ThoMint/vdatp/board/assembly/bot_picture.jpg

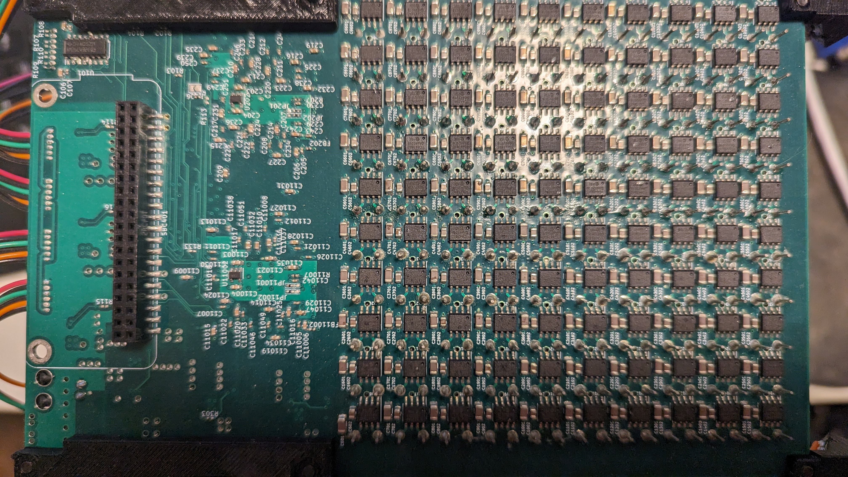
board/assembly/bot_picture.jpg
