ThoMint/vdatp/board/assembly/top_picture.jpg

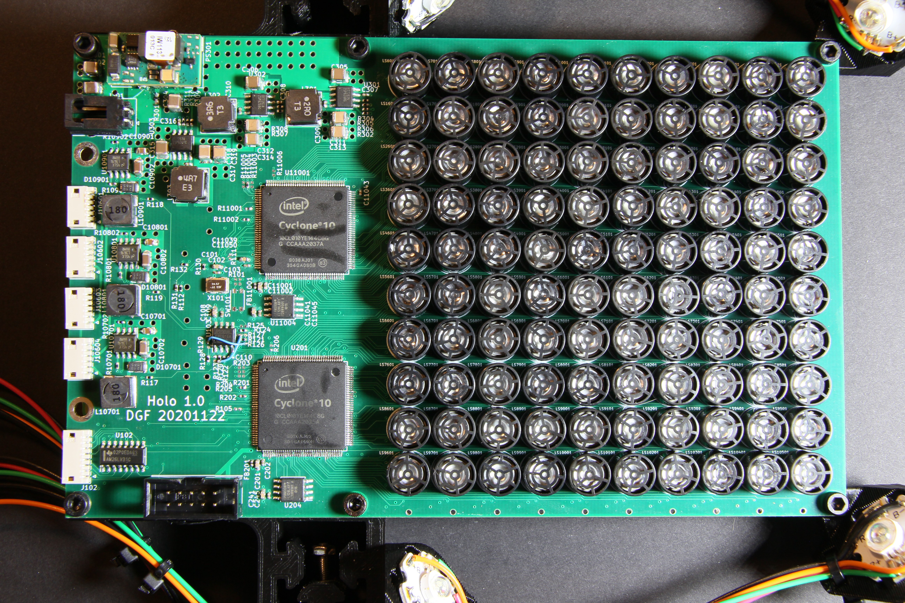
board/assembly/top_picture.jpg
