ThoMint/vdatp/board/vdatp_bom_MTE.xlsx

 |  |  |  | per PCB | Gesamtbestellmenge | Hersteller | Teilenummer | Link | Preis | Preis für 2 Stk | Info
> C101, C104, C106, C201, C203, C204, C206, C209, C210, C213-C216, C219, C220, C223, C224, C227, C228, C231, C232, C235, C236, C239-C241, C247, C11001, C11003, C11004, C11006, C11009, C11010, C11013-C11016, C11019, C11020, C11023, C11024, C11027, C11028, C11031, C11032, C11035, C11036, C11039-C11041, C11047 | 4.7uF | Capacitor_SMD:C_0603_1608Metric |  | 51 | 102 | Samsung | CL10A475KP8NNNC | MTE-ID 5653, Stock 3215 | 0 | 0 | 6.3V type
> C102, C103, C105, C107, C202, C205, C207, C208, C211, C212, C217, C218, C221, C222, C225, C226, C229, C230, C233, C234, C237, C238, C242-C246, C248-C251, C307-C310, C316, C317, C11002, C11005, C11007, C11008, C11011, C11012, C11017, C11018, C11021, C11022, C11025, C11026, C11029, C11030, C11033, C11034, C11037, C11038, C11042-C11046, C11048-C11051 | 0.1uF | Capacitor_SMD:C_0402_1005Metric |  | 64 | 128 |  |  | MTE-ID 6867, Stock 3711 | 0 | 0 | 50V type
> C301, C302 | 10uF,50V | Resistor_SMD:R_1210_3225Metric |  | 2 | 4 |  |  | MTE-ID 6670, Stock 100 | 0 | 0
> C304-C306, C315 | 22uF,35V | Capacitor_SMD:C_1210_3225Metric |  | 10 | 20 |  |  | MTE-ID 5803, Stock 34 | 0 | 0 | downrated to 25V
> C311-C314, C318, C319 | 22uF | Capacitor_SMD:C_1210_3225Metric |  | 6 | 12 |  |  | MTE-ID 2613, Stock 315 | 0 | 0 | downrated to 6V
> C601, C701, C801, C901, C1001, C1101, C1201, C1301, C1401, C1501, C1601, C1701, C1801, C1901, C2001, C2101, C2201, C2301, C2401, C2501, C2601, C2701, C2801, C2901, C3001, C3101, C3201, C3301, C3401, C3501, C3601, C3701, C3801, C3901, C4001, C4101, C4201, C4301, C4401, C4501, C4601, C4701, C4801, C4901, C5001, C5101, C5201, C5301, C5401, C5501, C5601, C5701, C5801, C5901, C6001, C6101, C6201, C6301, C6401, C6501, C6601, C6701, C6801, C6901, C7001, C7101, C7201, C7301, C7401, C7501, C7601, C7701, C7801, C7901, C8001, C8101, C8201, C8301, C8401, C8501, C8601, C8701, C8801, C8901, C9001, C9101, C9201, C9301, C9401, C9501, C9601, C9701, C9801, C9901, C10001, C10101, C10201, C10301, C10401, C10501, C10702, C10802, C10902 | 4.7uF, 35V | Capacitor_SMD:C_1206_3216Metric | 1276-2880-2-ND | 103 | 206 | Samsung Electro Mechanics | CL31A475KAHNNNE | https://www.digikey.at/product-detail/de/samsung-electro-mechanics/CL31A475KAHNNNE/1276-2880-1-ND/3890966 | 0.079 | 16.274 | downrated to 25V
> C602, C702, C802, C902, C1002, C1102, C1202, C1302, C1402, C1502, C1602, C1702, C1802, C1902, C2002, C2102, C2202, C2302, C2402, C2502, C2602, C2702, C2802, C2902, C3002, C3102, C3202, C3302, C3402, C3502, C3602, C3702, C3802, C3902, C4002, C4102, C4202, C4302, C4402, C4502, C4602, C4702, C4802, C4902, C5002, C5102, C5202, C5302, C5402, C5502, C5602, C5702, C5802, C5902, C6002, C6102, C6202, C6302, C6402, C6502, C6602, C6702, C6802, C6902, C7002, C7102, C7202, C7302, C7402, C7502, C7602, C7702, C7802, C7902, C8002, C8102, C8202, C8302, C8402, C8502, C8602, C8702, C8802, C8902, C9002, C9102, C9202, C9302, C9402, C9502, C9602, C9702, C9802, C9902, C10002, C10102, C10202, C10302, C10402, C10502 | 0.1uF, 35V | Capacitor_SMD:C_0805_2012Metric |  | 100 | 200 |  |  | MTE-ID 1118, Stock 1273 | 0 | 0
> C10701, C10801, C10901 | 1uF, 16V | Capacitor_SMD:C_0805_2012Metric |  | 3 | 6 |  |  | MTE-ID 2896, Stock 1000 | 0 | 0
> D10701, D10801, D10901 | 2A, 100V | holo:DO-220A | SS2PH10-M3/84AGICT-ND | 3 | 6 | Vishay | SS2PH10-M3/84A | https://at.farnell.com/vishay/ss2ph10-m3-84a/gleichr-diode-schottky-2a-100v/dp/1812489 | 0.24 | 1.44
> FB201, FB202, FB11001, FB11002 | 300R | Resistor_SMD:R_0402_1005Metric | 535-12548-1-ND | 4 | 8 | Abracon | ACML-0402HC-301-T | https://www.digikey.at/products/de?keywords=535-12548-1-ND | 0.054 | 0.432
J101 | JTAG | Connector_PinHeader_2.54mm:PinHeader_2x05_P2.54mm_Vertical_Shrouded | 732-2094-ND | 1 | 2 | Würth | 61201021621 | https://www.digikey.at/products/de?keywords=732-2094-ND | 0.38 | 0.76
J102 | Comms | Connector_Hirose:Hirose_DF13-08P-1.25DS_1x08_P1.25mm_Horizontal | H2205-ND | 1 | 2 | Hirose | DF13-8P-1.25DS(20) | https://www.digikey.at/products/de?keywords=H2205-ND | 0.68 | 1.36 | kann das sein, dass das einfach JST sind?
J301 | Power | Connector_Molex:Molex_70555_RA_1x02_P2.54 | WM14786 | 1 | 2 | Molex | 705550071 | https://www.digikey.at/products/de?keywords=WM14786 | 0.89 | 1.78
> J10601-J10604 | Screw_Terminal_01x06 | Connector_Hirose:Hirose_DF13-06P-1.25DS_1x06_P1.25mm_Horizontal | H2203-ND | 4 | 8 | Hirose | DF13-6P-1.25DS(20) | https://www.digikey.at/product-detail/de/hirose-electric-co-ltd/DF13-6P-1-25DS-20/H2203-ND/241776 | 0.542 | 4.336
L301 | 2.0uH | holo:NR8040 | 587-1997-1-ND | 1 | 2 | Tayo Yuden | NRS8040T2R0NJGJ | https://www.digikey.at/product-detail/de/NRS8040T2R0NJGJ/587-2976-1-ND/2666081 | 0.38 | 0.76 | Alternativtyp
L302 | 3.6uH | holo:NR8040 | 587-1998-1-ND | 1 | 2 | Tayo Yuden | NR8040T3R6N | https://www.digikey.at/products/de?keywords=587-1998-1-ND | 0.46 | 0.92
L303 | 4.7uH | holo:NR8040 | 587-1999-1-ND | 1 | 2 | Tayo Yuden | NR8040T4R7N | https://www.digikey.at/products/de?keywords=587-1999-1-ND | 0.46 | 0.92
> L10701, L10801 | 11.5uH | holo:SRR6038 | SRR6038-120YCT-ND | 2 | 4 | Bourns | SRR6038-120Y | https://www.digikey.at/products/de?keywords=SRR6038-120YCT-ND | 0.72 | 2.88
L10901 | 18uH | holo:SRR6038 | SRR6038-180YCT-ND | 1 | 2 | Bourns | SRR6038-180Y | https://www.digikey.at/products/de?keywords=SRR6038-180YCT-ND | 0.72 | 1.44
~~> LS601, LS701, LS801, LS901, LS1001, LS1101, LS1201, LS1301, LS1401, LS1501, LS1601, LS1701, LS1801, LS1901, LS2001, LS2101, LS2201, LS2301, LS2401, LS2501, LS2601, LS2701, LS2801, LS2901, LS3001, LS3101, LS3201, LS3301, LS3401, LS3501, LS3601, LS3701, LS3801, LS3901, LS4001, LS4101, LS4201, LS4301, LS4401, LS4501, LS4601, LS4701, LS4801, LS4901, LS5001, LS5101, LS5201, LS5301, LS5401, LS5501, LS5601, LS5701, LS5801, LS5901, LS6001, LS6101, LS6201, LS6301, LS6401, LS6501, LS6601, LS6701, LS6801, LS6901, LS7001, LS7101, LS7201, LS7301, LS7401, LS7501, LS7601, LS7701, LS7801, LS7901, LS8001, LS8101, LS8201, LS8301, LS8401, LS8501, LS8601, LS8701, LS8801, LS8901, LS9001, LS9101, LS9201, LS9301, LS9401, LS9501, LS9601, LS9701, LS9801, LS9901, LS10001, LS10101, LS10201, LS10301, LS10401, LS10501~~ | ~~Speaker_Ultrasound~~ | ~~holo:MSO-P1040H07T~~ |  | ~~100~~ | ~~200~~ | ~~Manorshi~~ | ~~MSO-P1040H07T~~ |  | ~~0.57~~ | ~~114~~ | ~~!!!ALIBABA 286 USD = 236€ for 410pcs!!!~~
PS301 | OKI-T36W-W40 | holo:OKI-T-36W-W40 | 811-3132-1-ND | 1 | 2 | Murata | OKI-T/36W-W40P-C | https://www.digikey.at/products/de?keywords=811-3132-1-ND | 9.1 | 18.2
R101 | 330R | Resistor_SMD:R_0402_1005Metric | 541-3996-1-ND | 1 | 2 |  |  | MTE-Sample Resistors ELAB |  | 0
R103 | 1.0K | Resistor_SMD:R_0402_1005Metric | A127319CT-ND | 1 | 2 |  |  | MTE-Sample Resistors ELAB |  | 0
> R102, R104, R201-R207, R11001-R11007 | 10K | Resistor_SMD:R_0402_1005Metric | RMCF0402JT10K0CT | 16 | 32 |  |  | MTE-Sample Resistors ELAB |  | 0
R105 | 0R | Resistor_SMD:R_0402_1005Metric | ~ | 1 | 2 |  |  | MTE-Sample Resistors ELAB |  | 0
R106 | 0R | Jumper:SolderJumper-2_P1.3mm_Open_TrianglePad1.0x1.5mm | ~ | 1 | 2 |  |  | MTE-Sample Resistors ELAB |  | 0
> R107-R110 | 100R | Resistor_SMD:R_0402_1005Metric | A127223CT-ND | 4 | 8 |  |  | MTE-Sample Resistors ELAB |  | 0
> R208, R11008 | 24R9 | Resistor_SMD:R_0402_1005Metric | 2037-PFR05S-24R9-FNHCT-ND | 2 | 4 | Delta | PFR05S-24R9-FNH | https://www.digikey.at/products/de?keywords=2037-PFR05S-24R9-FNHCT-ND | 0.09 | 0.36
R301 | 52R21 | Resistor_SMD:R_0603_1608Metric | RMCF0603FT26R1CT-ND | 1 | 2 | Stackpole | RMCF0603FT26R1 | https://www.digikey.at/products/de?keywords=RMCF0603FT26R1CT-ND | 0.09 | 0.18
> R302, R303, R309 | 100K | Resistor_SMD:R_0402_1005Metric | RMCS0402JT100KCT-ND | 3 | 6 |  |  | MTE-Sample Resistors ELAB |  | 0
R304 | 47K | Resistor_SMD:R_0402_1005Metric | 541-3966-1-ND | 1 | 2 |  |  | MTE-Sample Resistors ELAB |  | 0
R305 | 5.0K | Resistor_SMD:R_0402_1005Metric | 541-3972-1-ND | 1 | 2 | Vishay | CRCW04024K99FKEDC | https://www.digikey.at/products/de?keywords=541-3972-1-ND | 0.09 | 0.18
R306 | 10.31K | Resistor_SMD:R_0402_1005Metric | RR12P10.2KDCT-ND | 1 | 2 | Susumu | RR1220P-1022-D-M | https://www.digikey.at/products/de?keywords=RR12P10.2KDCT-ND | 0.09 | 0.18
> R307, R310 | 75K | Resistor_SMD:R_0402_1005Metric | 541-5078-1-ND | 2 | 4 |  |  | MTE-Sample Resistors ELAB |  | 0
R308 | 27.6K | Resistor_SMD:R_0402_1005Metric | CR0402-FX-27R4GLFCT-ND | 1 | 2 | Bourns | CR0402-FX-27R4GLF | https://www.digikey.at/products/de?keywords=CR0402-FX-27R4GLFCT-ND | 0.09 | 0.18
R311 | 14.46K | Resistor_SMD:R_0402_1005Metric | YAG2983CT-ND | 1 | 2 | Yageo | RC0402FR-0714K3L | https://www.digikey.at/products/de?keywords=YAG2983CT-ND | 0.09 | 0.18
> R10701, R10801, R10901 | 40K | Resistor_SMD:R_0402_1005Metric | CR0402-FX-4022GLFCT-ND | 3 | 6 | Bourns | CR0402-FX-4022GLF | https://www.digikey.at/products/de?keywords=CR0402-FX-4022GLFCT-ND | 0.09 | 0.54
> R10702, R10802, R10902 | 8.9K | Resistor_SMD:R_0402_1005Metric | RMCF0402FT8K87CT-ND | 3 | 6 | Stackpole | RMCF0402FT8K87 | https://www.digikey.at/products/de?keywords=RMCF0402FT8K87CT-ND | 0.09 | 0.54
SBC401 | Raspberry_Pi_2_3 | Module:Raspberry_Pi_Zero_Socketed_THT_MountingHoles_SMT |  | 0 | 0 |  | RASP PI ZERO W | https://www.reichelt.at/at/de/raspberry-pi-zero-w-v-1-1-1-ghz-512-mb-ram-wlan-bt-rasp-pi-zero-w-p256438.html | 19.77 | 0
SW101 | SW_Push | Button_Switch_SMD:SW_SPST_KMR2 | CKN10246CT-ND | 0 | 0 |  |  |  |  | 0
U101 | AM26LV32CDR | Package_SO:SOIC-16_3.9x9.9mm_P1.27mm | 296-6794-1-ND | 1 | 2 | TI | AM26LV32CDR | https://www.digikey.at/products/de?keywords=296-6794-1-ND | 0.8 | 1.6
U102 | AM26LV31 | Package_SO:SOIC-16_3.9x9.9mm_P1.27mm | 296-25912-1-ND | 1 | 2 | TI | AM26LV31CDR | https://www.digikey.at/products/de?keywords=296-25912-1-ND | 0.87 | 1.74
> U201, U11001 | 10CL010YE144C8G | Package_QFP:EQFP-144-1EP_20x20mm_P0.5mm_EP6.7x6.7mm | 544-3578-ND | 2 | 4 | Intel / Altera | 10CL010YE144C8G | https://www.digikey.at/products/de?keywords=10CL010YE144C8G | 8.08 | 32.32 | alternate: 10CL010YE144I7G, ggf arrow samples?
> U202, U11002 | MIC5504-2.5YM5 | Package_TO_SOT_SMD:SOT-23-5 | 576-4880-1-ND | 2 | 4 | Microchip | MIC5504-2.5YM5-TR | https://www.digikey.at/products/de?keywords=576-4880-1-ND | 0.11 | 0.44
> U203, U11003 | EPCQ16A | Package_SO:SOIC-8_3.9x4.9mm_P1.27mm | 544-3440-ND | 2 | 4 | Intel | EPCQ16ASI8N | https://www.digikey.at/products/de?keywords=EPCQ16ASI8N | 5.79 | 23.16
> U204, U11004 | S25FL128L | Package_SO:SOIC-8_5.275x5.275mm_P1.27mm | 428-4642-1-ND | 2 | 4 | Cypress | S25FL128LAGMFI013 | https://www.digikey.at/products/de?keywords=428-4642-1-ND | 2.56 | 10.24 | MTE-ID 010700 - stock 3
> U301-U303 | RT7263A | holo:SOP-EP-8_3.9x4.9mm_P1.27mm | 1028-1217-1-ND | 3 | 6 | Richtek | RT7263AZSP | https://www.digikey.at/products/de?keywords=1028-1217-1-ND | 0.73 | 4.38
> U601, U701, U801, U901, U1001, U1101, U1201, U1301, U1401, U1501, U1601, U1701, U1801, U1901, U2001, U2101, U2201, U2301, U2401, U2501, U2601, U2701, U2801, U2901, U3001, U3101, U3201, U3301, U3401, U3501, U3601, U3701, U3801, U3901, U4001, U4101, U4201, U4301, U4401, U4501, U4601, U4701, U4801, U4901, U5001, U5101, U5201, U5301, U5401, U5501, U5601, U5701, U5801, U5901, U6001, U6101, U6201, U6301, U6401, U6501, U6601, U6701, U6801, U6901, U7001, U7101, U7201, U7301, U7401, U7501, U7601, U7701, U7801, U7901, U8001, U8101, U8201, U8301, U8401, U8501, U8601, U8701, U8801, U8901, U9001, U9101, U9201, U9301, U9401, U9501, U9601, U9701, U9801, U9901, U10001, U10101, U10201, U10301, U10401, U10501 | TC4428A | Package_SO:SO-8_3.9x4.9mm_P1.27mm | TC4428ACOA-ND | 100 | 200 | Microchip | TC4428ACOA | https://www.digikey.at/product-detail/de/microchip-technology/TC4428ACOA/TC4428ACOA-ND/442842 | 0.74 | 148 | alternate: TC4428AVOA, TC4428AEOA - ALIEXPRESS?
> U10701, U10801, U10901 | LM3414 | Package_SO:SOIC-8-1EP_3.9x4.9mm_P1.27mm_EP2.35x2.35mm | LM3414HVMRX/NOPBCT-ND | 3 | 6 | TI | LM3414HVMRX/NOPB | https://www.digikey.at/products/de?keywords=LM3414HVMRX%2FNOPBCT-ND | 1.76 | 10.56
X101 | ASE-24.576MHz | holo:ASFL1 | ASFL1-24.576MHZ-L-T | 1 | 2 | Abracon | ASFL1-24.576MHZ-L-T | https://www.mouser.at/ProductDetail/ABRACON/ASFL1-24576MHZ-L-T | 1.08 | 2.16
 |  |  |  |  |  |  |  |  |  | 0
Extras für 2 vollständige Geräte (4 PCBs) |  |  |  |  |  |  |  |  |  | 0
 |  | WM2900-ND (power cable housing 2 pos) |  | 4 | 8 | Molex | 50579402 | https://www.digikey.at/product-detail/de/molex/0050579402/WM2900-ND/115029 | 0.29 | 2.32
 |  | WM15222-ND (precrimped power cable female to female 300mm) |  | 4 | 8 | Molex | 797580011 | https://www.digikey.de/product-detail/de/molex/0797580011/WM15222-ND/6187843 | 0.66 | 5.28
 |  | ~~WM2510-ND ~~ |  | ~~0~~ | ~~0~~ | ~~Molex~~ | ~~16020102~~ | ~~https://www.digikey.at/product-detail/de/molex/0016020102/WM2510-ND/115053~~ | 0.14 | 0
 |  | Styrofoam balls |  |  | 1 |  |  | https://www.aliexpress.com/item/33055543688.html?spm=a2g0s.9042311.0.0.14e44c4dgOtgtt | 1.6 | 1.6
 |  | LED Star 10 pcs |  |  | 1 |  | 6-pin with 20mm PCB | https://de.aliexpress.com/item/32823538158.html?spm=a2g0s.9042311.0.0.14e44c4dgOtgtt | 3.93 | 3.93
 |  | DF13 precrimped cables 300mm 10 pcs |  | 4 | 8 | Hirose | H4BBT-10112-B8 | https://www.digikey.at/product-detail/de/hirose-electric-co-ltd/H4BBT-10112-B8/H4BBT-10112-B8-ND/425398 | 0.52 | 4.16
 |  | DF13-8S-1.25C (comms cable housing) |  | 1 | 2 | Hirose | DF13-8S-1.25C | https://www.digikey.at/product-detail/de/hirose-electric-co-ltd/DF13-8S-1-25C/H2185-ND/241755 | 0.23 | 0.46
 |  | DF13-6S-1.25C (LED cable housing) |  | 4 | 4 | Hirose | DF13-6S-1.25C | https://www.digikey.at/products/de?keywords=DF13-6S-1.25C | 0.16 | 0.64
 |  |  |  |  |  |  |  |  |  | 0
 |  |  |  |  |  |  |  |  |  | 0
 |  |  |  |  |  |  |  |  | Total für 2 Stk | 420.832
