ThoMint/vdatp/board/floater-Edge_Cuts_clean.dxf

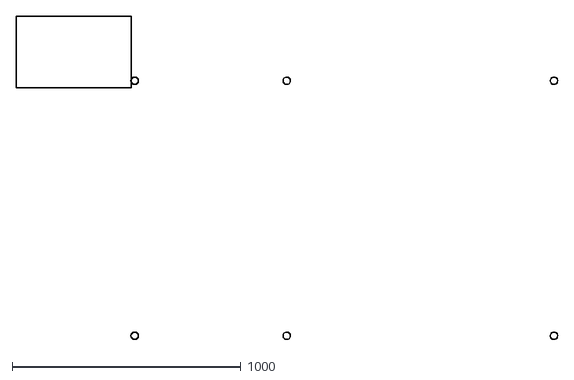
[picture p9: CAD file, 2023-10-27]
board/floater-Edge_Cuts_clean.dxf
2364.8 x 1413.5
