ThoMint/vdatp/board/floater-Edge_Cuts.dxf

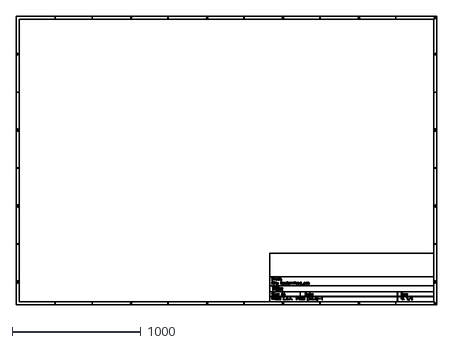
[picture p10: CAD file, 2023-10-27]
board/floater-Edge_Cuts.dxf
3273.3 x 2245.3
