ThoMint/vdatp/board/assembly/bot_fab_assembly.pdf

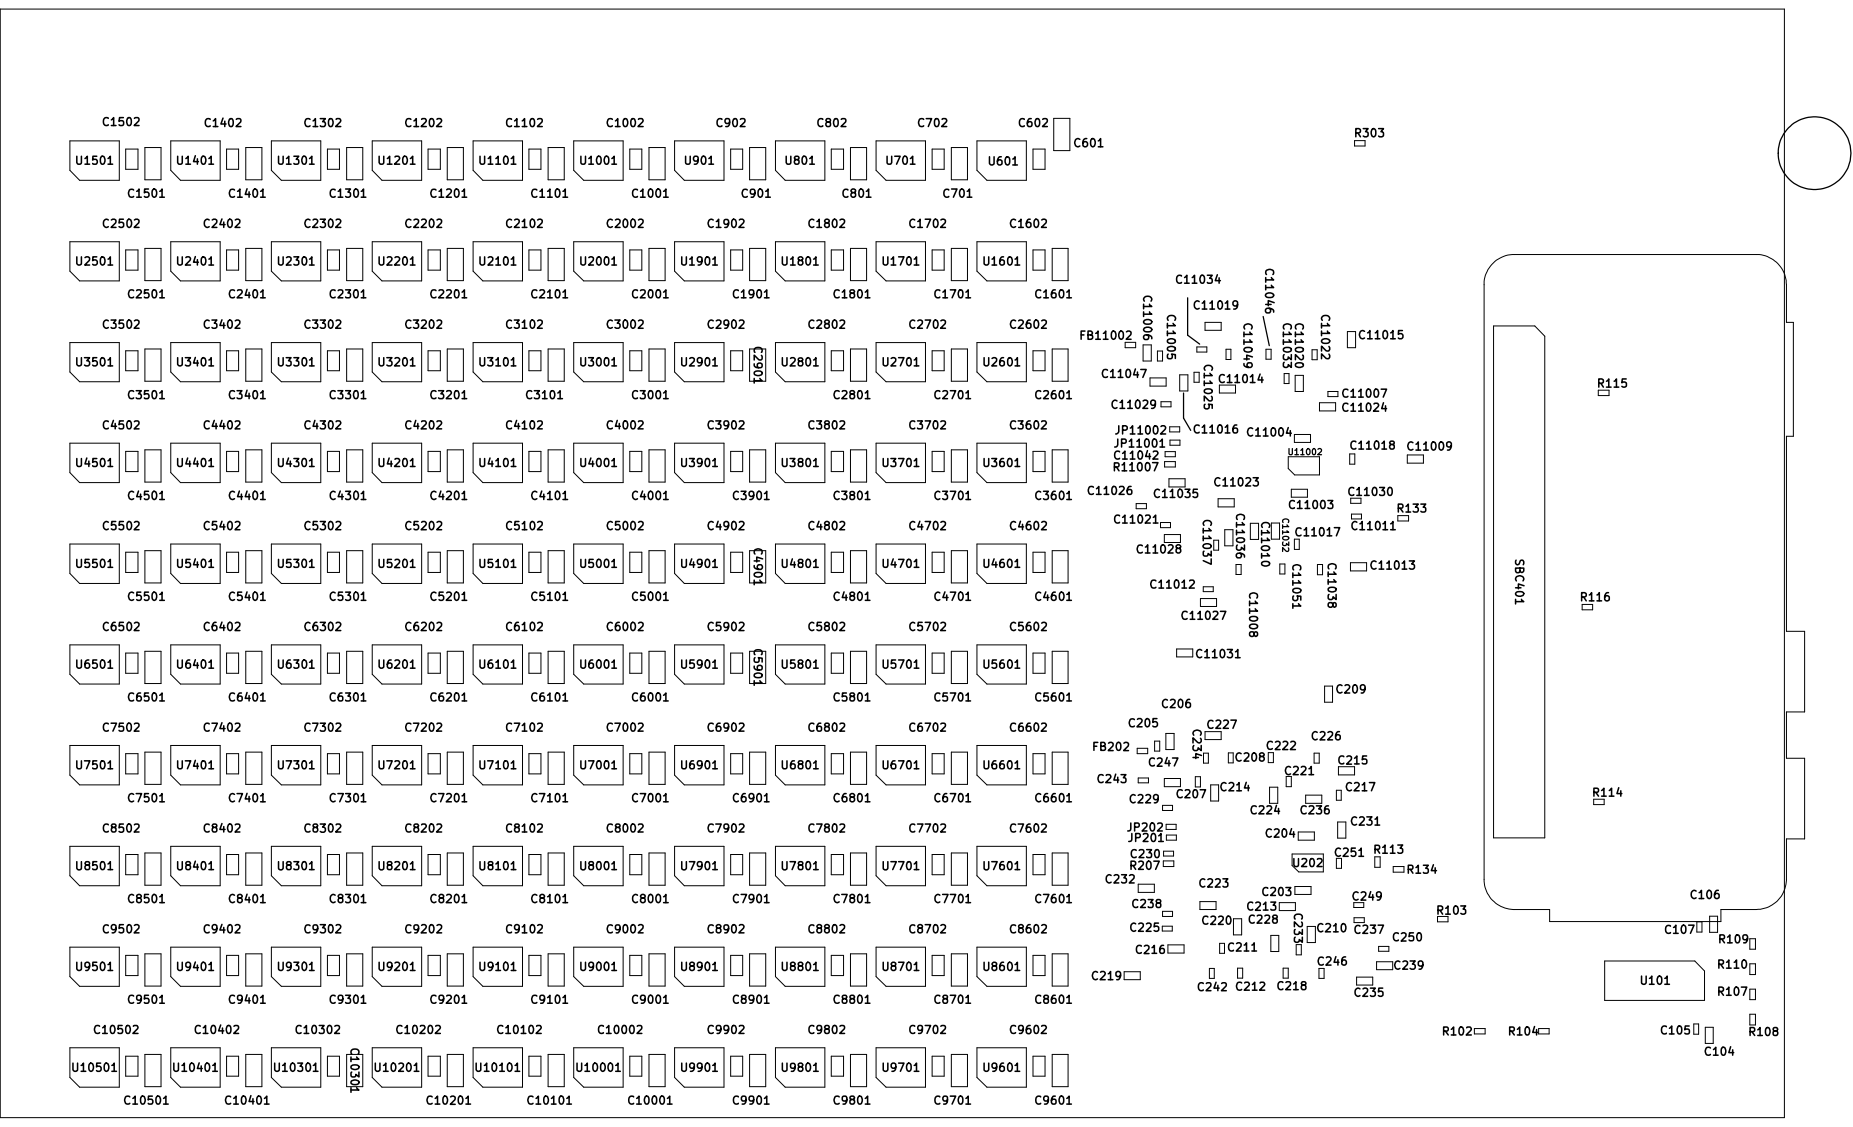
[picture p11: page 1]
