ThoMint/vdatp/board/assembly/bot_fab_assembly2.pdf

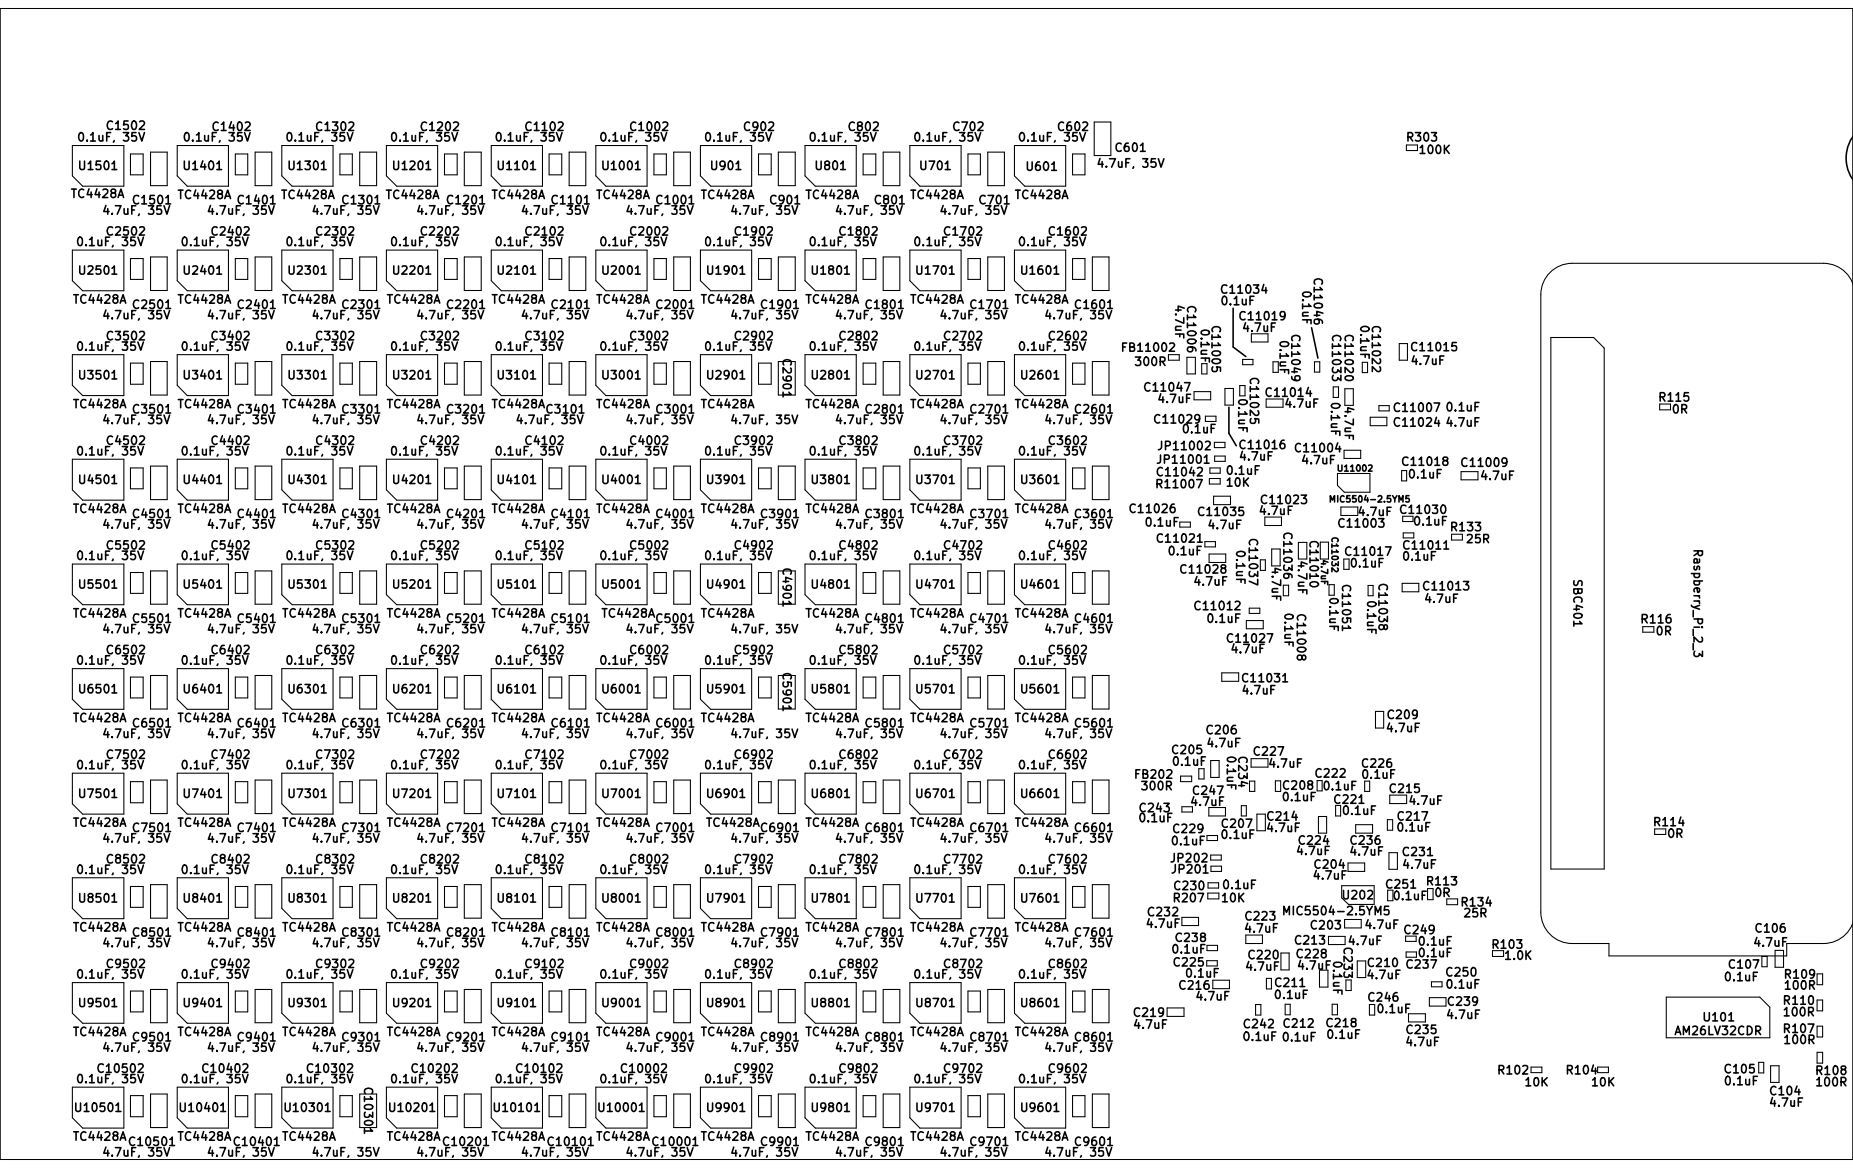
[picture p12: page 1]
