ThoMint/vdatp/board/assembly/bot_silk.pdf

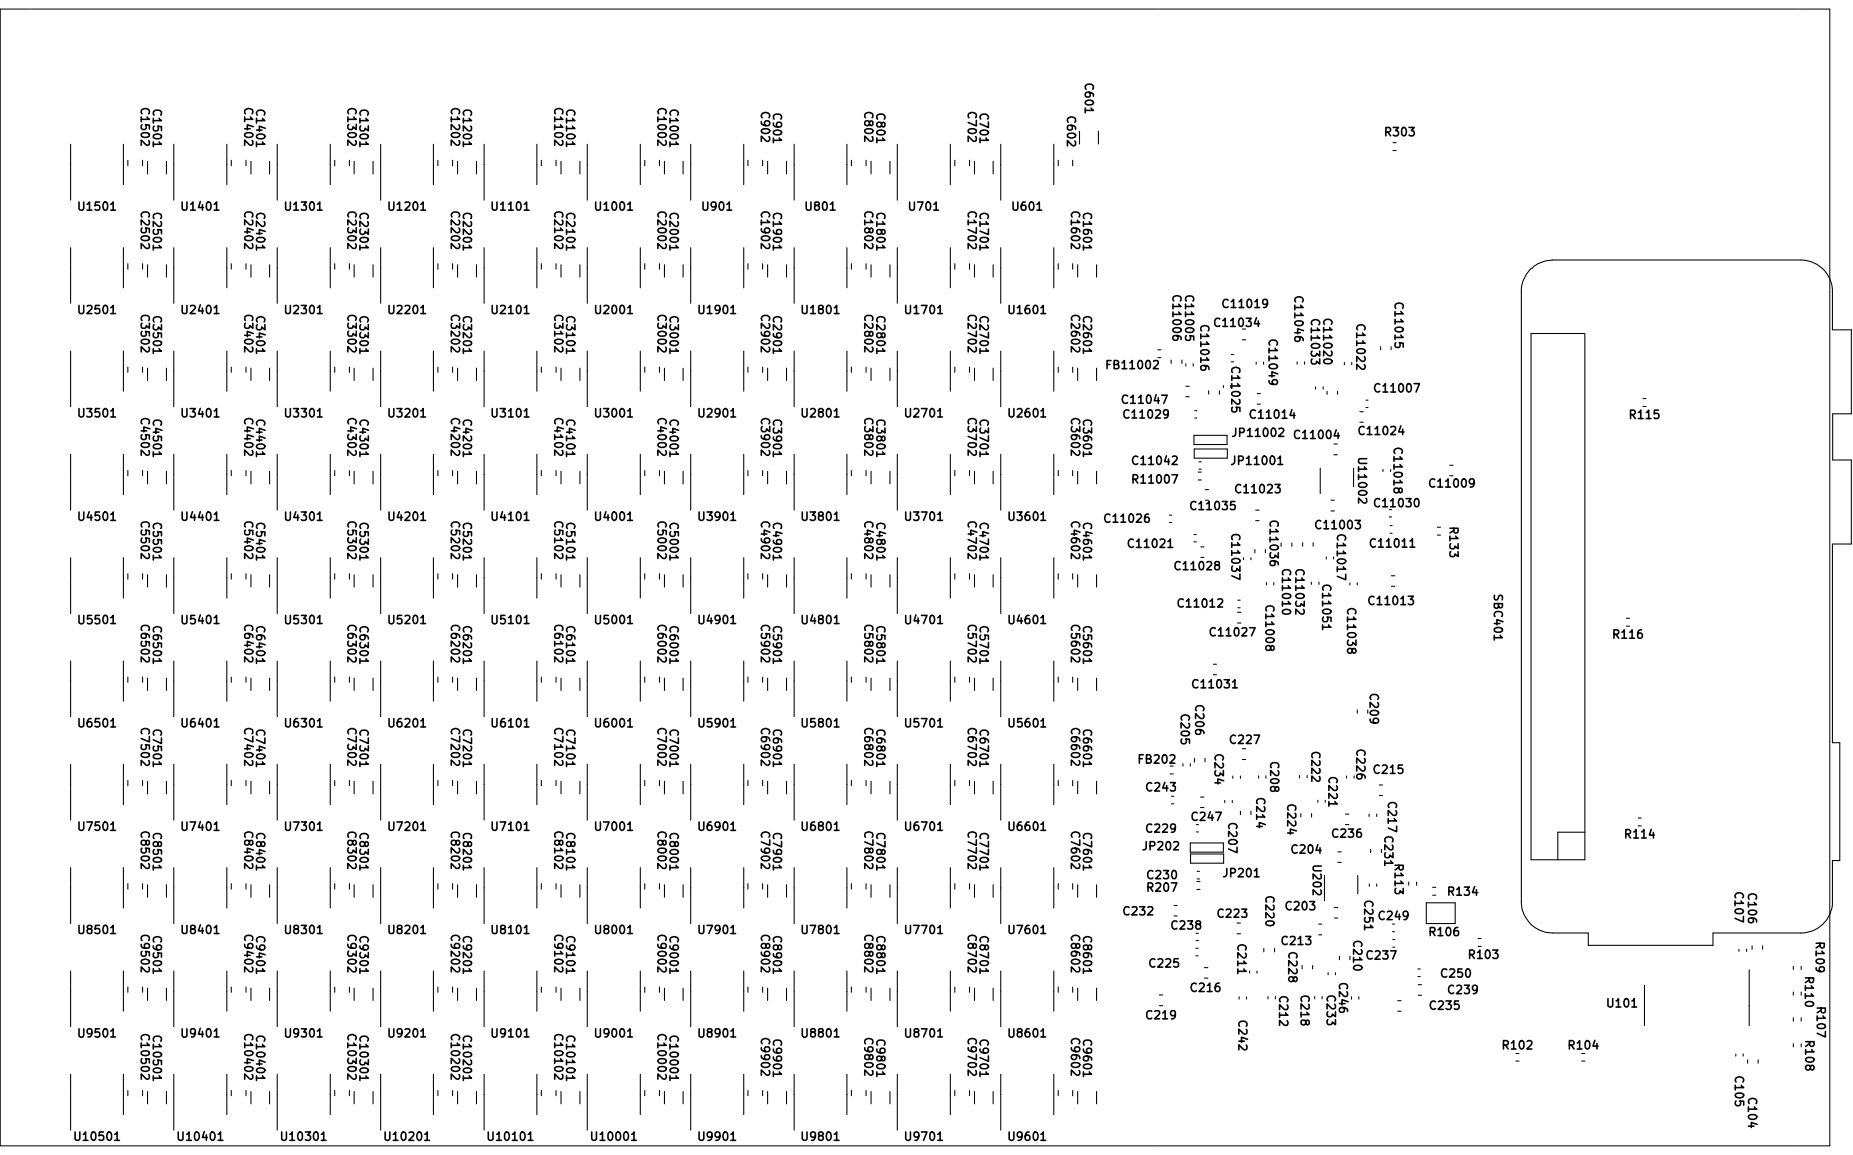
[picture p13: page 1]
