ThoMint/vdatp/board/assembly/schematic_full_color.pdf

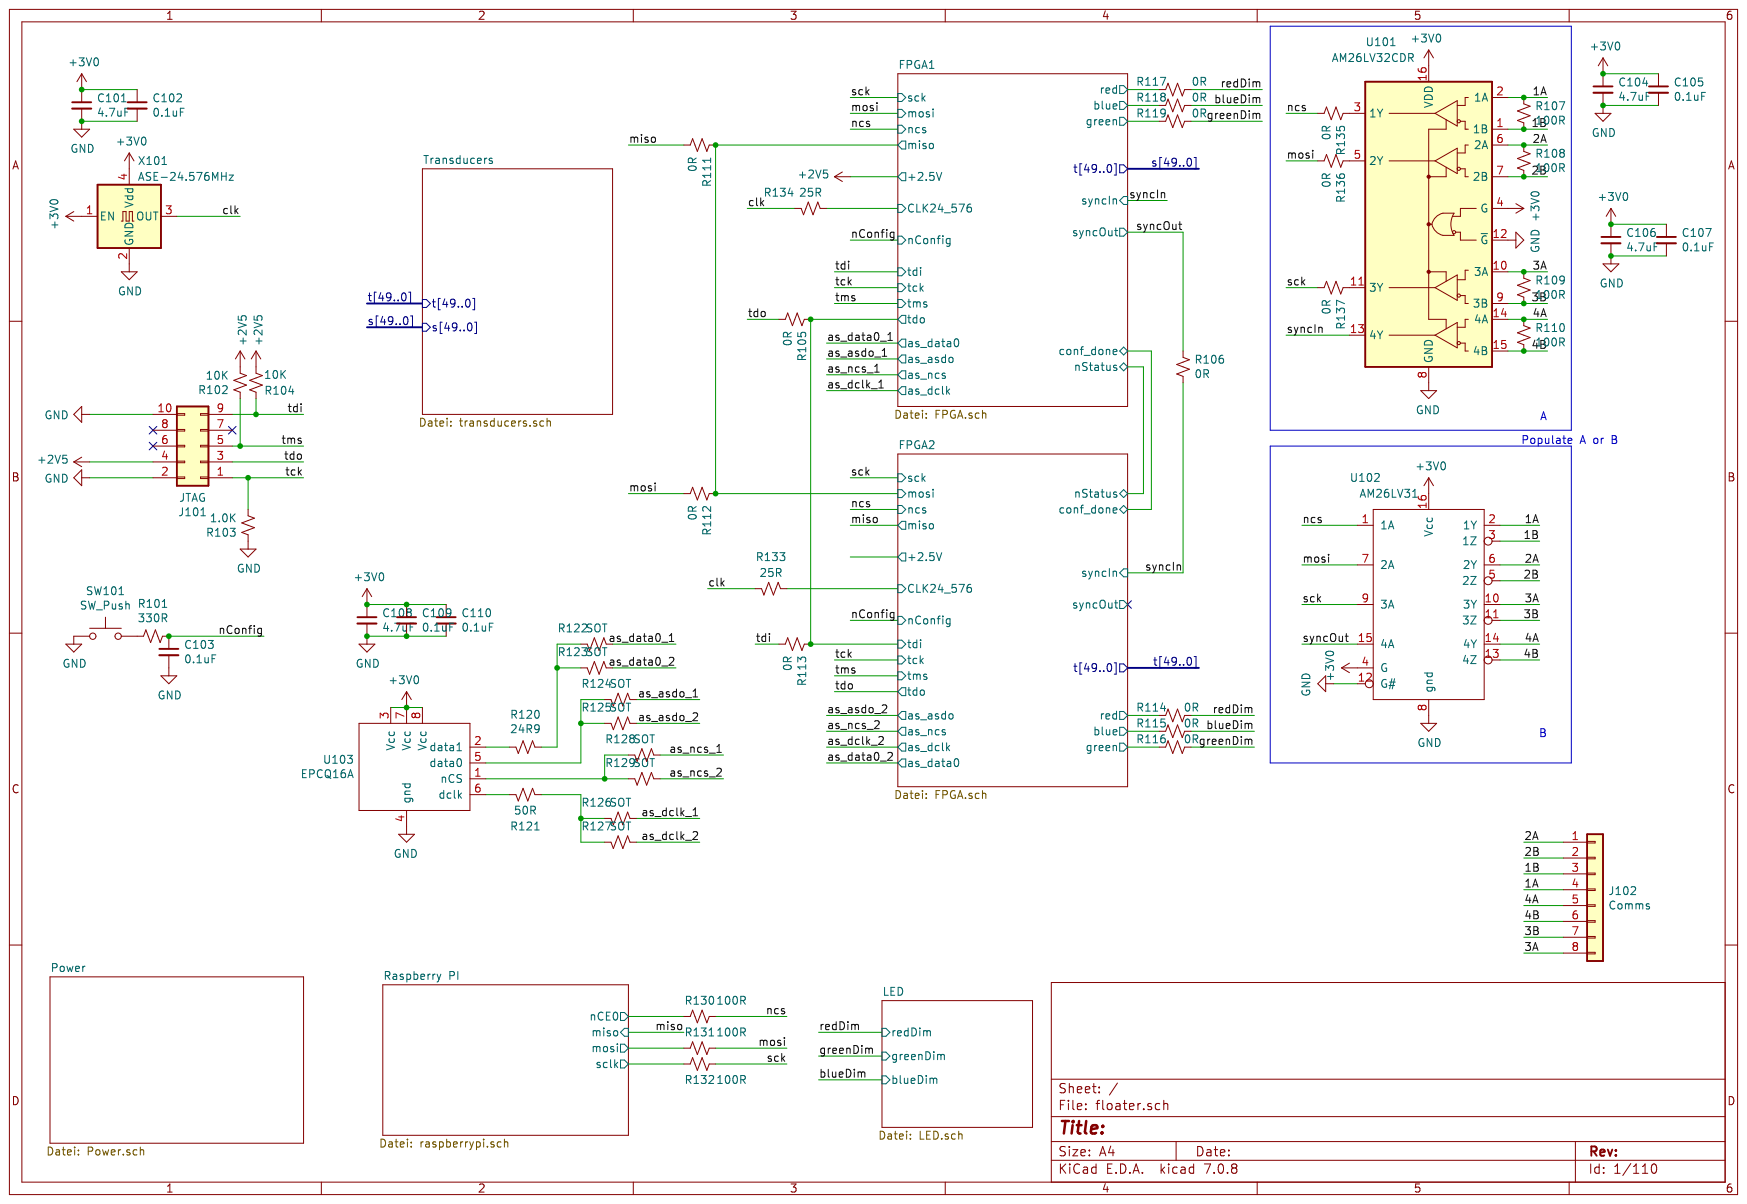
[picture p14: page 1]

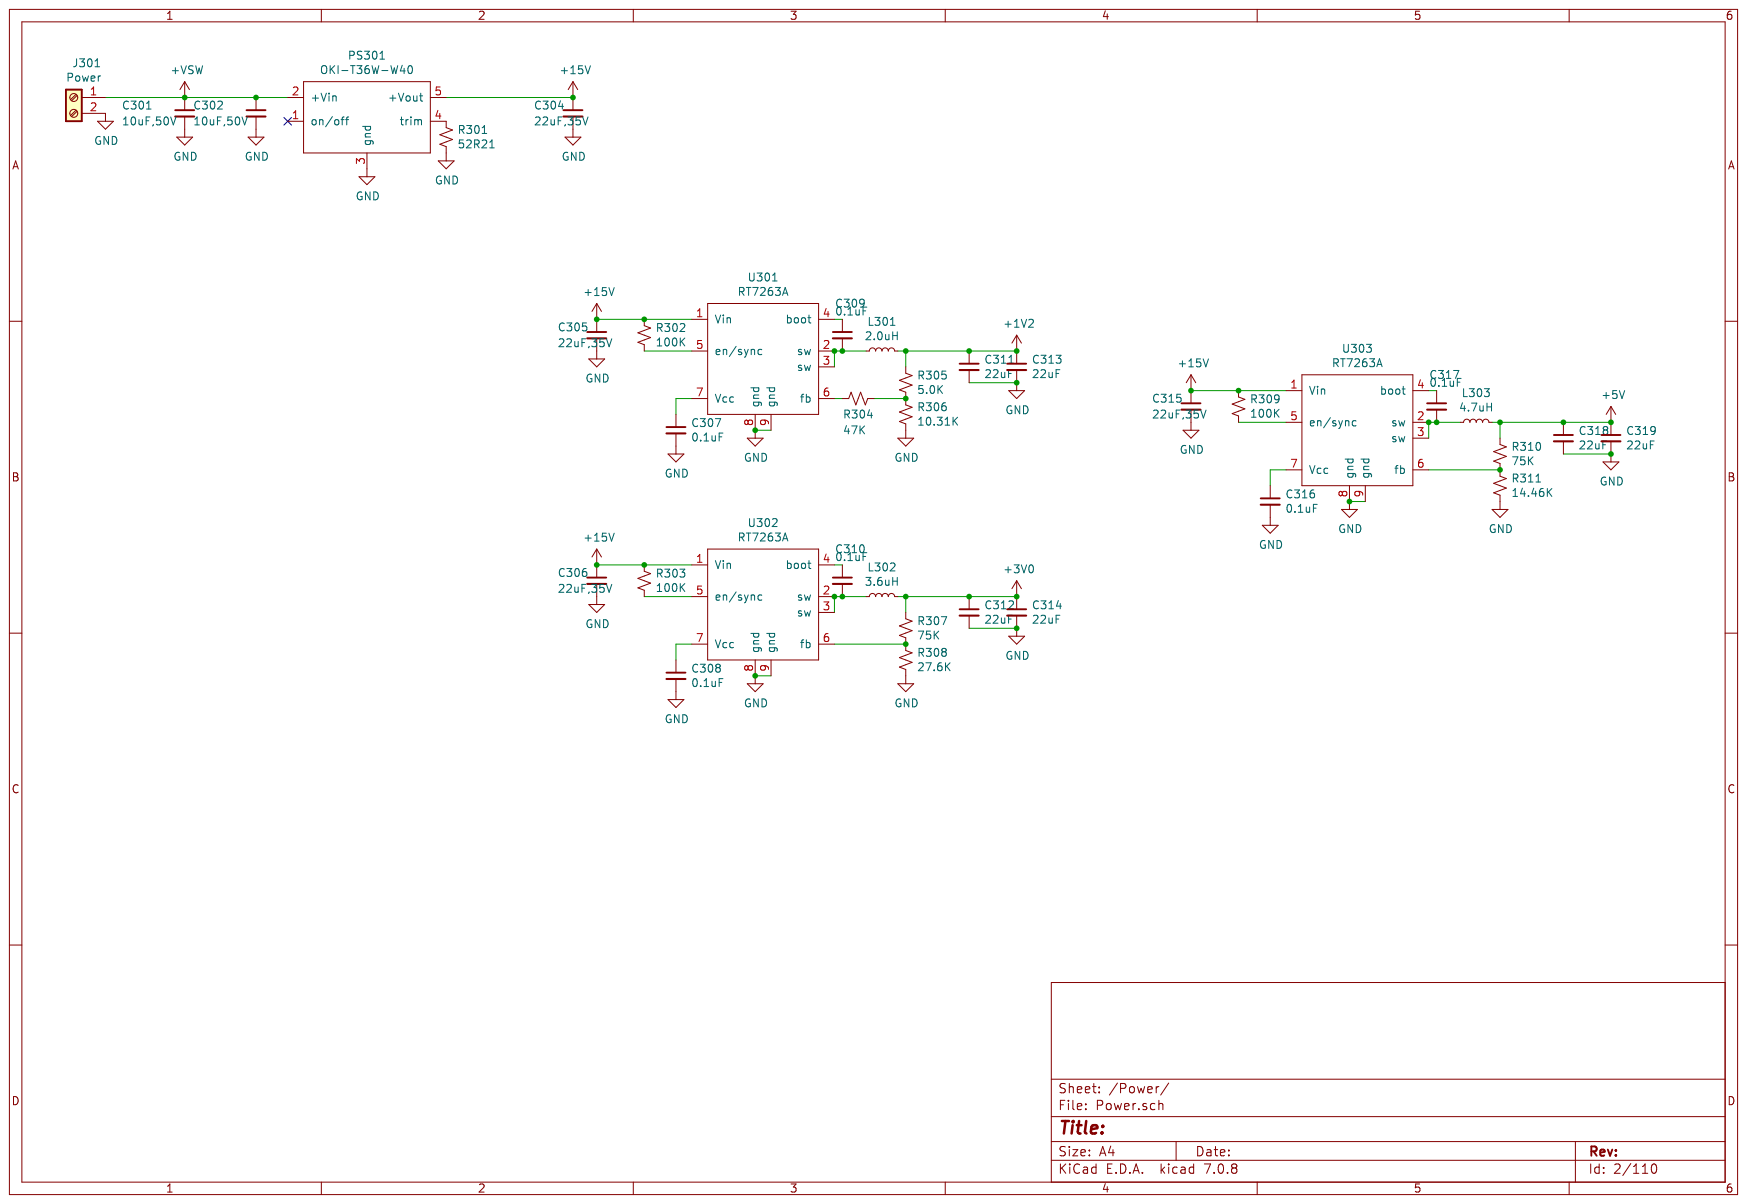
[picture p15: page 2]

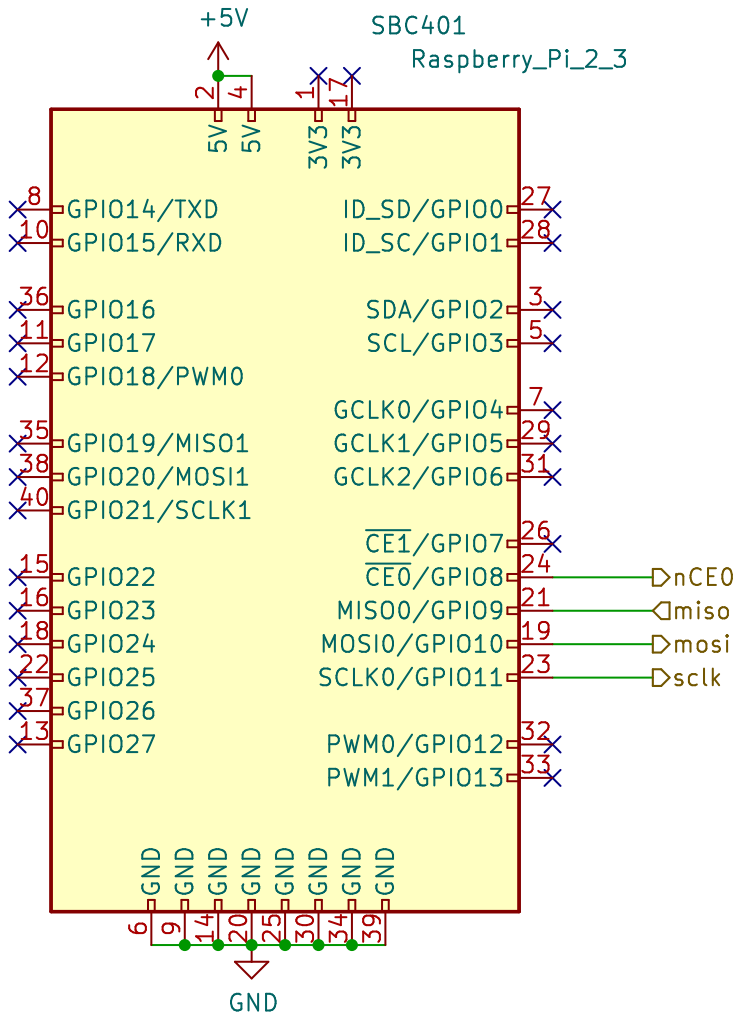
[picture p16: page 3]

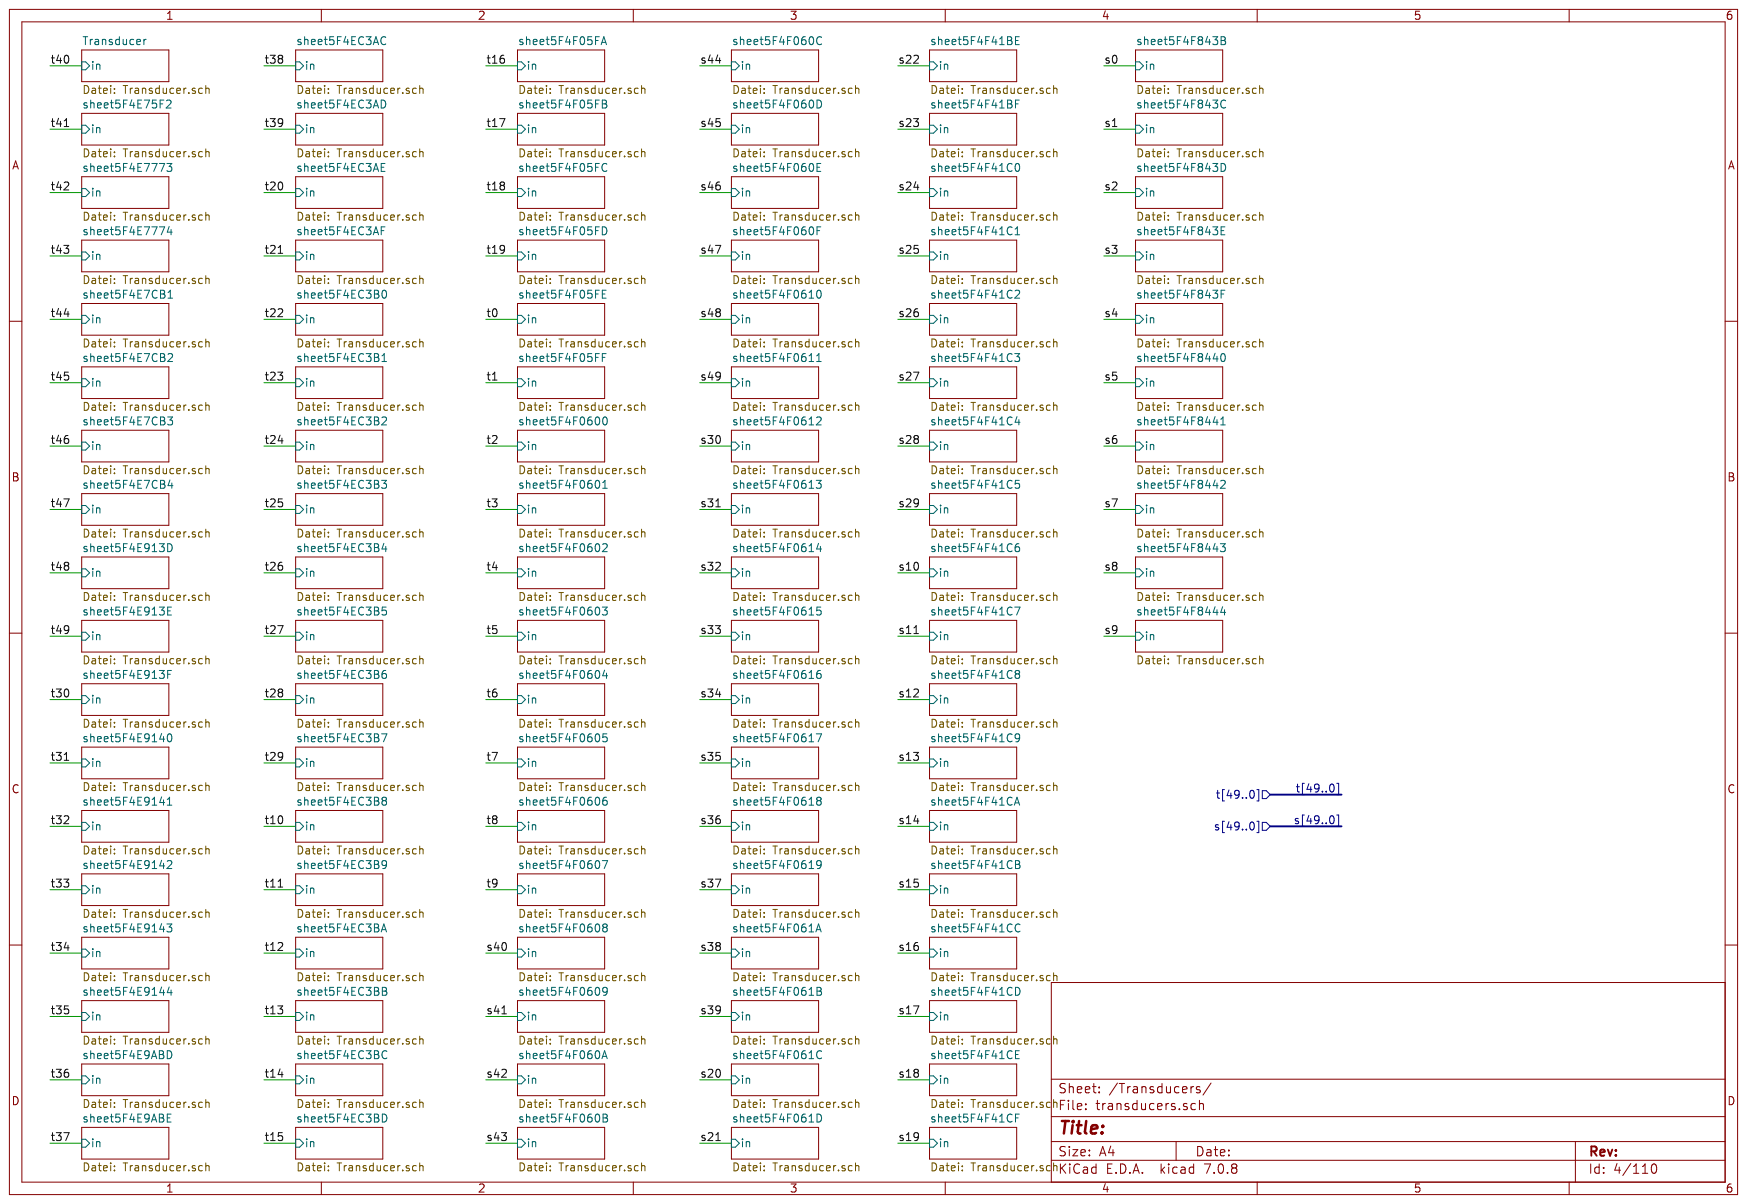
[picture p17: page 4]

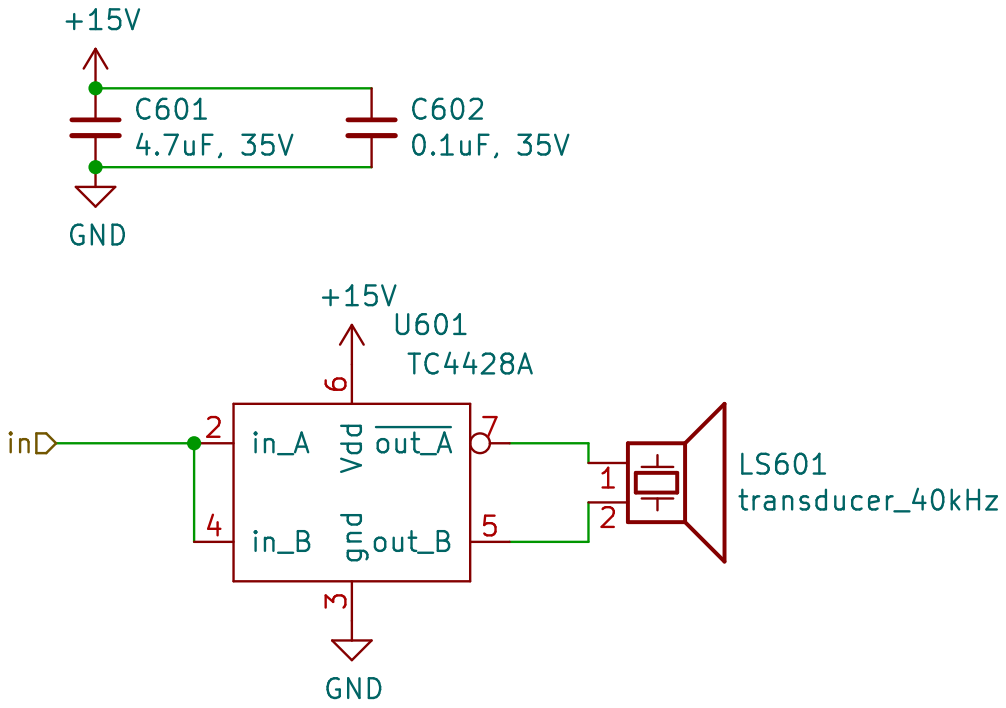
[picture p18: page 5]

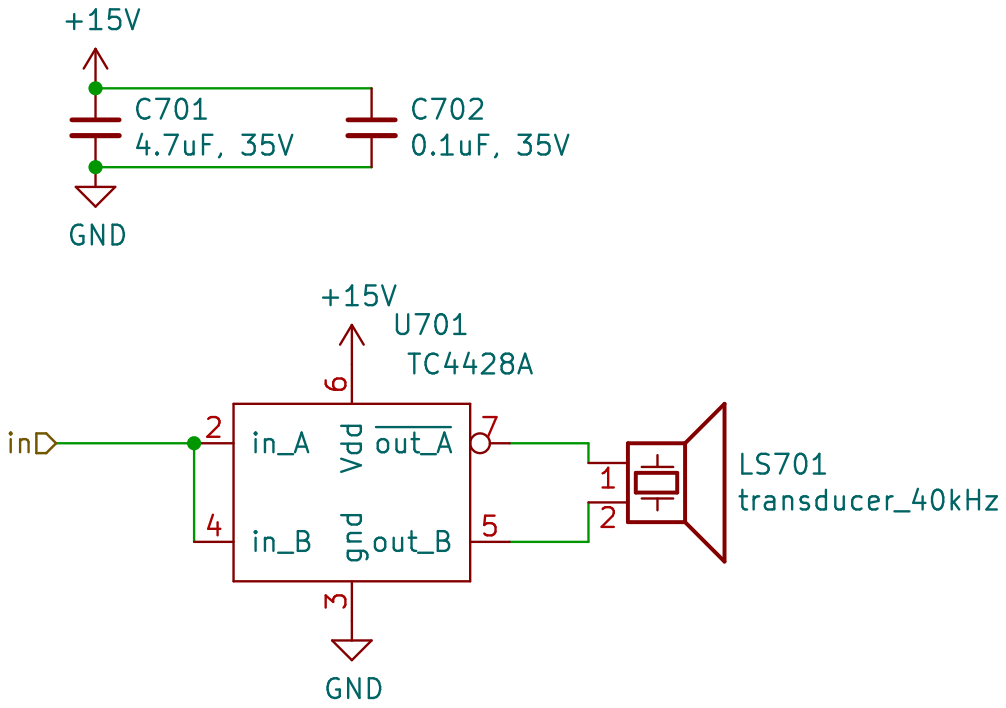
[picture p19: page 6]

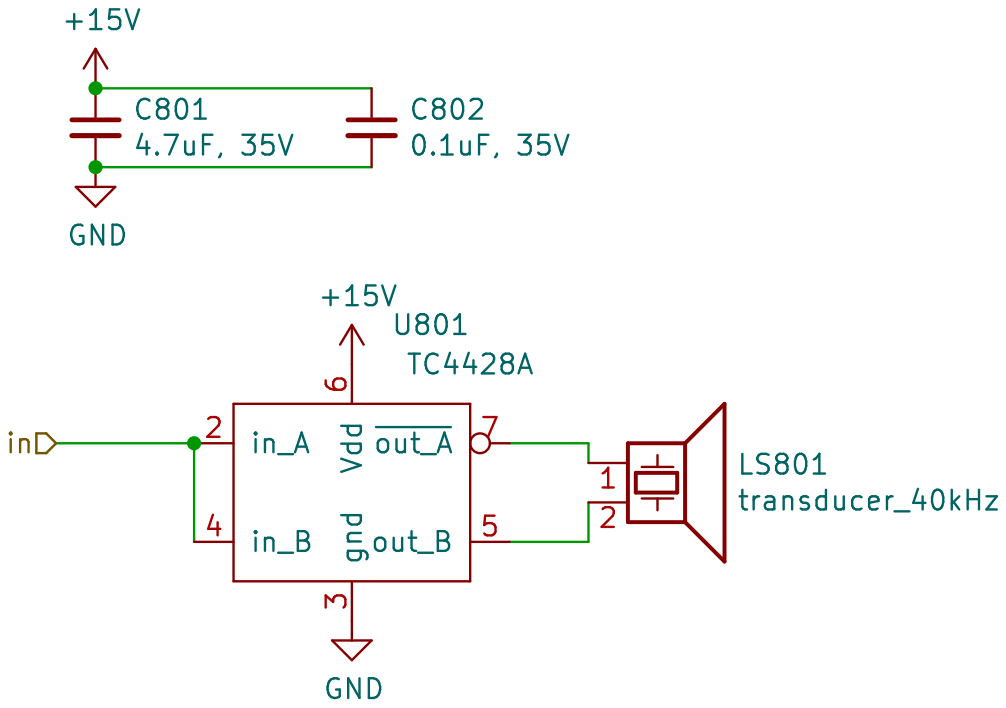
[picture p20: page 7]

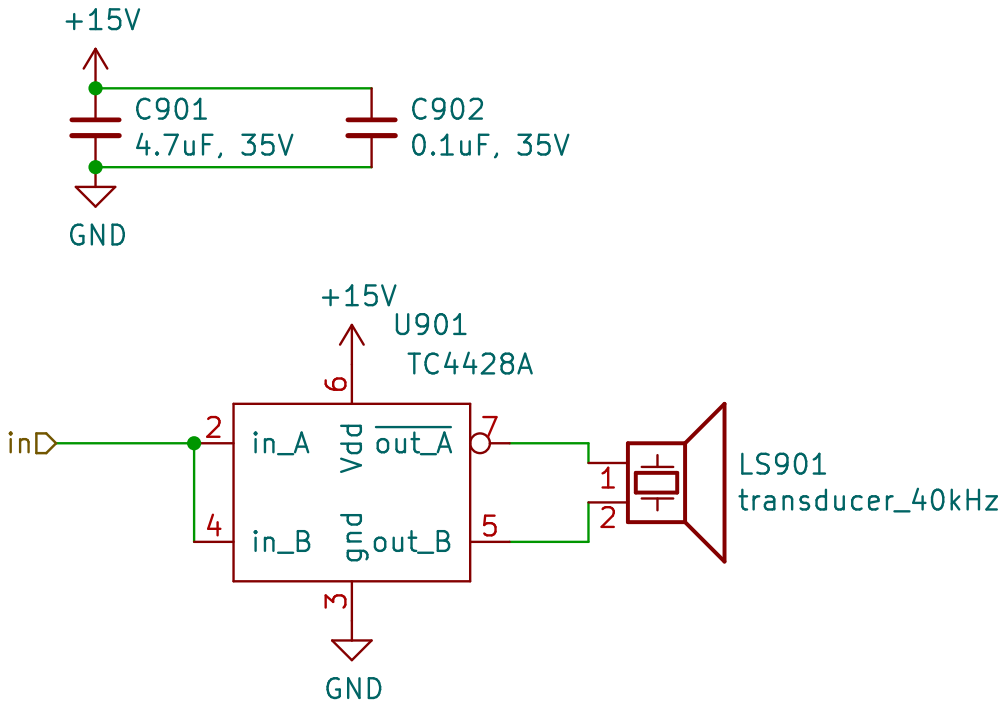
[picture p21: page 8]

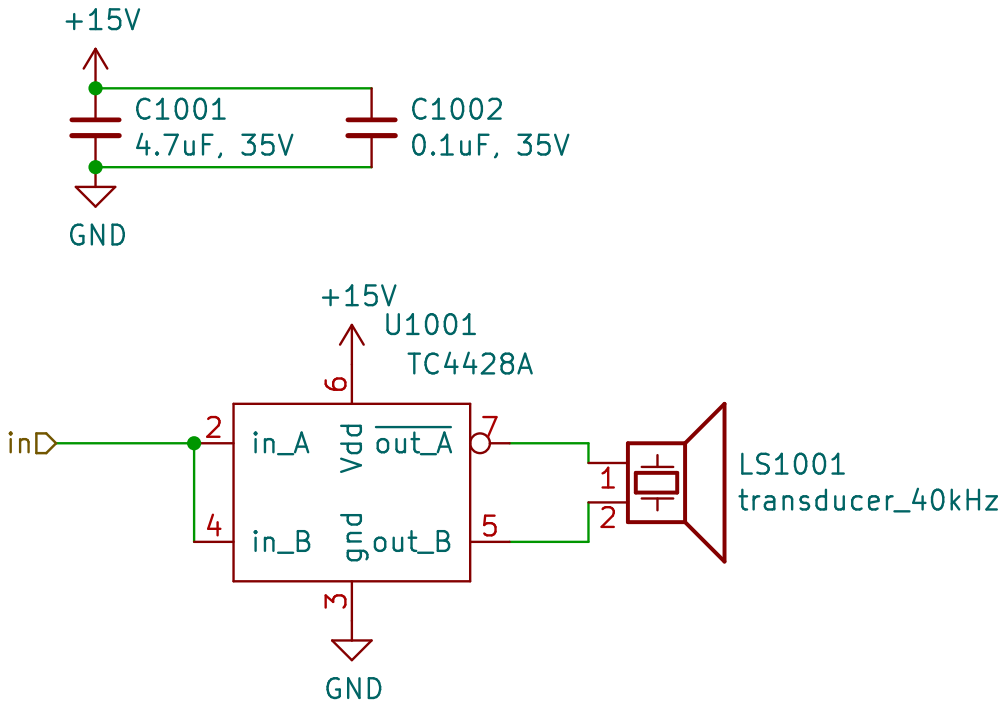
[picture p22: page 9]

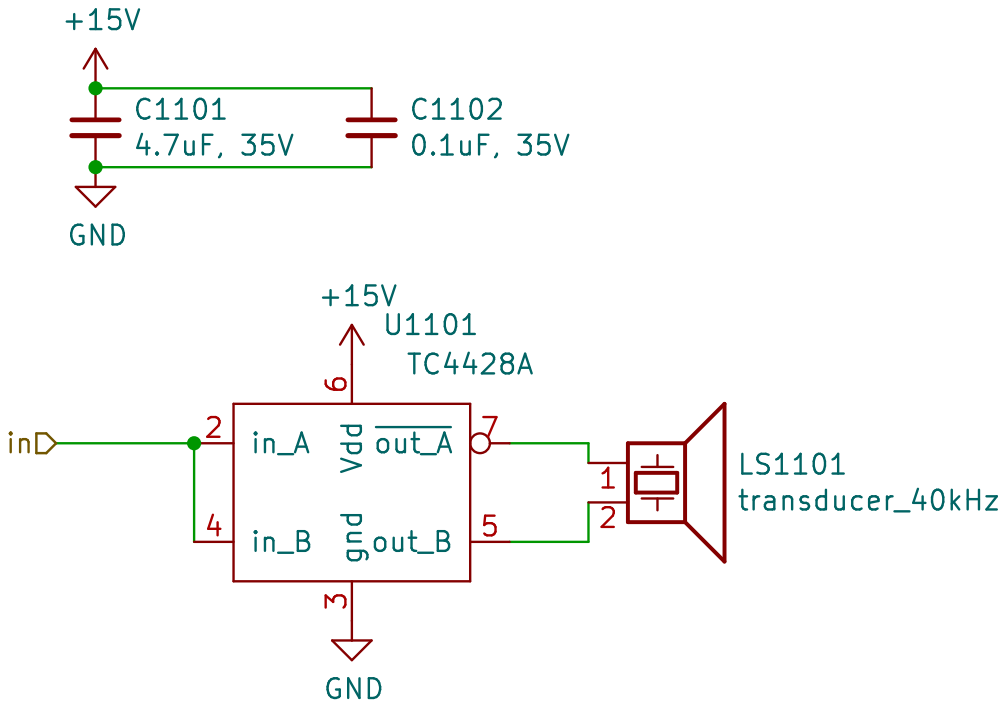
[picture p23: page 10]

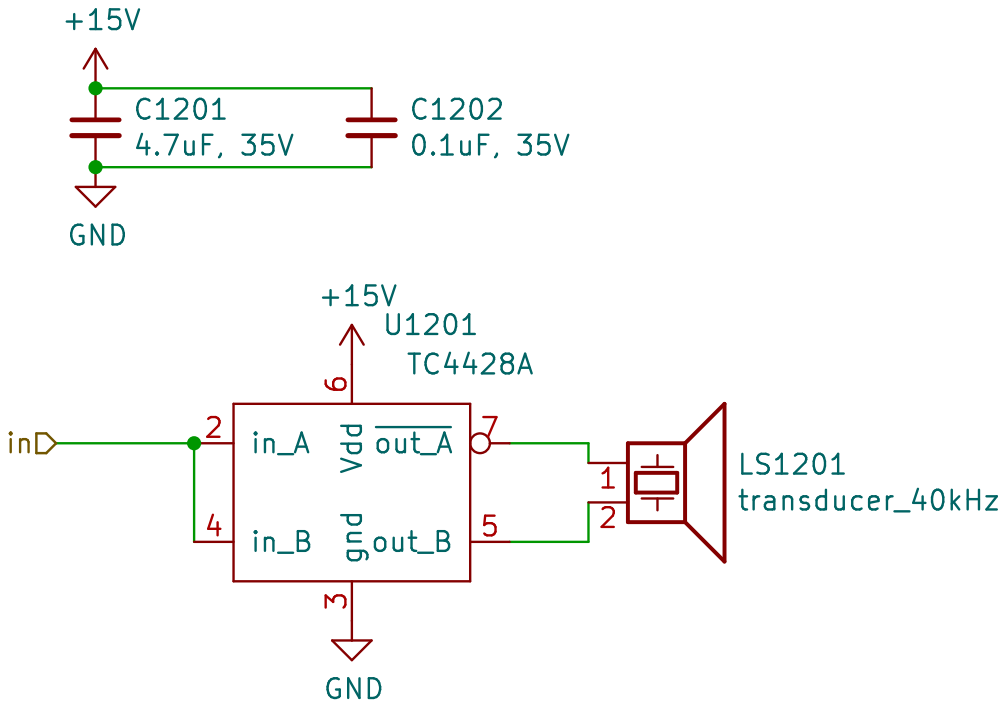
[picture p24: page 11]

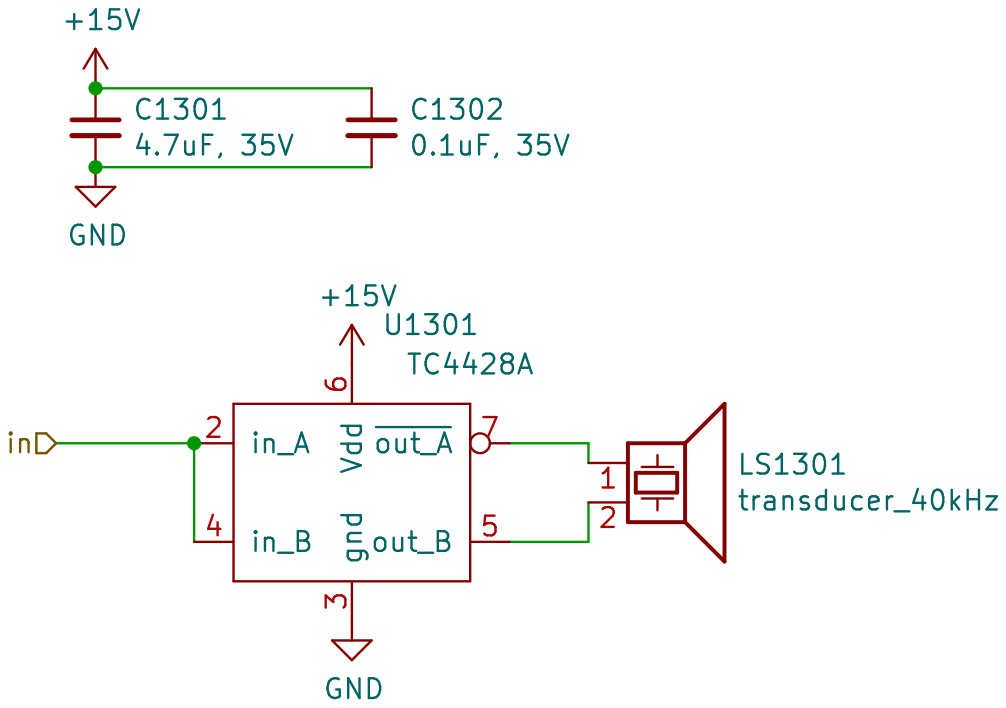
[picture p25: page 12]

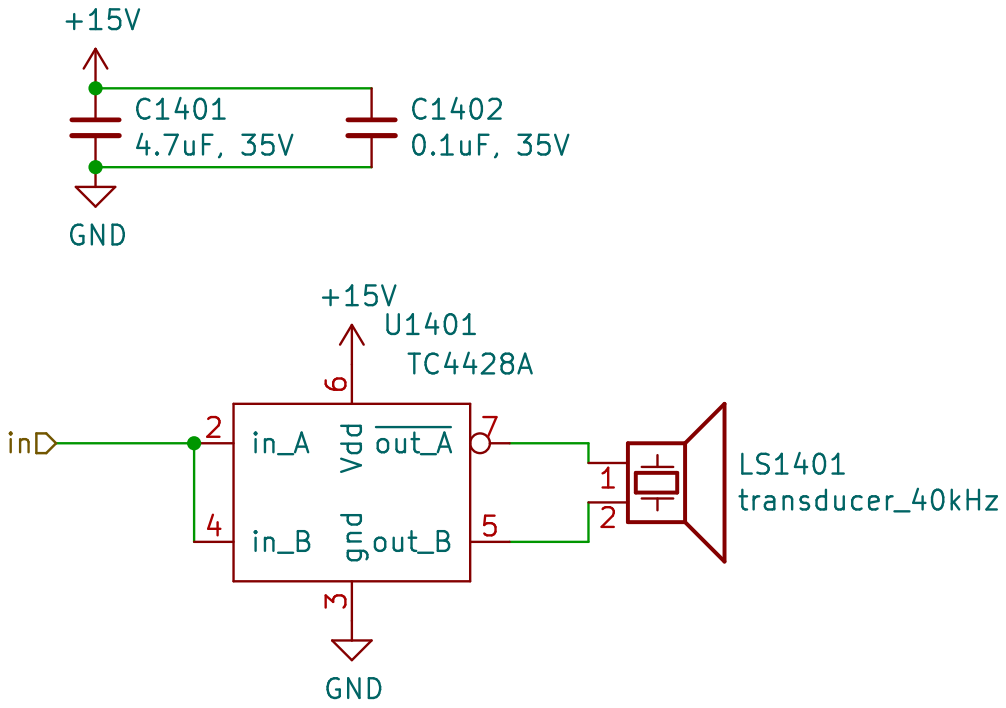
[picture p26: page 13]

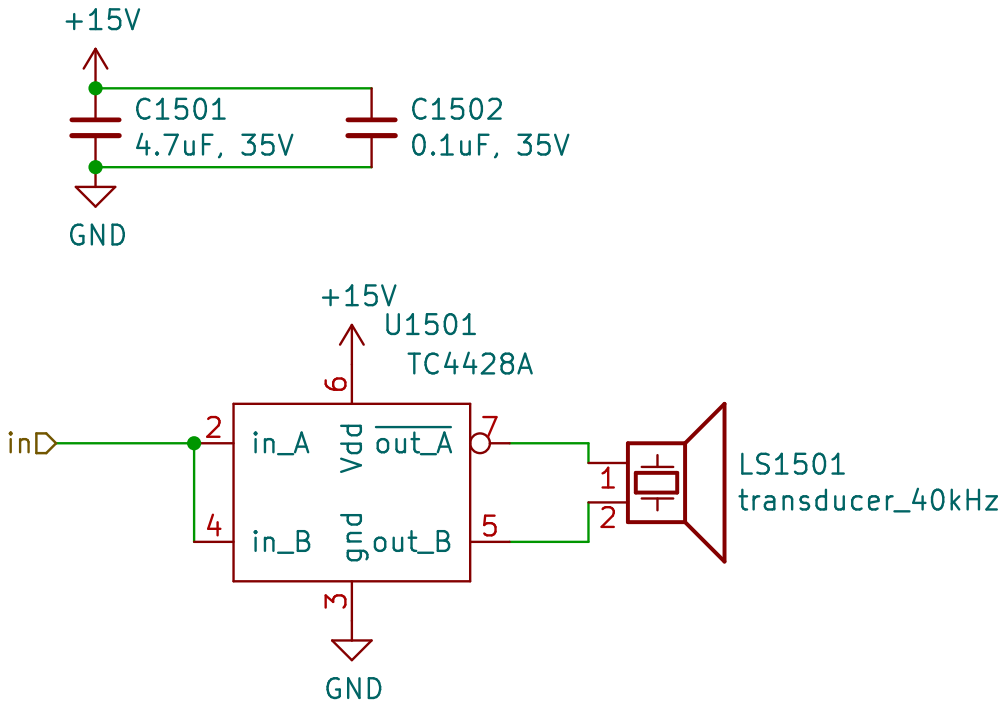
[picture p27: page 14]

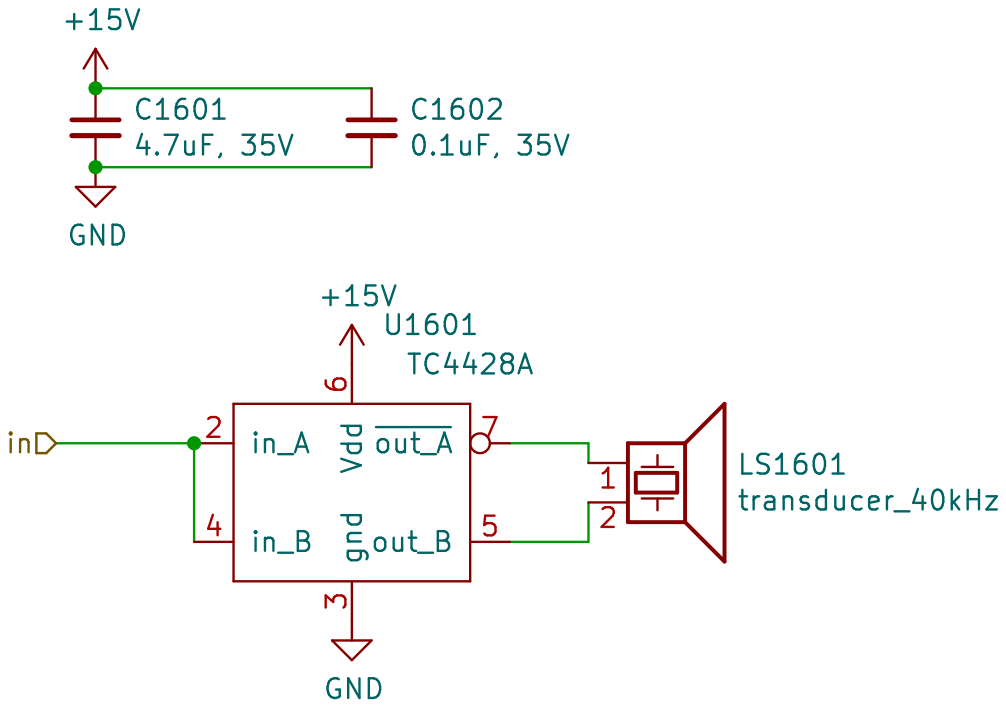
[picture p28: page 15]

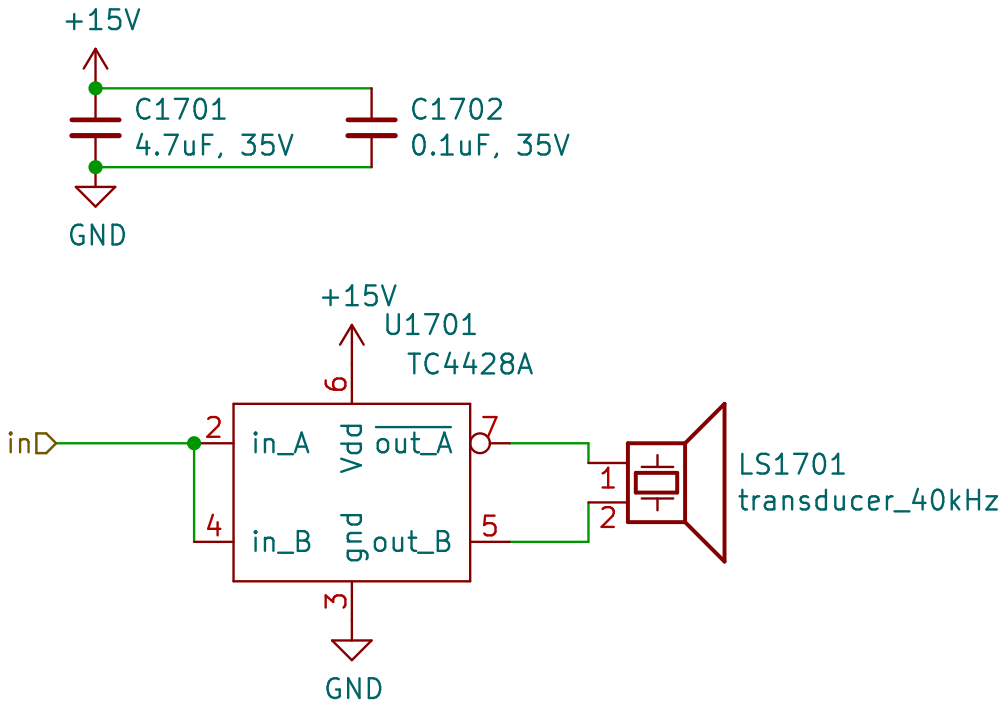
[picture p29: page 16]

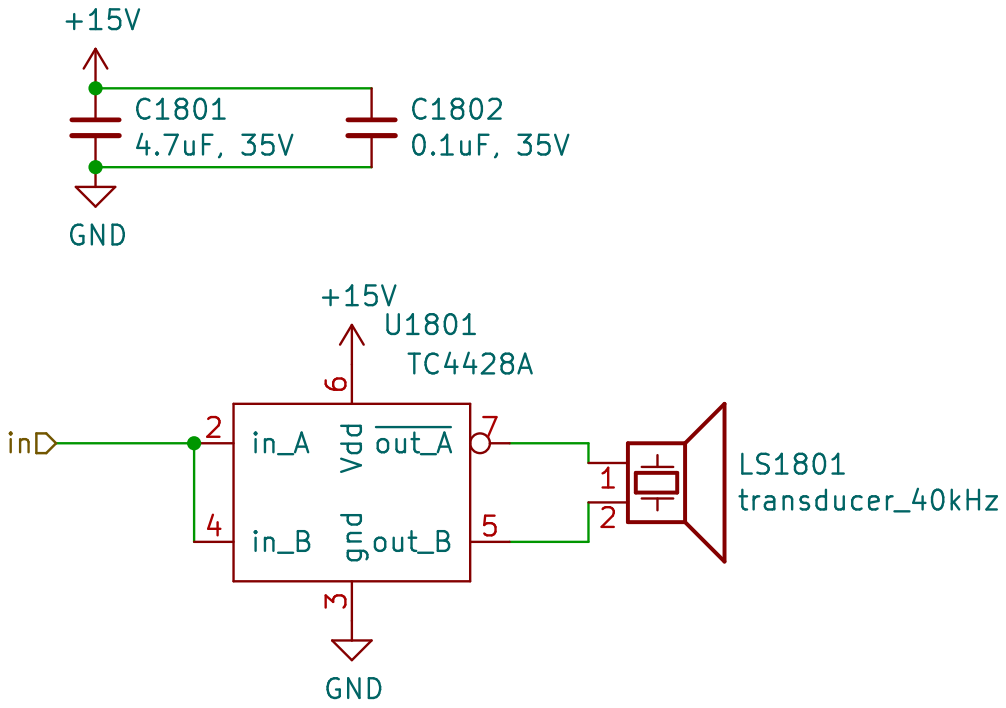
[picture p30: page 17]

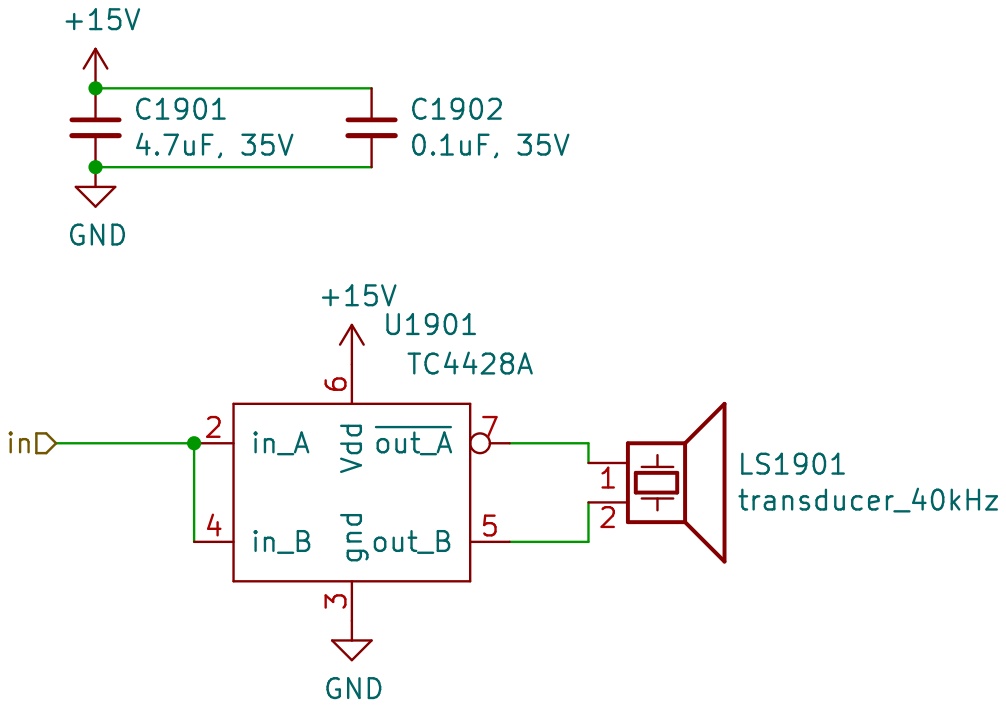
[picture p31: page 18]

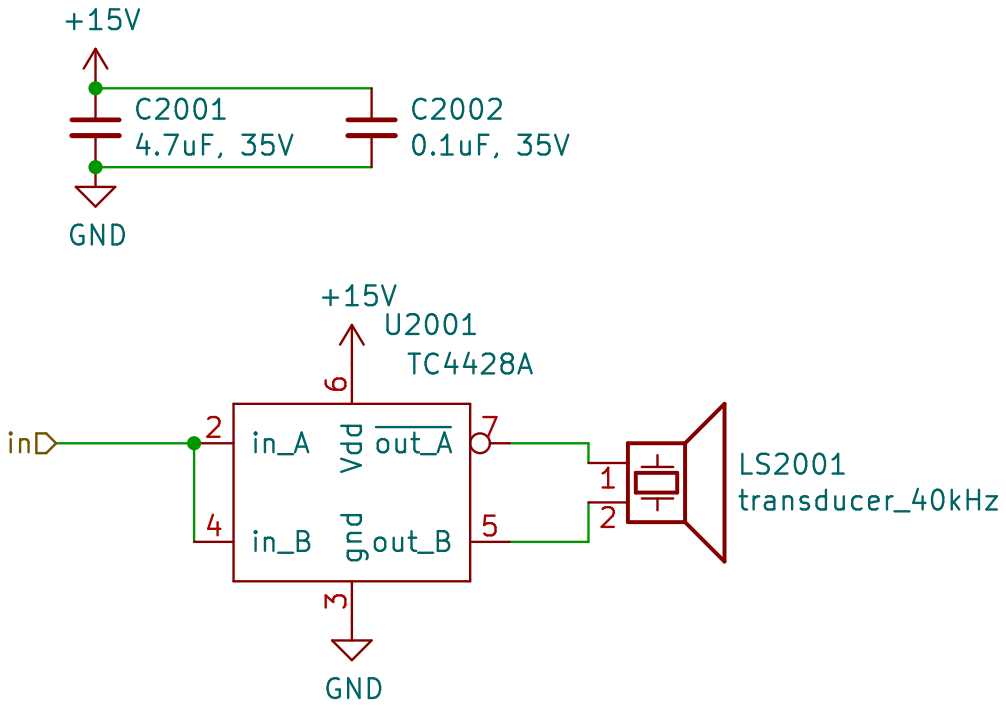
[picture p32: page 19]

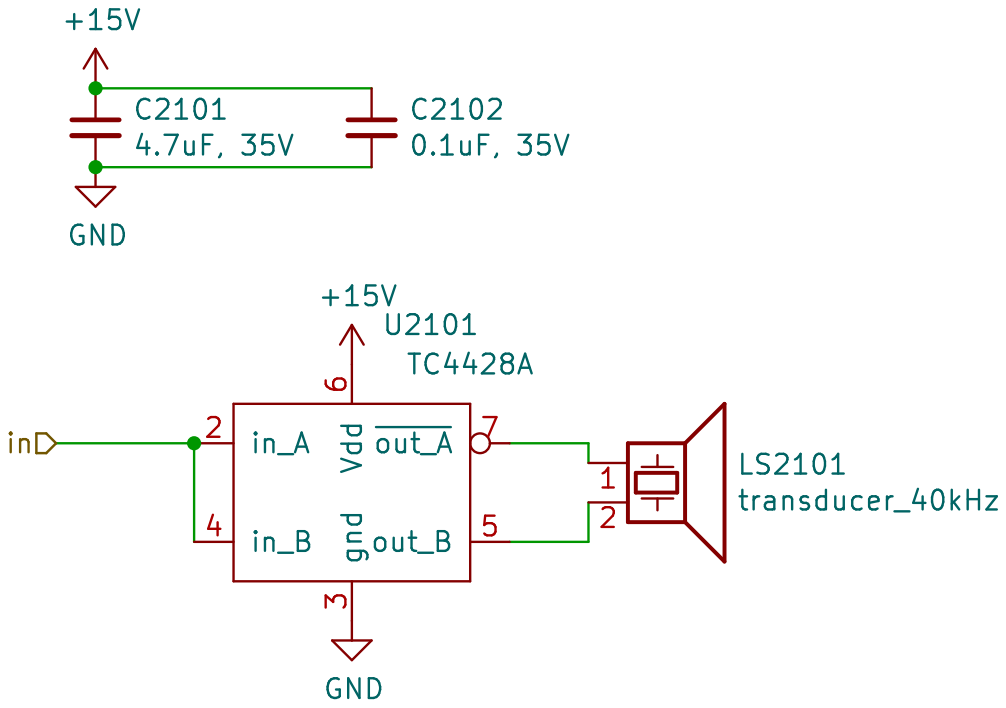
[picture p33: page 20]

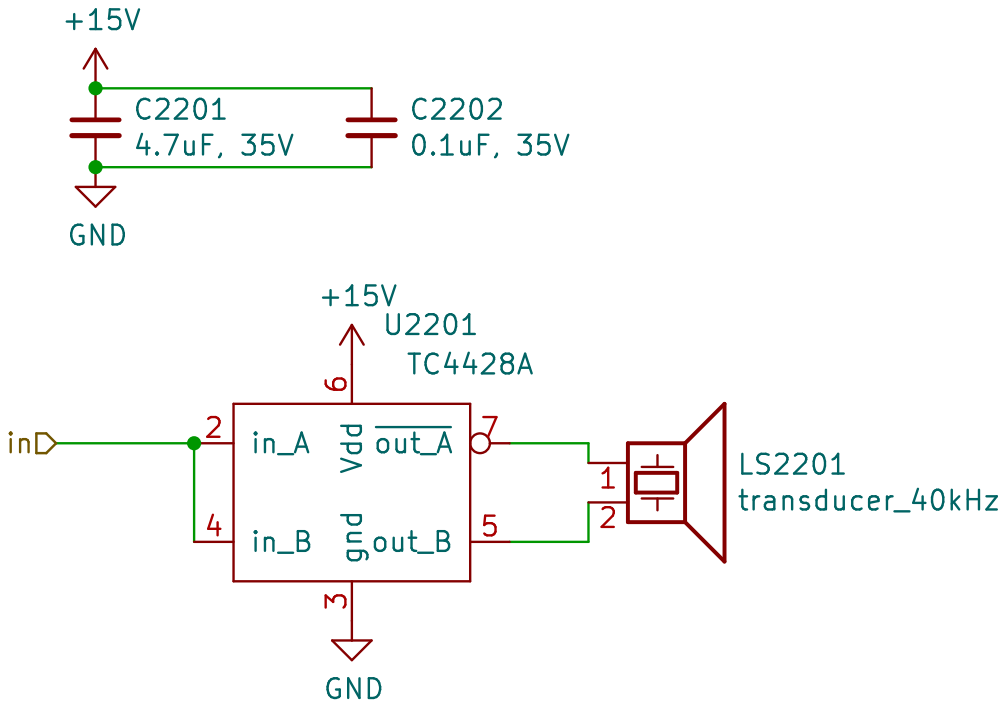
[picture p34: page 21]

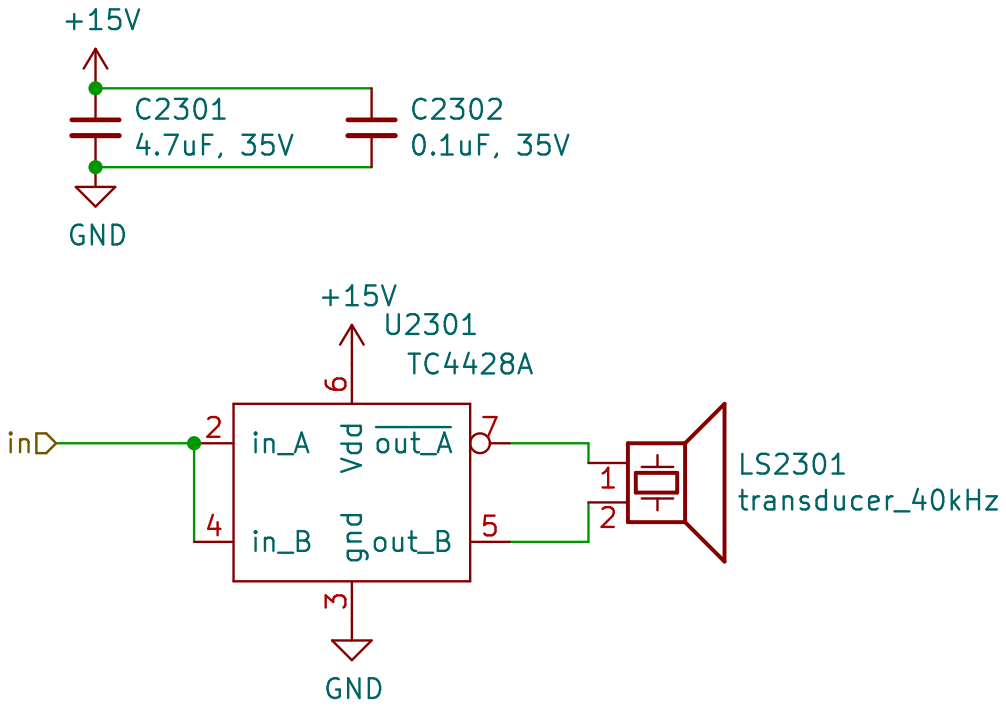
[picture p35: page 22]

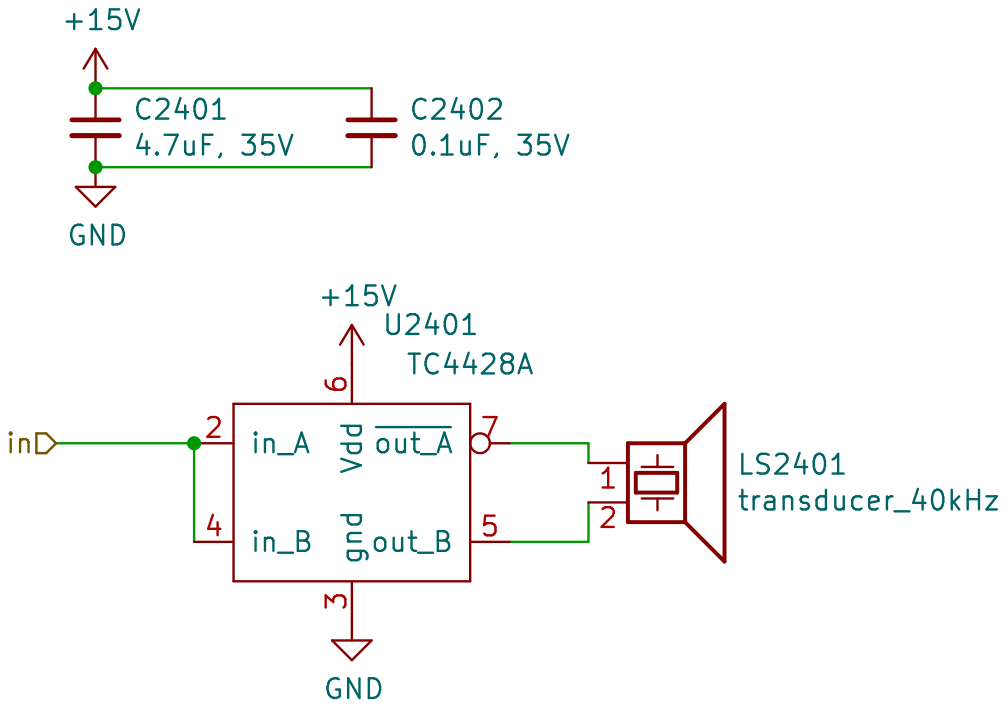
[picture p36: page 23]

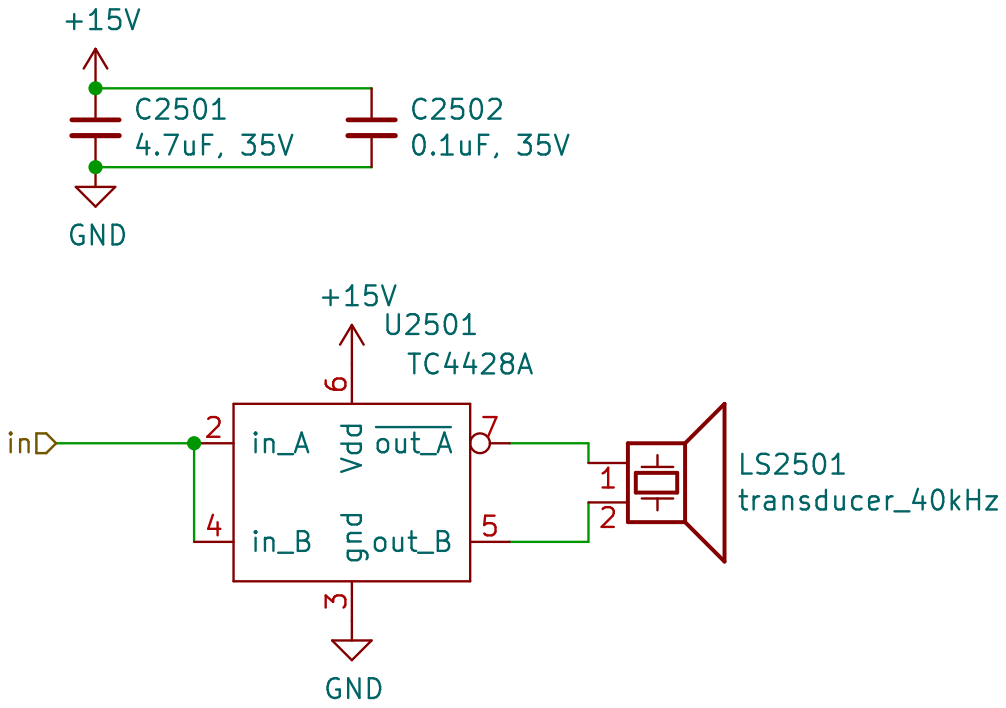
[picture p37: page 24]

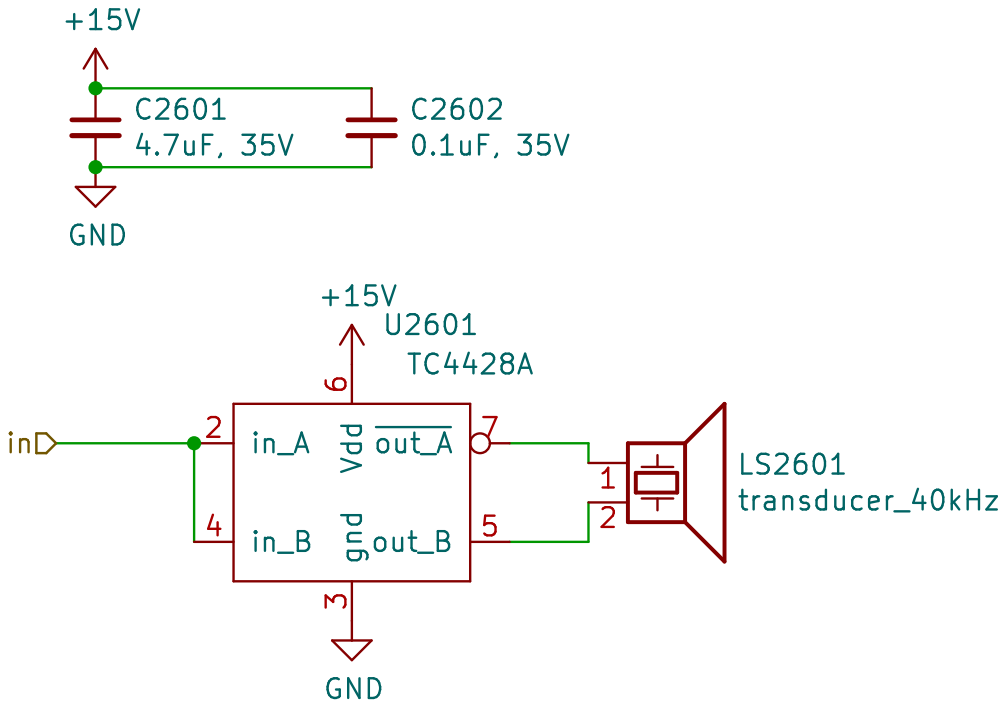
[picture p38: page 25]

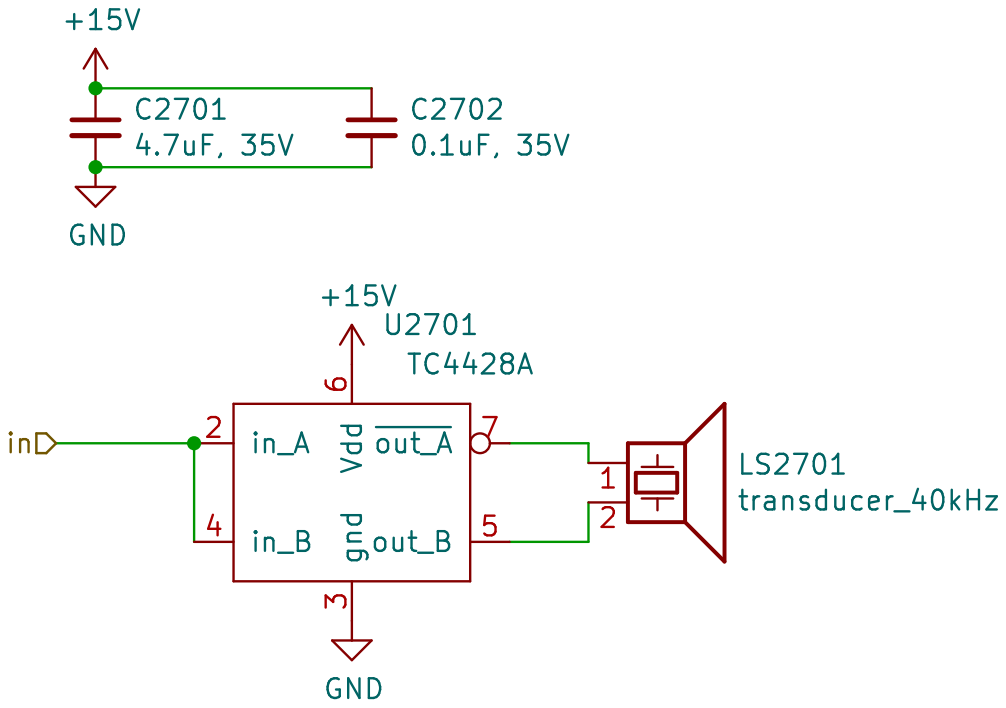
[picture p39: page 26]

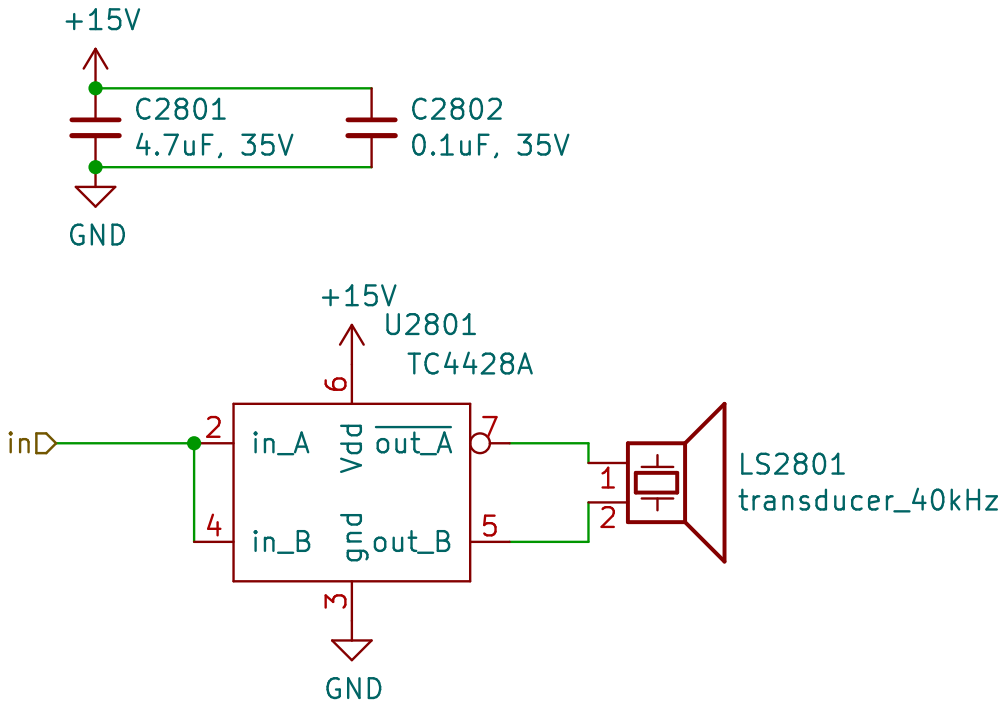
[picture p40: page 27]

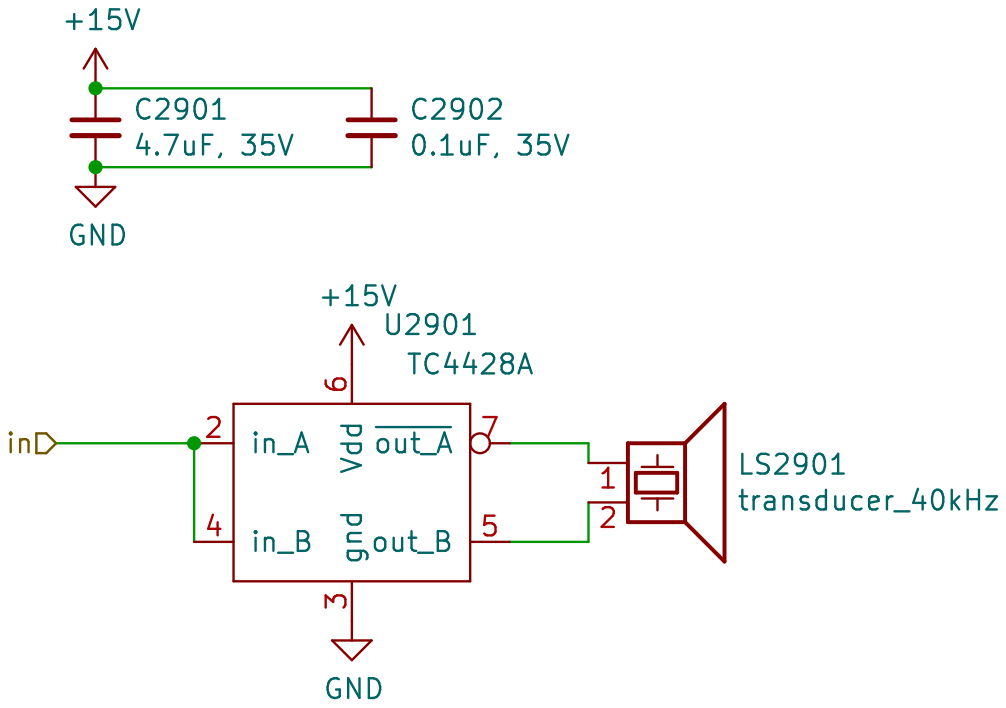
[picture p41: page 28]

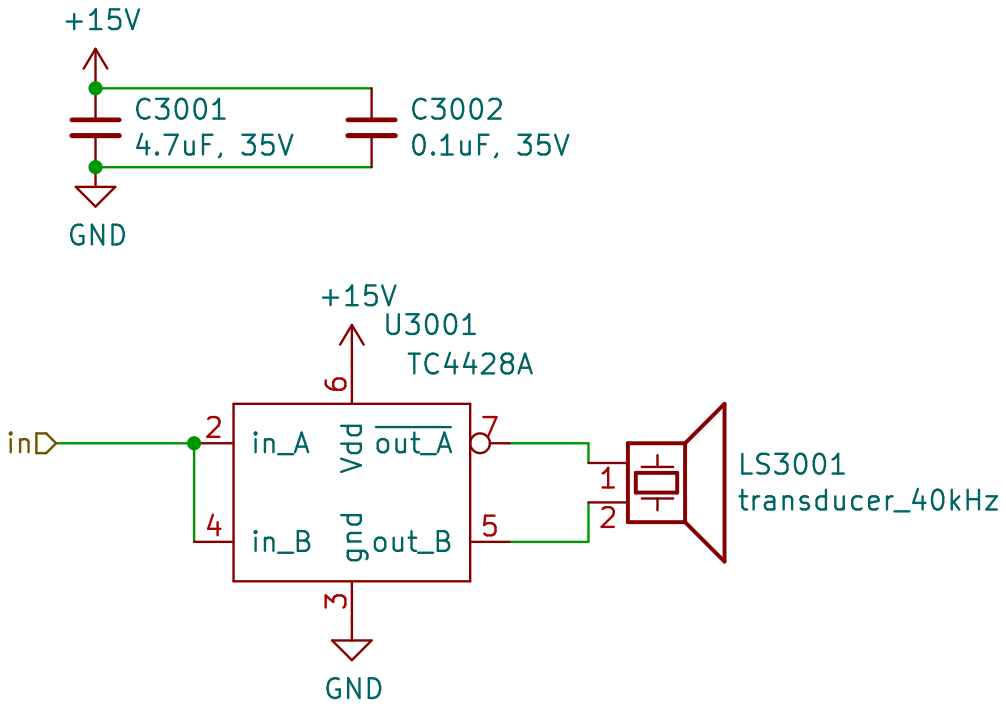
[picture p42: page 29]

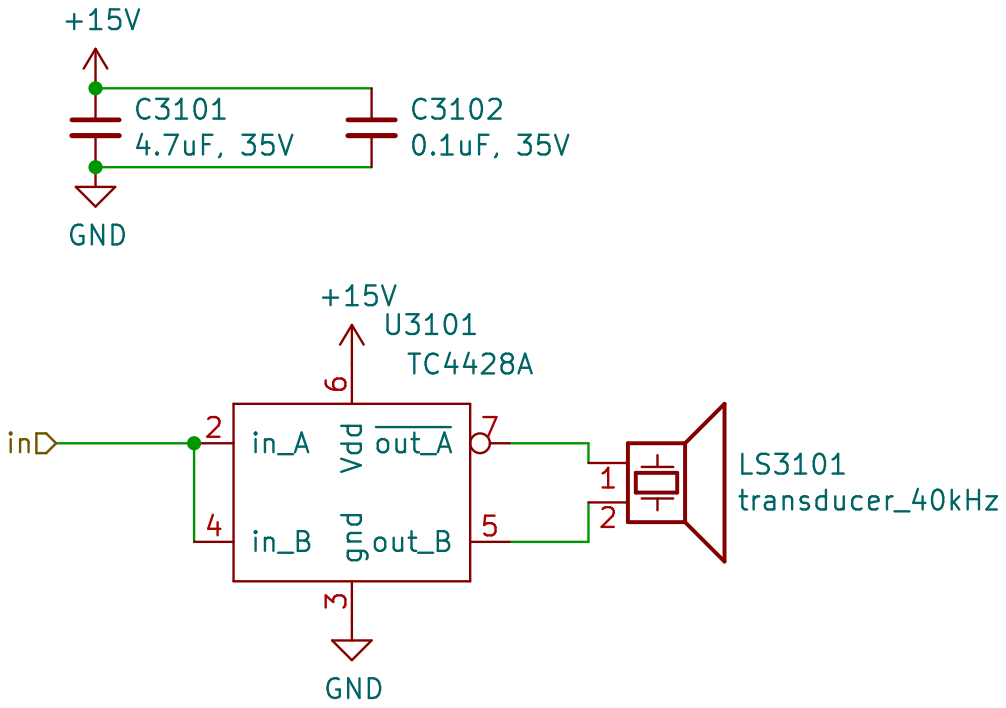
[picture p43: page 30]

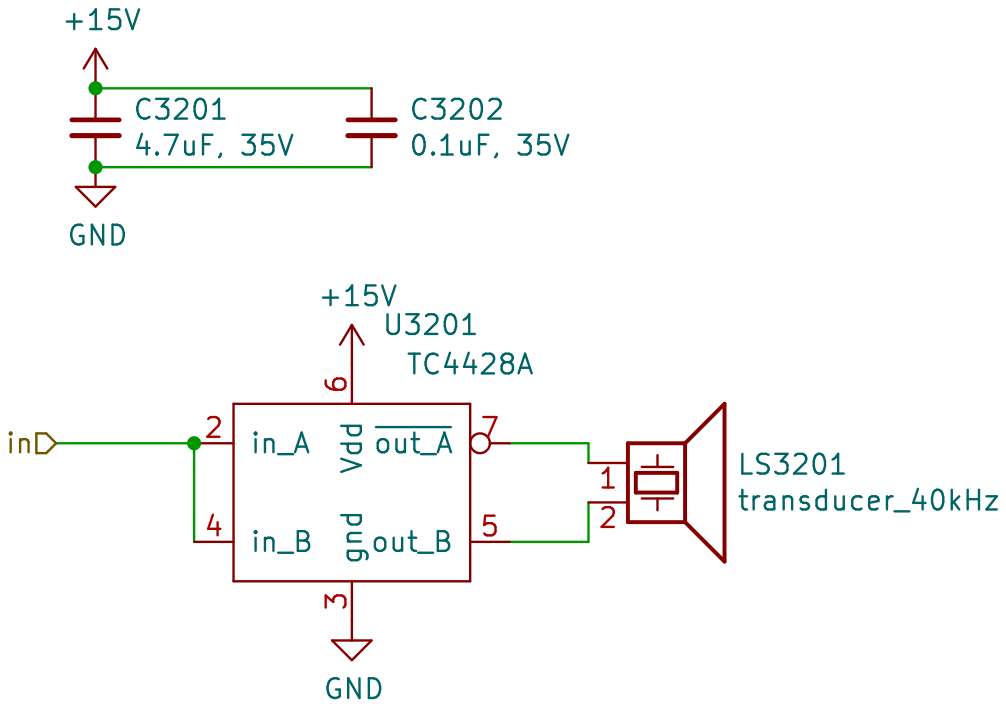
[picture p44: page 31]

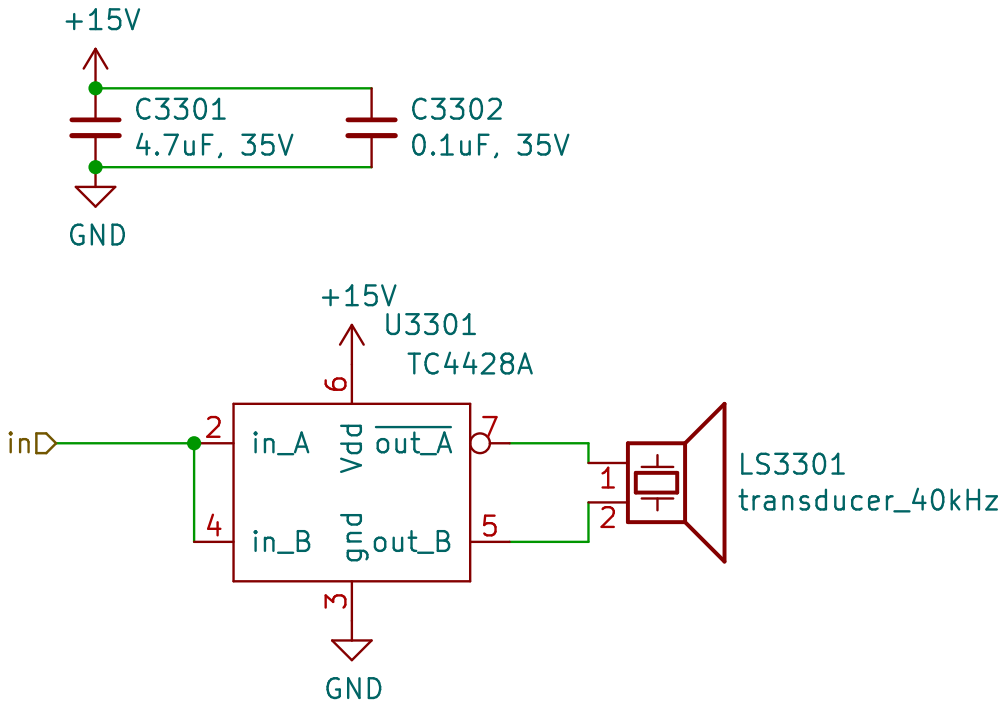
[picture p45: page 32]

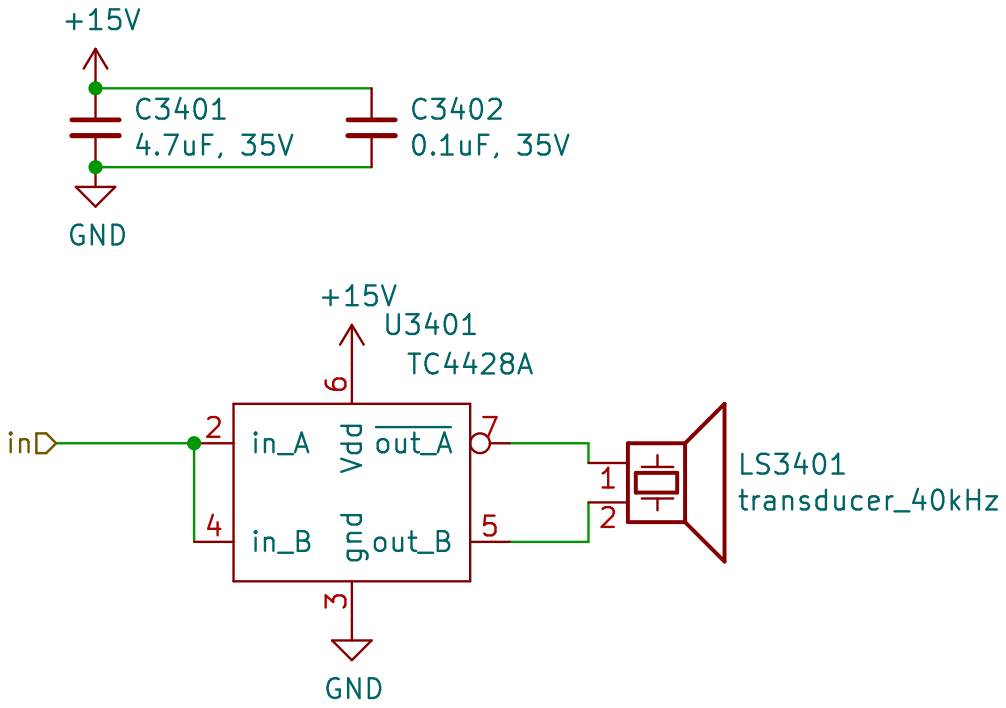
[picture p46: page 33]

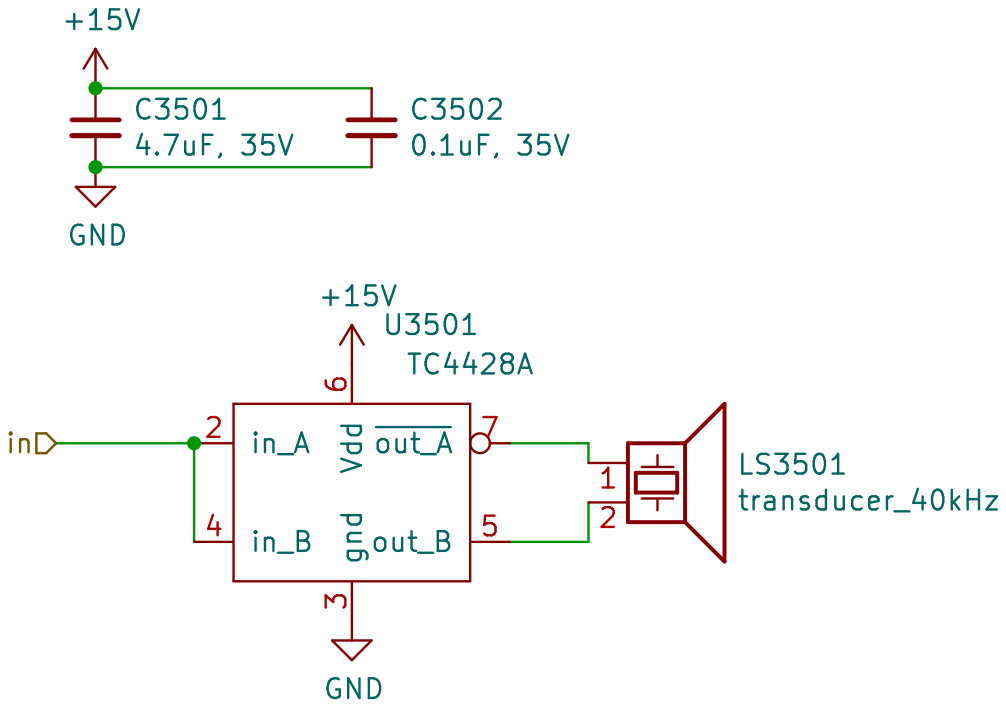
[picture p47: page 34]

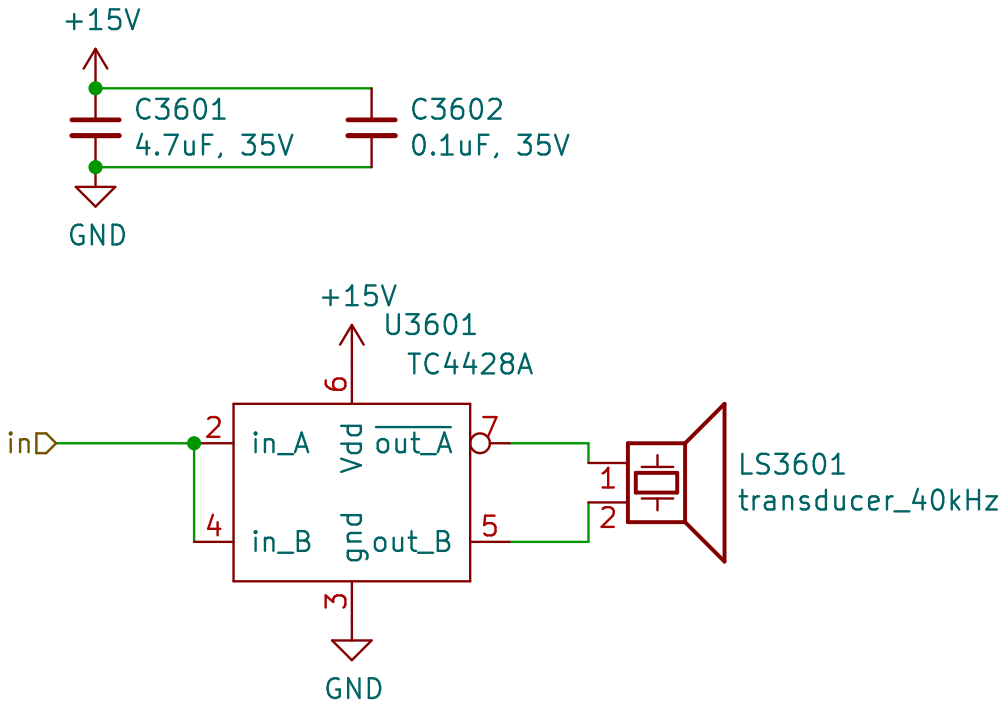
[picture p48: page 35]

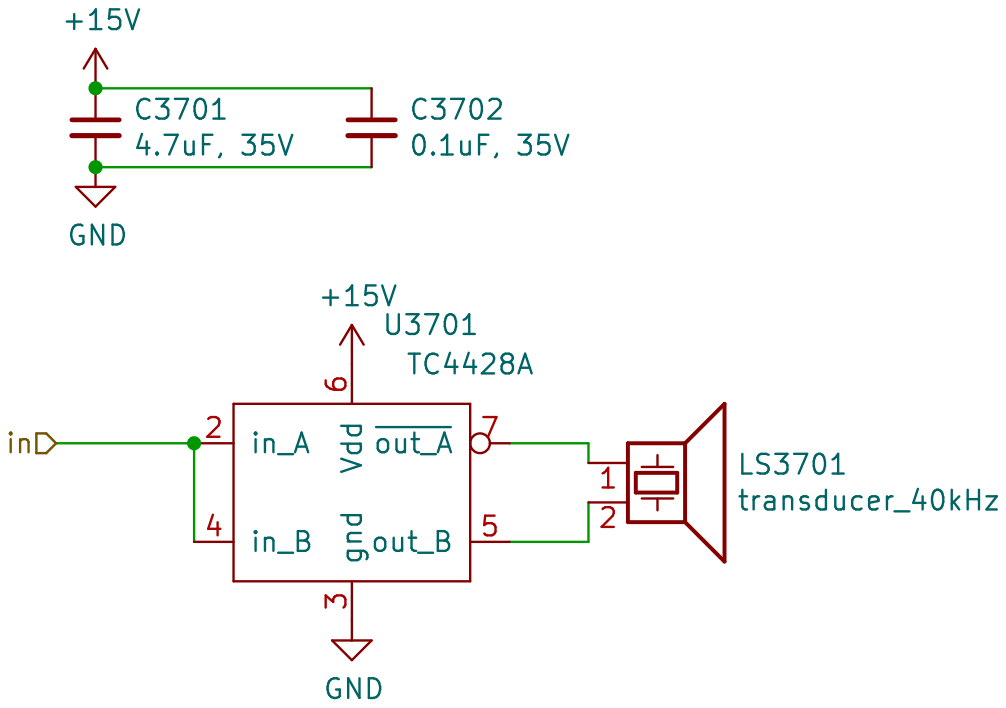
[picture p49: page 36]

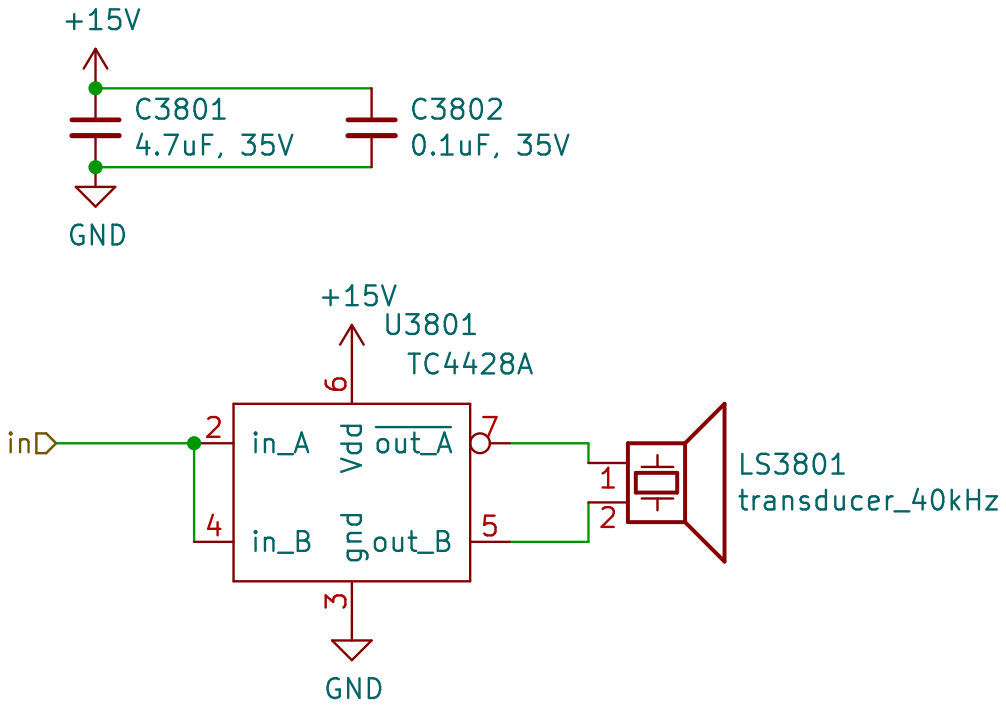
[picture p50: page 37]

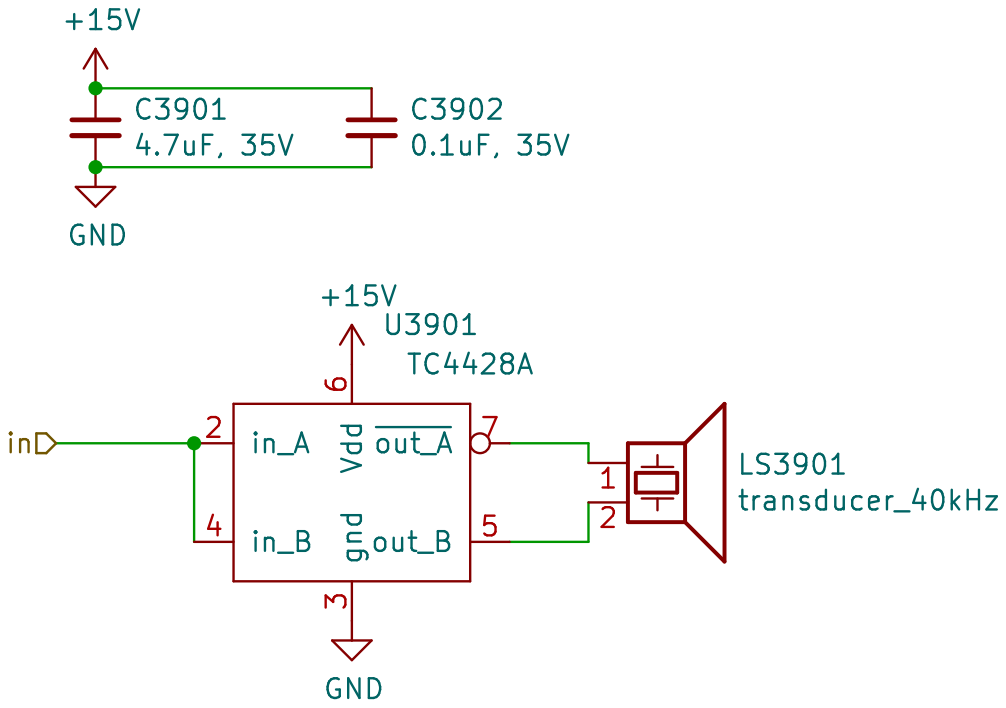
[picture p51: page 38]

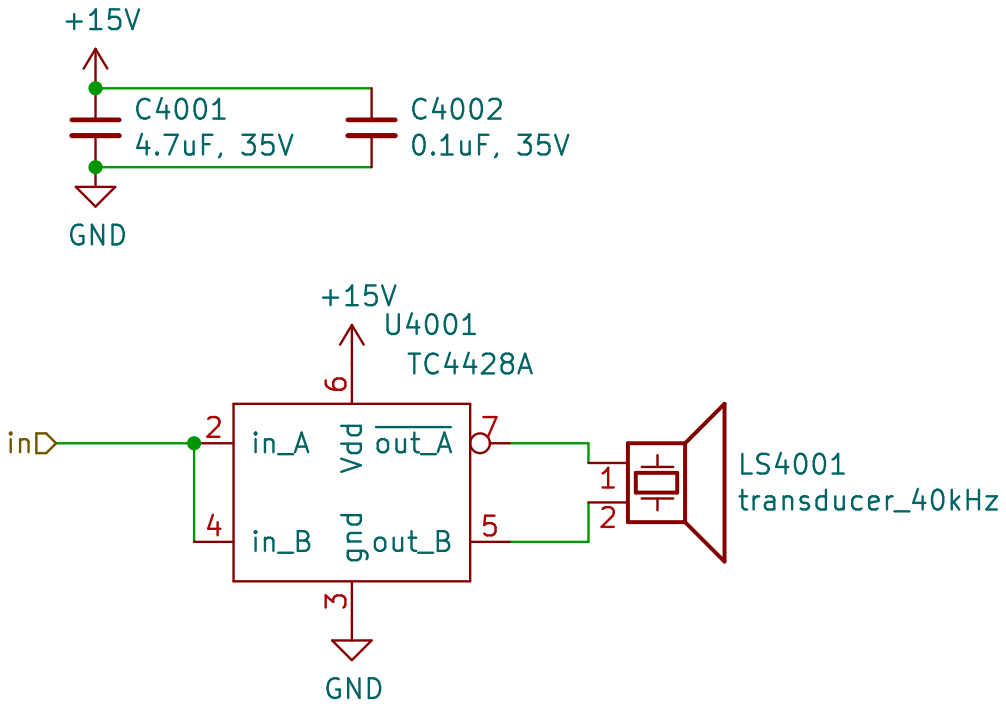
[picture p52: page 39]

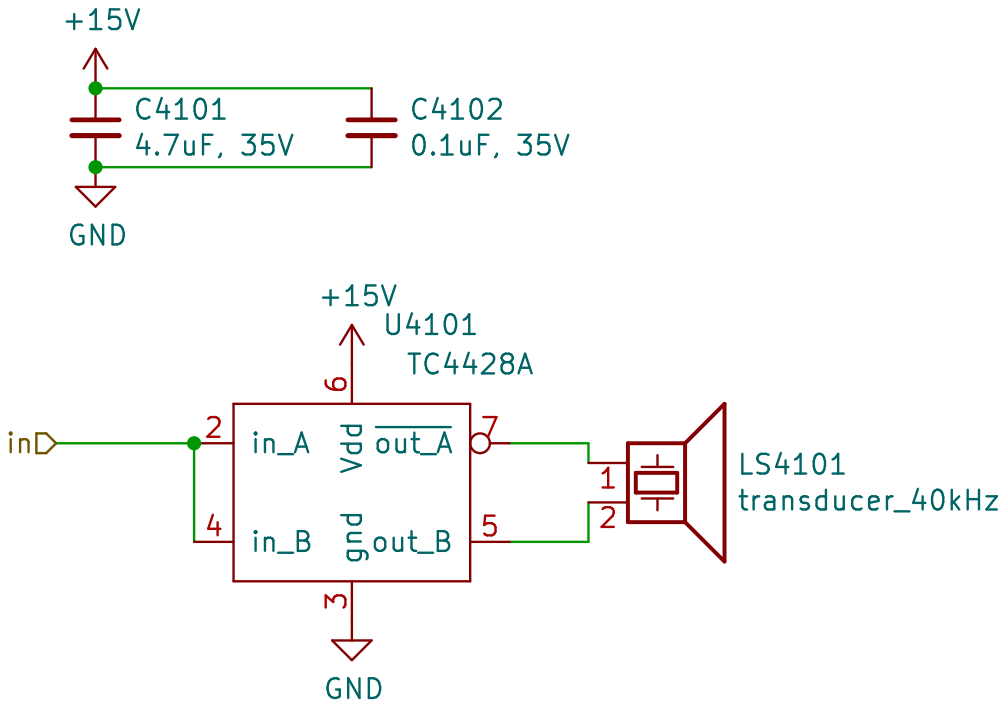
[picture p53: page 40]

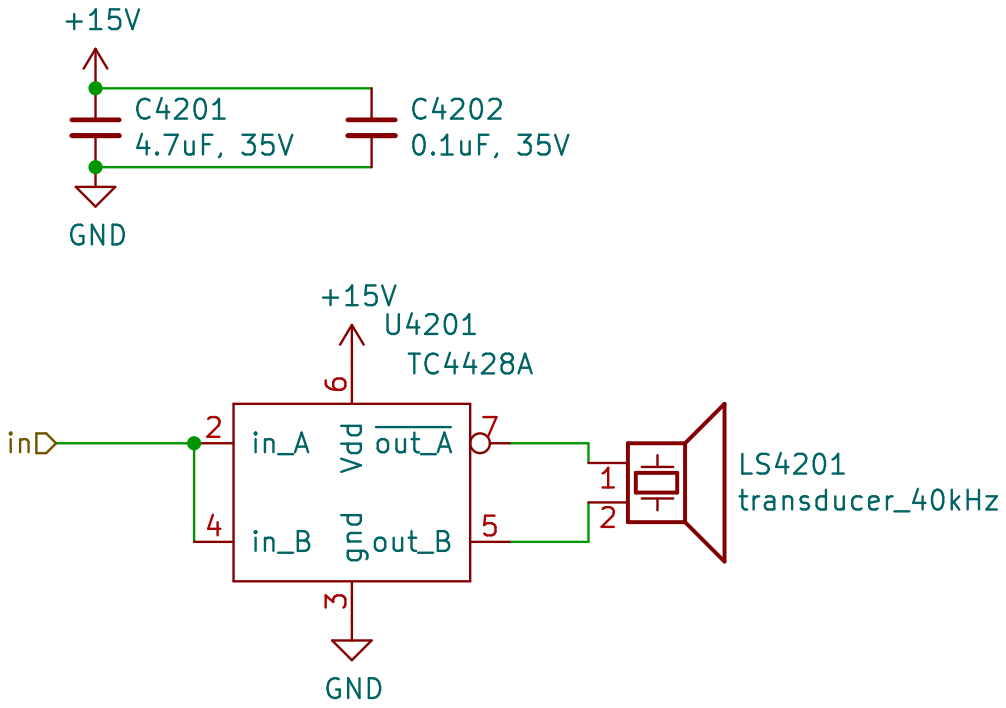
[picture p54: page 41]

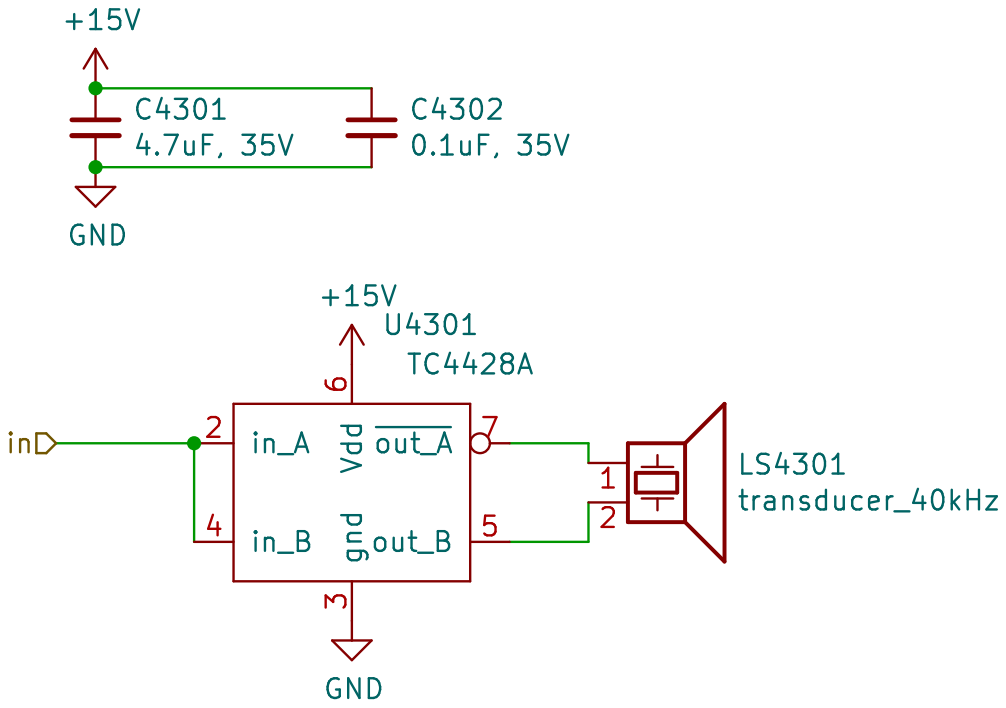
[picture p55: page 42]

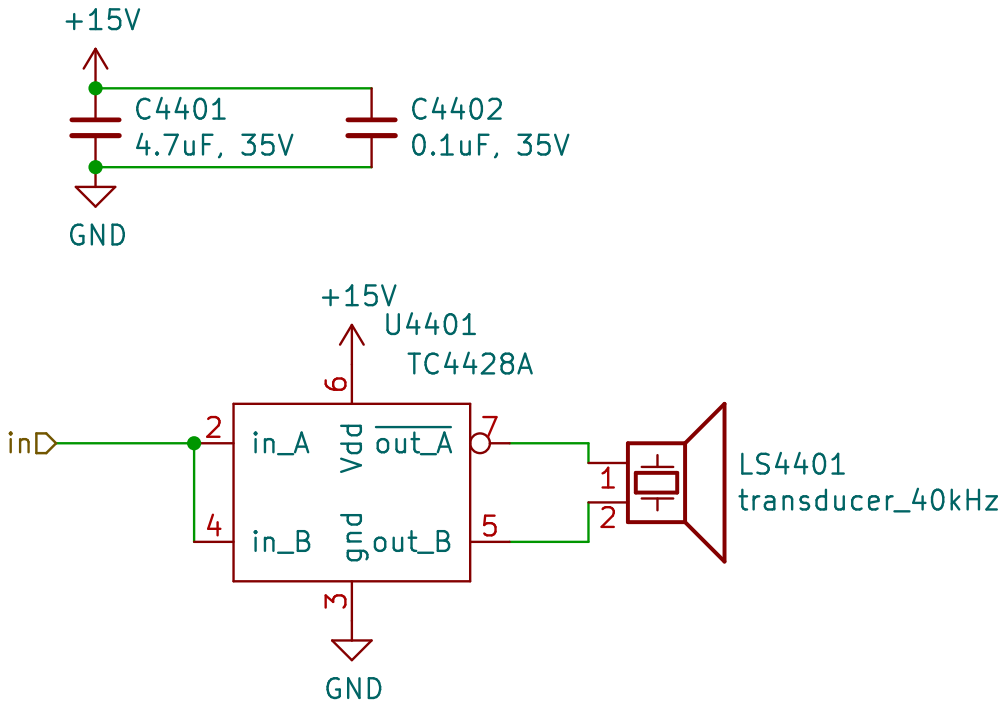
[picture p56: page 43]

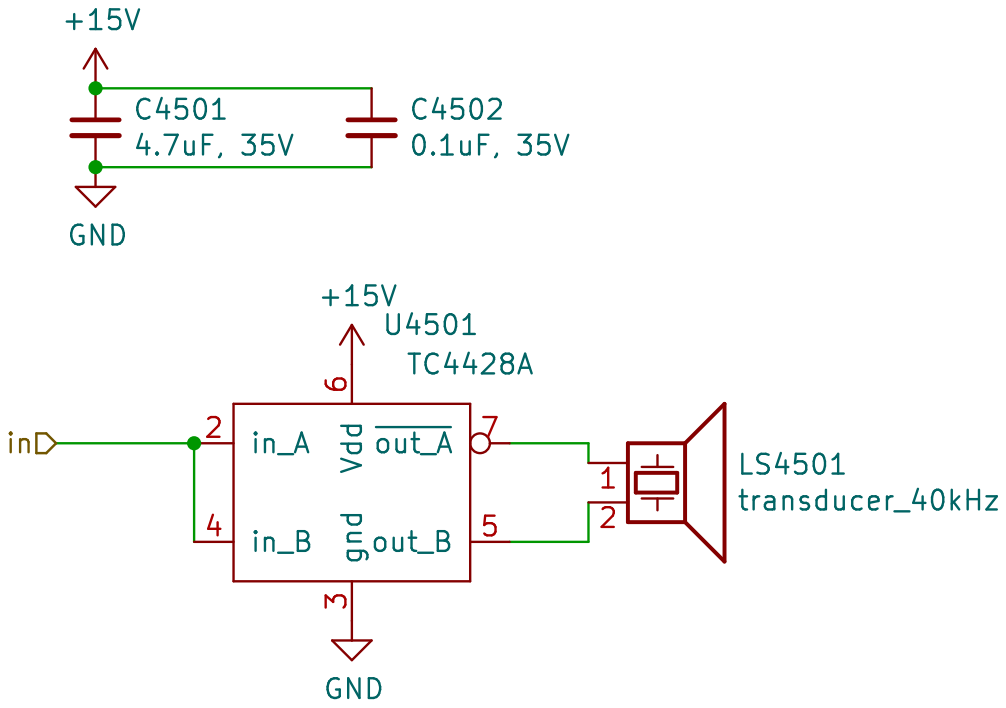
[picture p57: page 44]

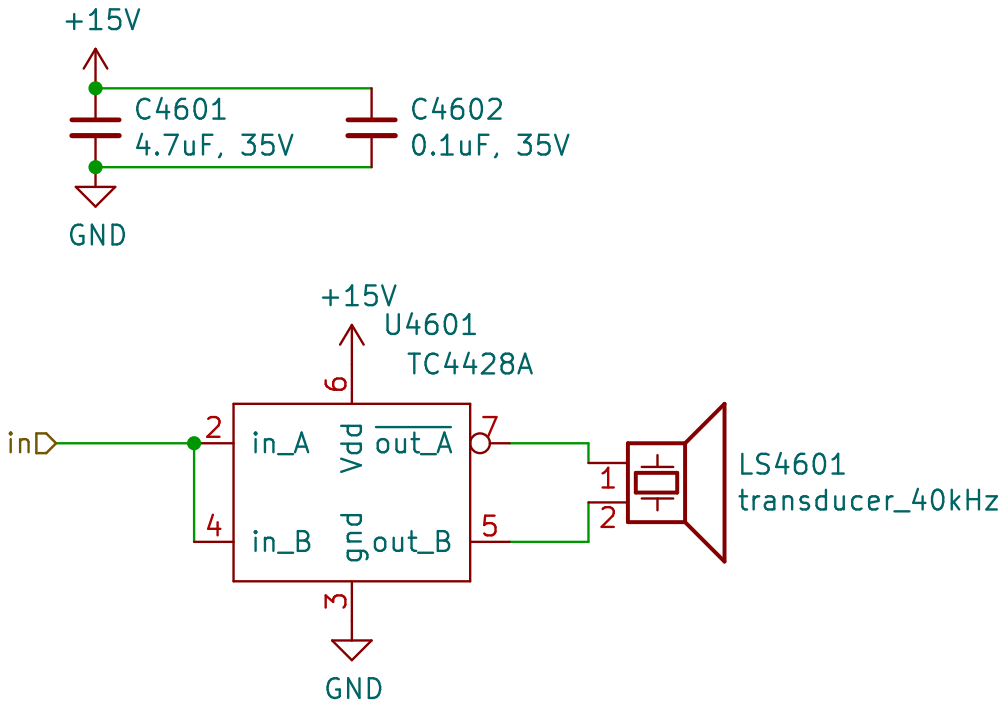
[picture p58: page 45]

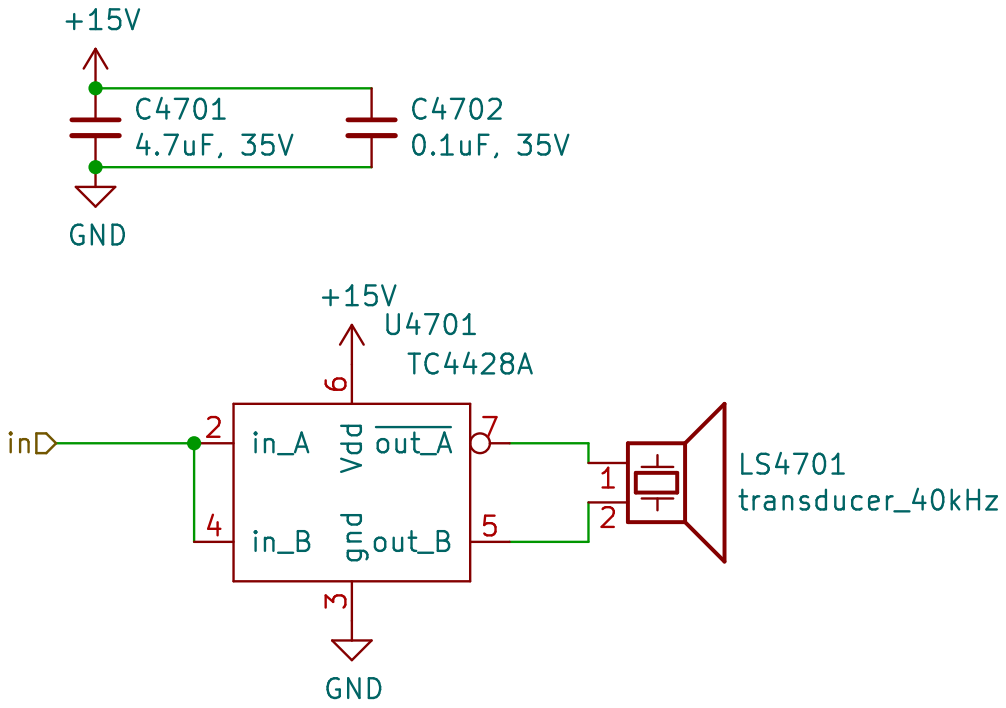
[picture p59: page 46]

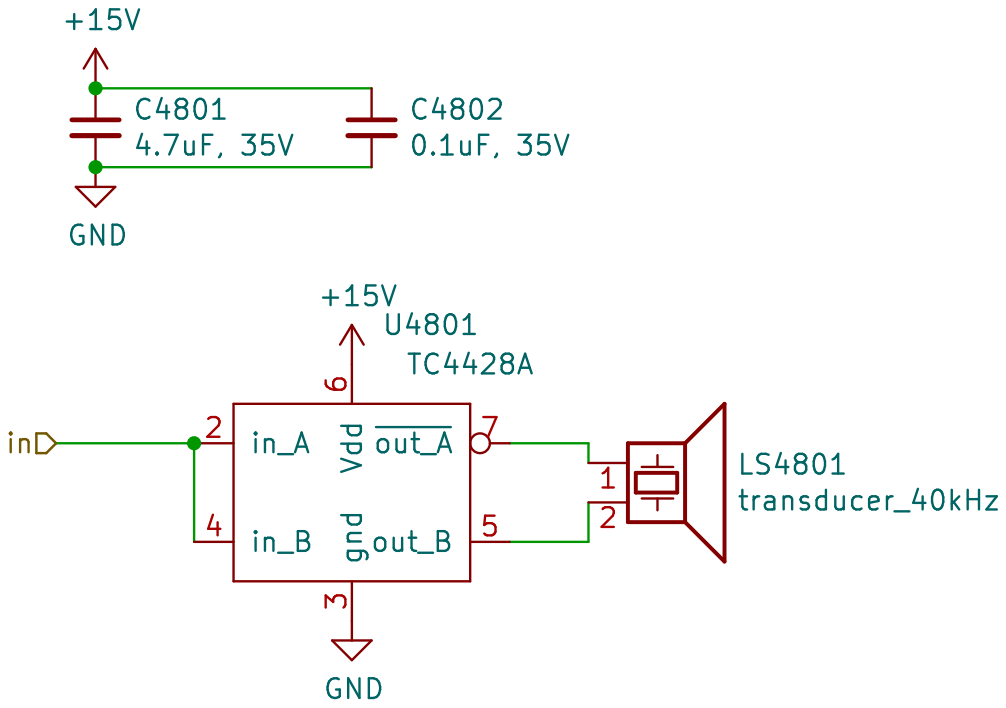
[picture p60: page 47]

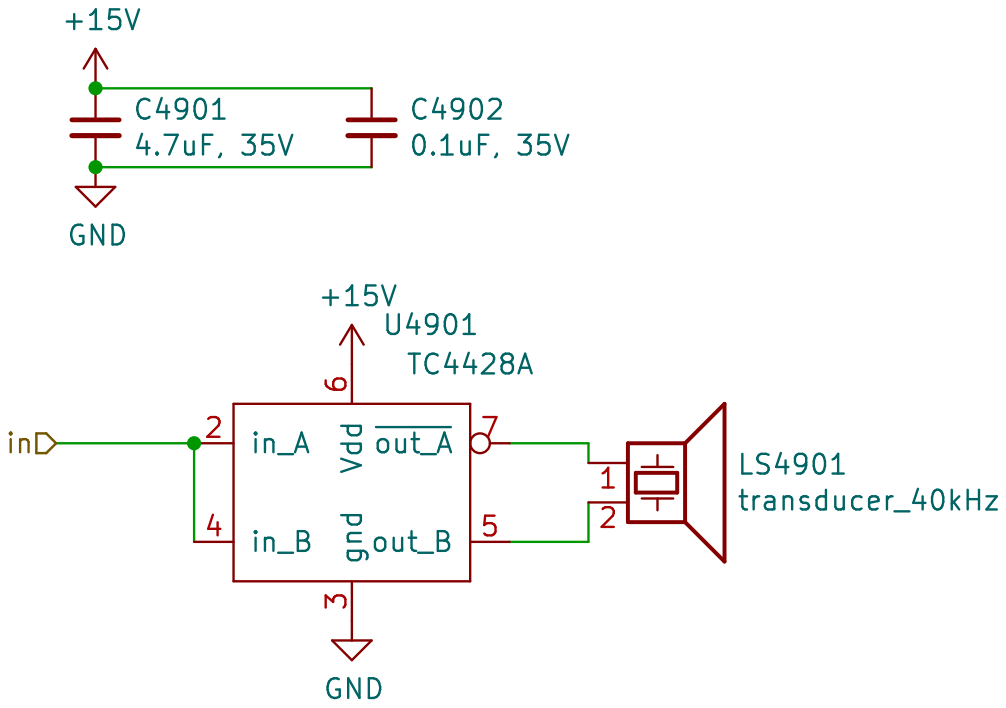
[picture p61: page 48]

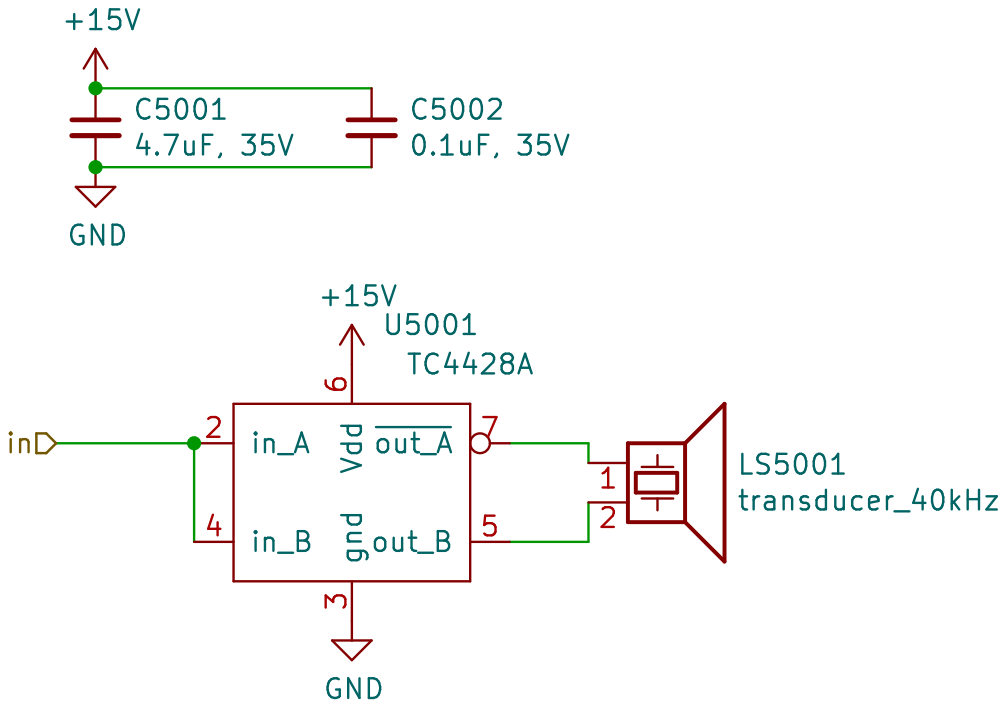
[picture p62: page 49]

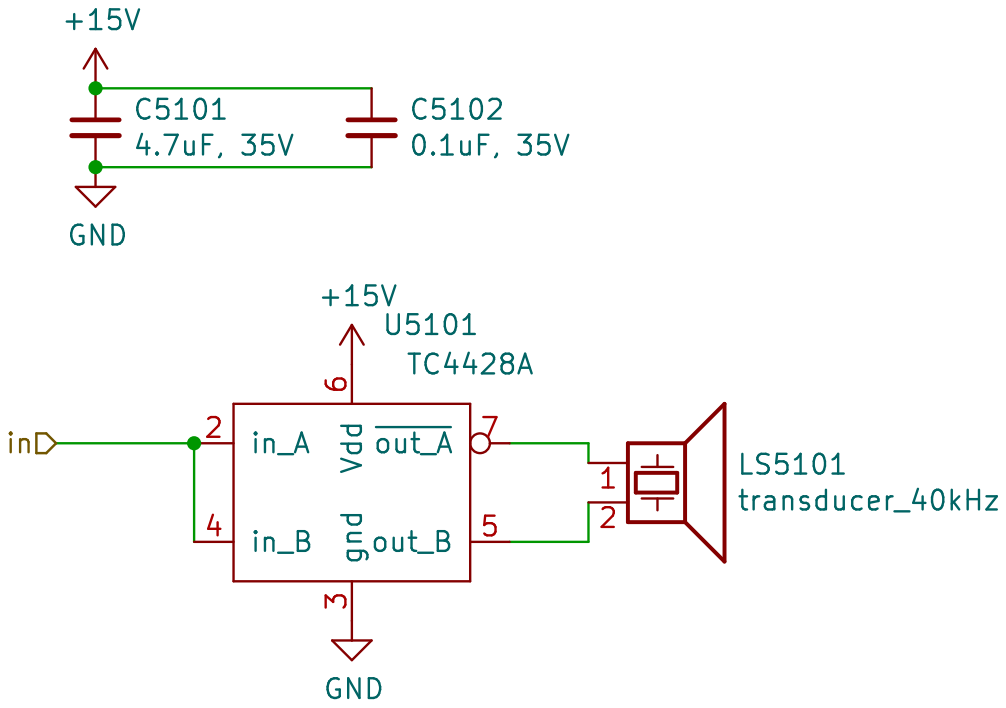
[picture p63: page 50]

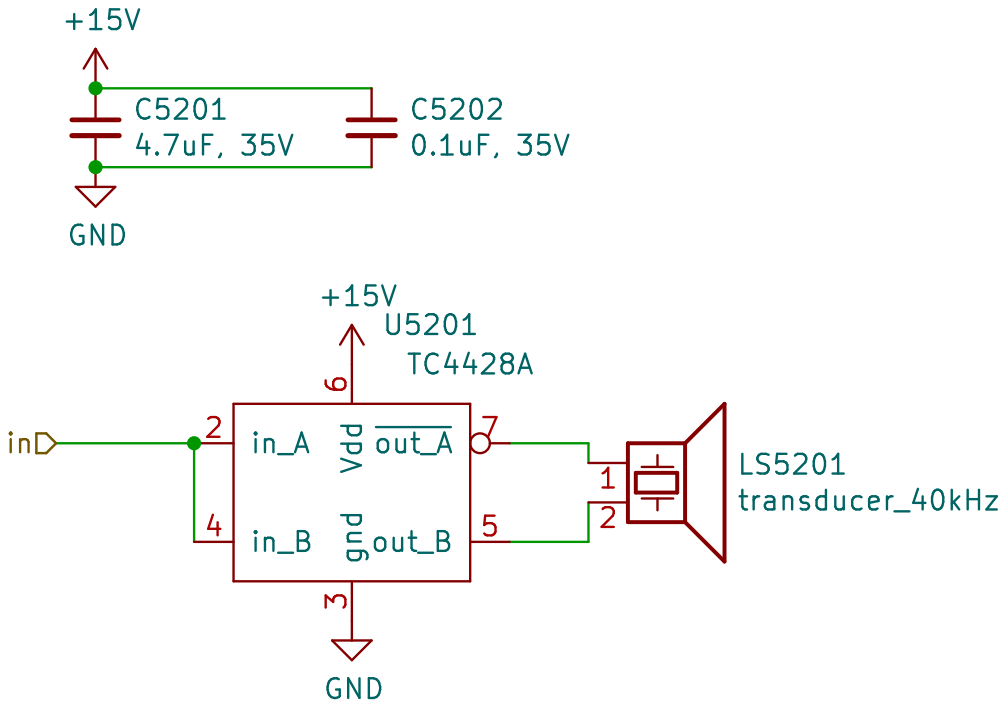
[picture p64: page 51]

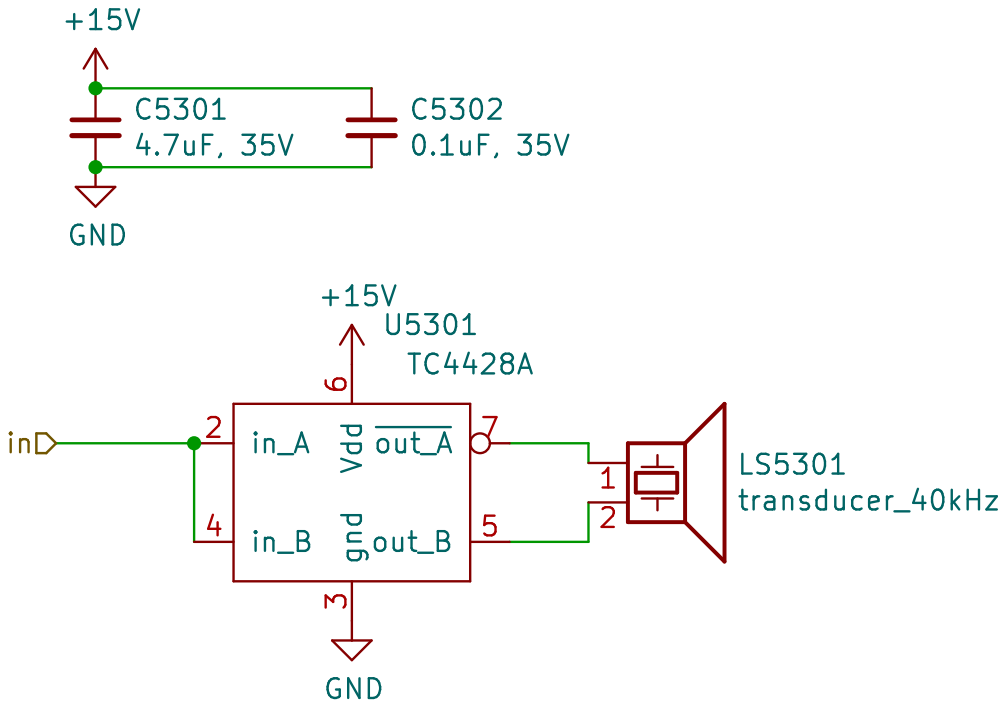
[picture p65: page 52]

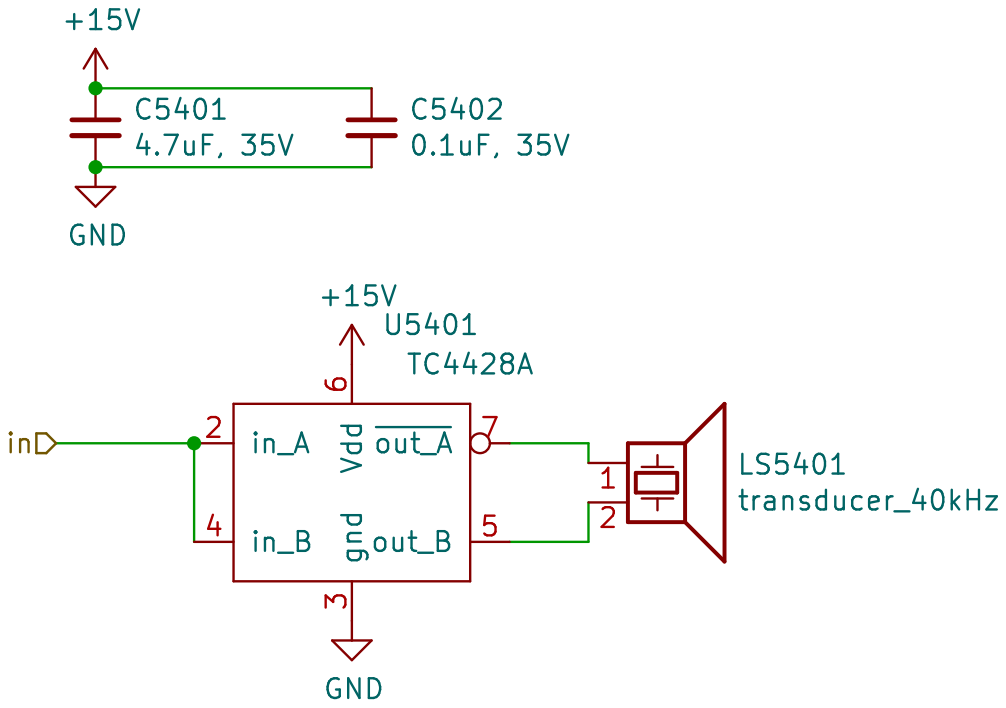
[picture p66: page 53]

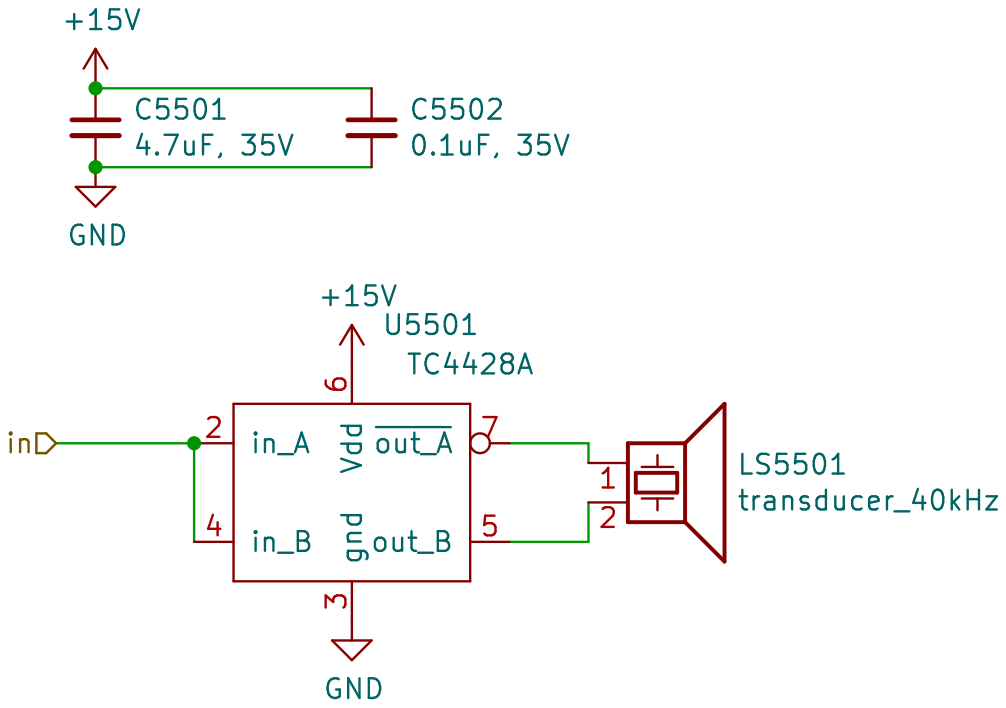
[picture p67: page 54]

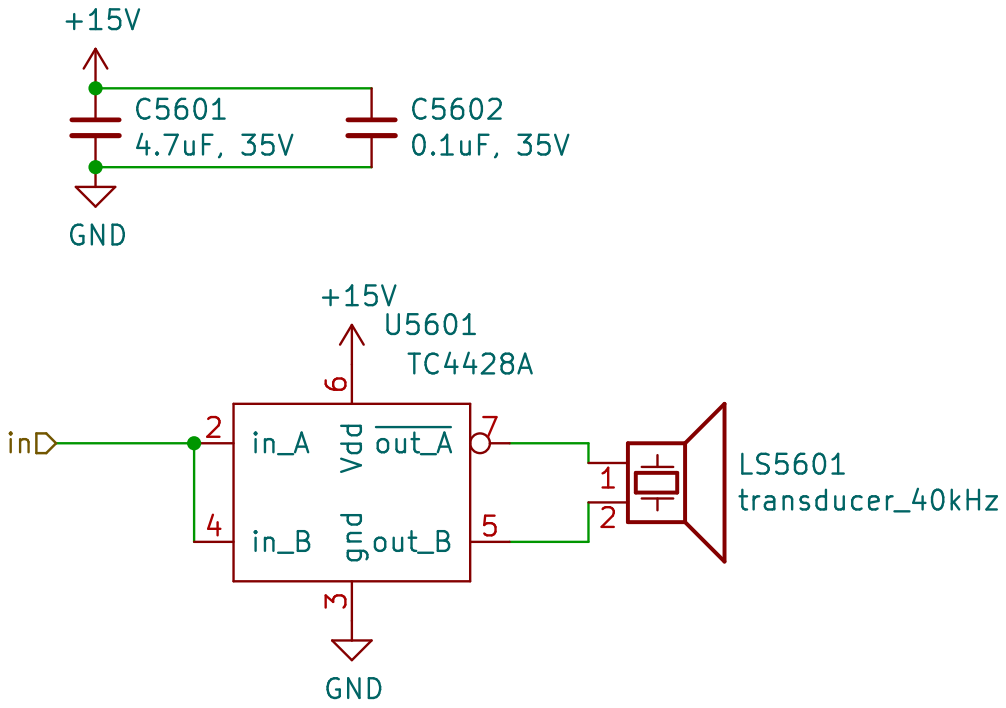
[picture p68: page 55]

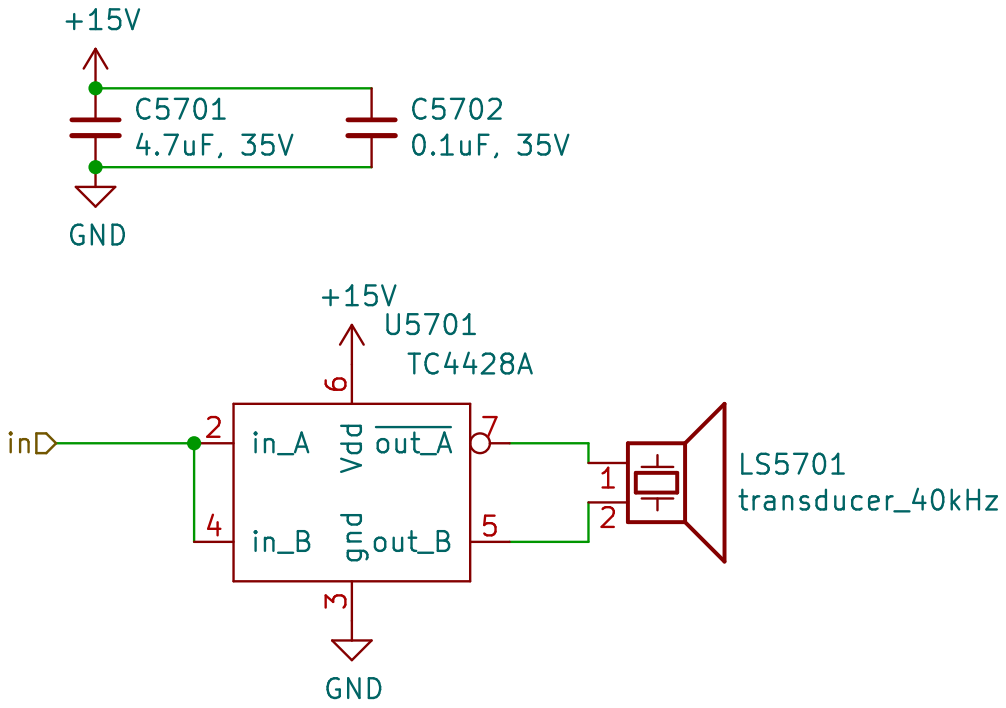
[picture p69: page 56]

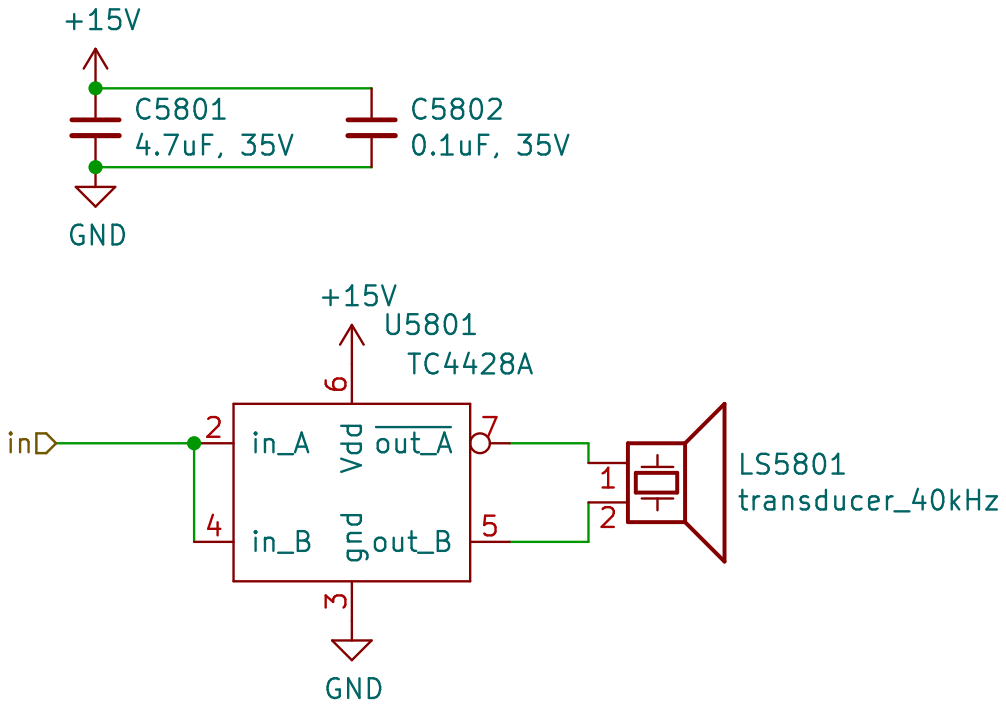
[picture p70: page 57]

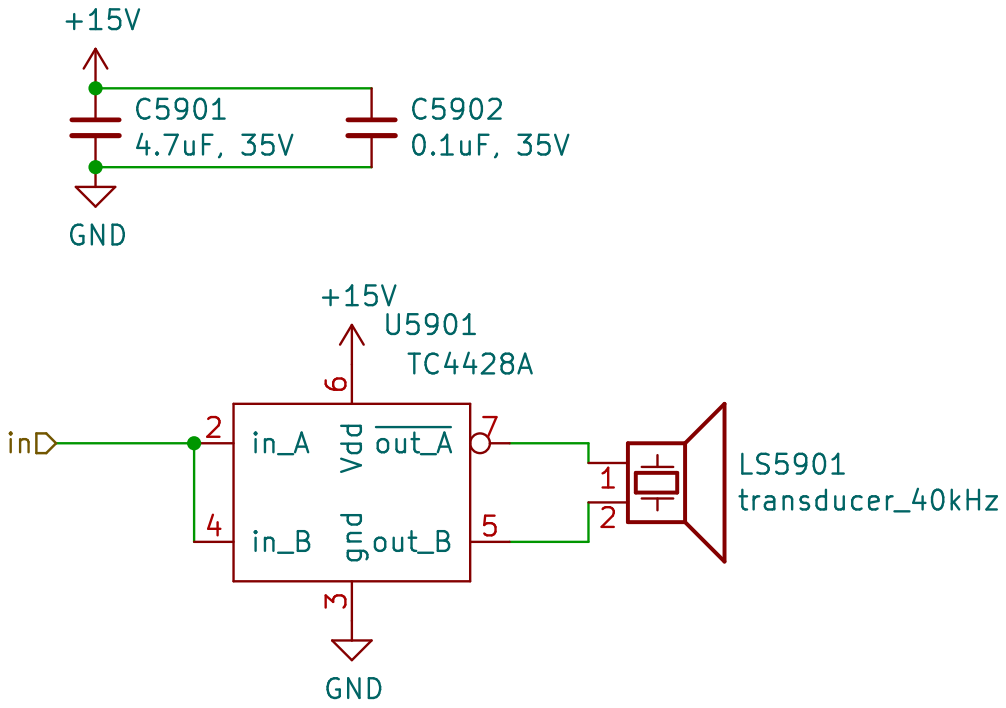
[picture p71: page 58]

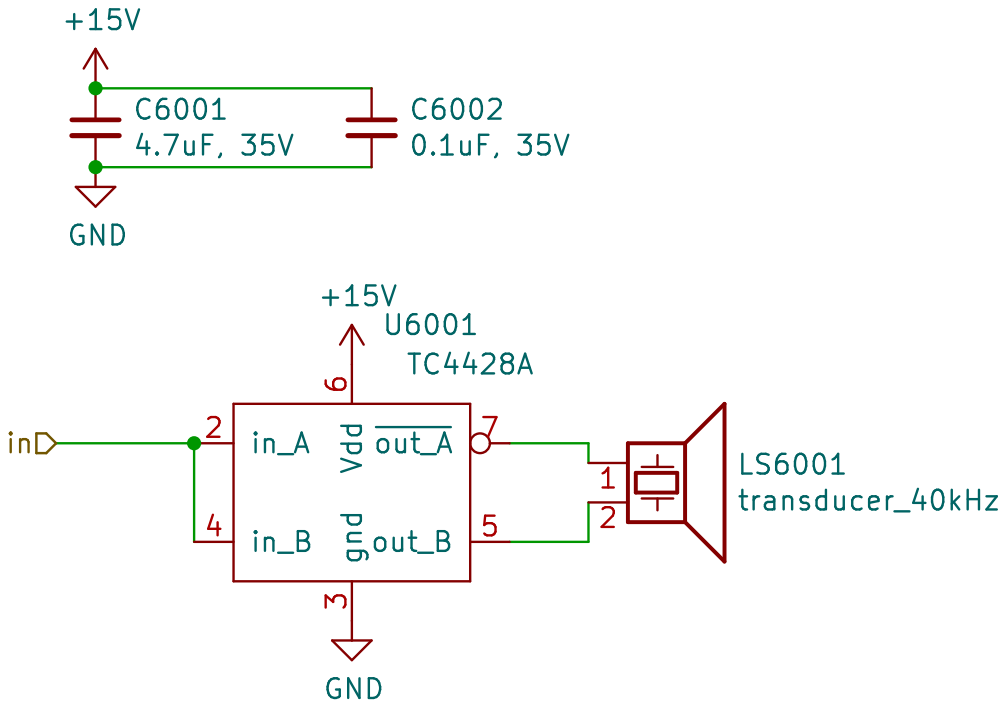
[picture p72: page 59]

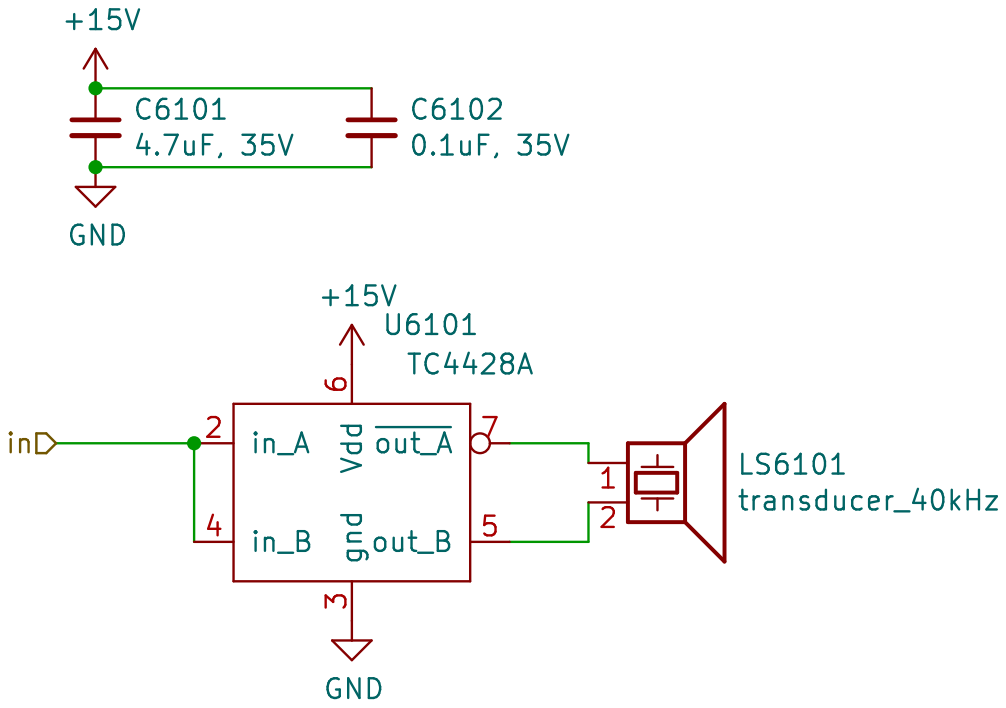
[picture p73: page 60]

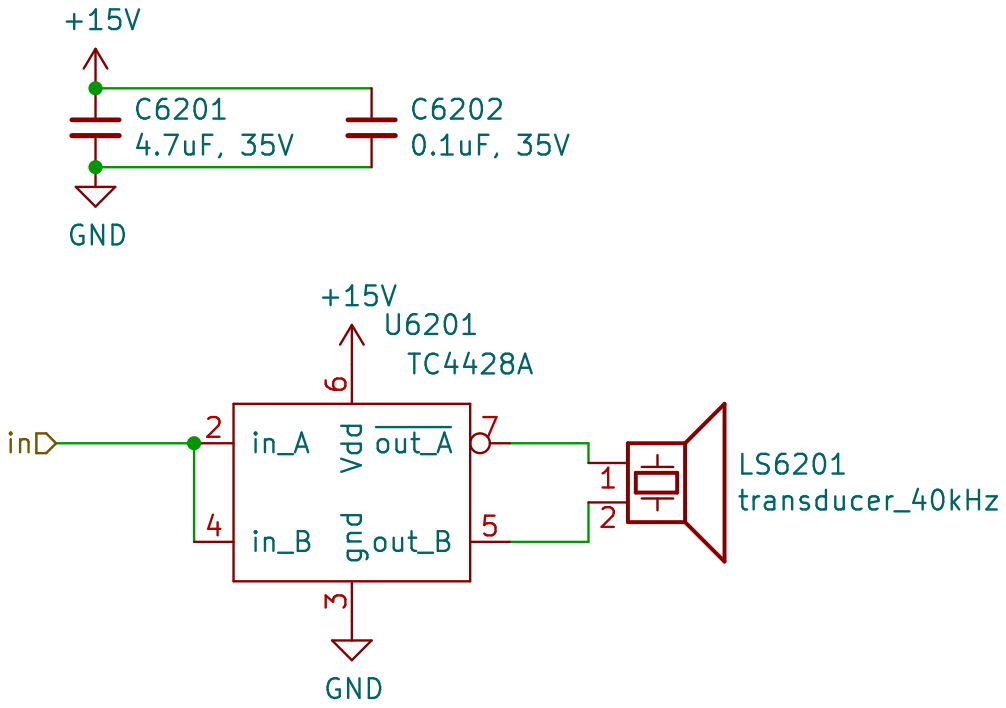
[picture p74: page 61]

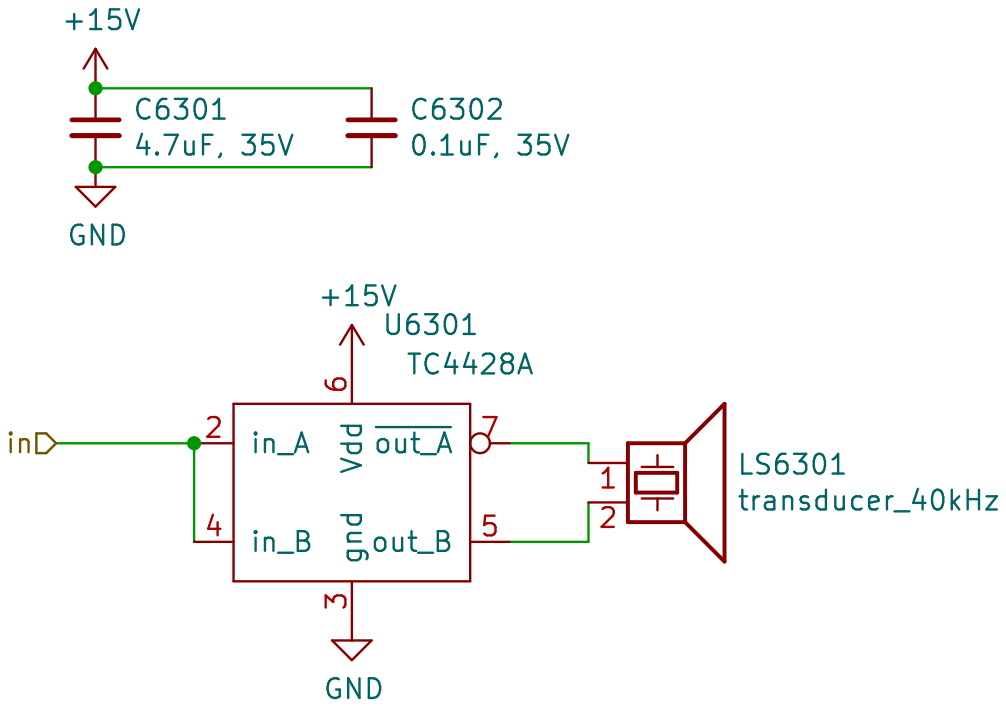
[picture p75: page 62]

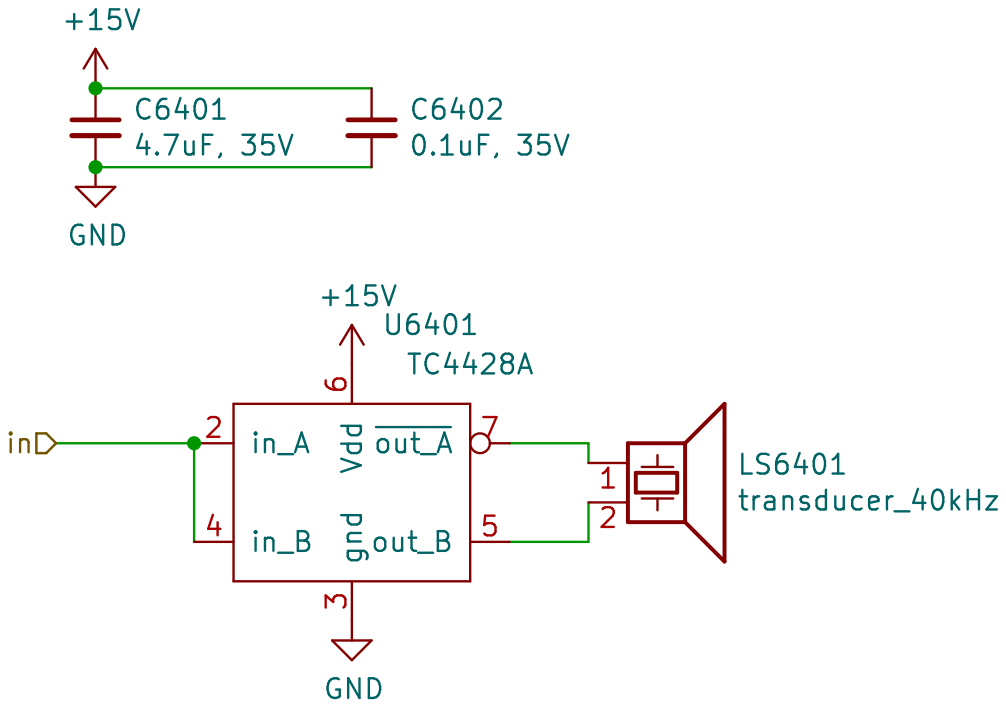
[picture p76: page 63]

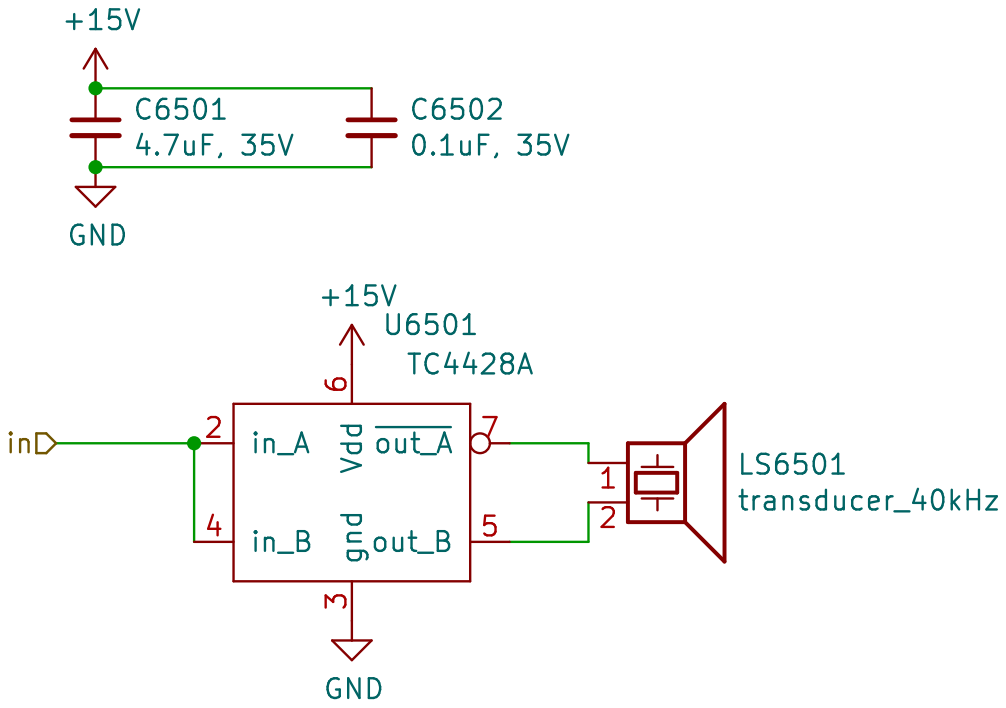
[picture p77: page 64]

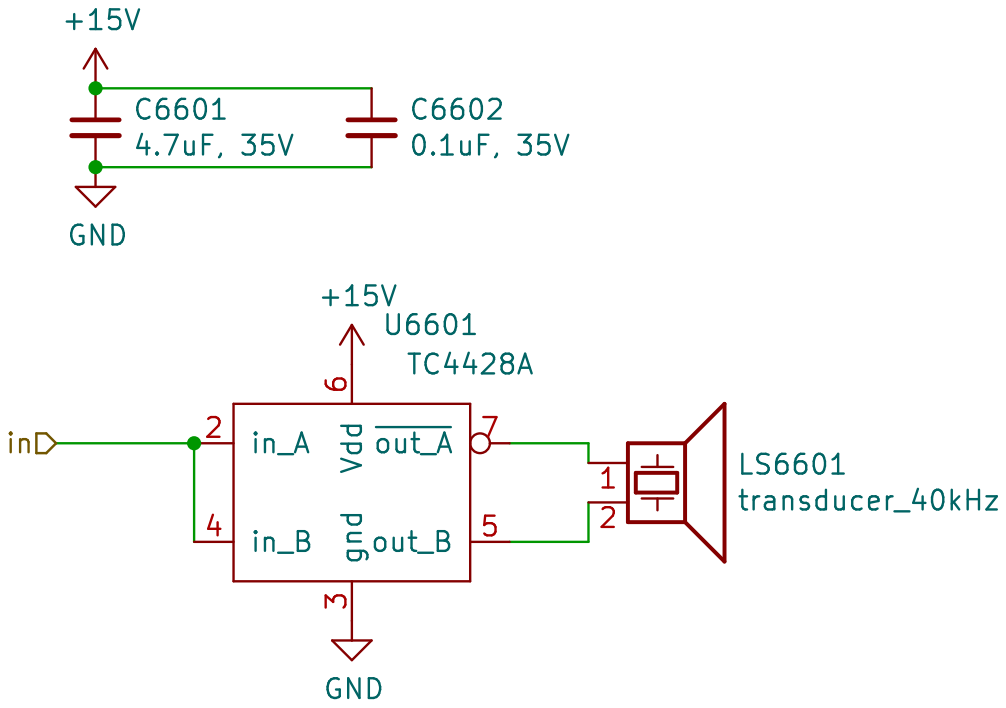
[picture p78: page 65]

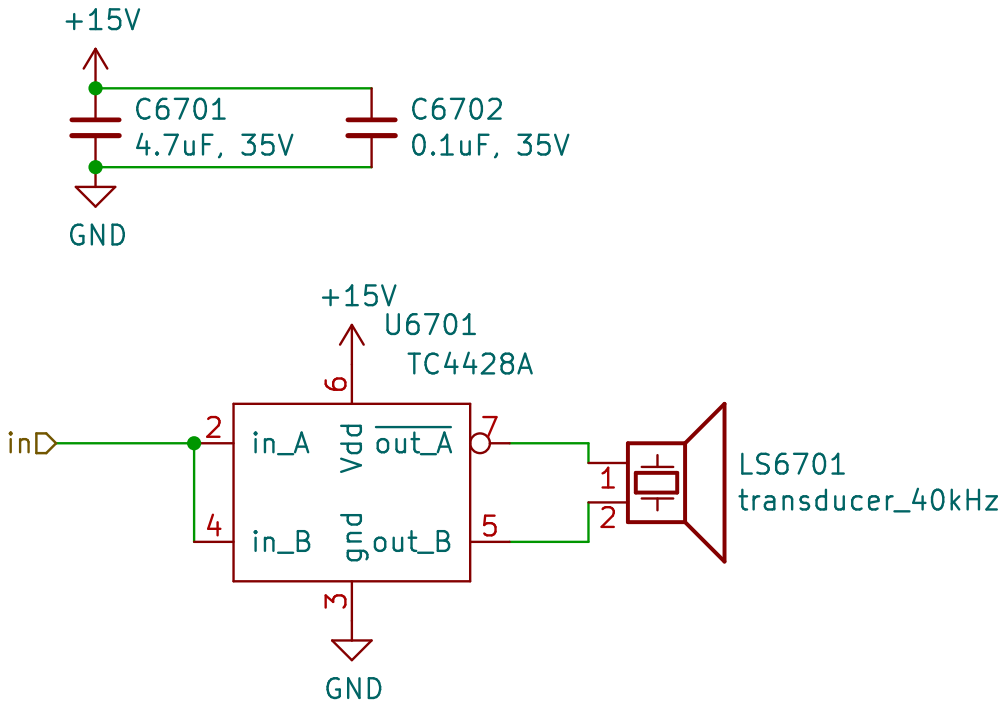
[picture p79: page 66]

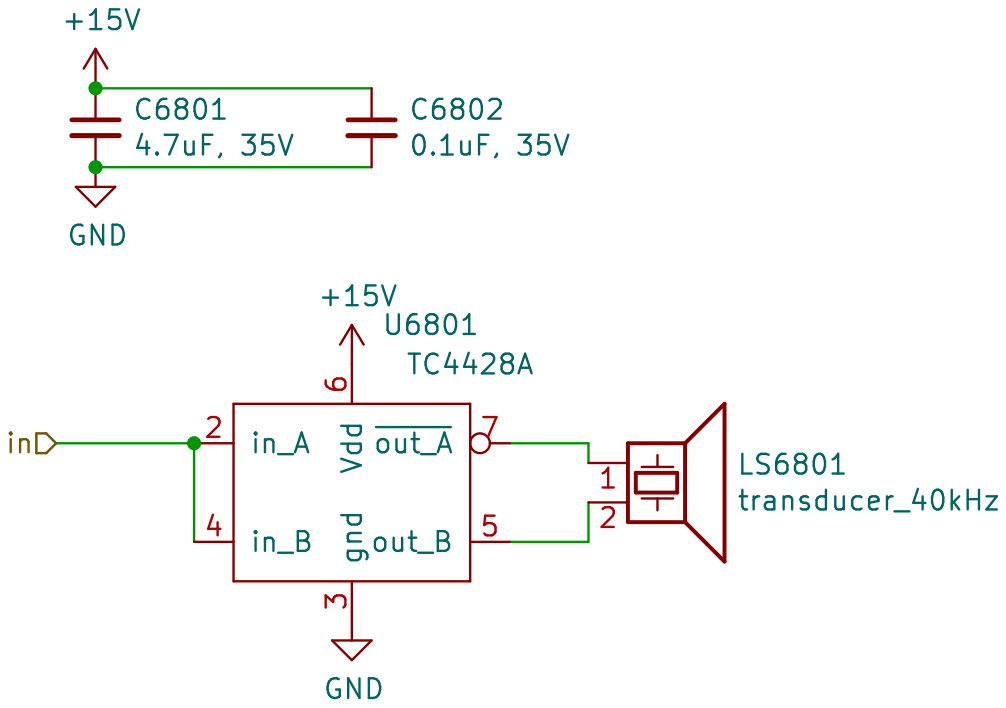
[picture p80: page 67]

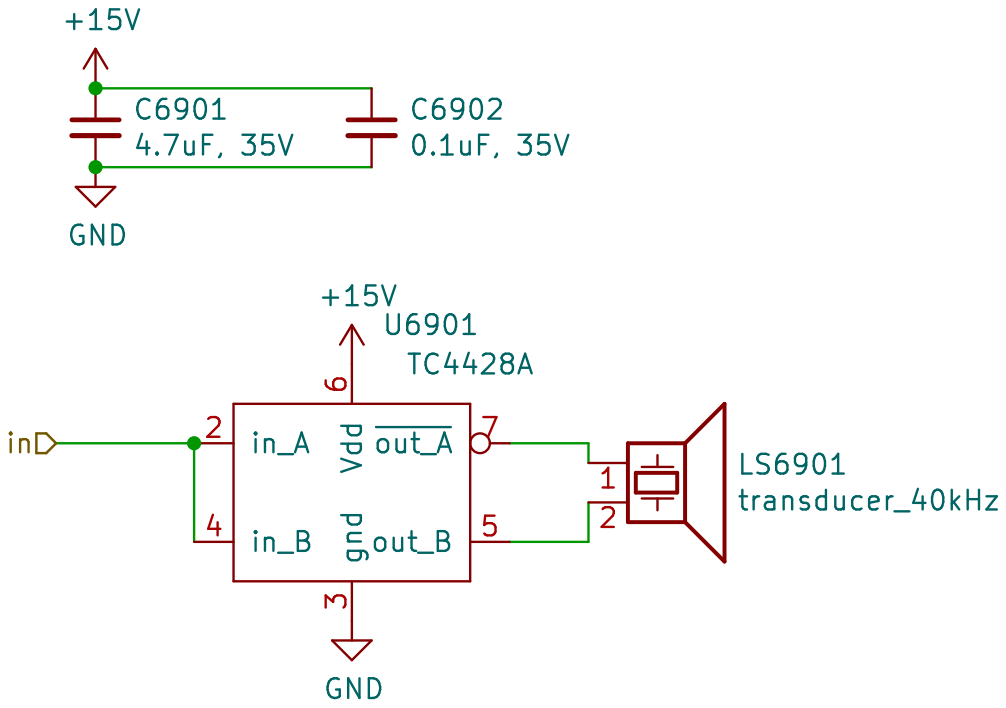
[picture p81: page 68]

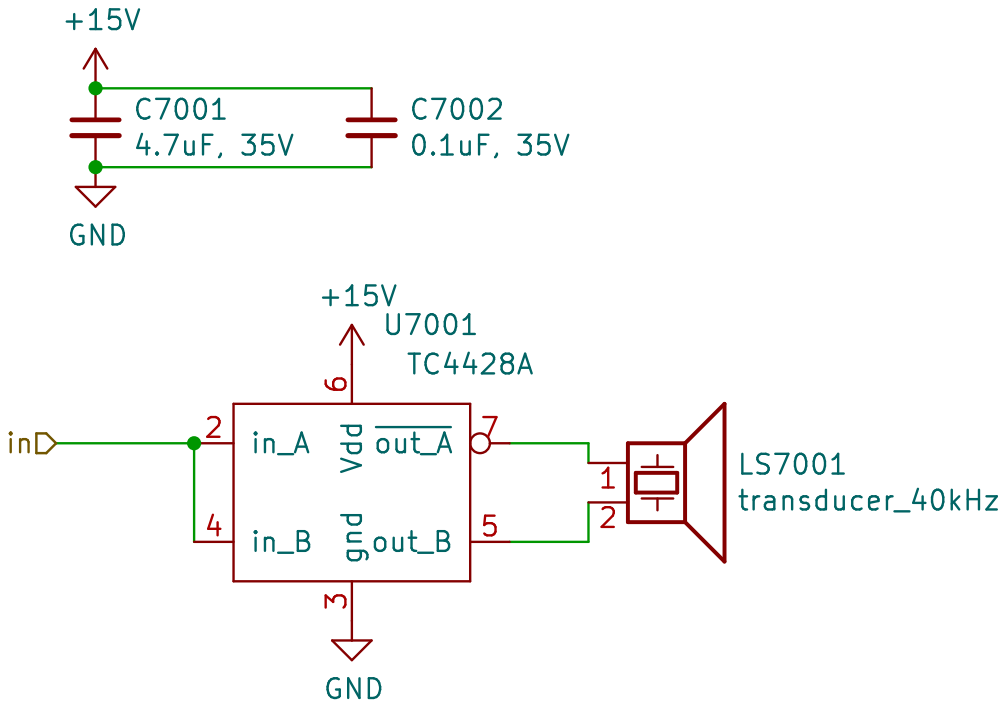
[picture p82: page 69]

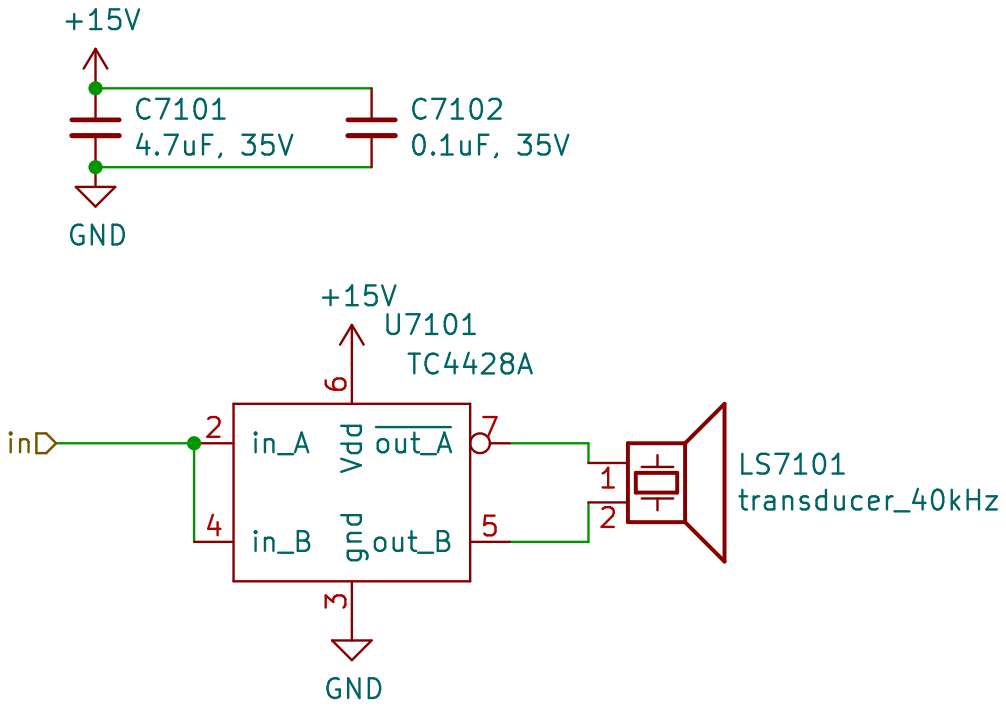
[picture p83: page 70]

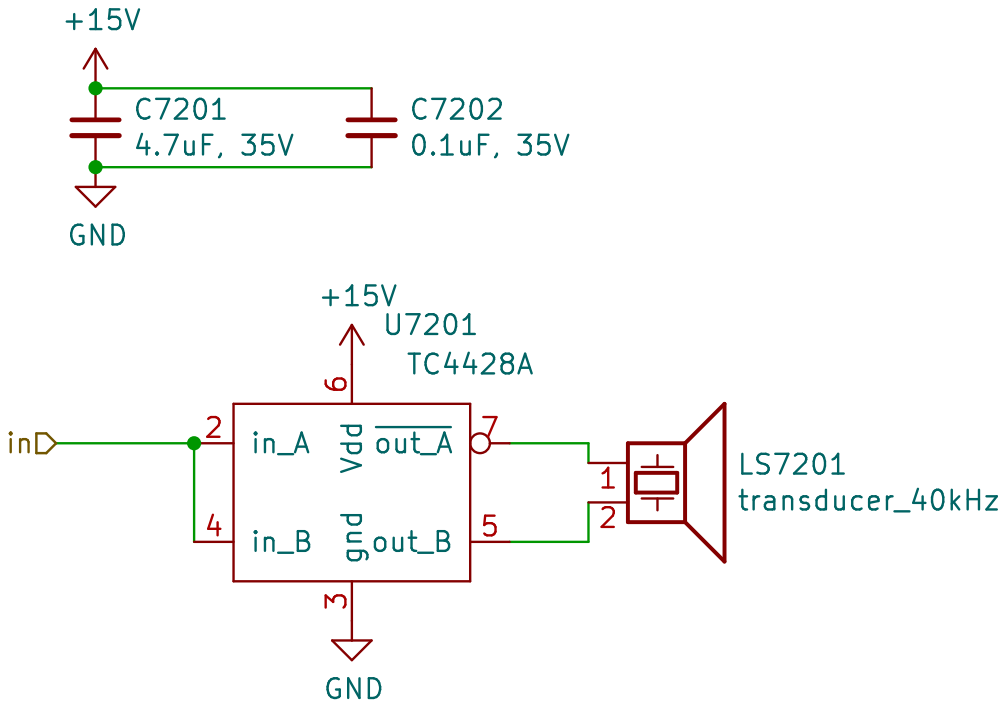
[picture p84: page 71]

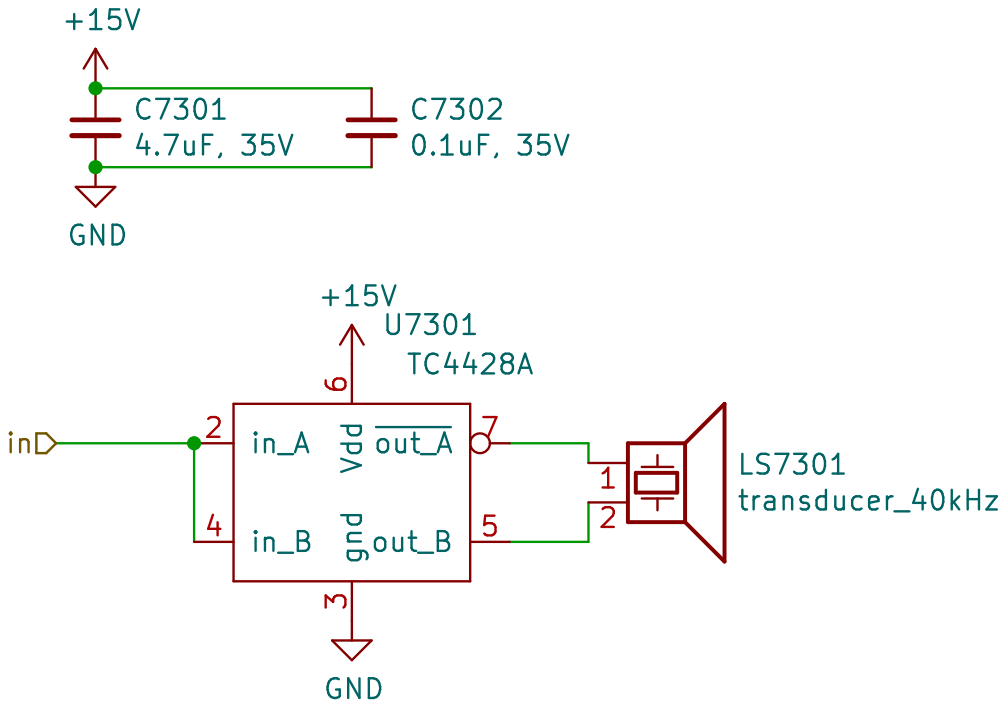
[picture p85: page 72]

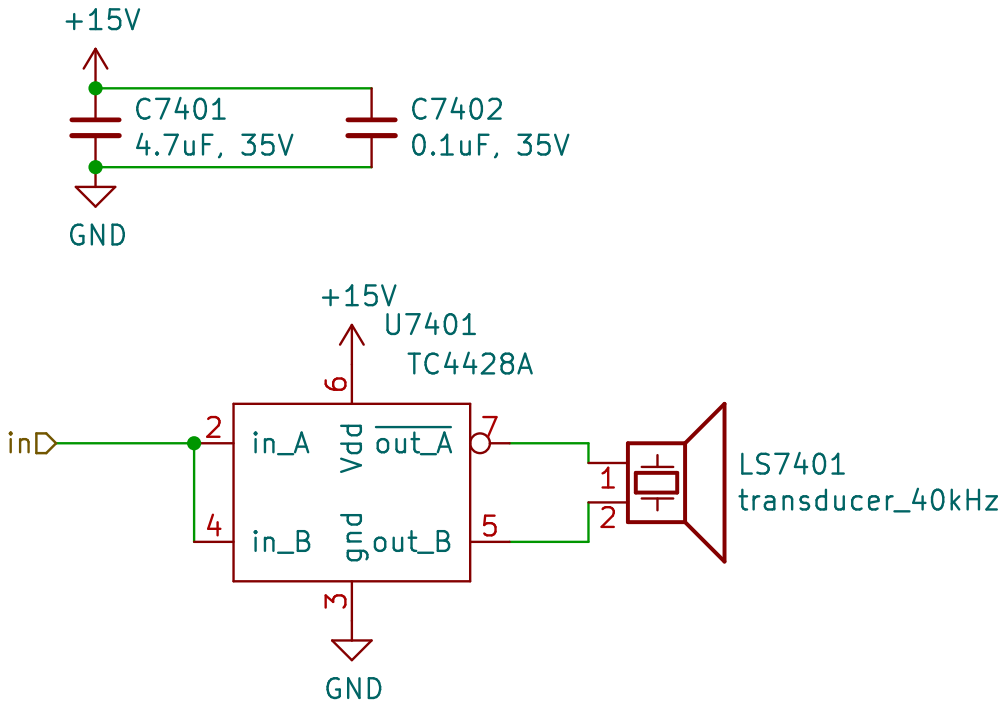
[picture p86: page 73]

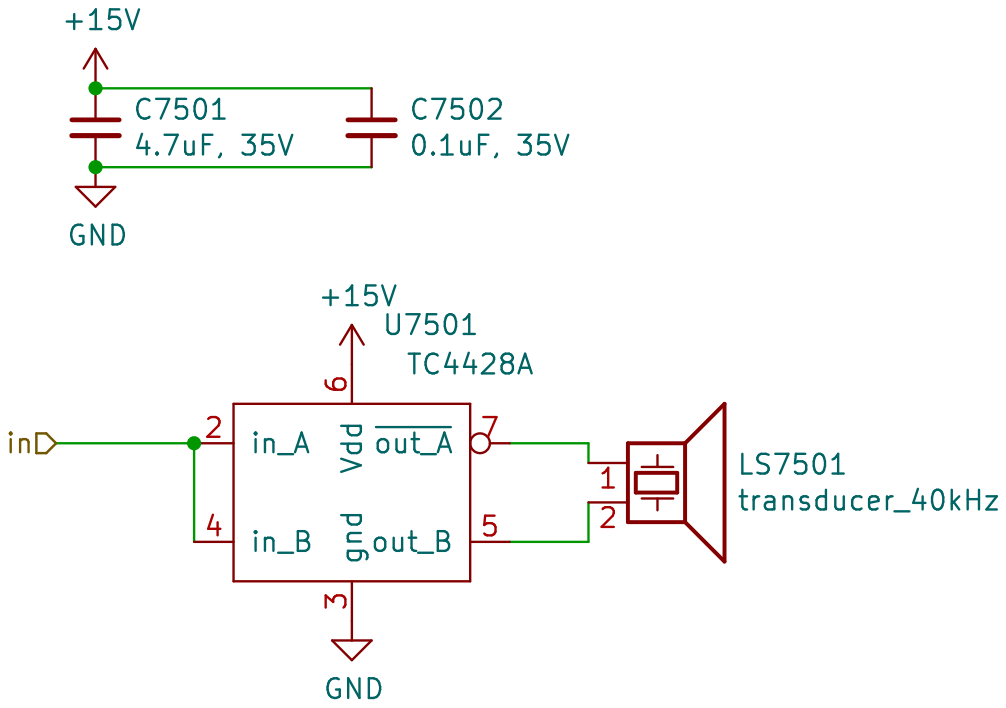
[picture p87: page 74]

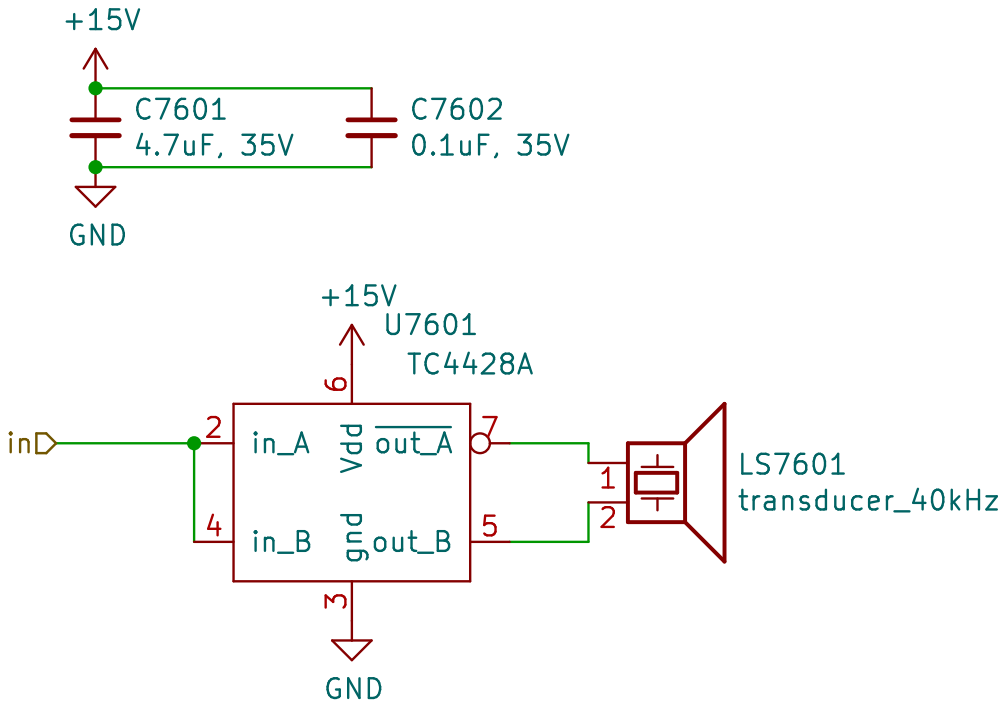
[picture p88: page 75]

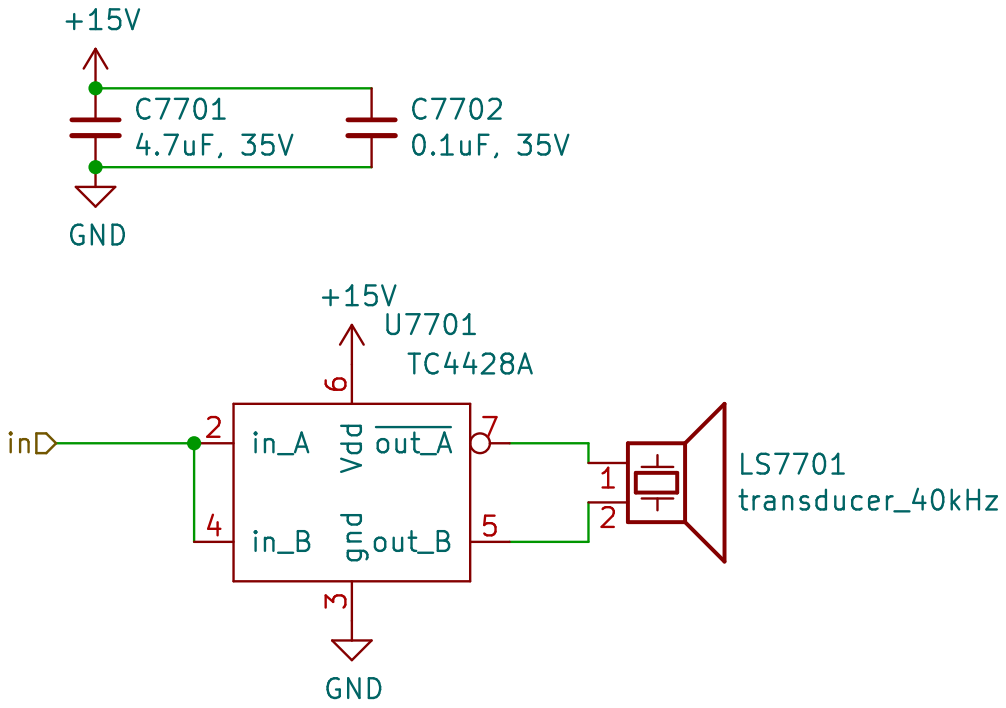
[picture p89: page 76]

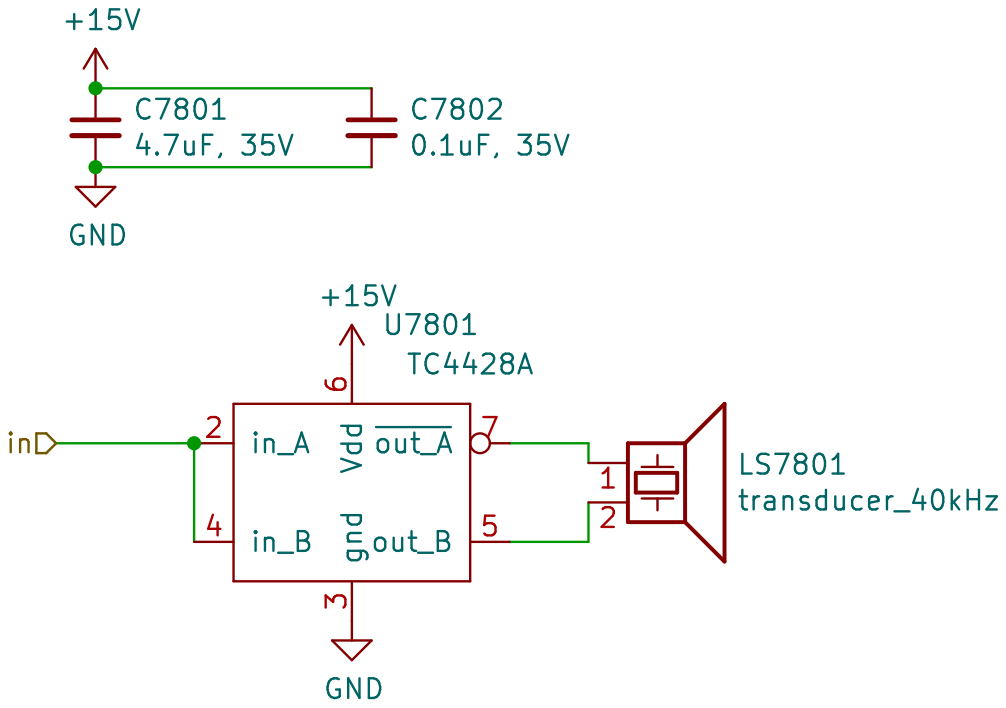
[picture p90: page 77]

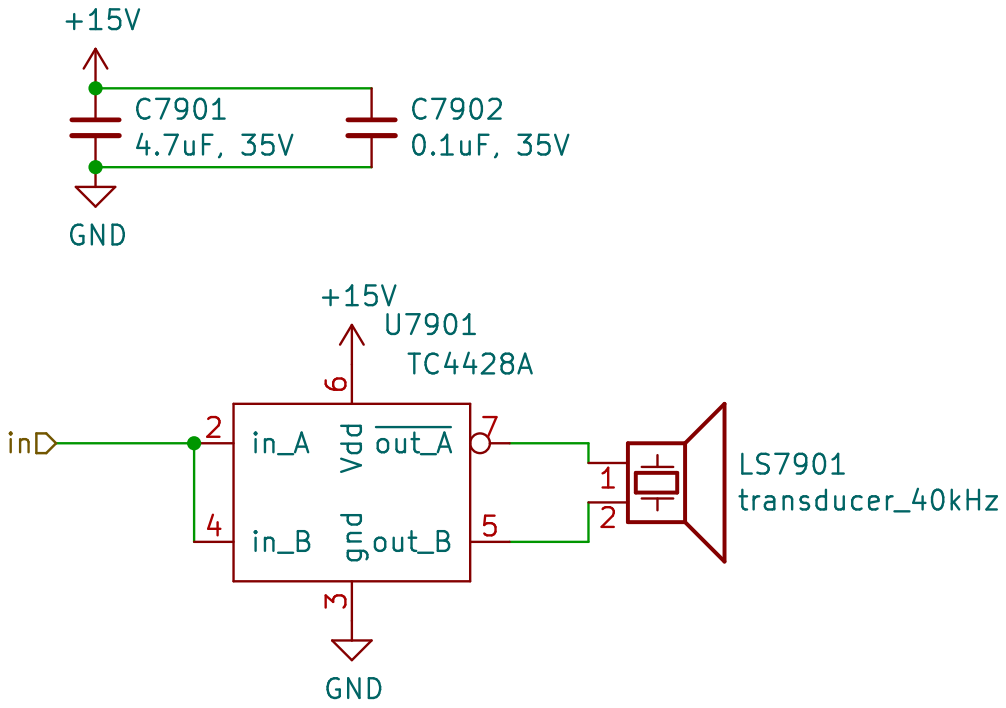
[picture p91: page 78]

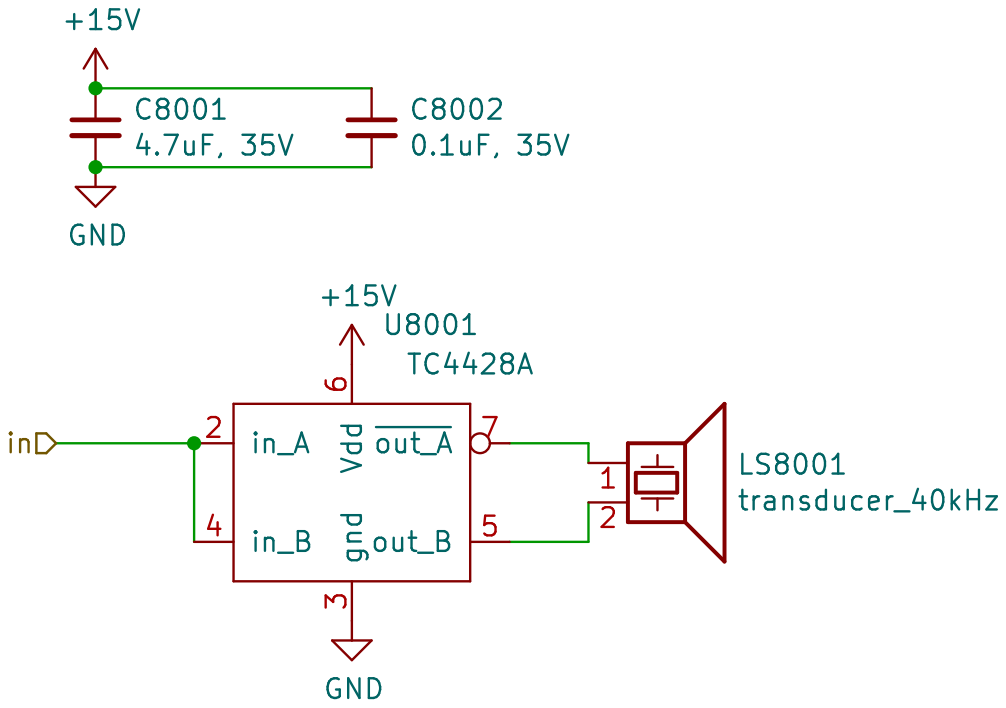
[picture p92: page 79]

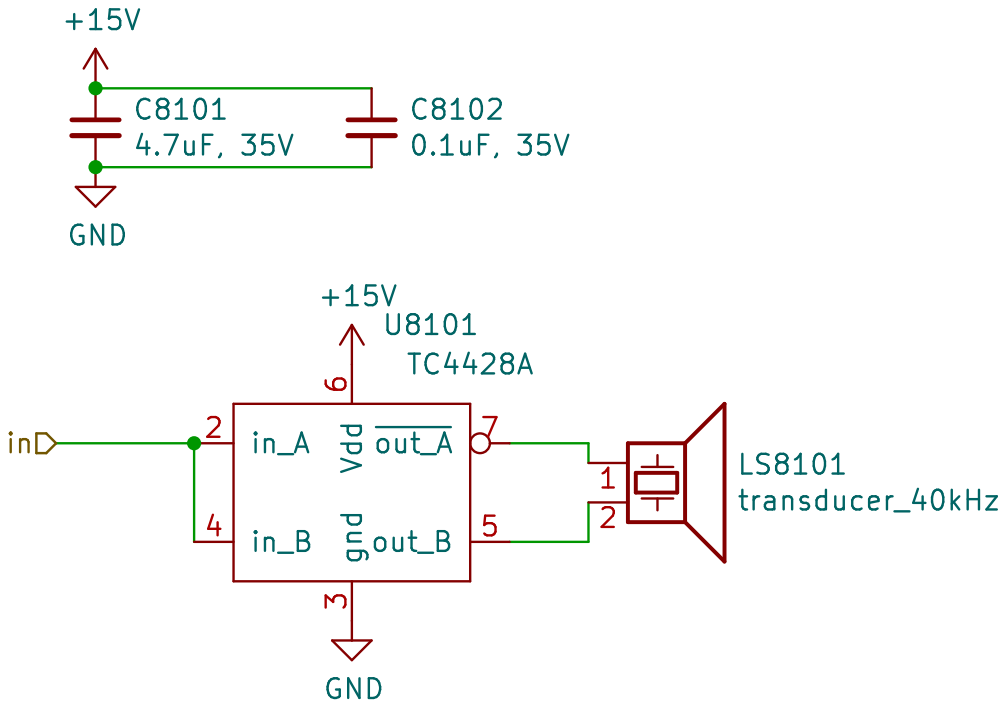
[picture p93: page 80]

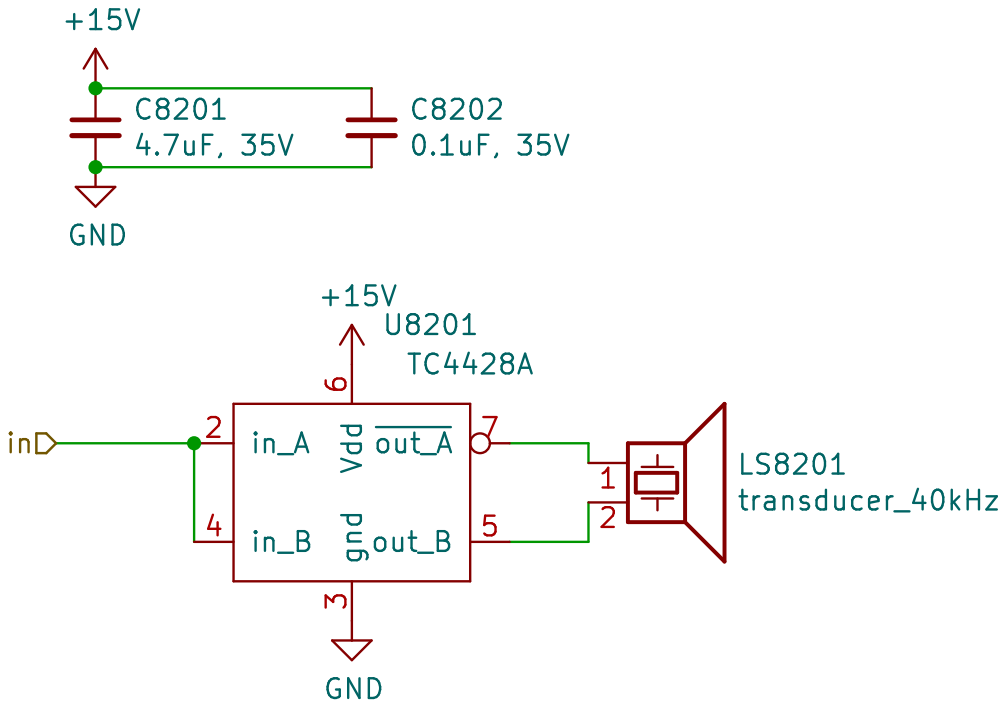
[picture p94: page 81]

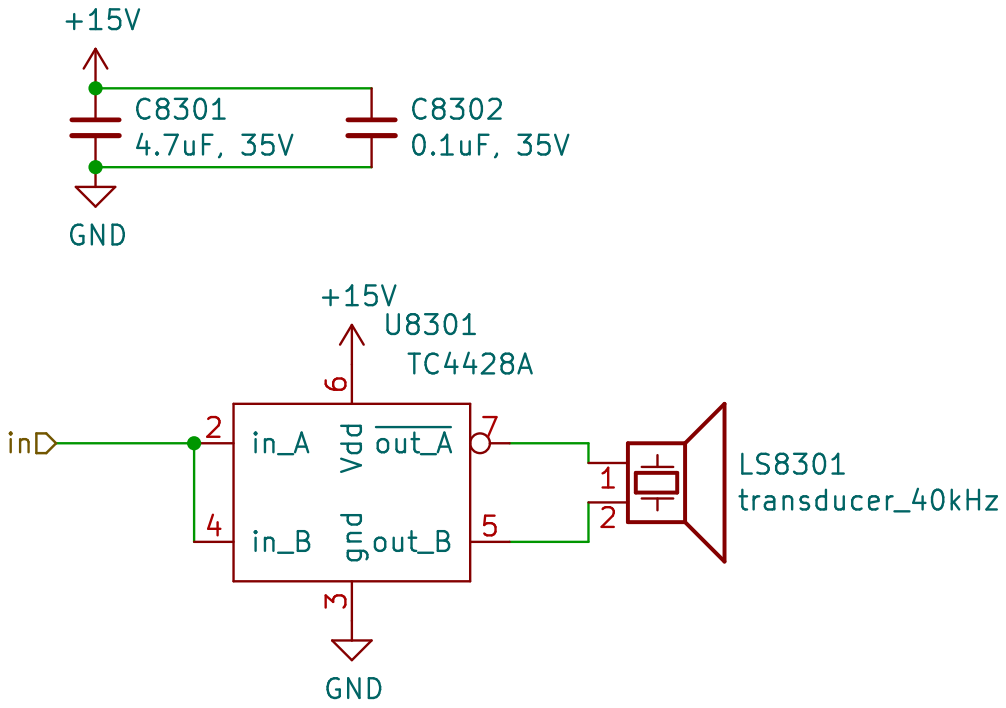
[picture p95: page 82]

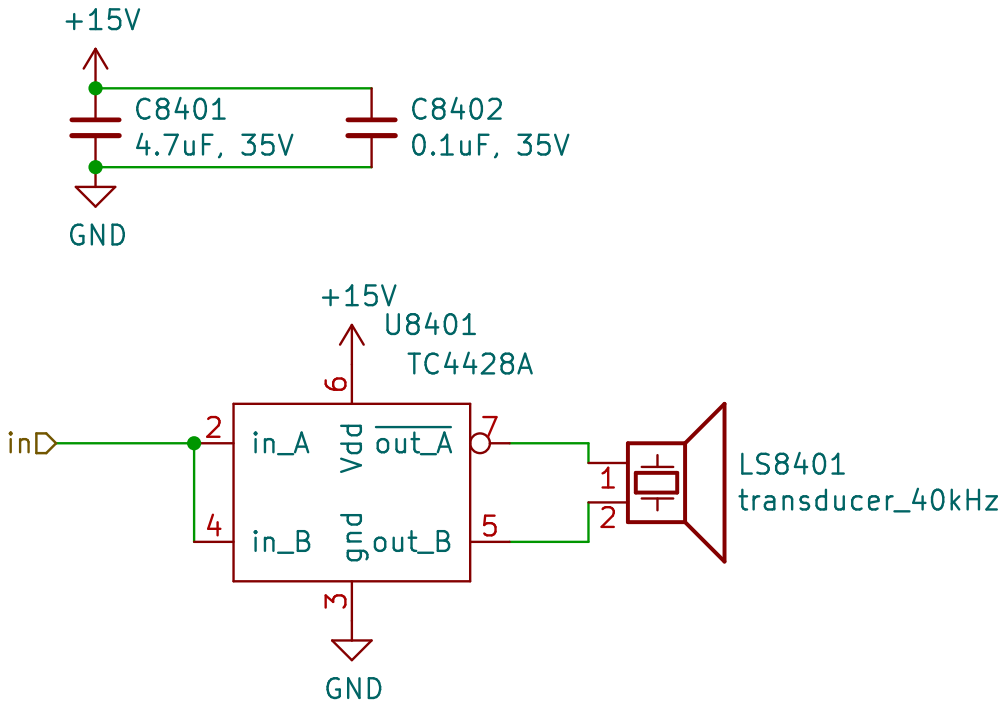
[picture p96: page 83]

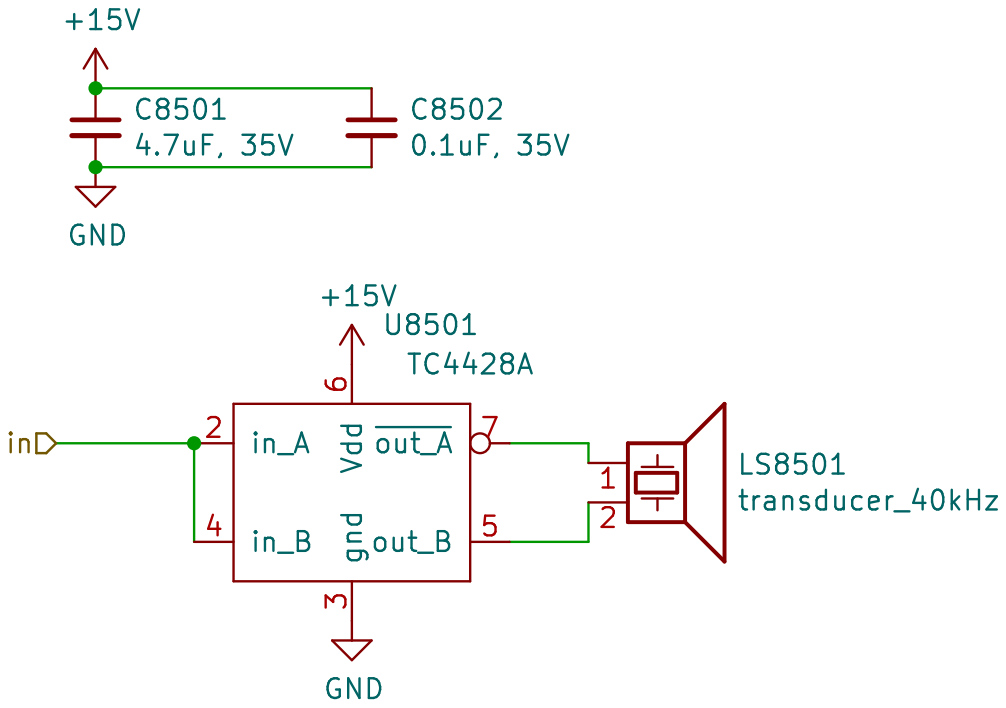
[picture p97: page 84]

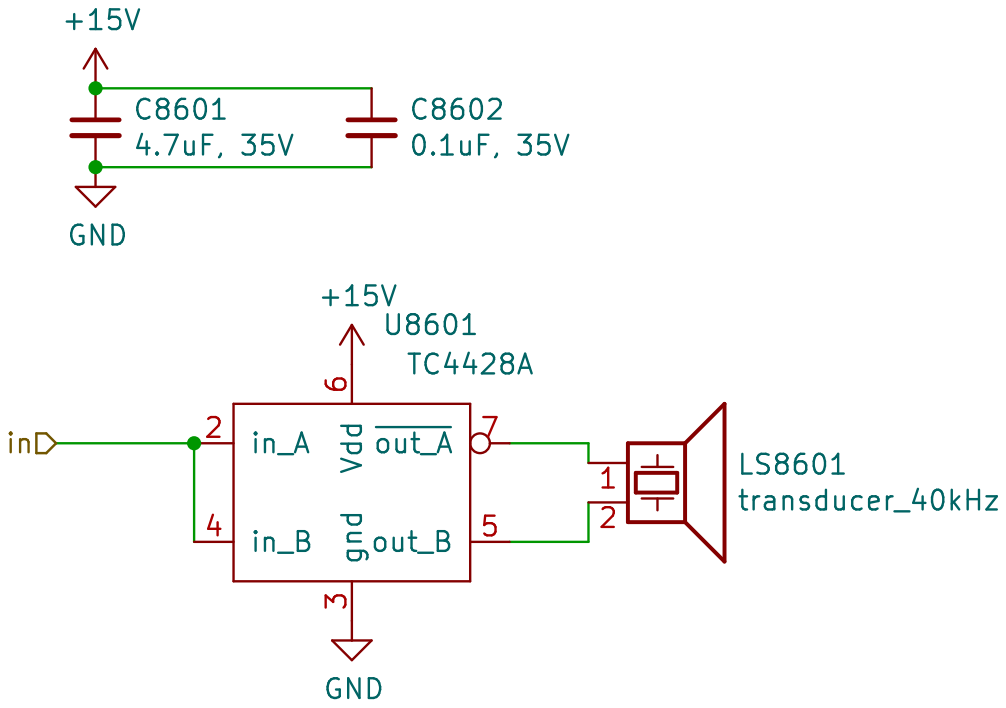
[picture p98: page 85]

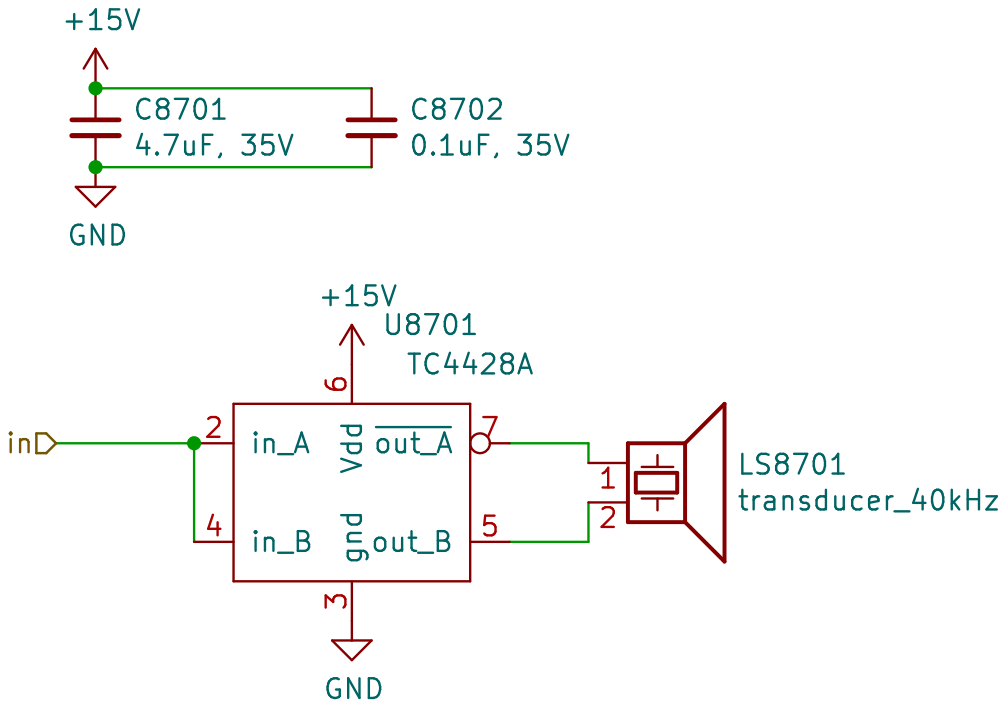
[picture p99: page 86]

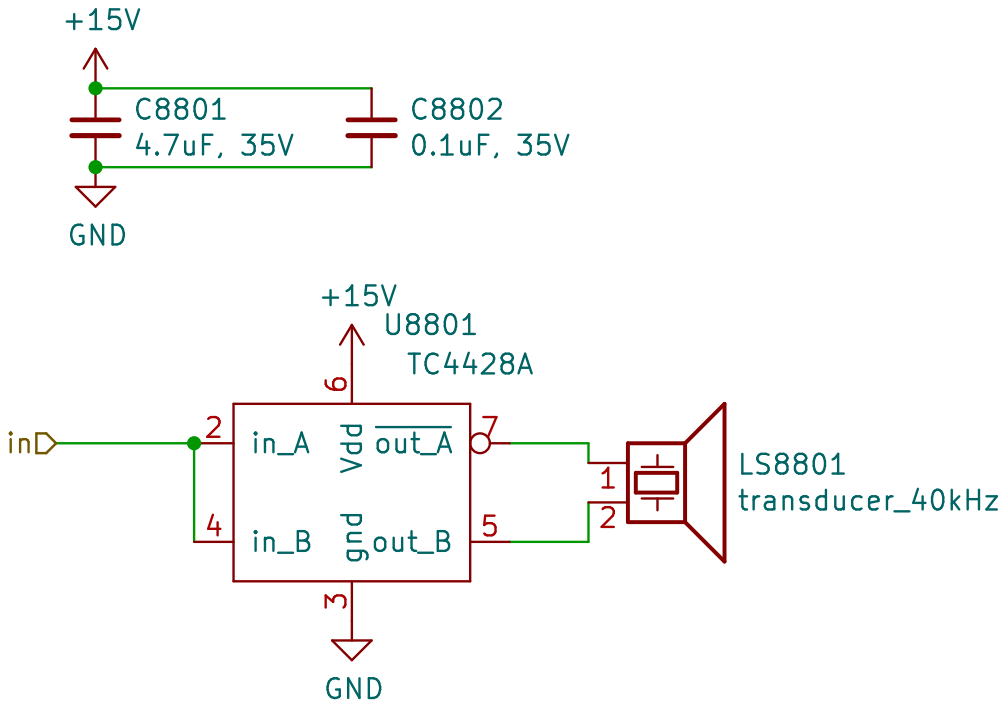
[picture p100: page 87]

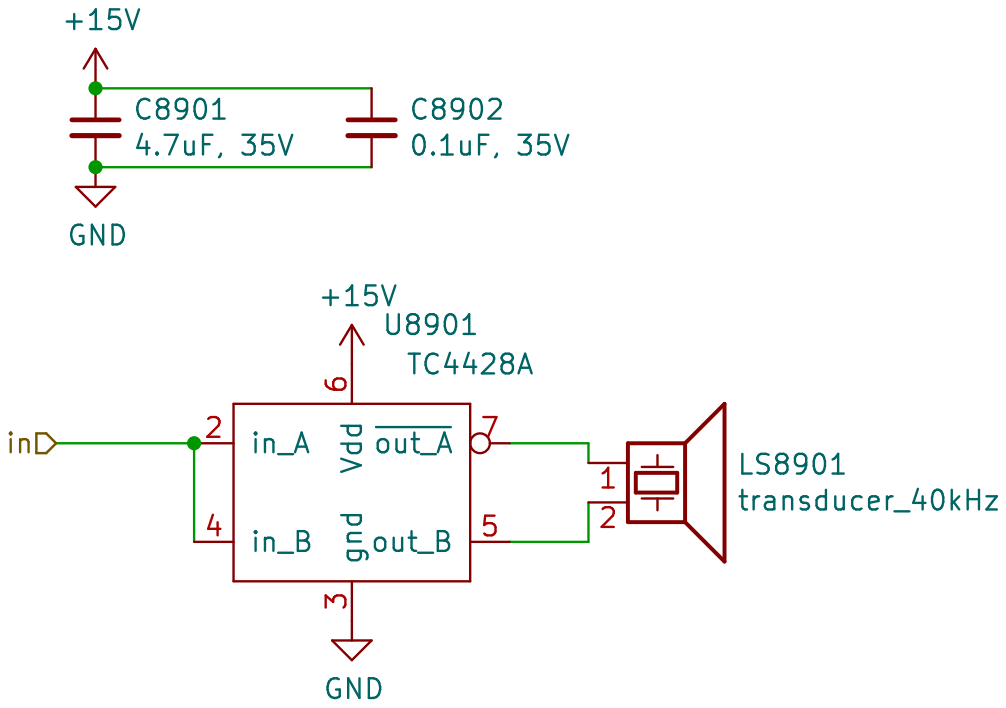
[picture p101: page 88]

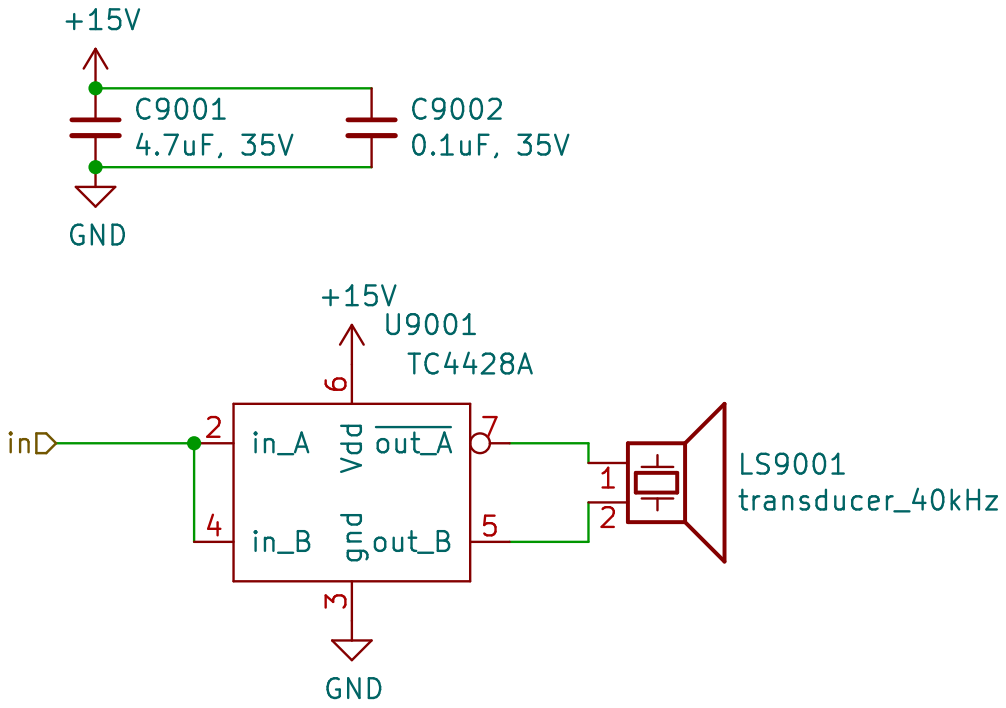
[picture p102: page 89]

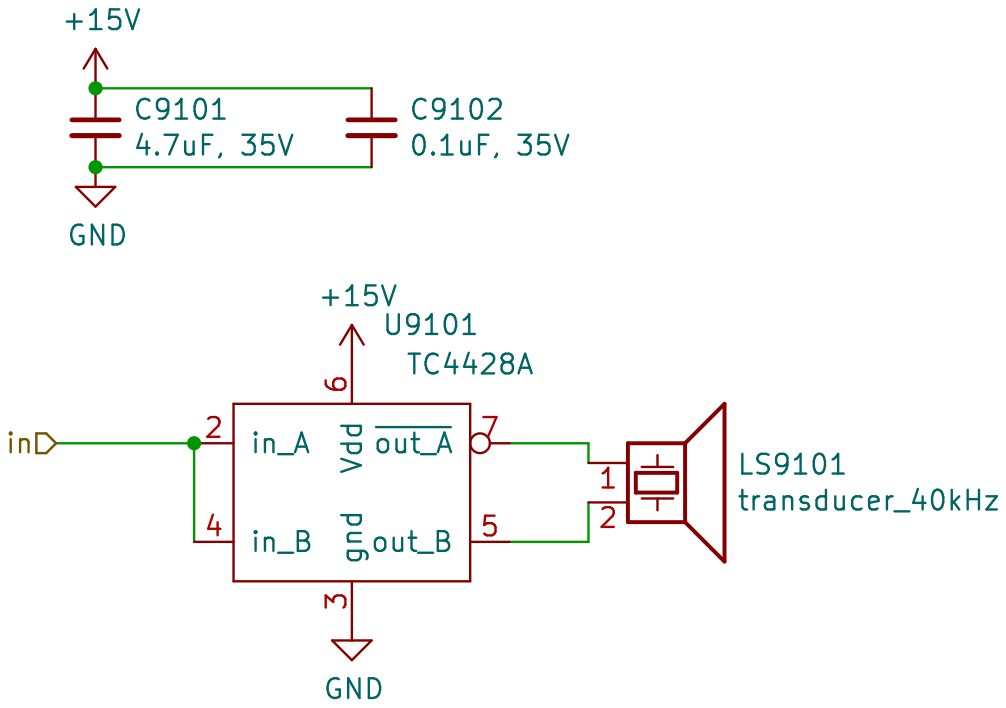
[picture p103: page 90]

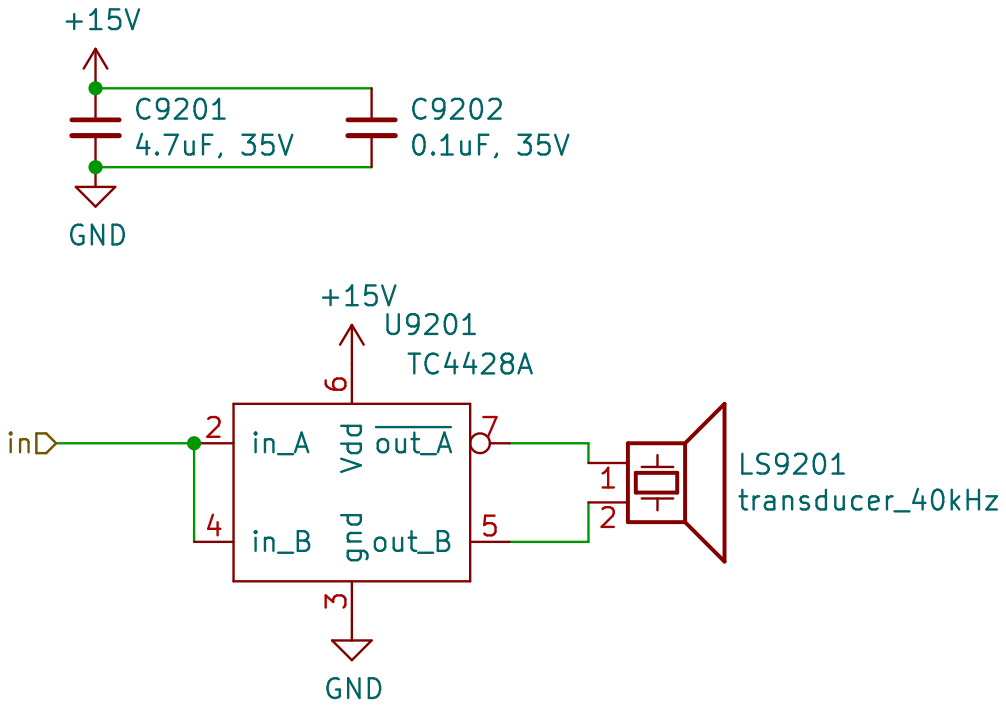
[picture p104: page 91]

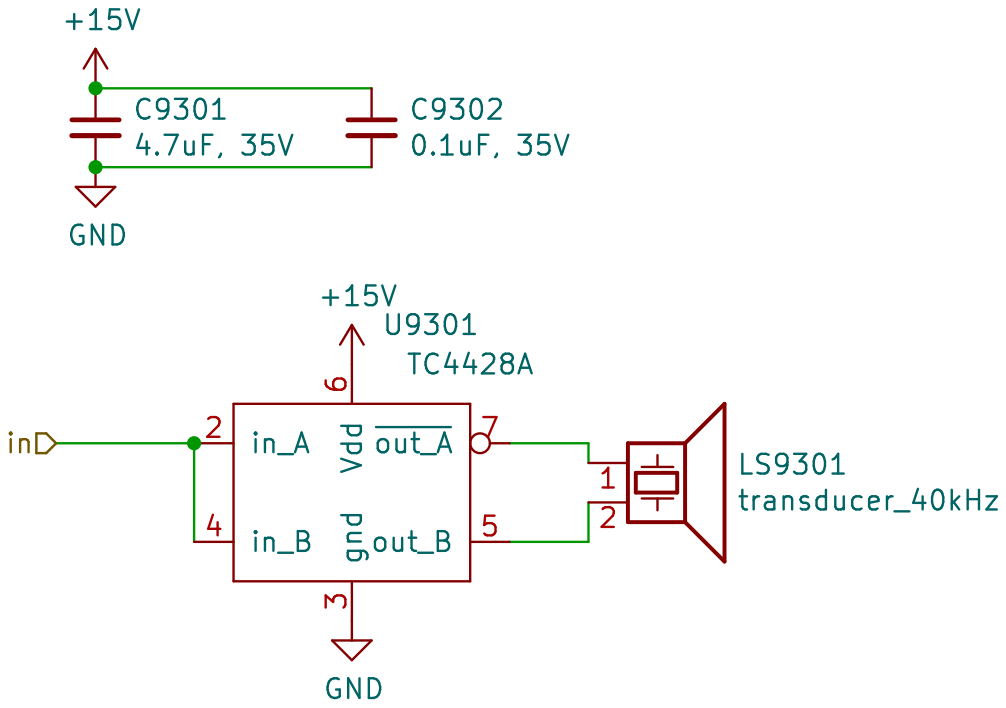
[picture p105: page 92]

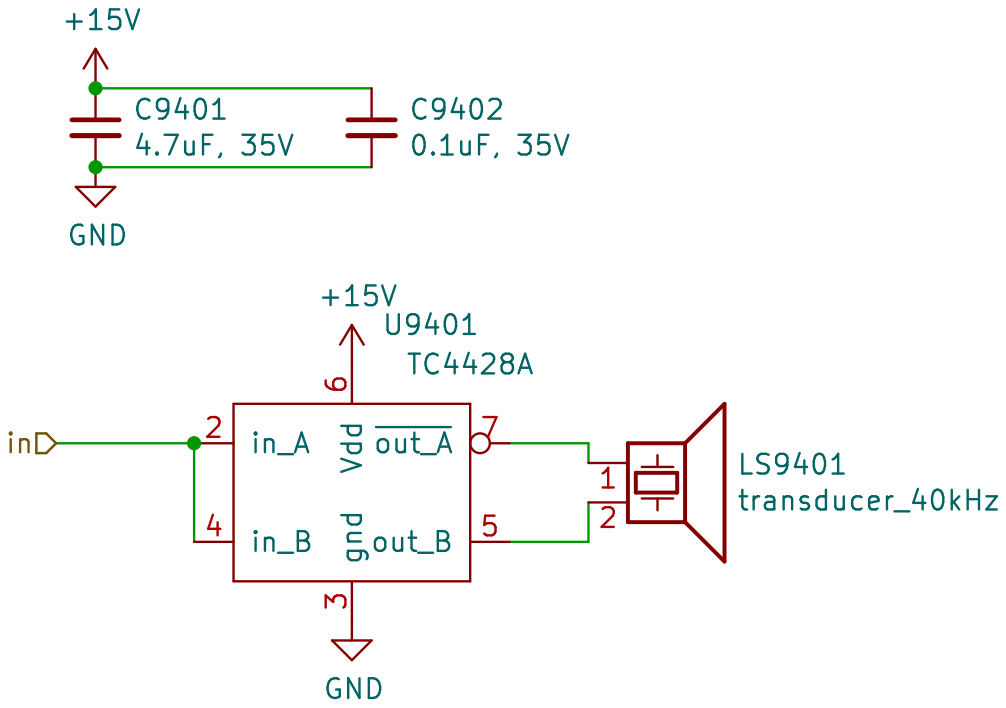
[picture p106: page 93]

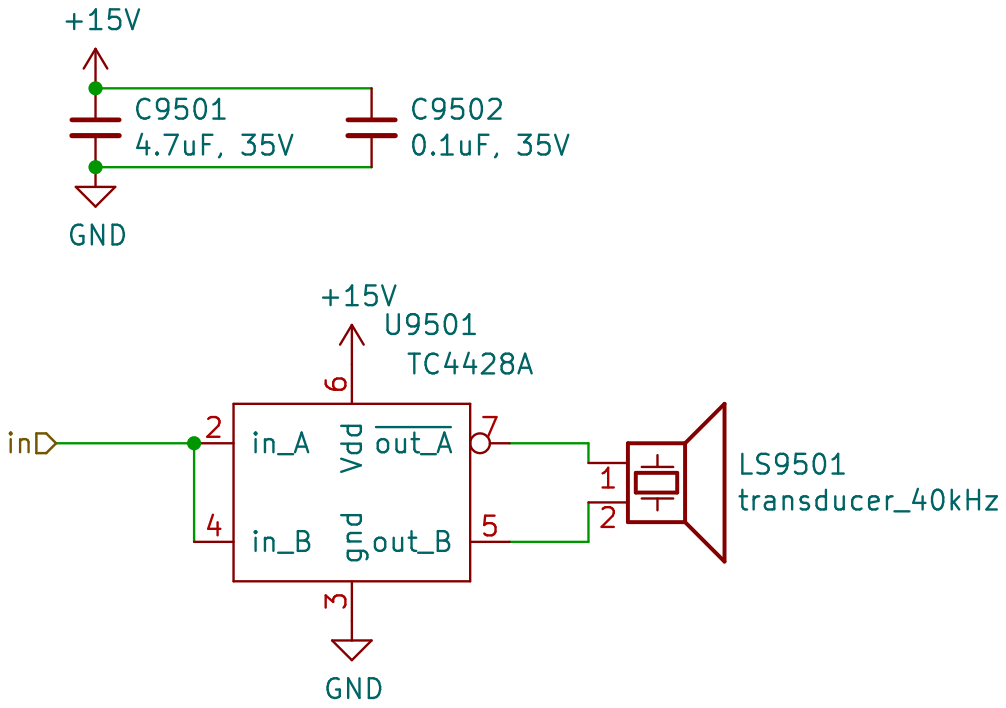
[picture p107: page 94]

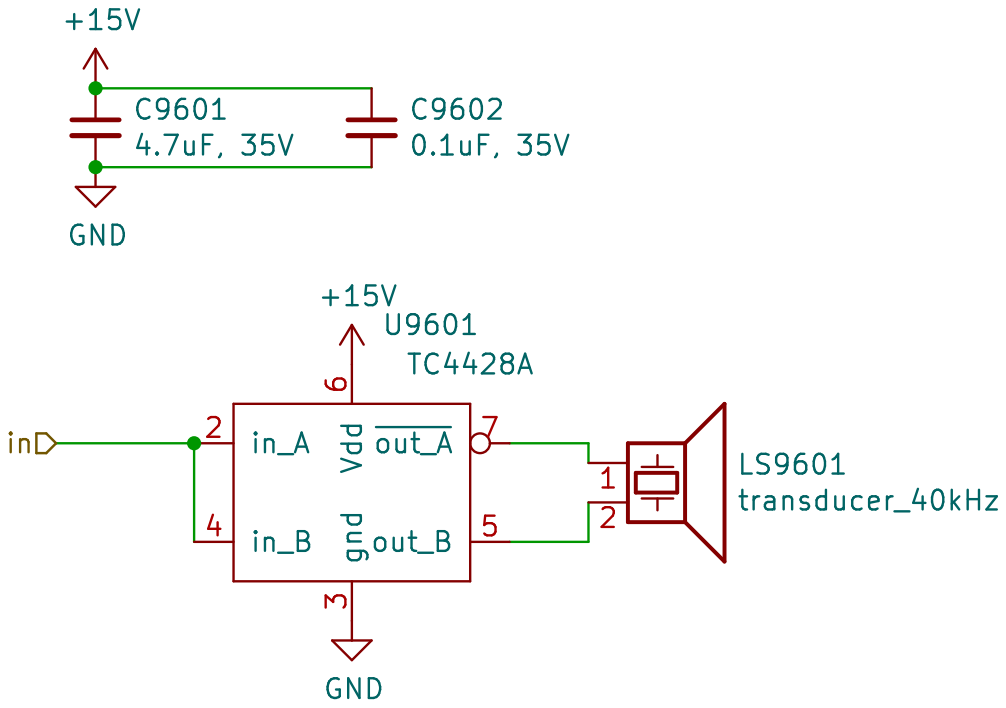
[picture p108: page 95]

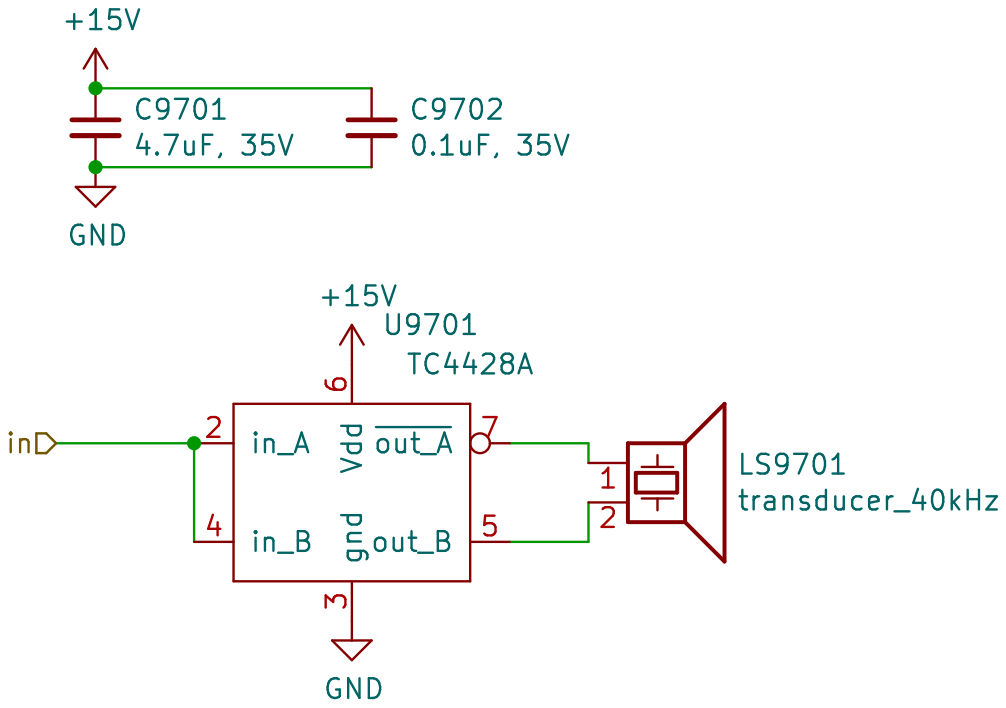
[picture p109: page 96]

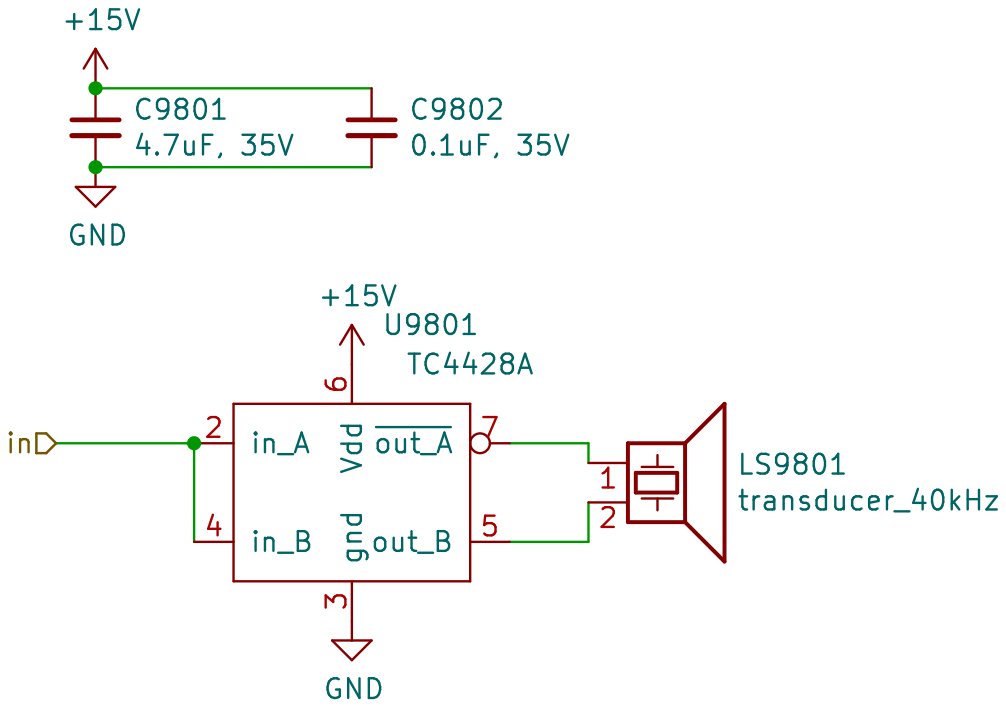
[picture p110: page 97]

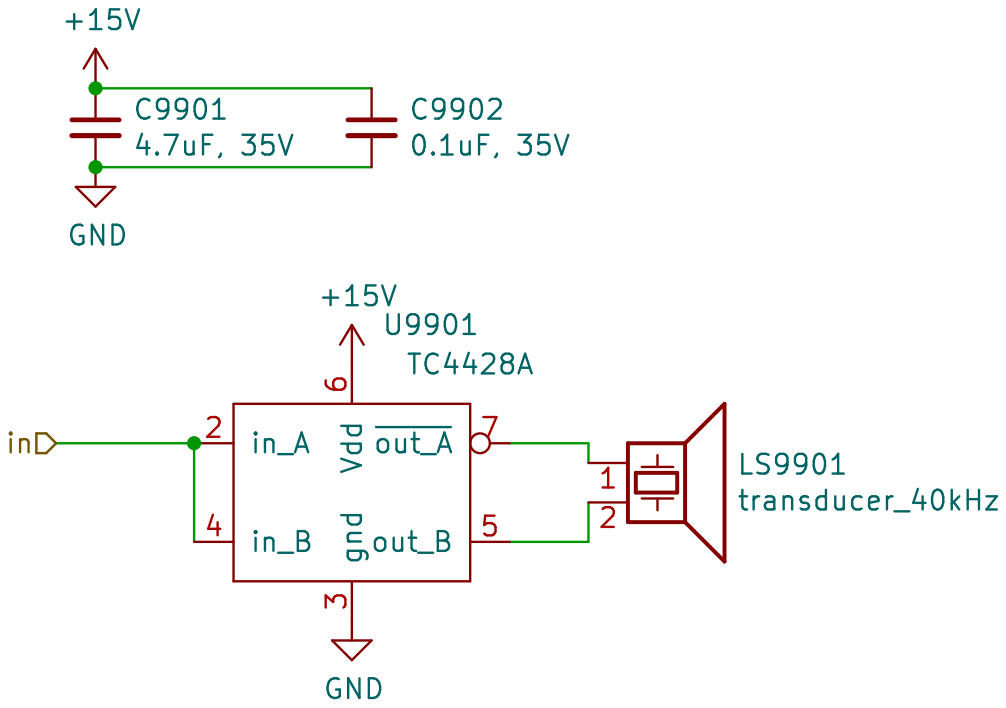
[picture p111: page 98]

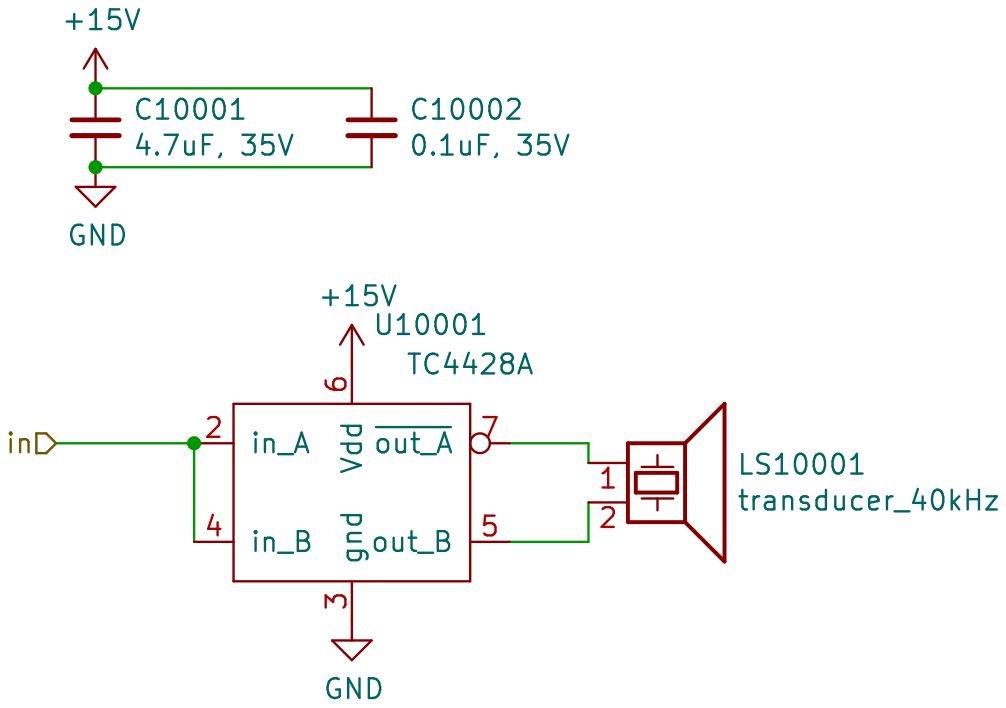
[picture p112: page 99]

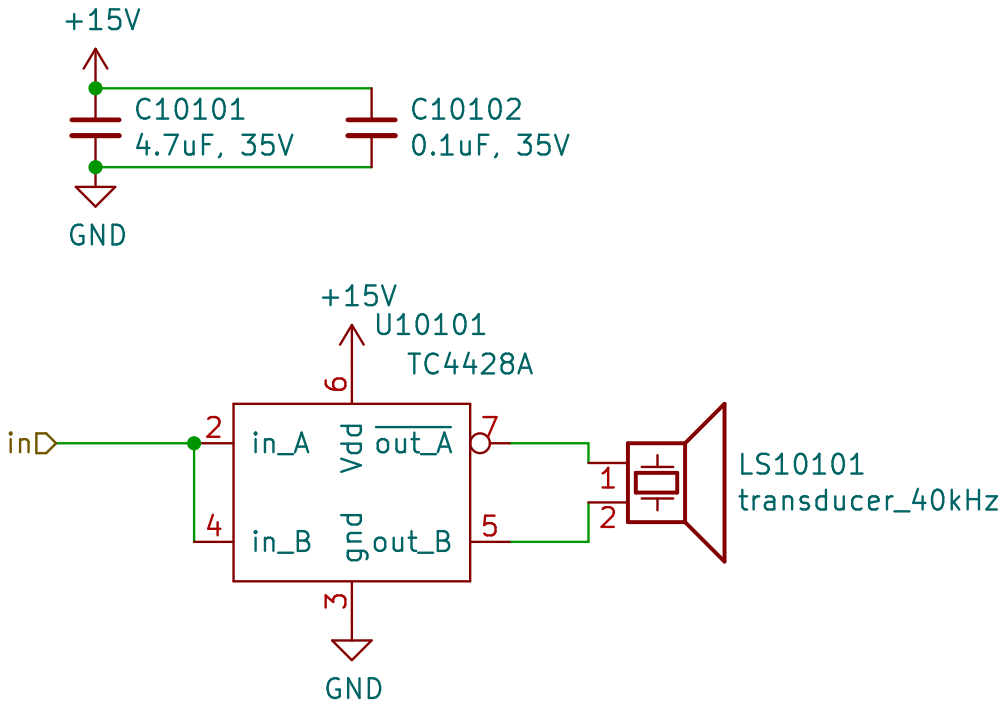
[picture p113: page 100]

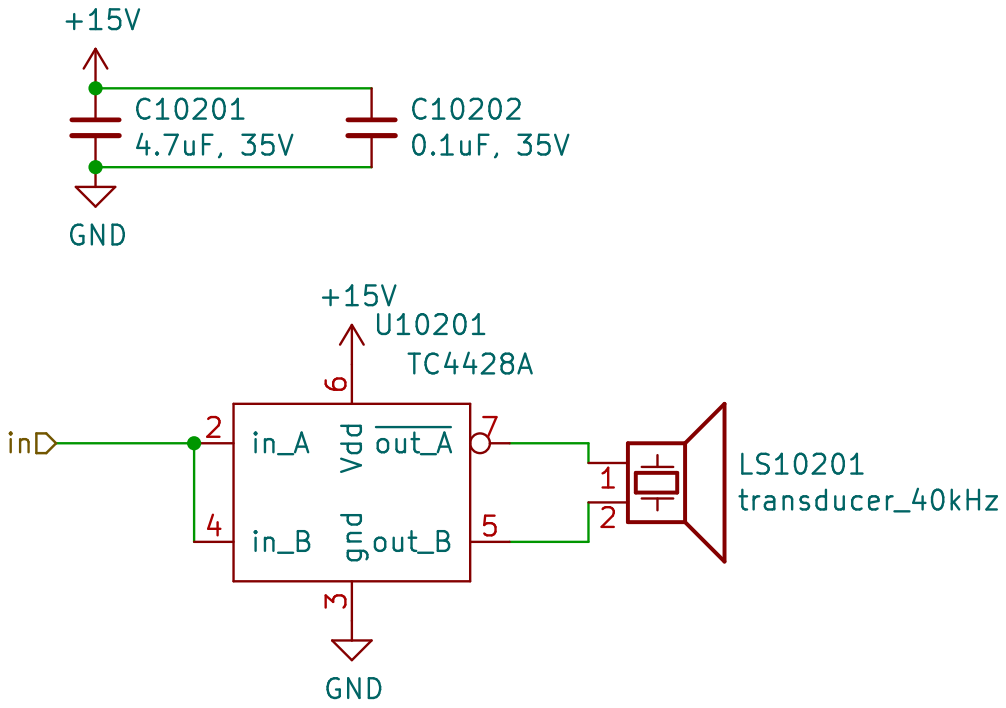
[picture p114: page 101]

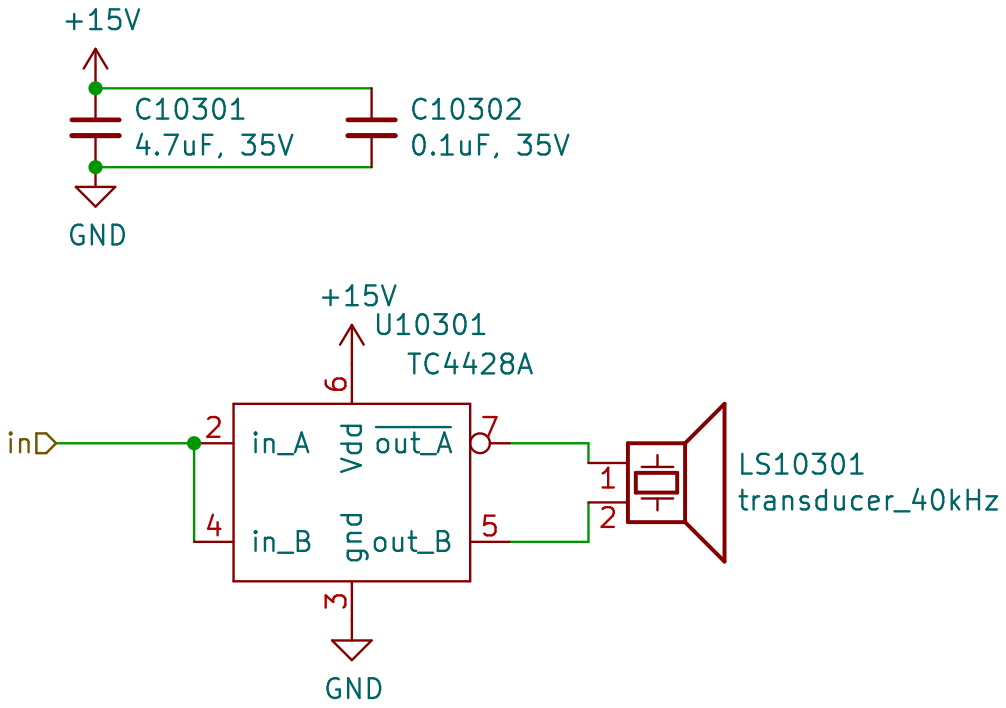
[picture p115: page 102]

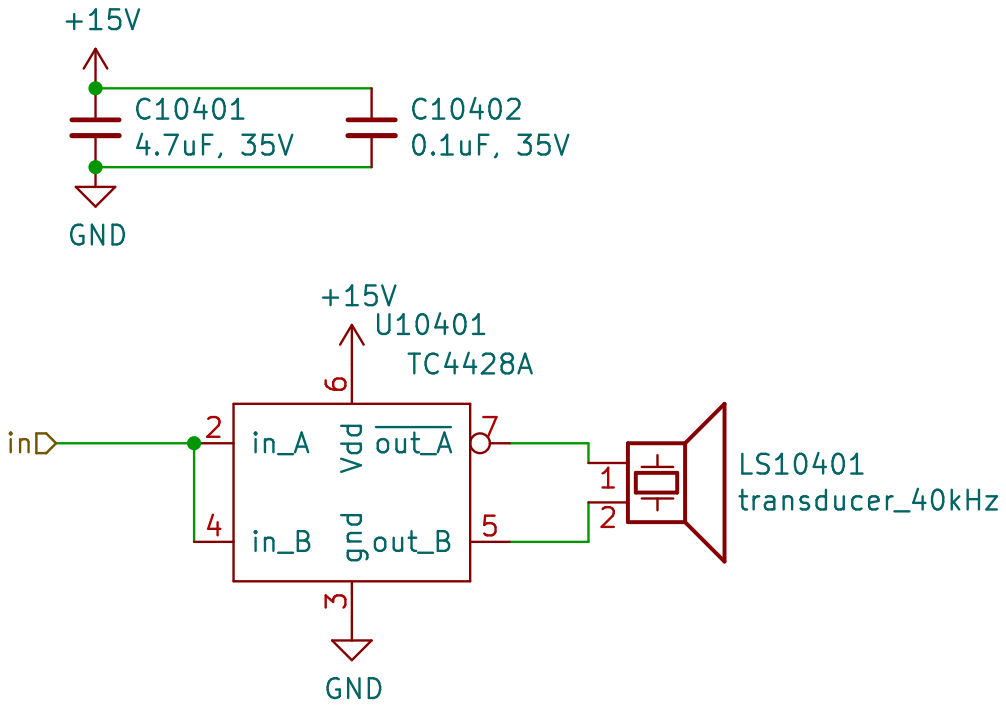
[picture p116: page 103]

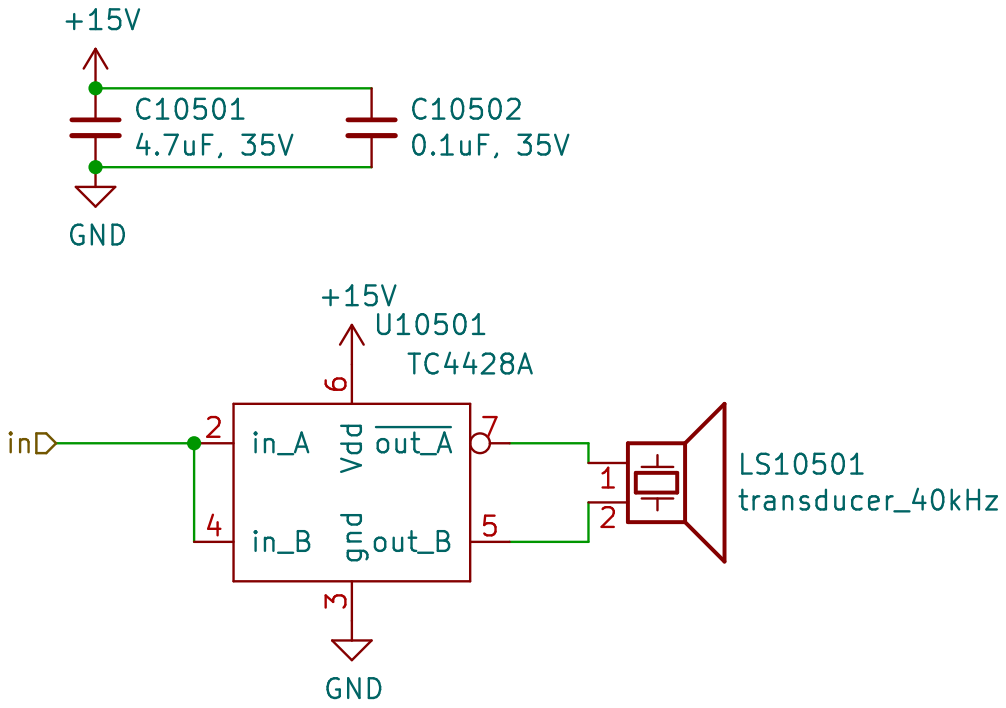
[picture p117: page 104]

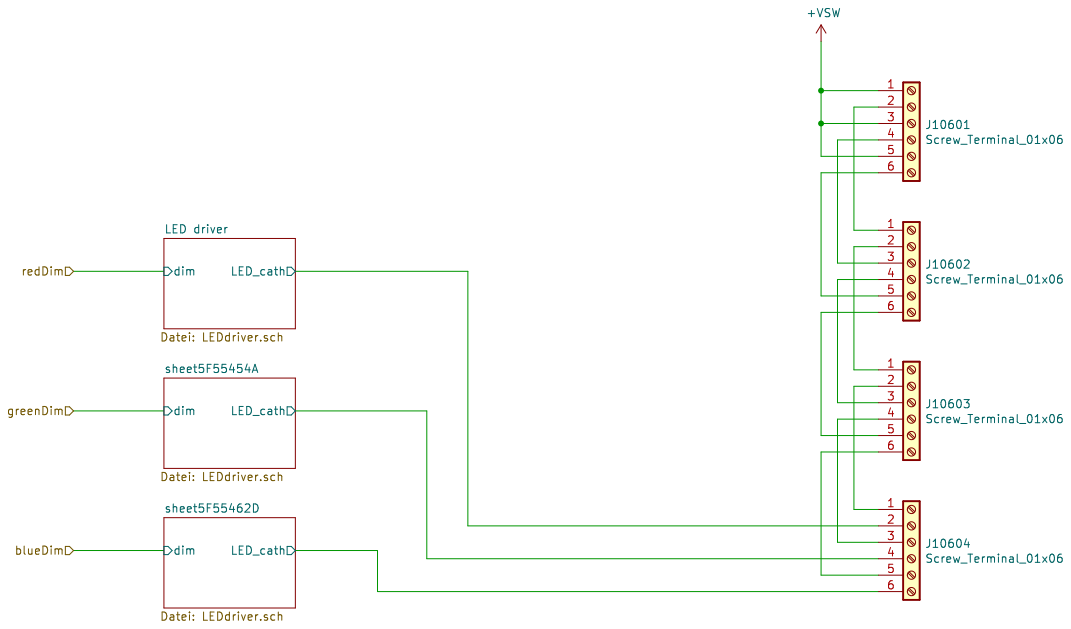
[picture p118: page 105]

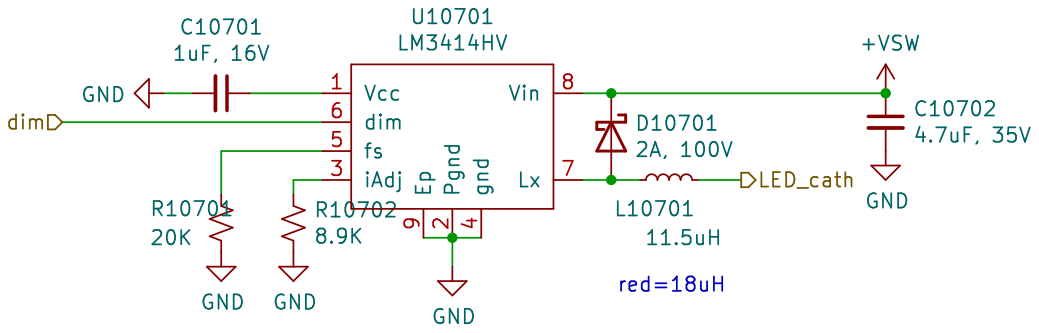
[picture p119: page 106]

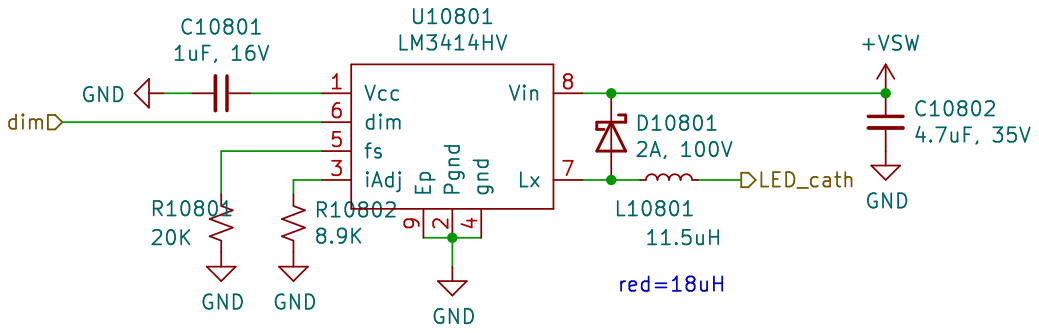
[picture p120: page 107]

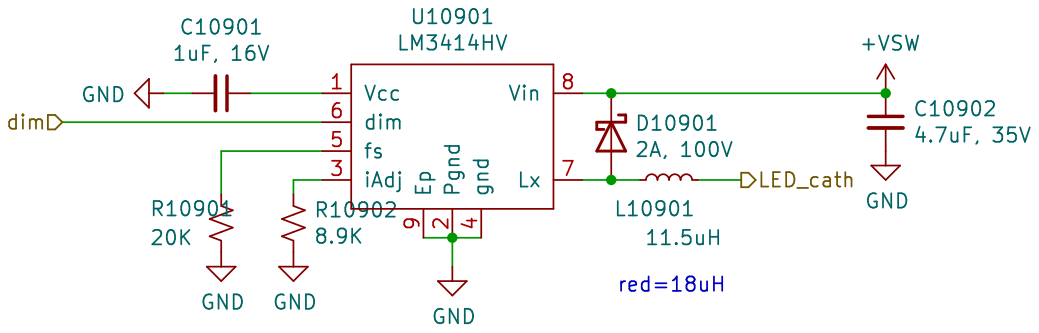
[picture p121: page 108]

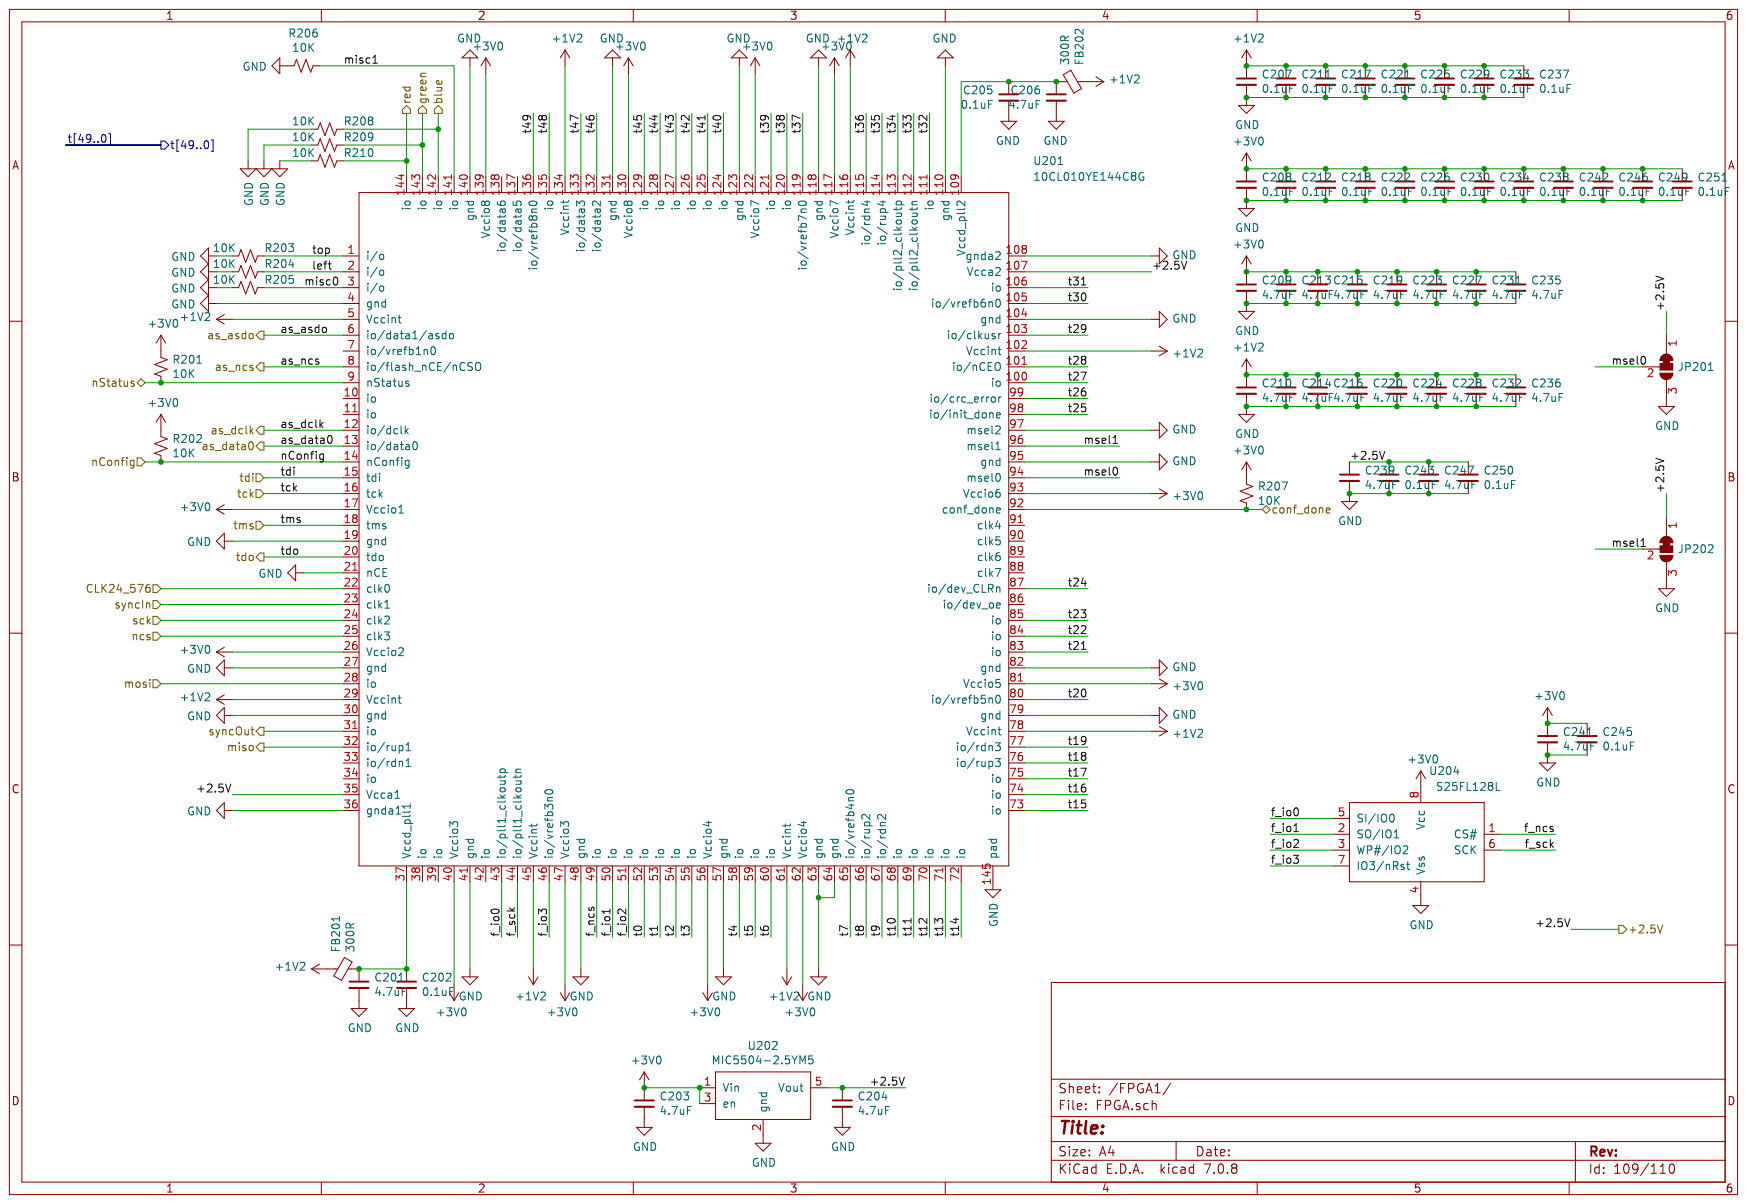
[picture p122: page 109]

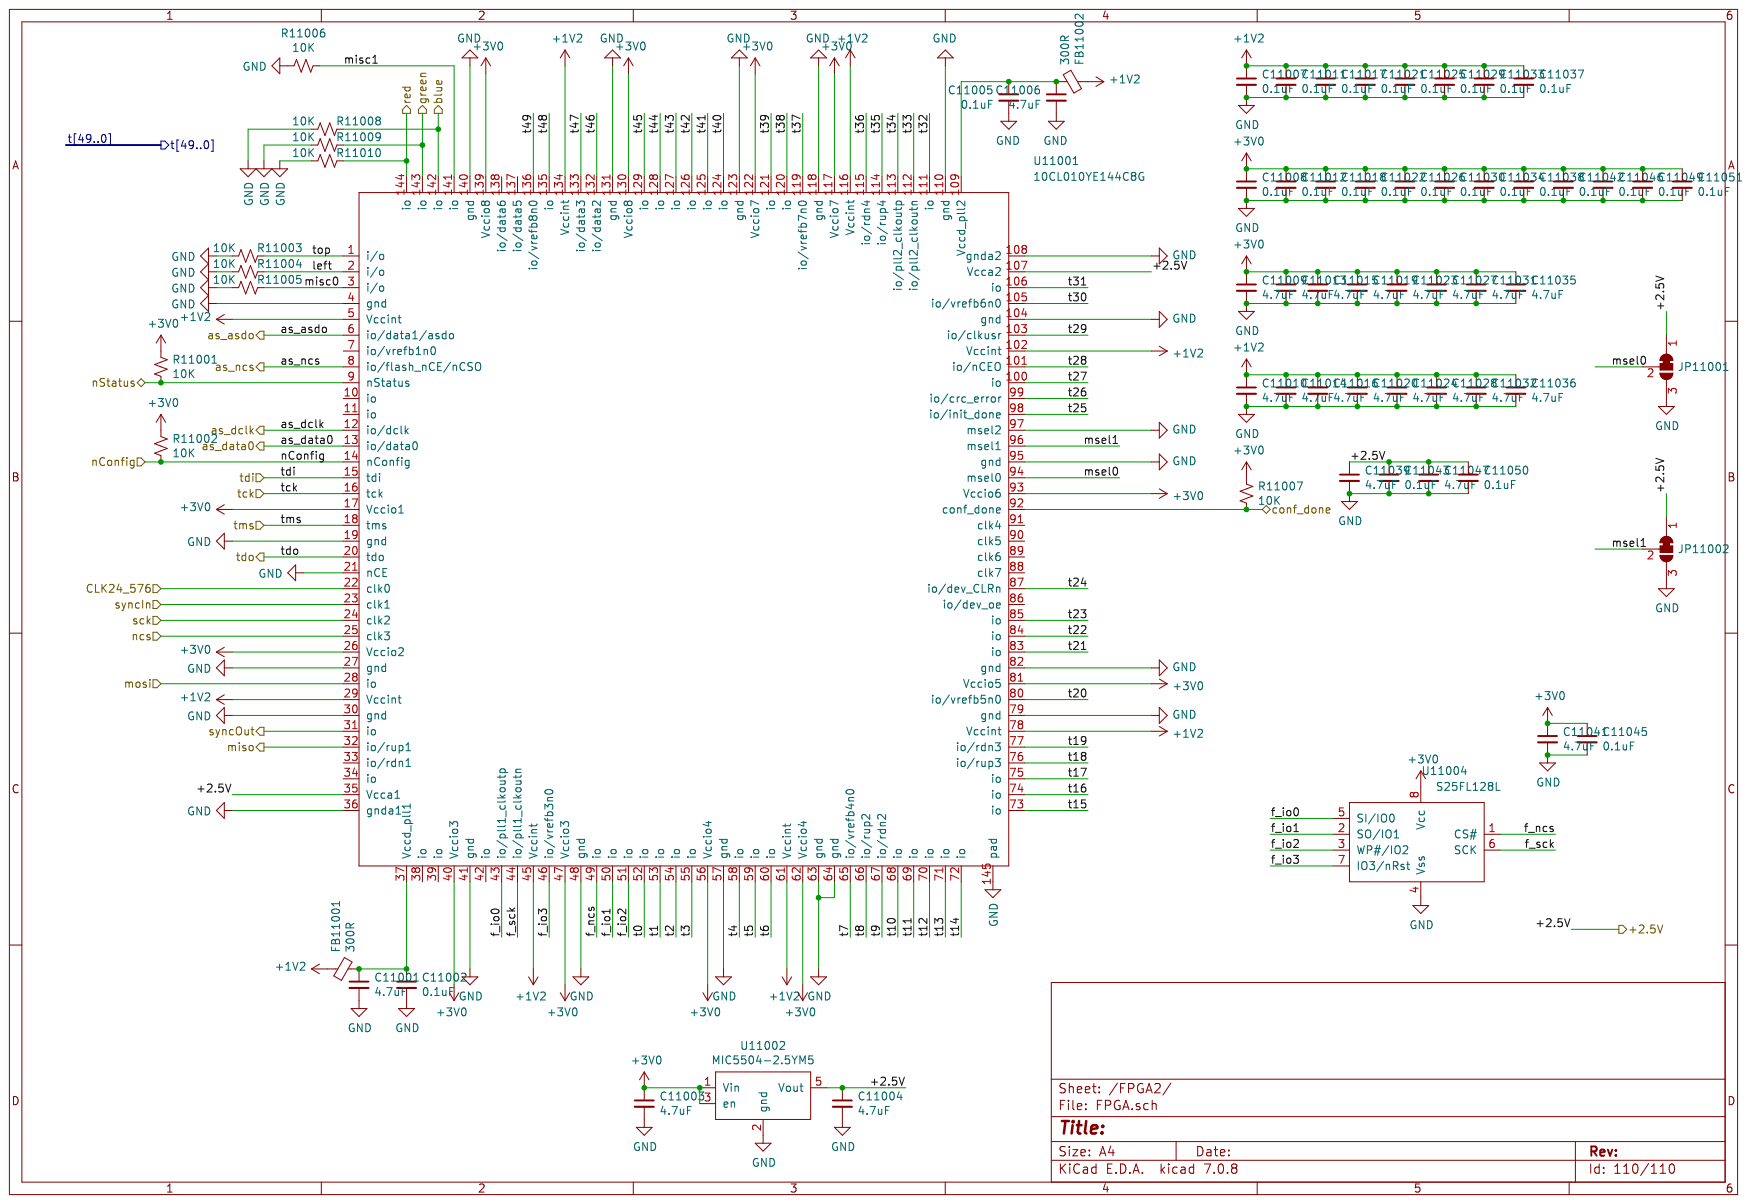
[picture p123: page 110]
