ThoMint/vdatp/board/assembly/schematic_full_sw.pdf

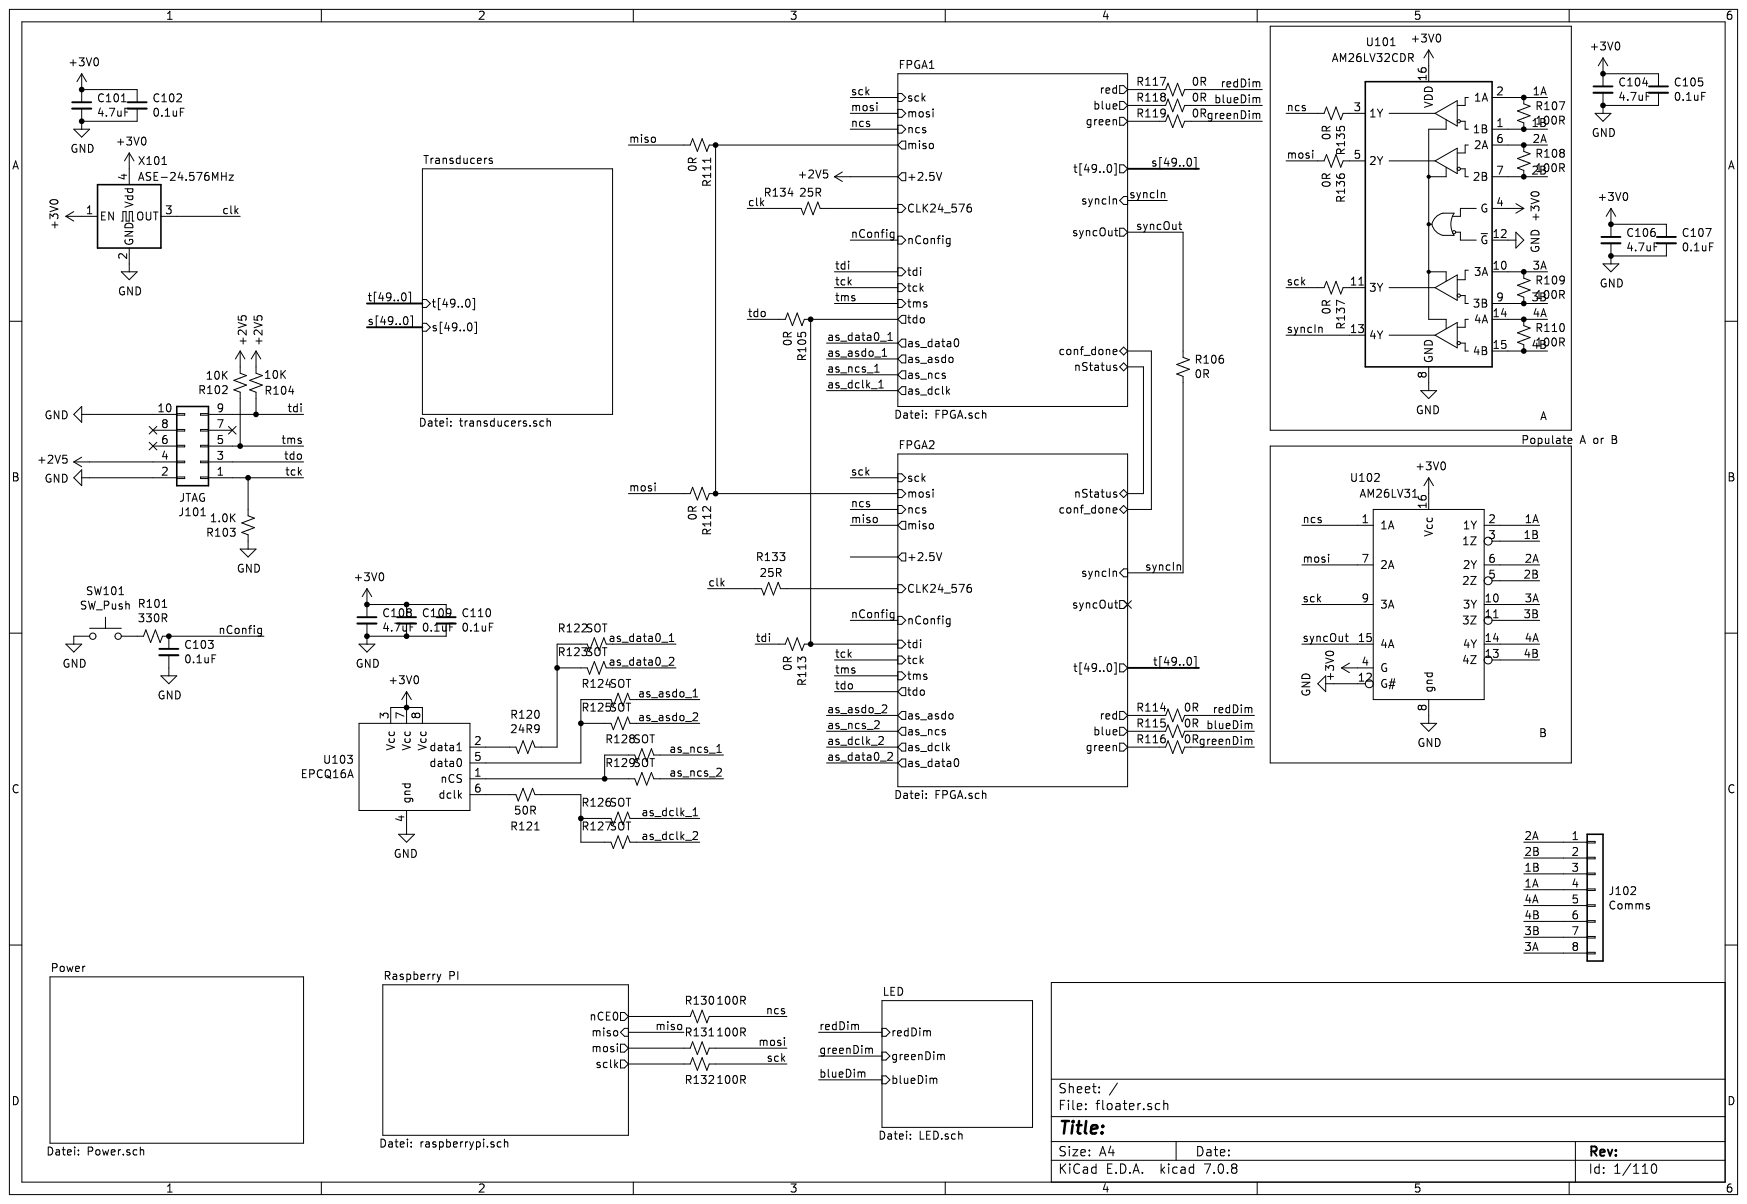
[picture p124: page 1]

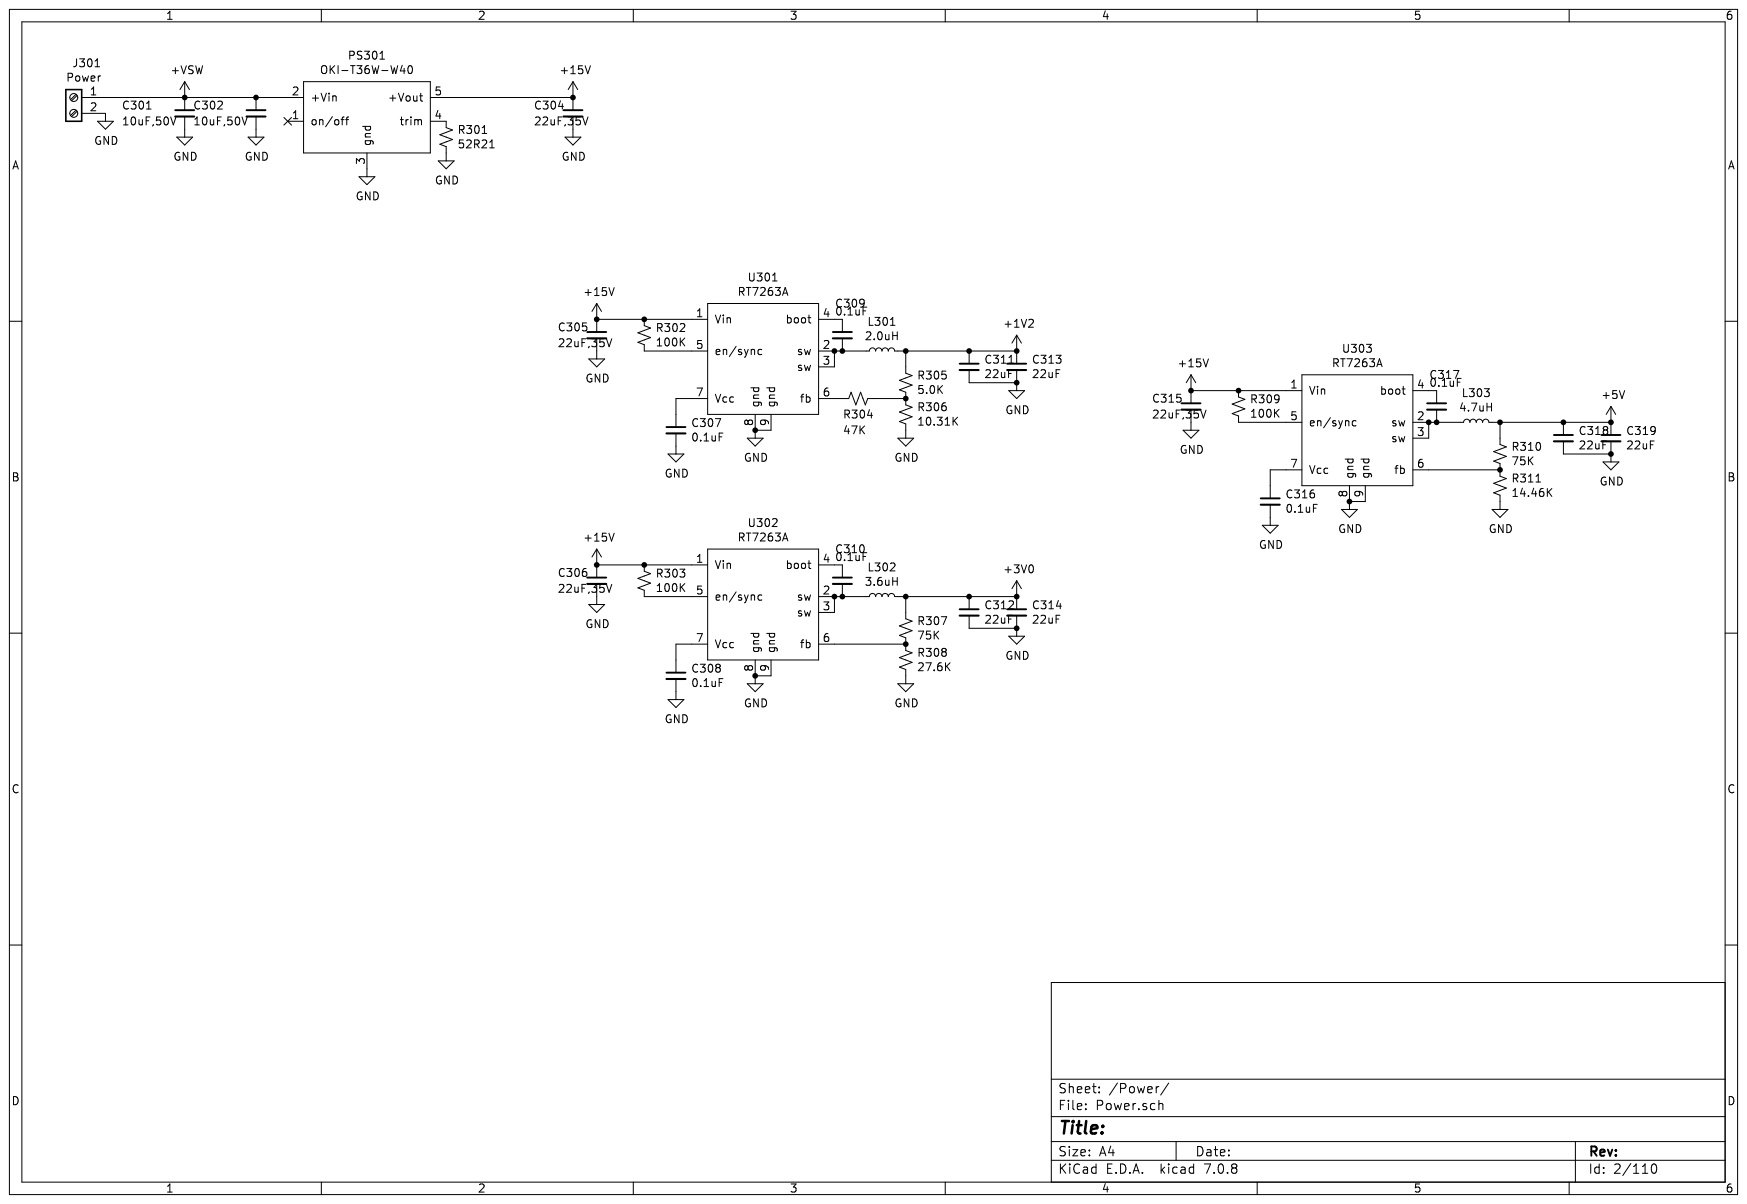
[picture p125: page 2]

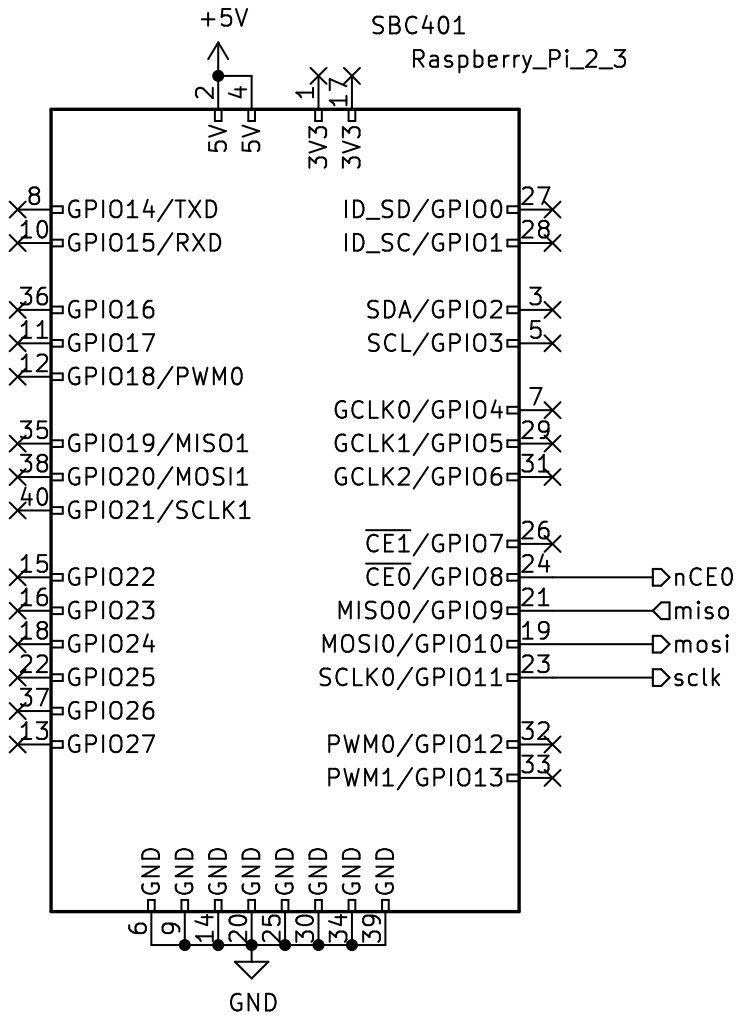
[picture p126: page 3]

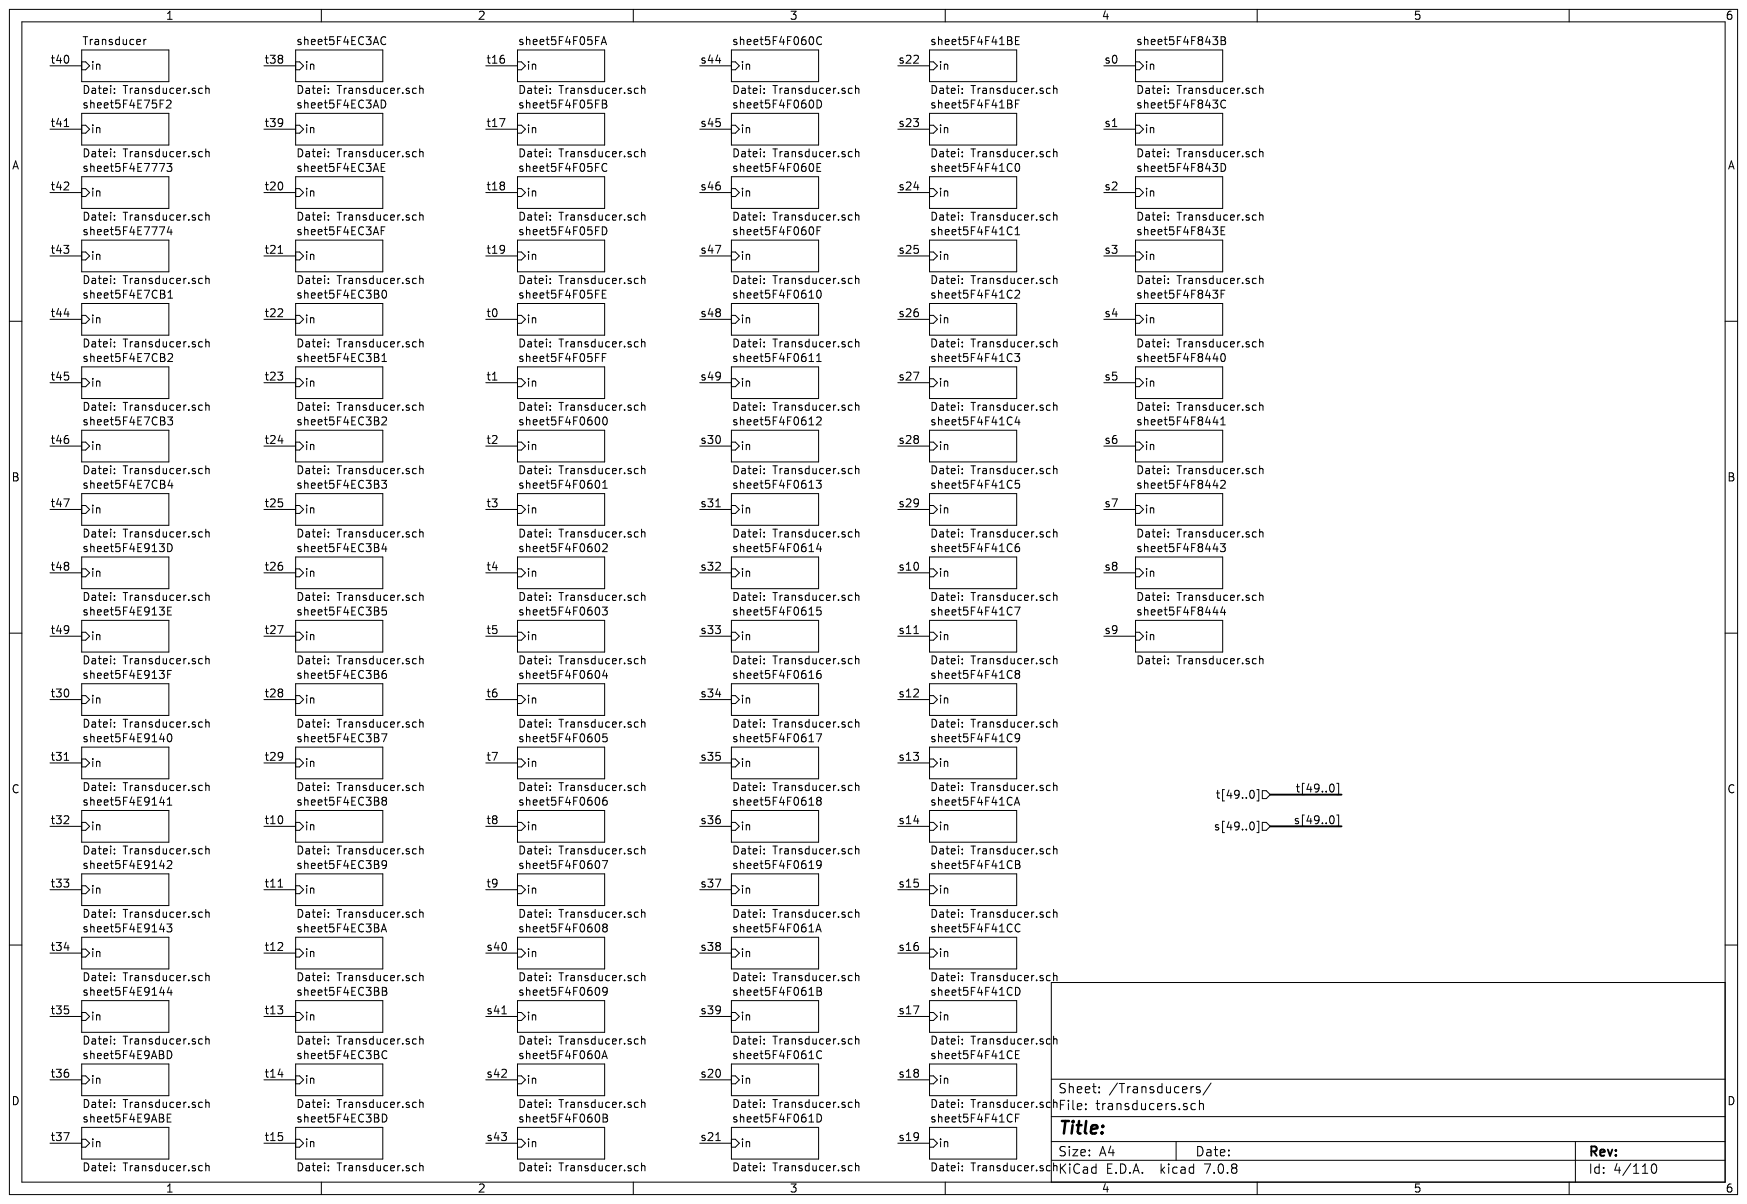
[picture p127: page 4]

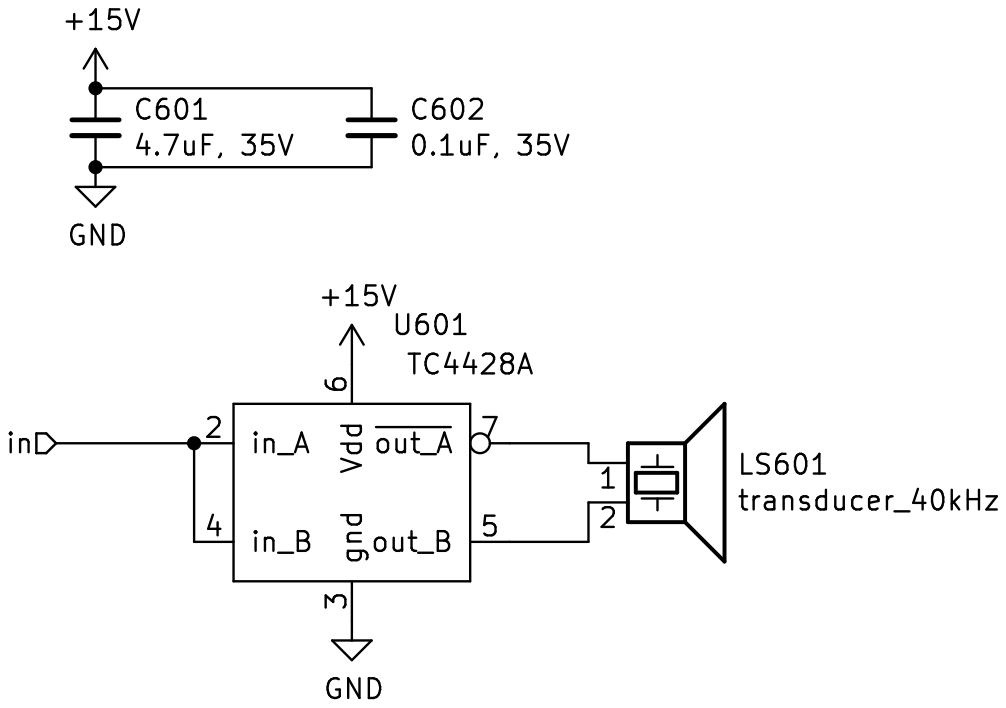
[picture p128: page 5]

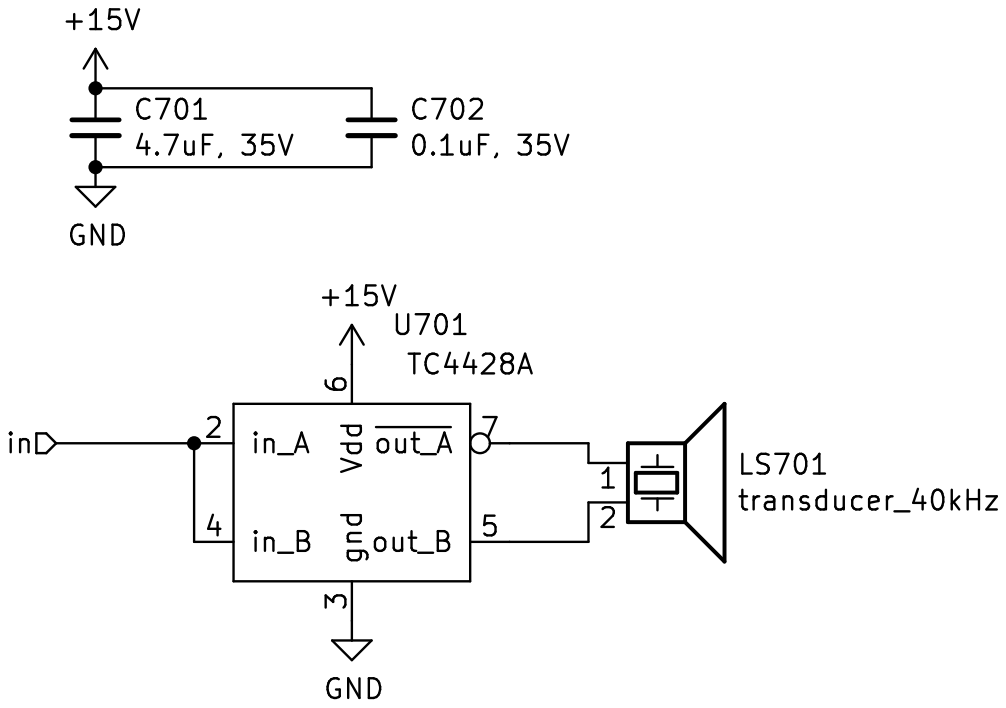
[picture p129: page 6]

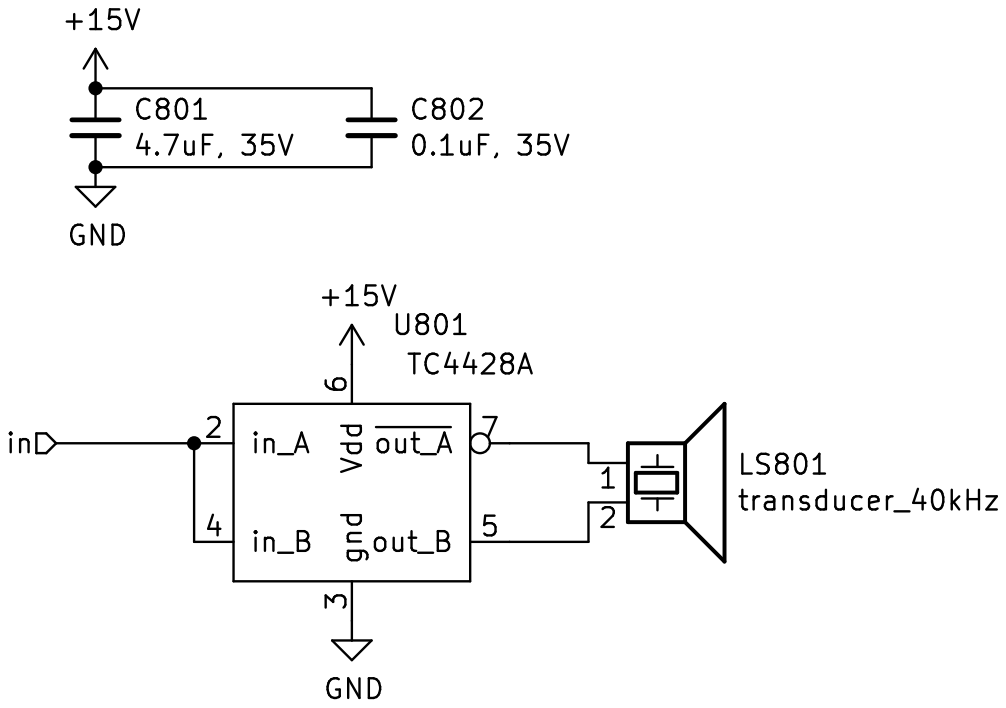
[picture p130: page 7]

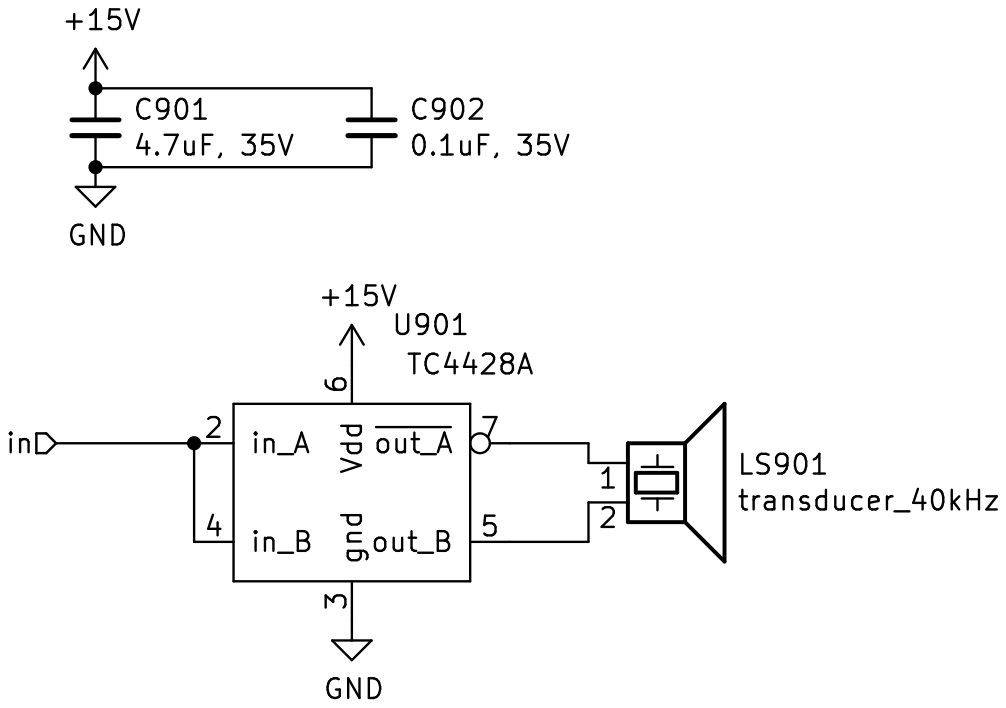
[picture p131: page 8]

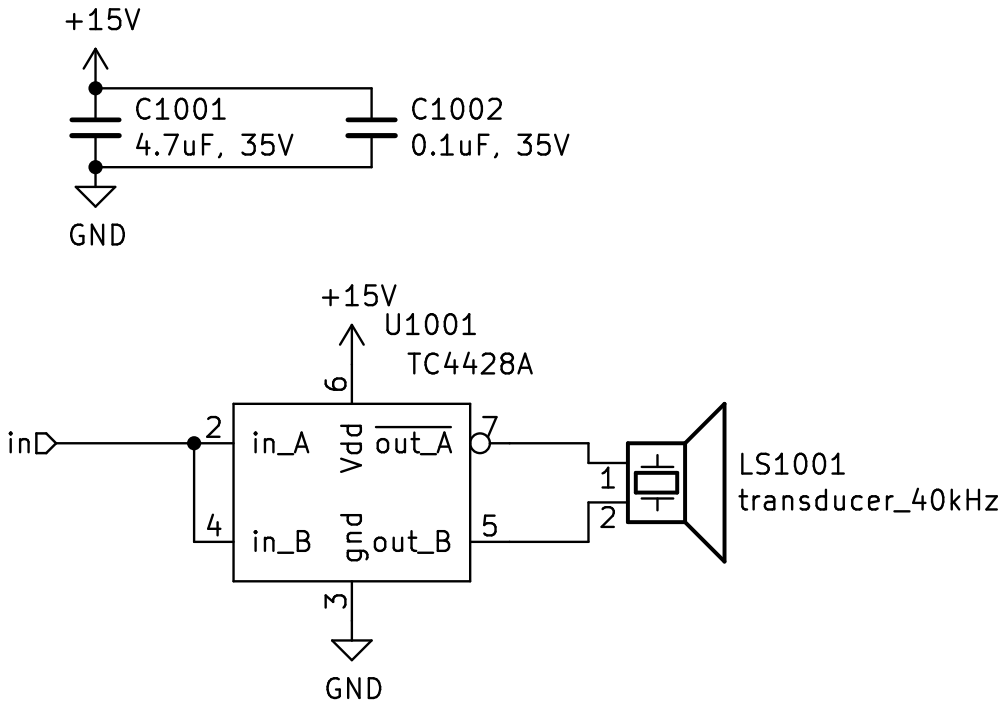
[picture p132: page 9]

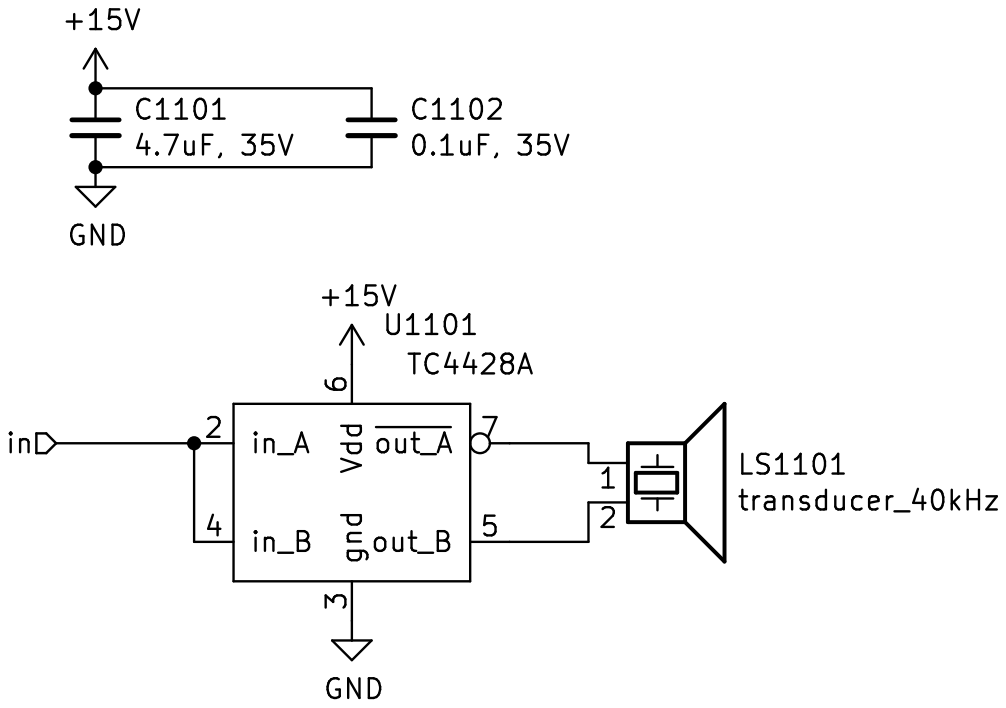
[picture p133: page 10]

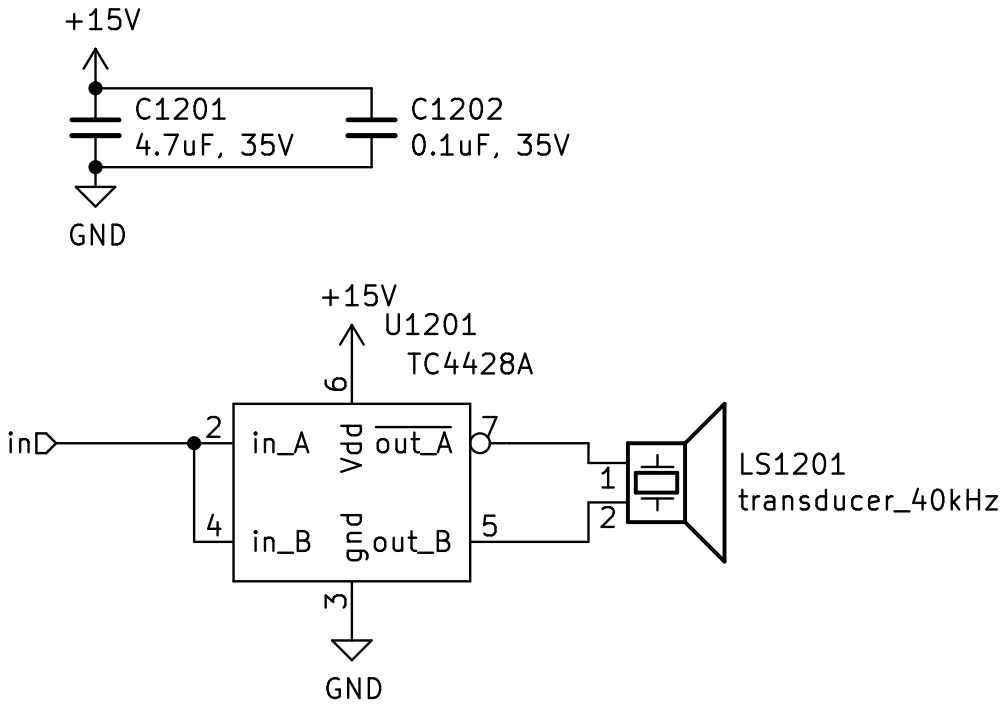
[picture p134: page 11]

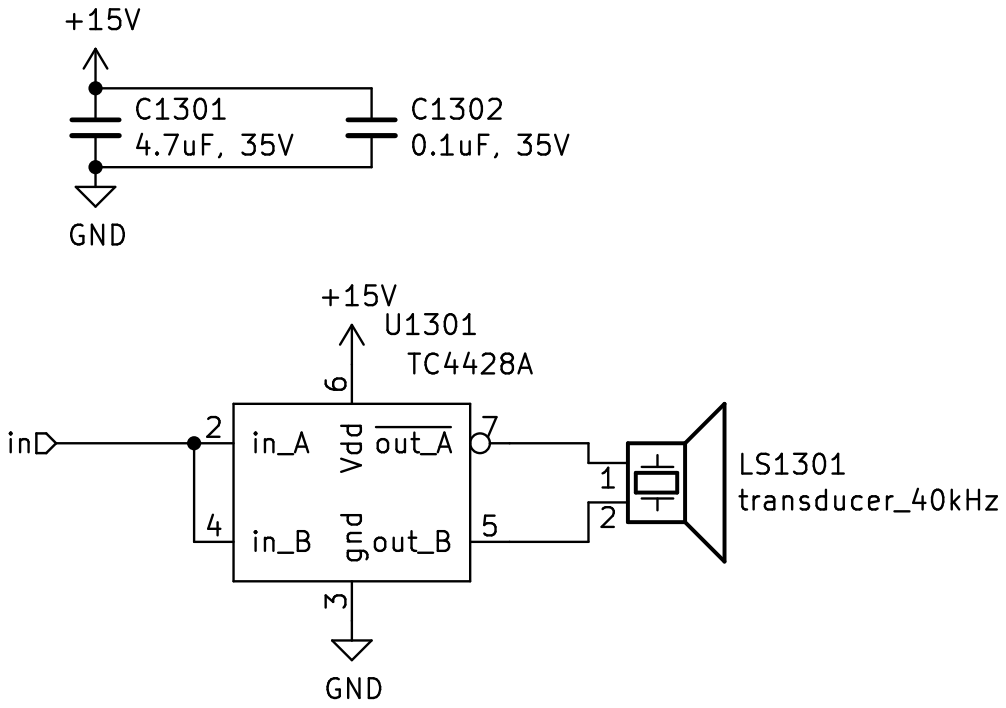
[picture p135: page 12]

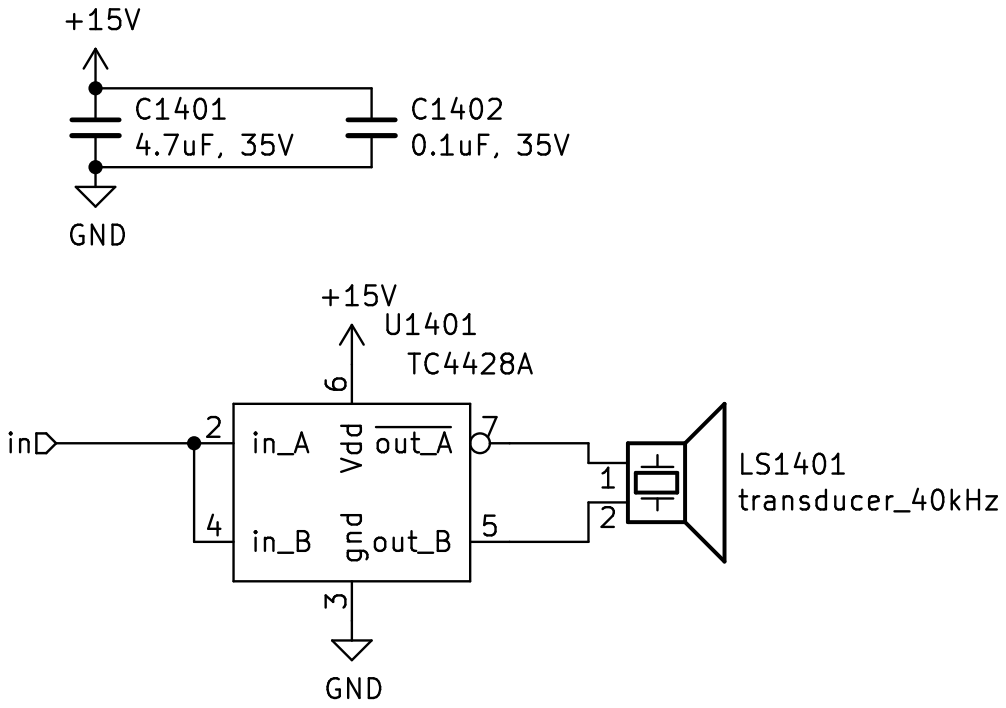
[picture p136: page 13]

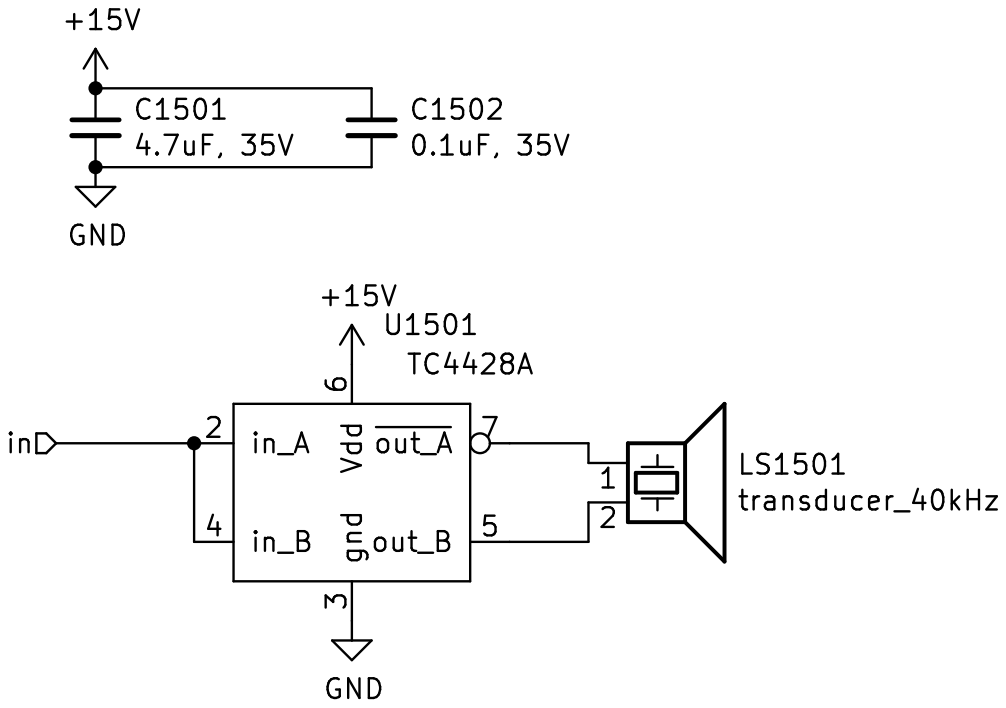
[picture p137: page 14]

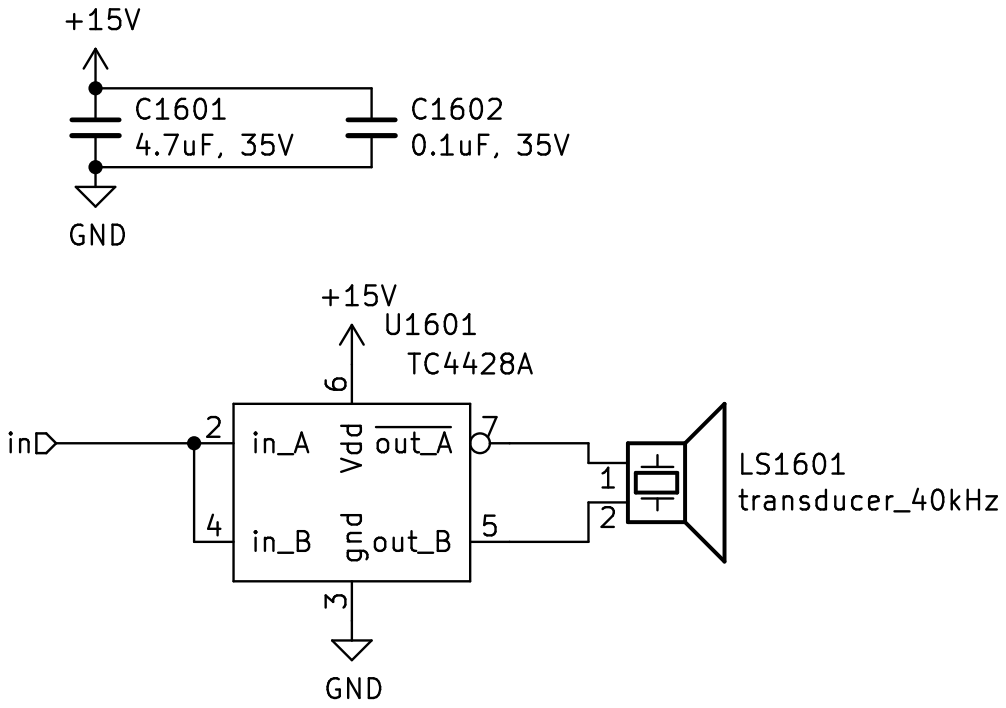
[picture p138: page 15]

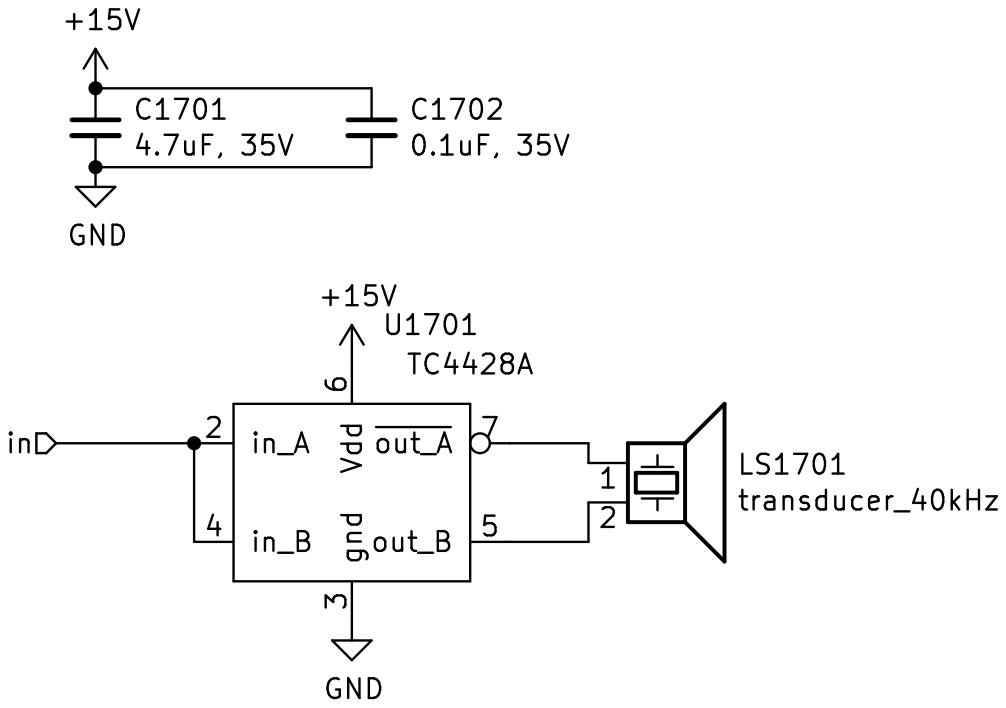
[picture p139: page 16]

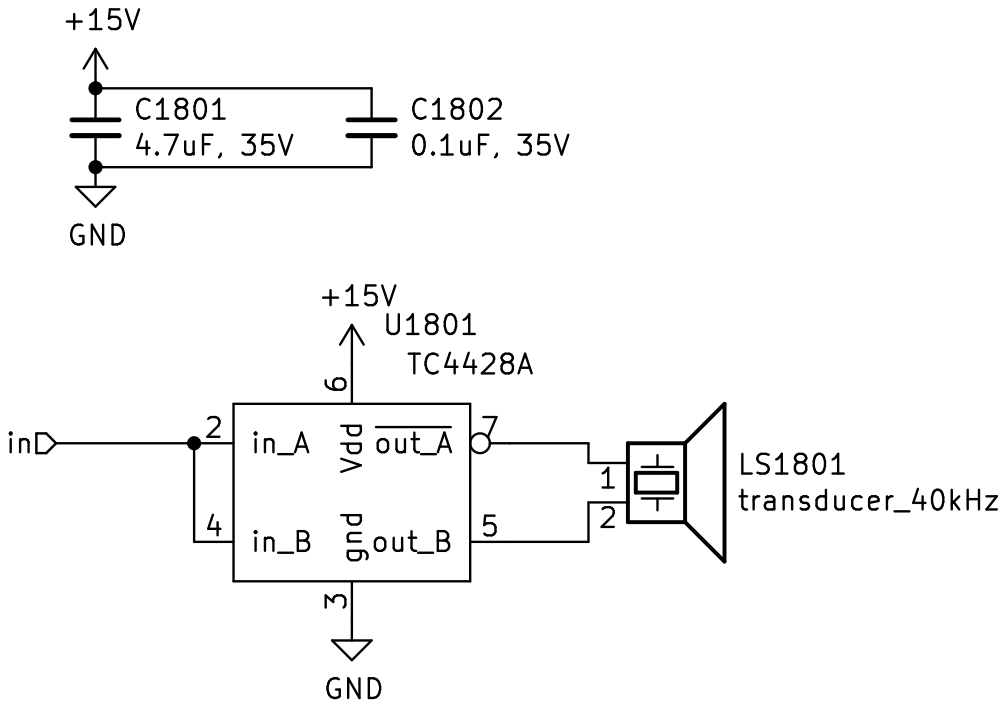
[picture p140: page 17]

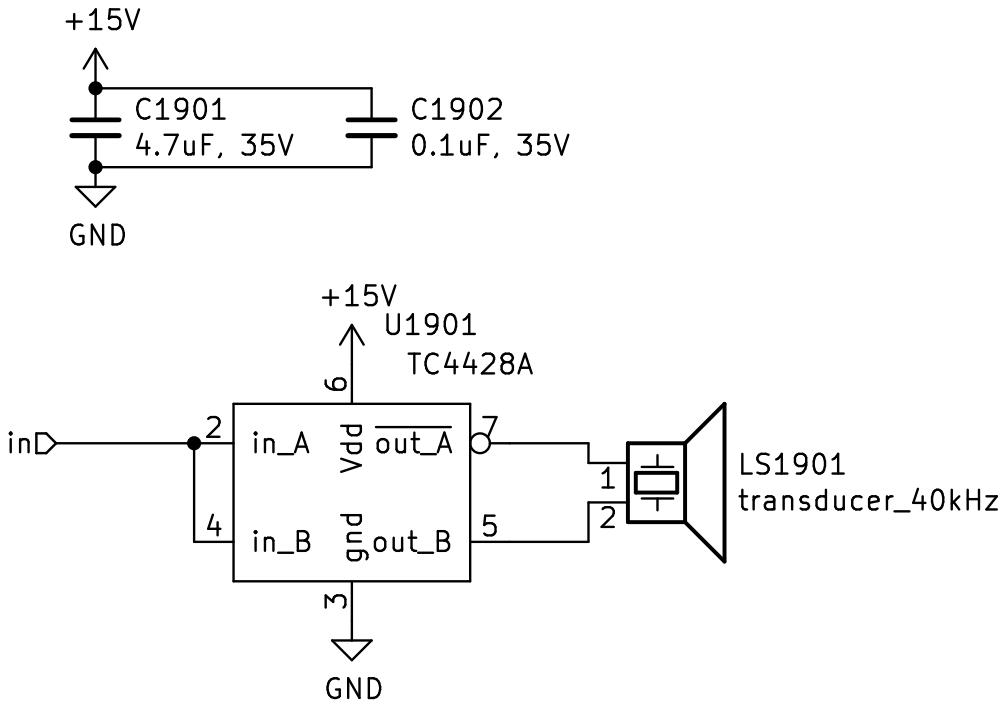
[picture p141: page 18]

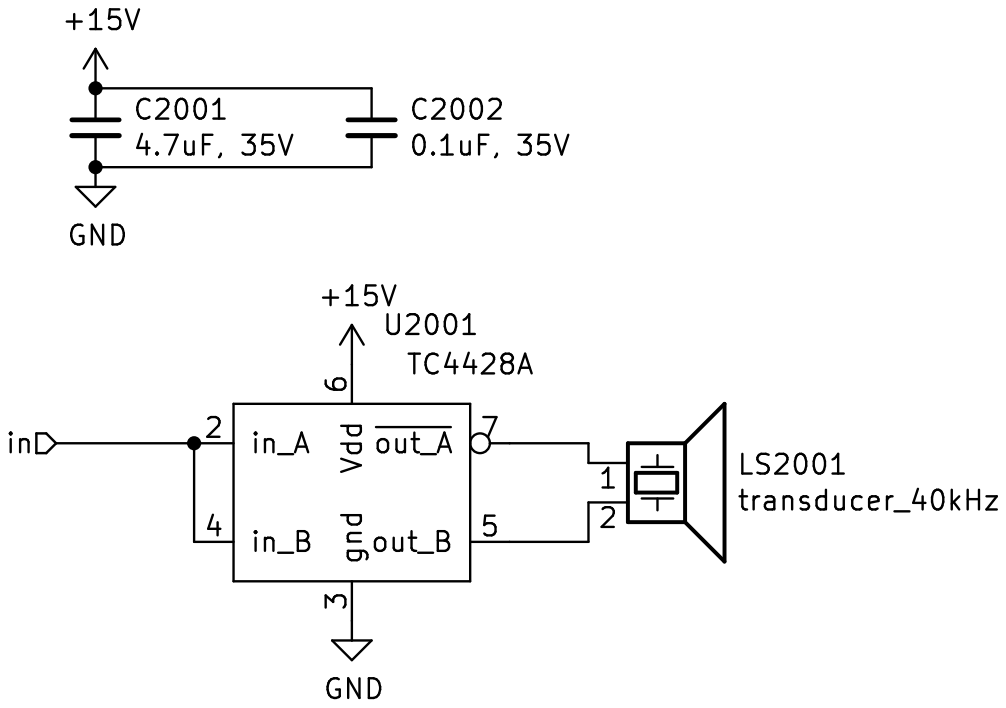
[picture p142: page 19]

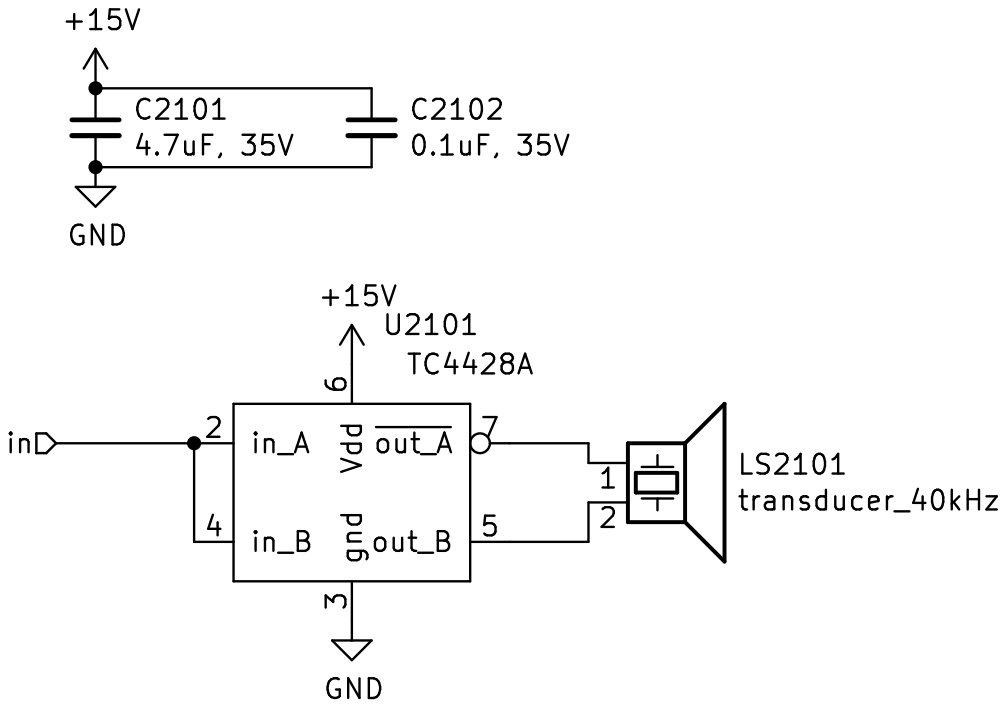
[picture p143: page 20]

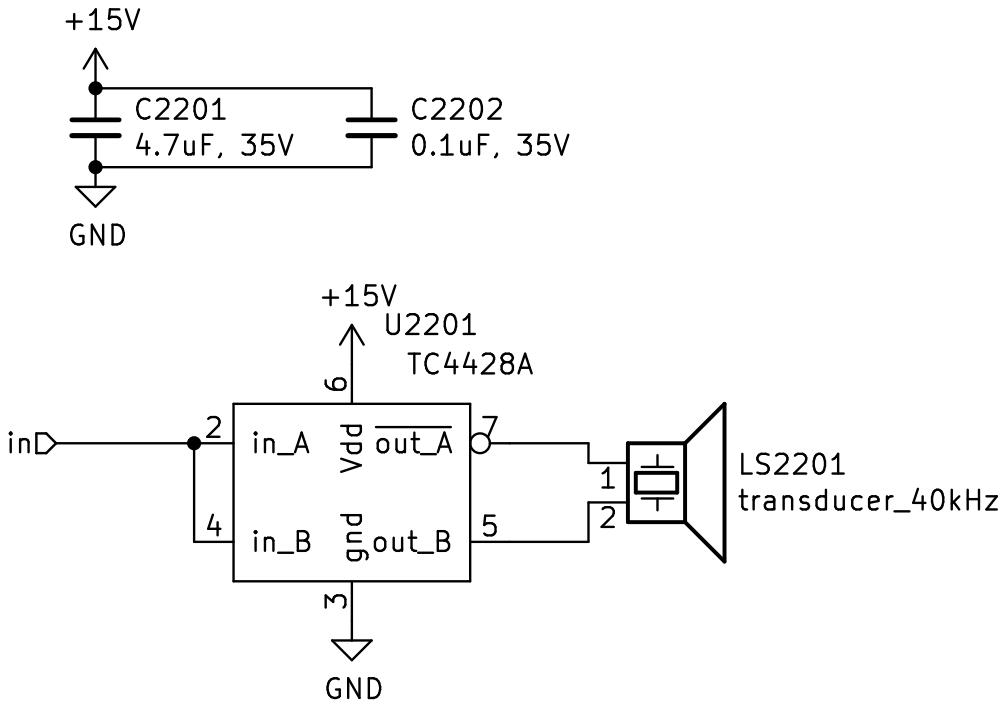
[picture p144: page 21]

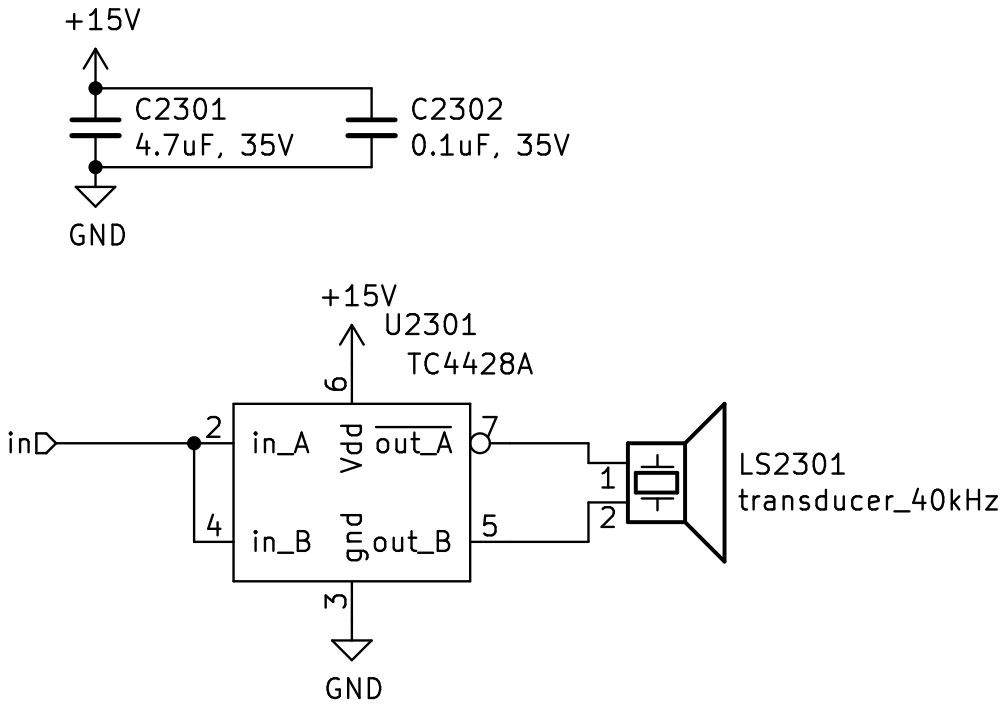
[picture p145: page 22]

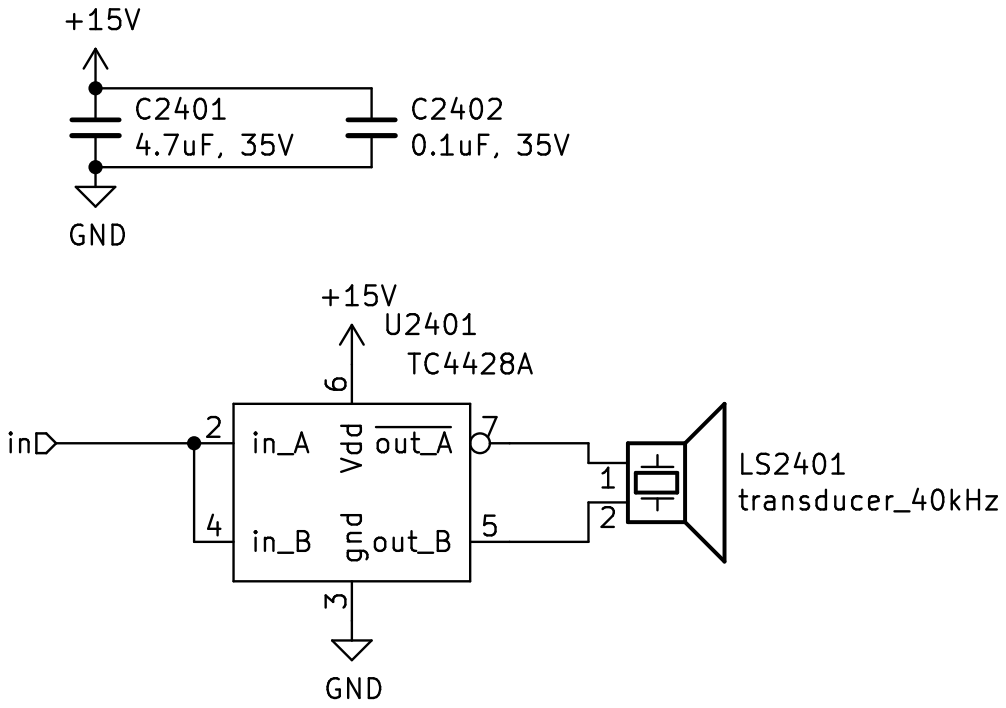
[picture p146: page 23]

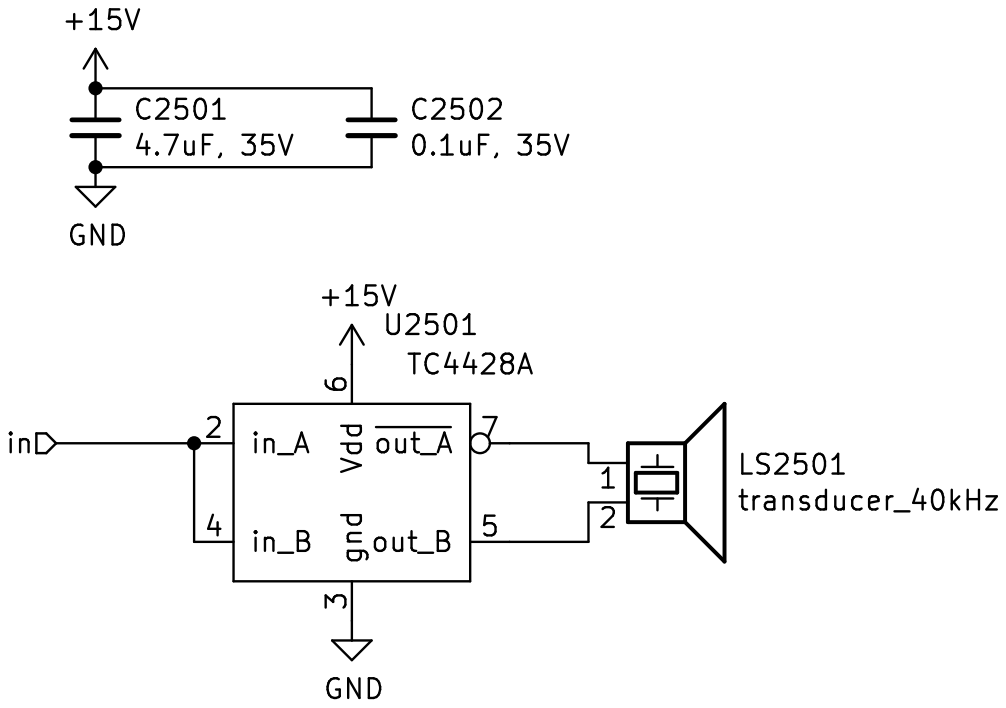
[picture p147: page 24]

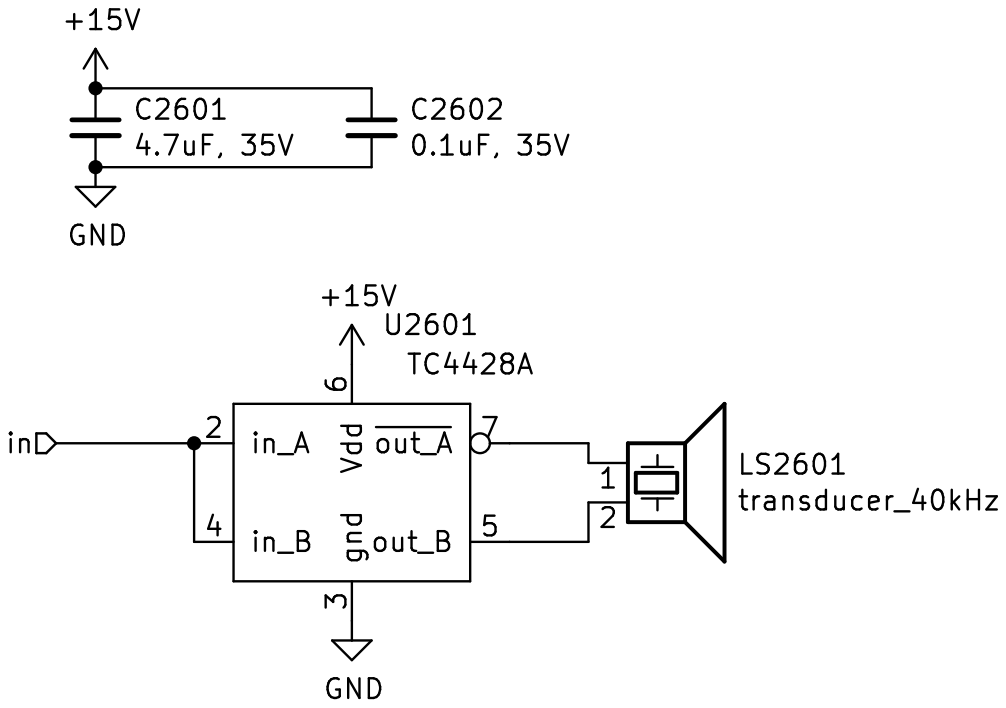
[picture p148: page 25]

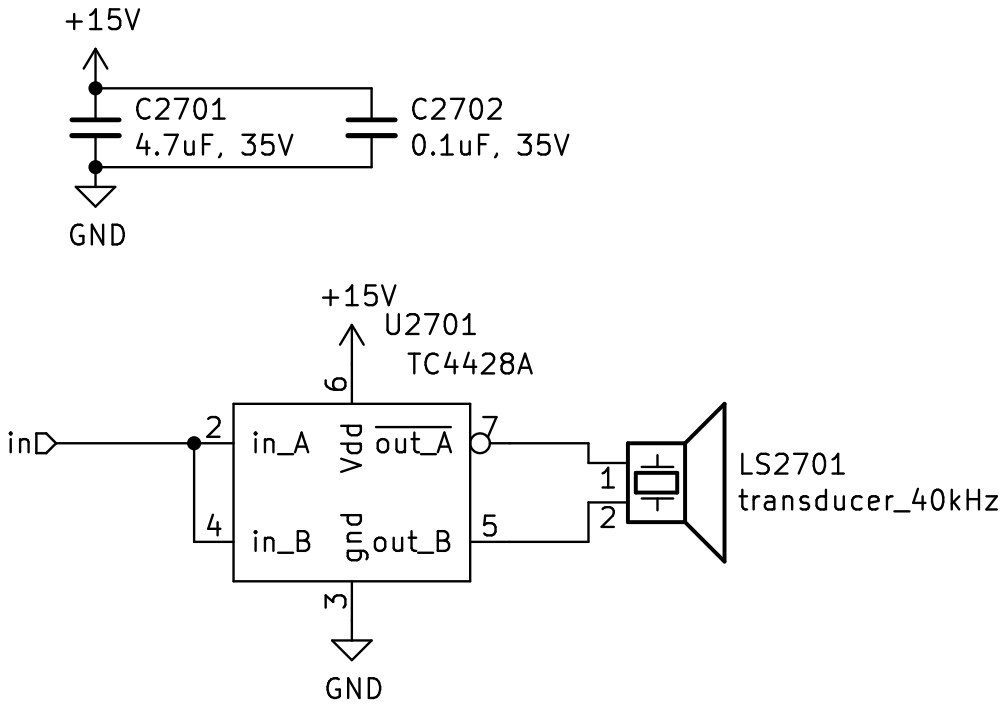
[picture p149: page 26]

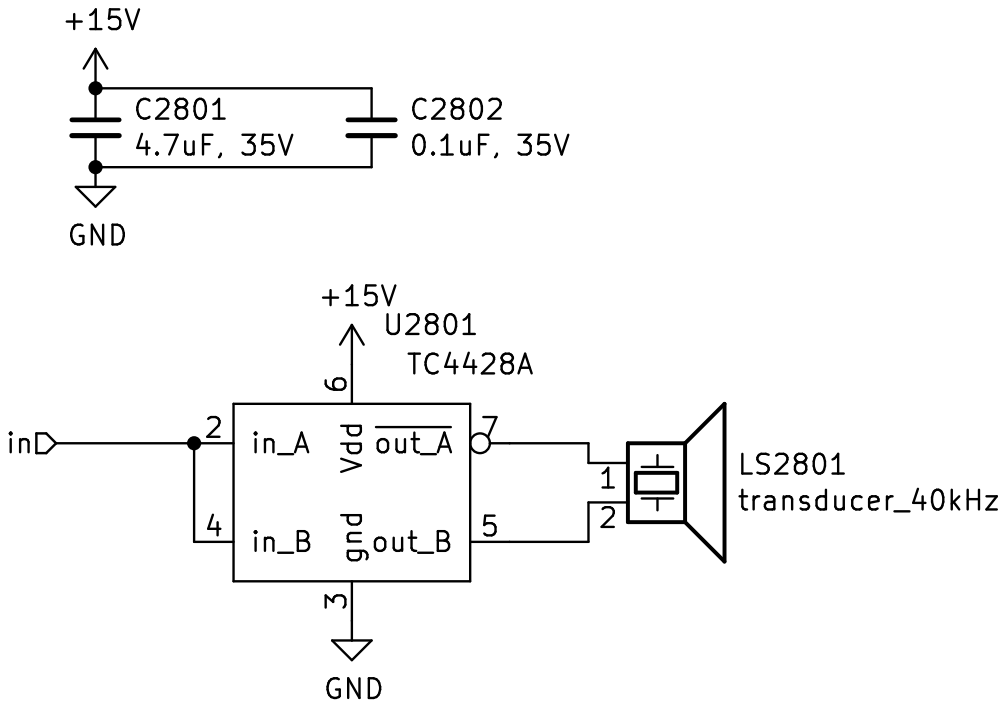
[picture p150: page 27]

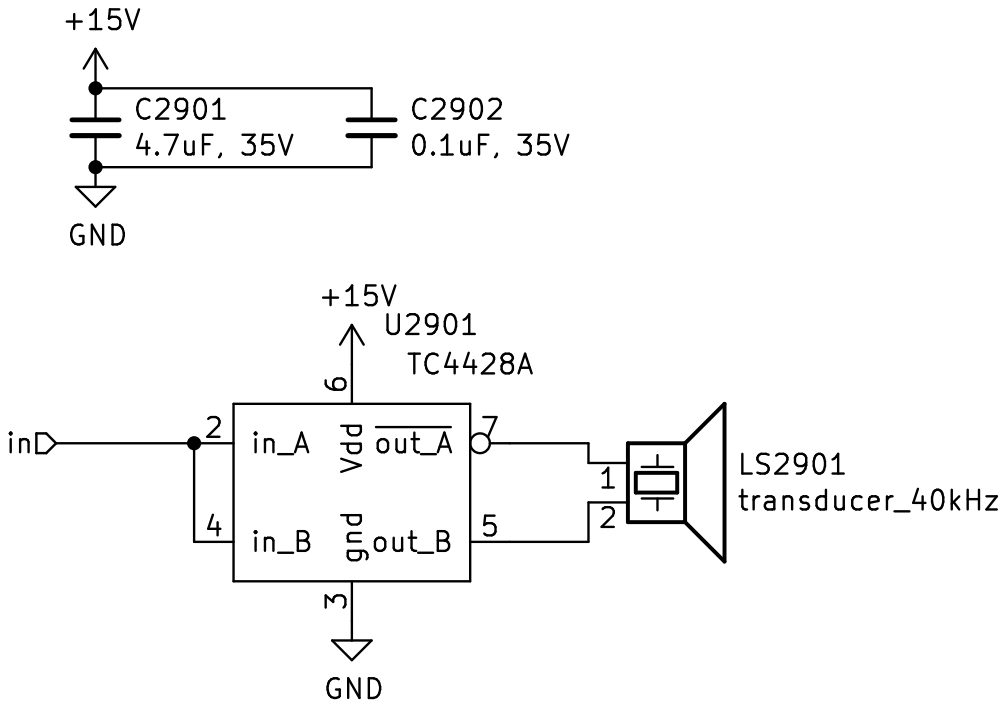
[picture p151: page 28]

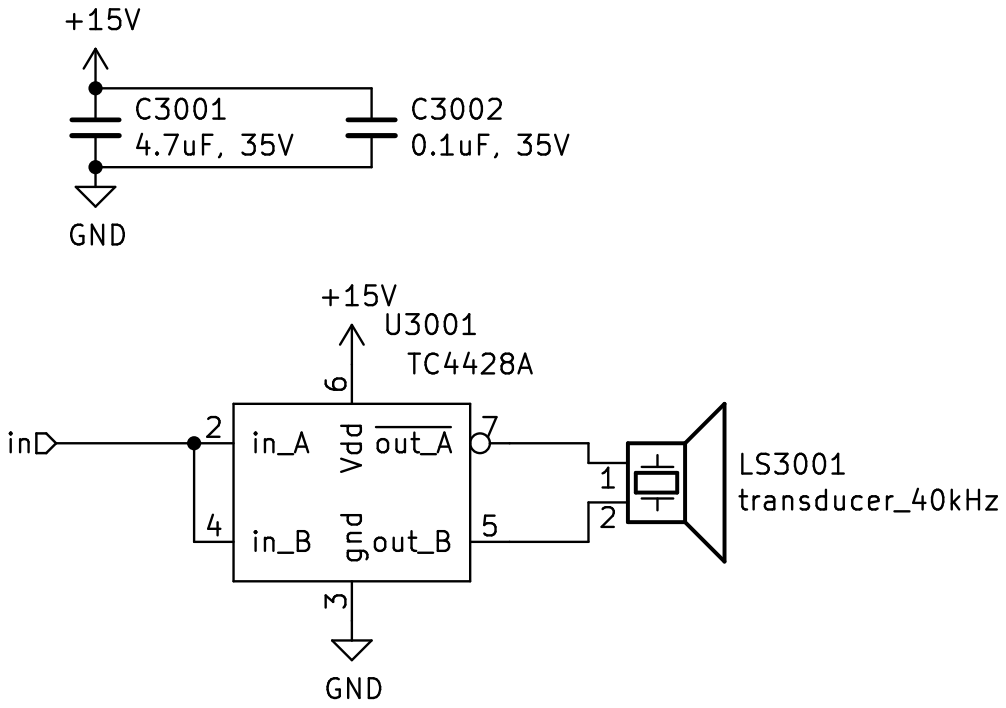
[picture p152: page 29]

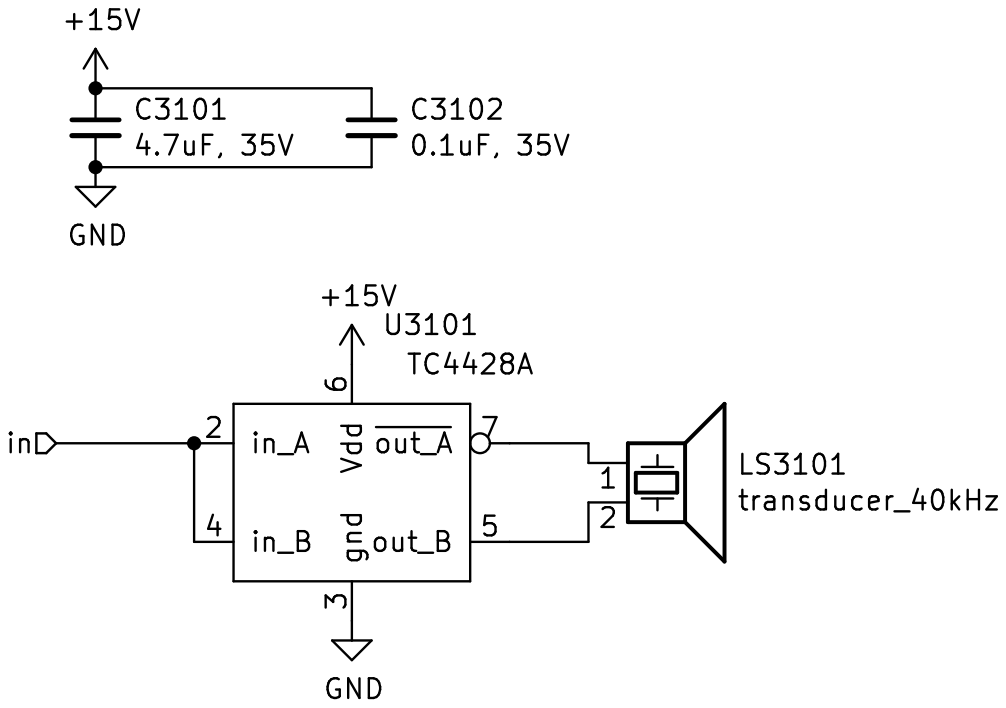
[picture p153: page 30]

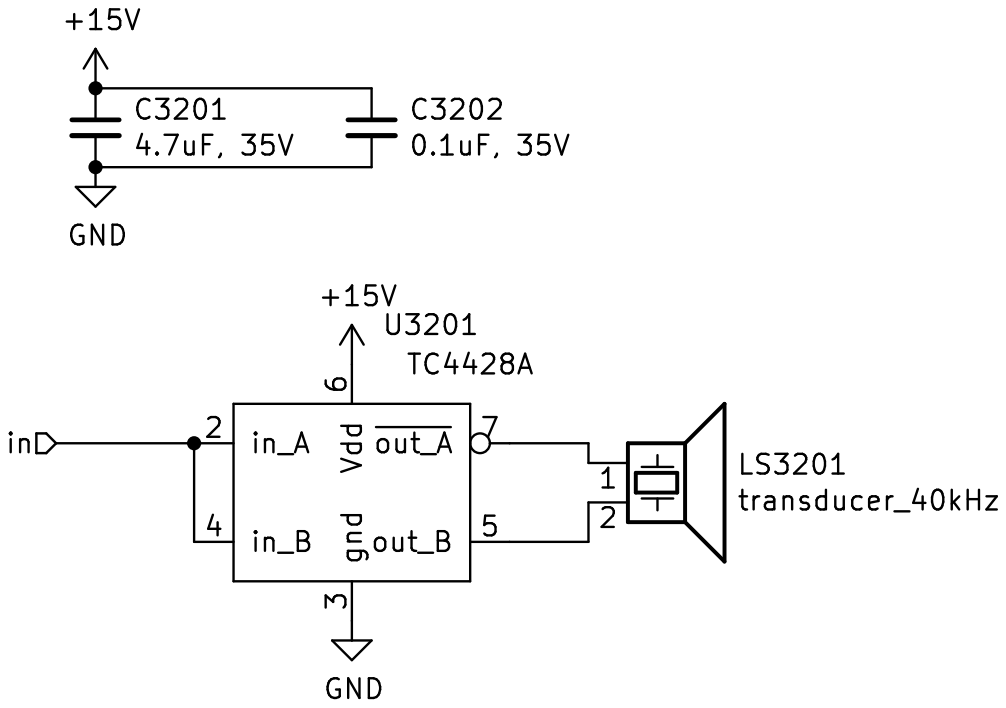
[picture p154: page 31]

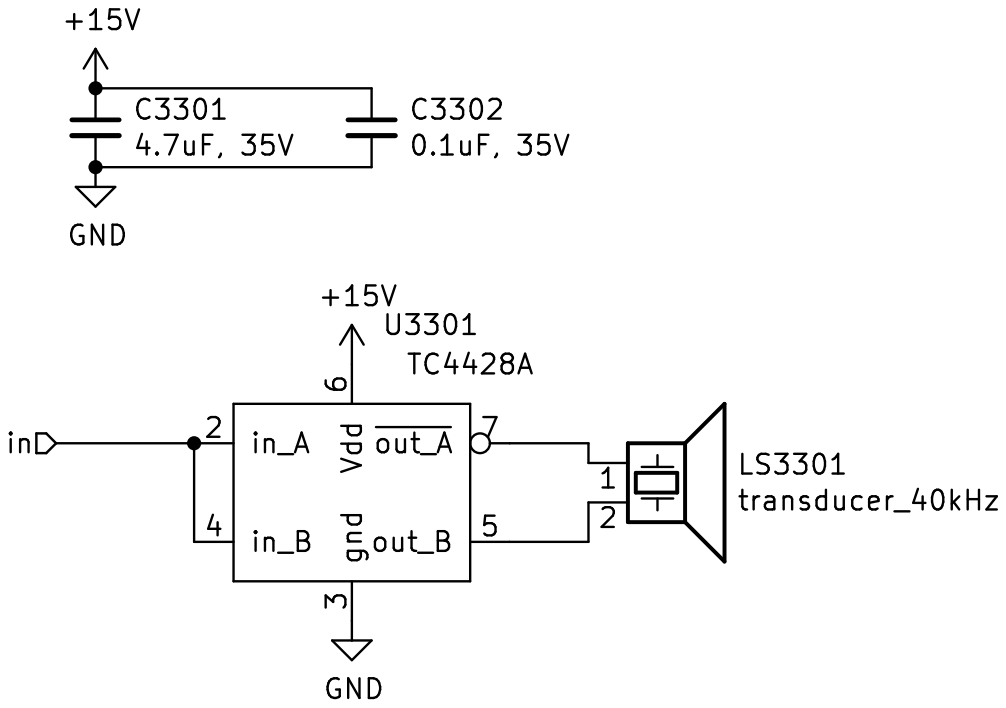
[picture p155: page 32]

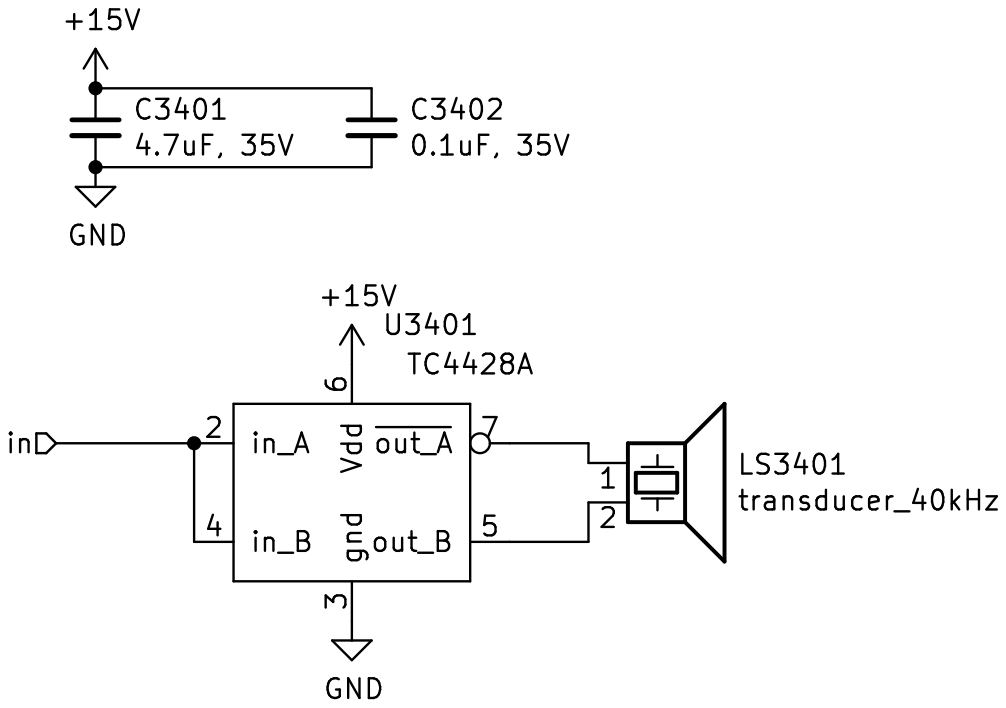
[picture p156: page 33]

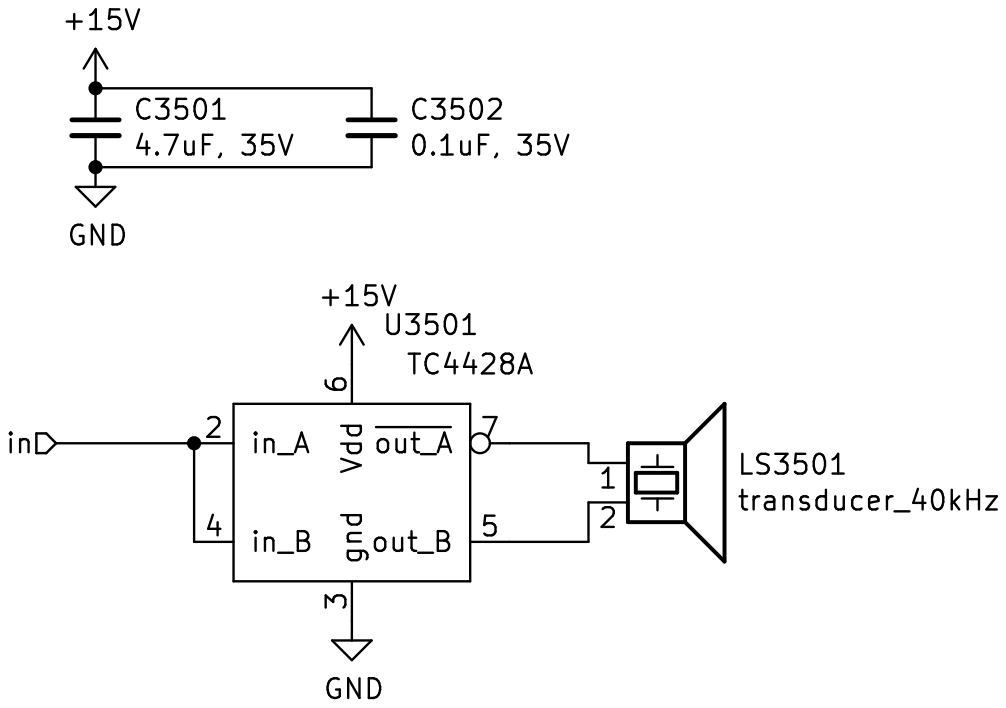
[picture p157: page 34]

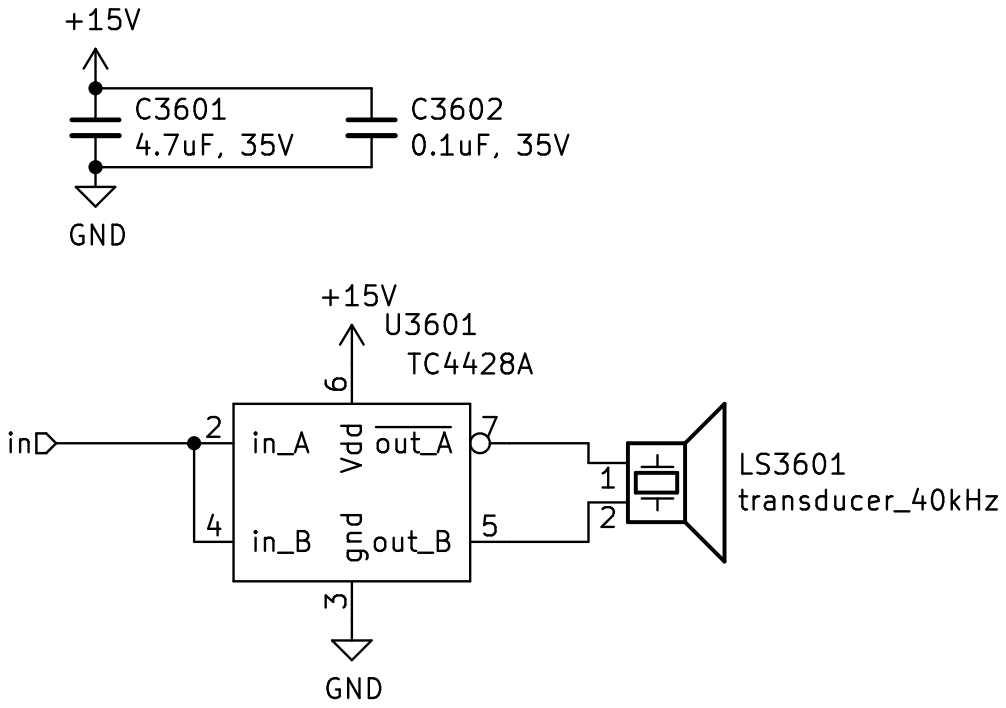
[picture p158: page 35]

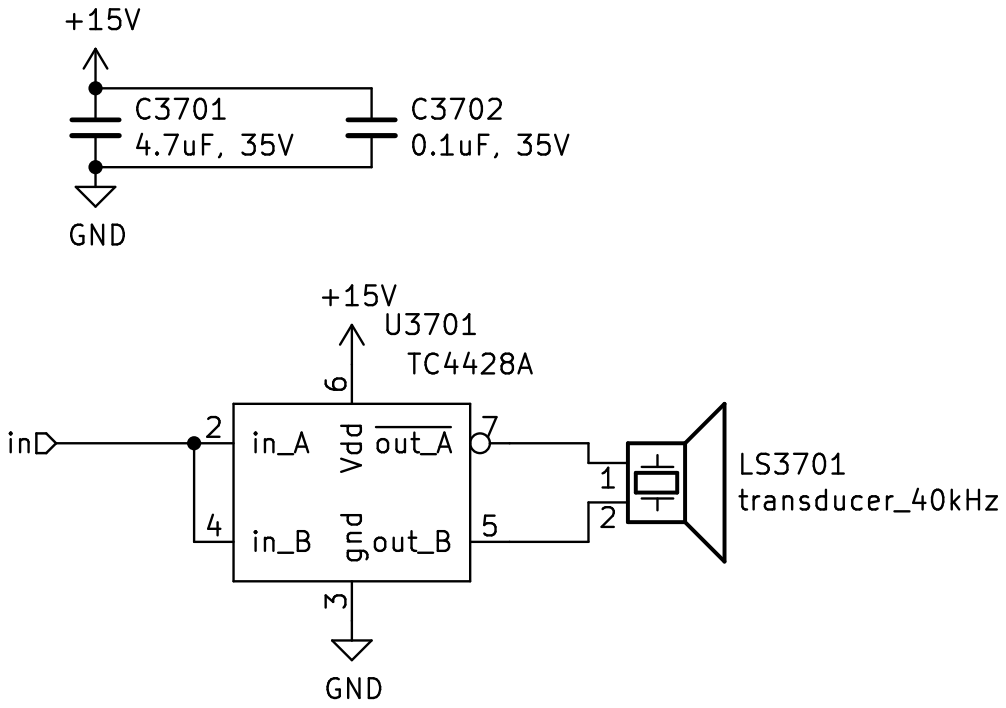
[picture p159: page 36]

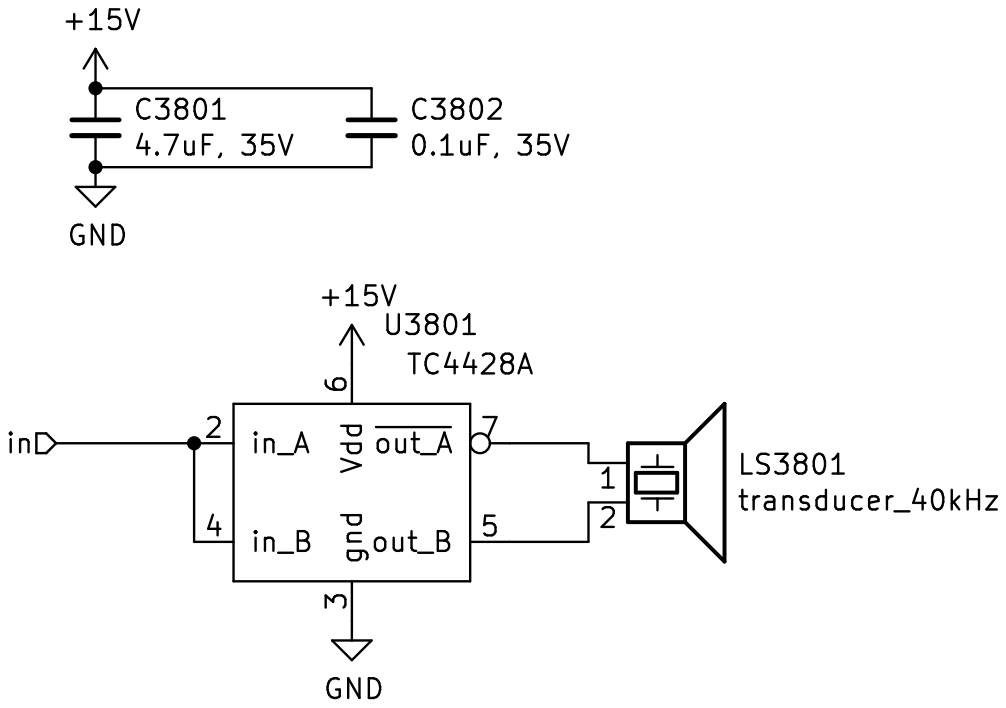
[picture p160: page 37]

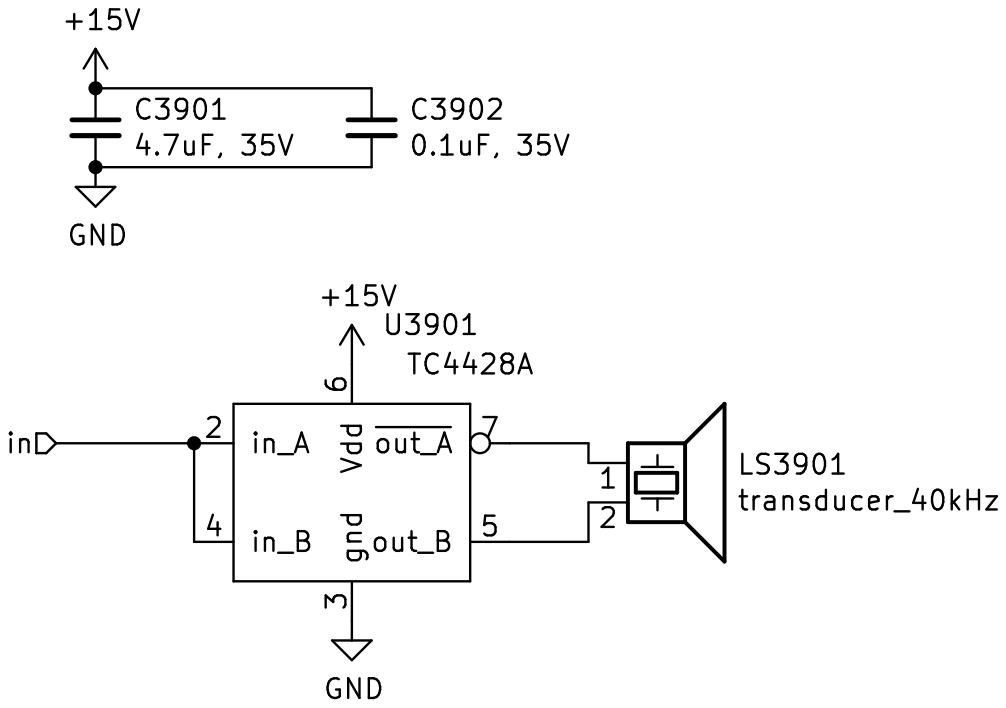
[picture p161: page 38]

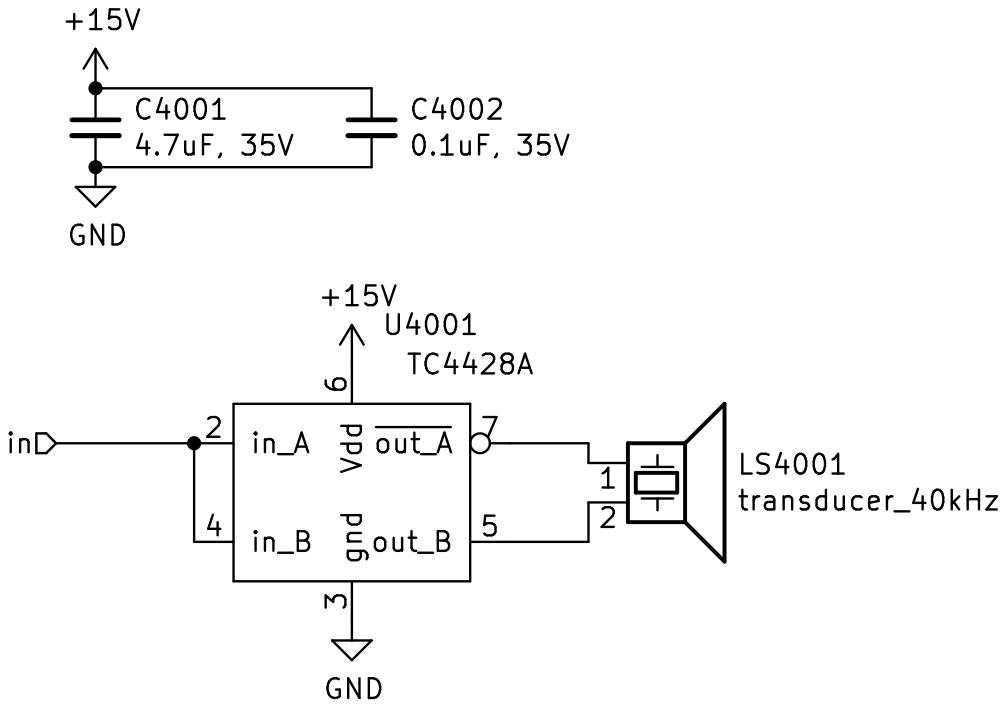
[picture p162: page 39]

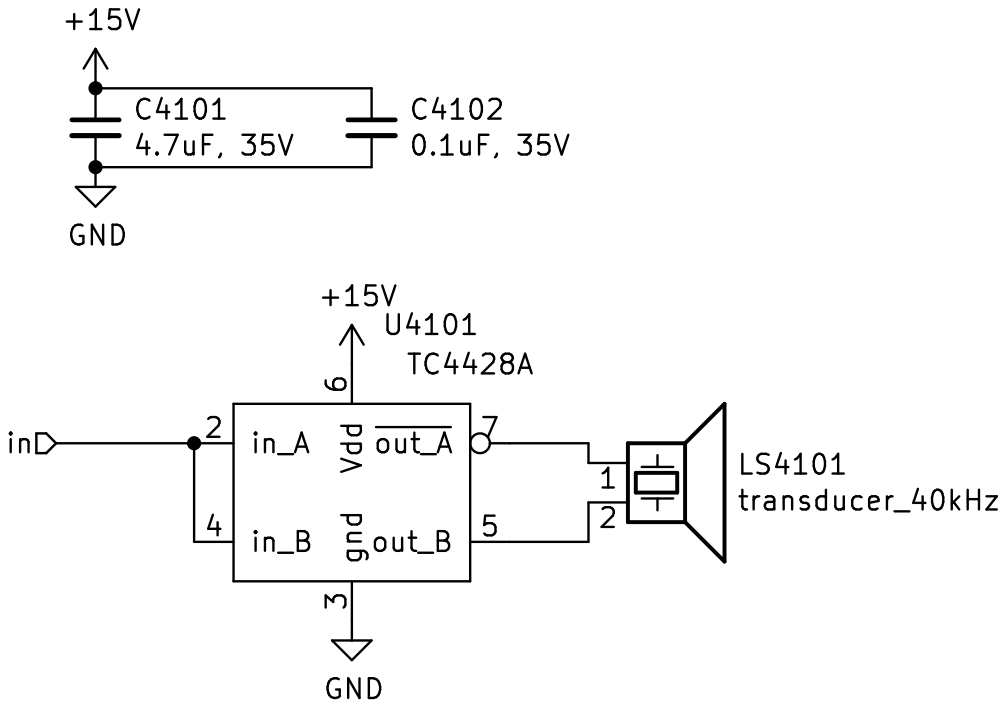
[picture p163: page 40]

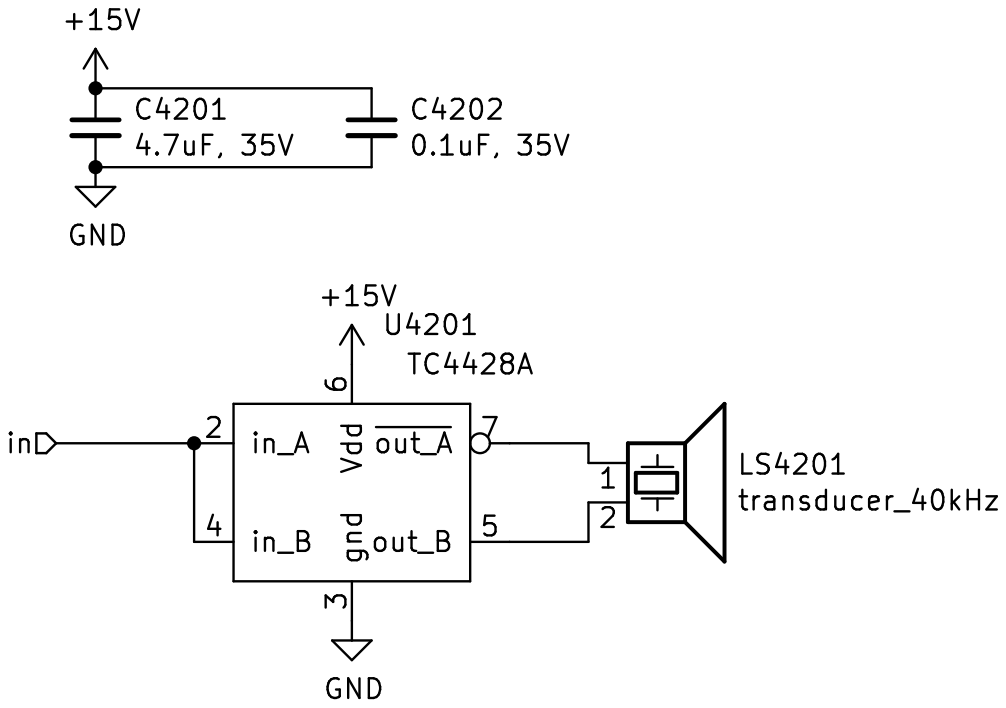
[picture p164: page 41]

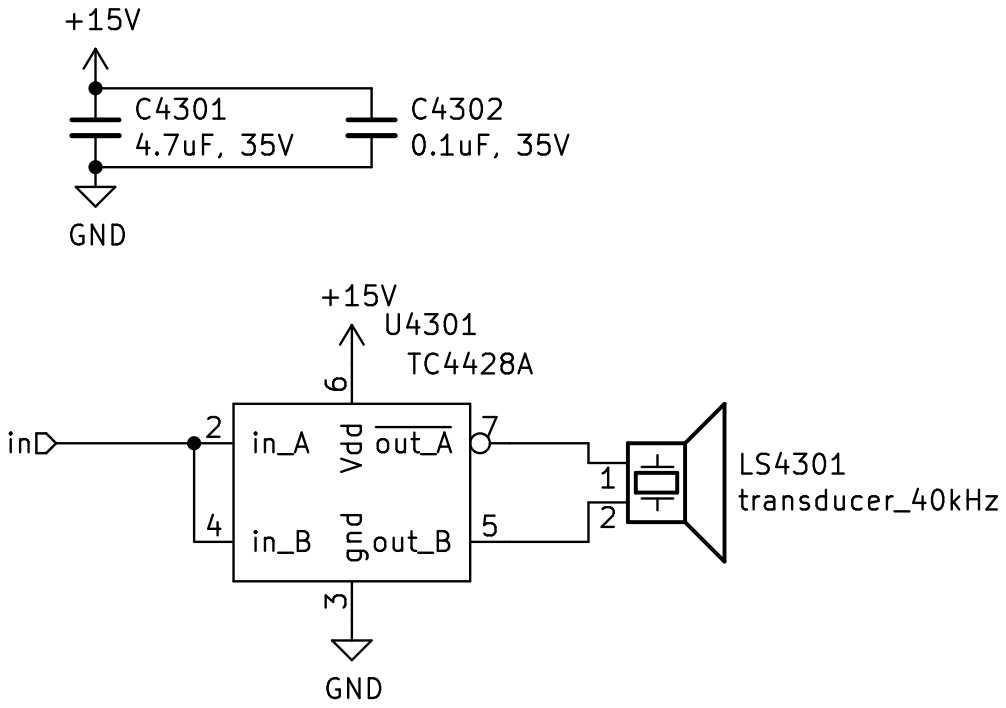
[picture p165: page 42]

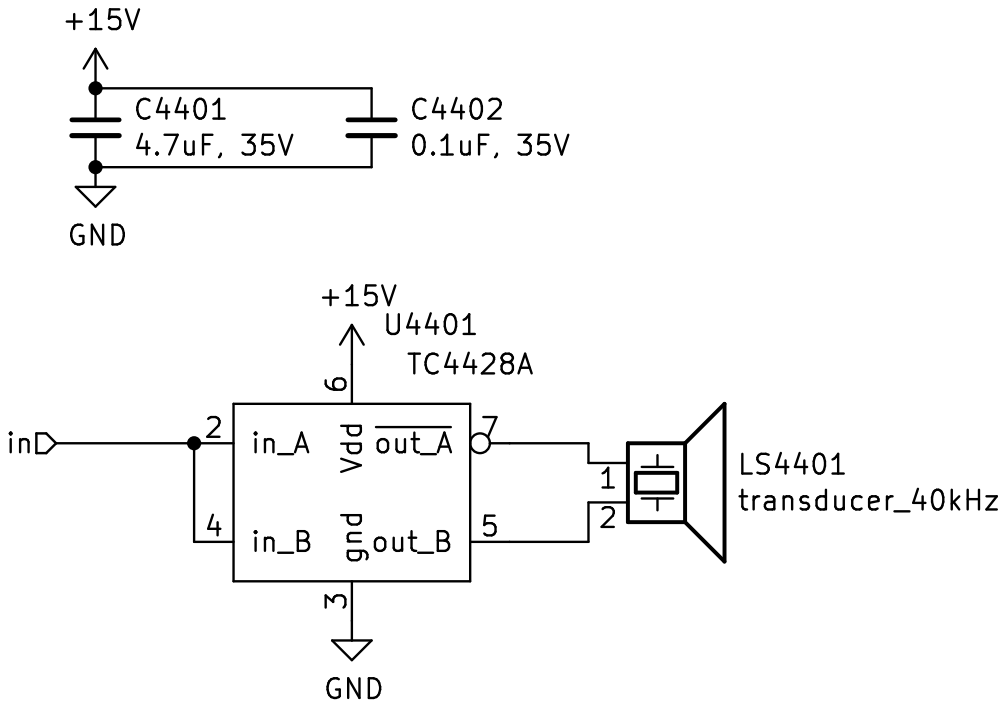
[picture p166: page 43]

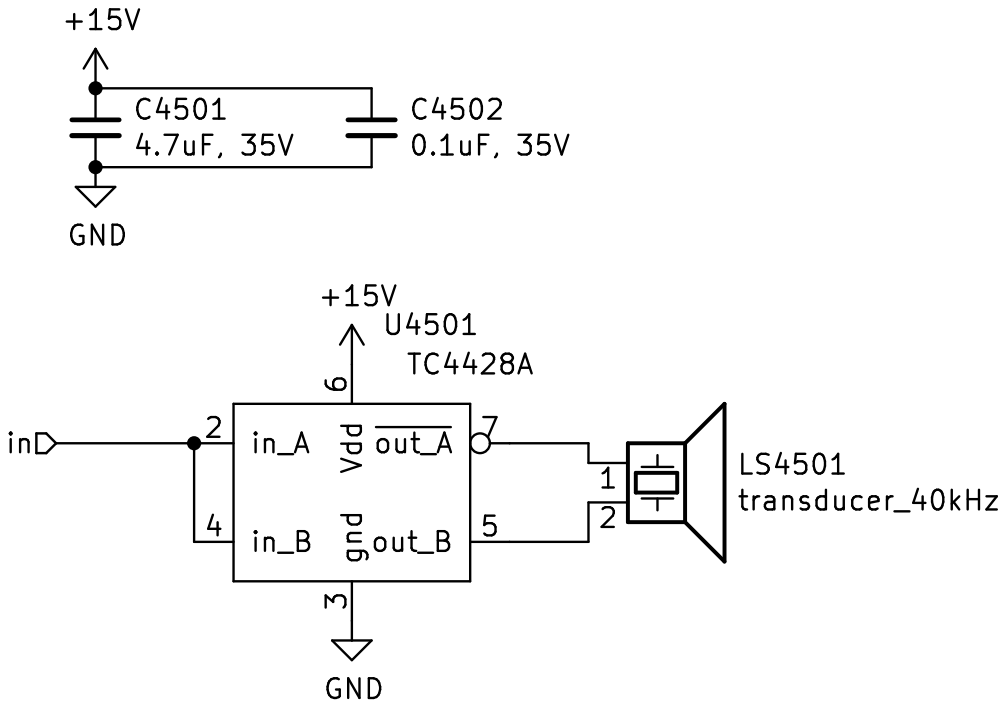
[picture p167: page 44]

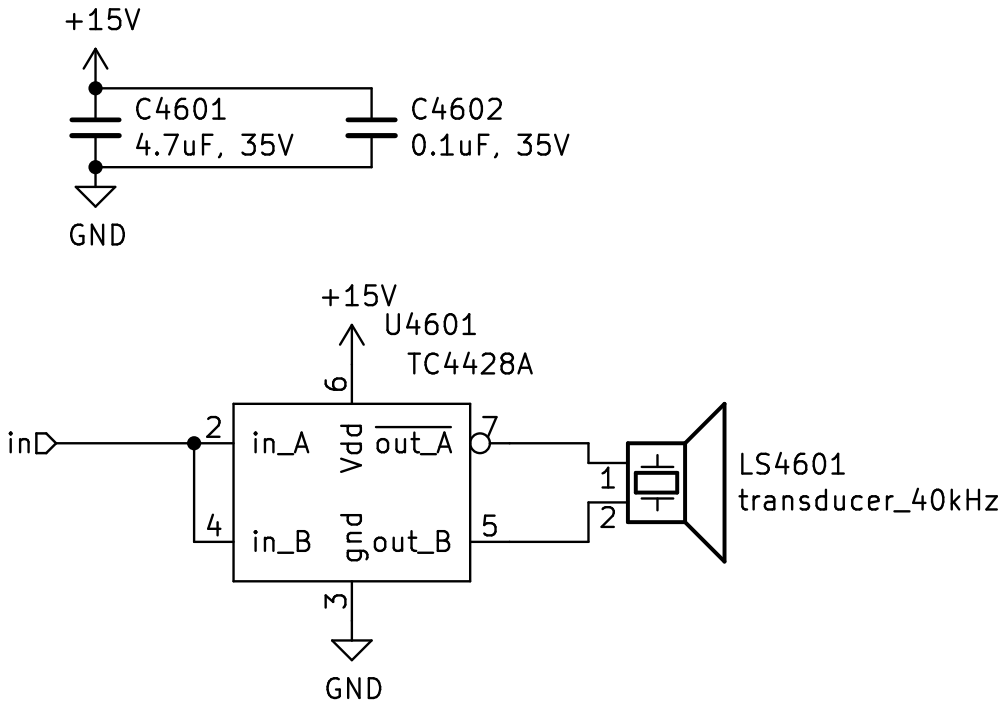
[picture p168: page 45]

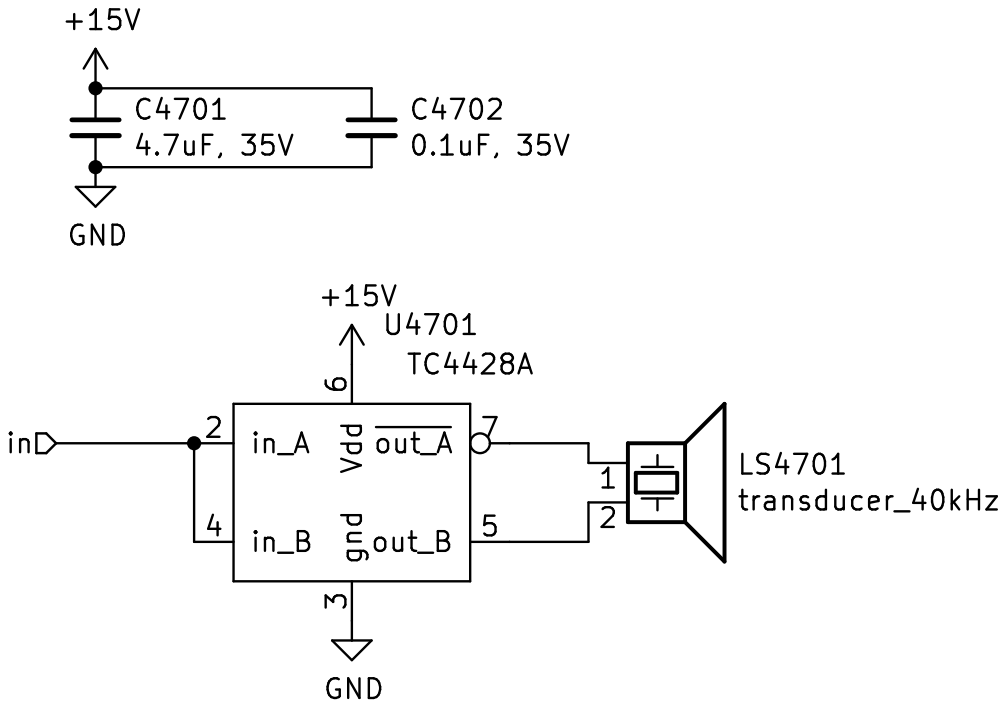
[picture p169: page 46]

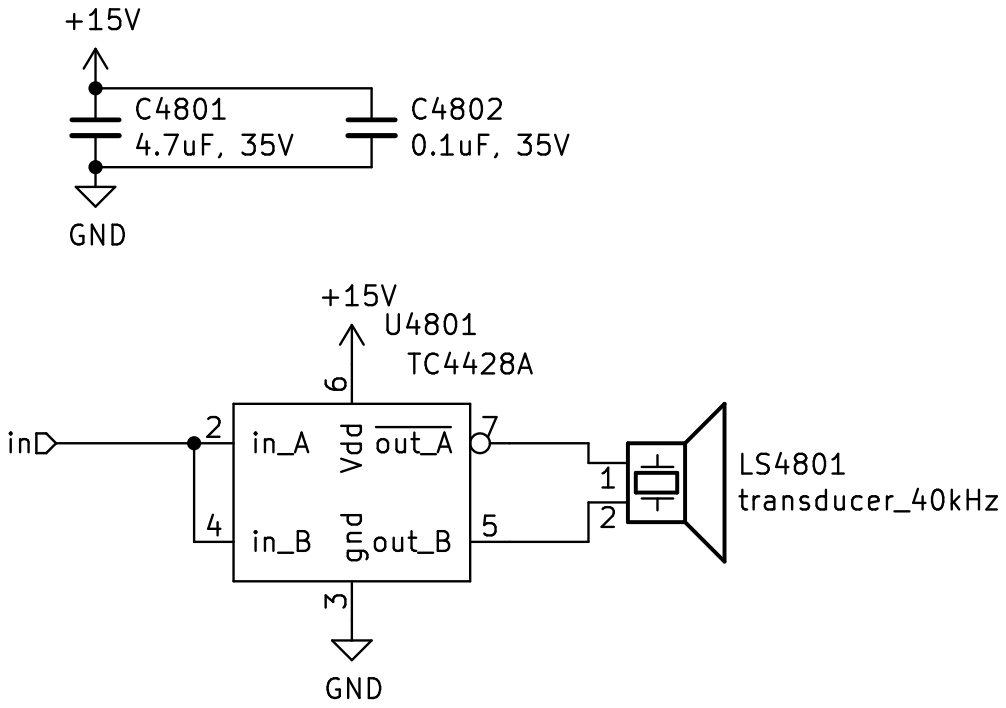
[picture p170: page 47]

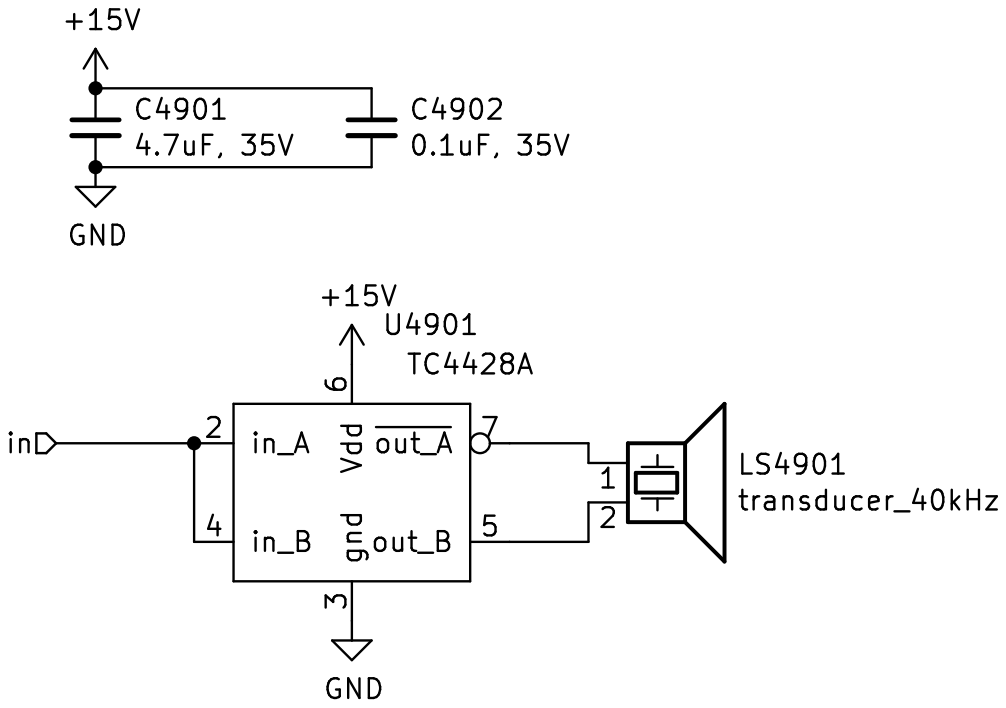
[picture p171: page 48]

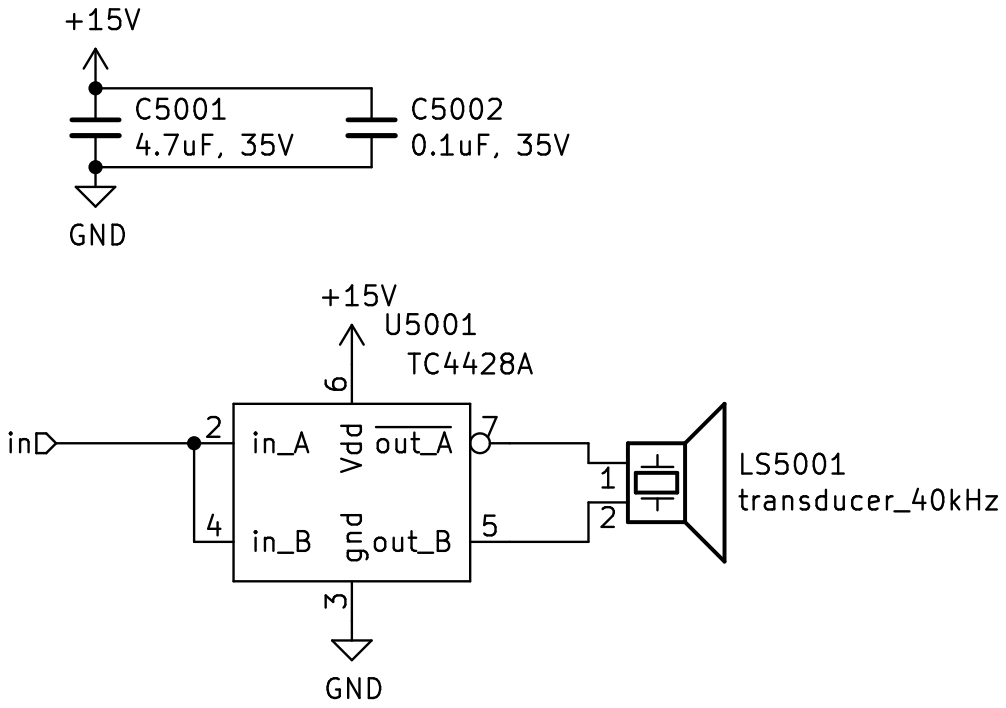
[picture p172: page 49]

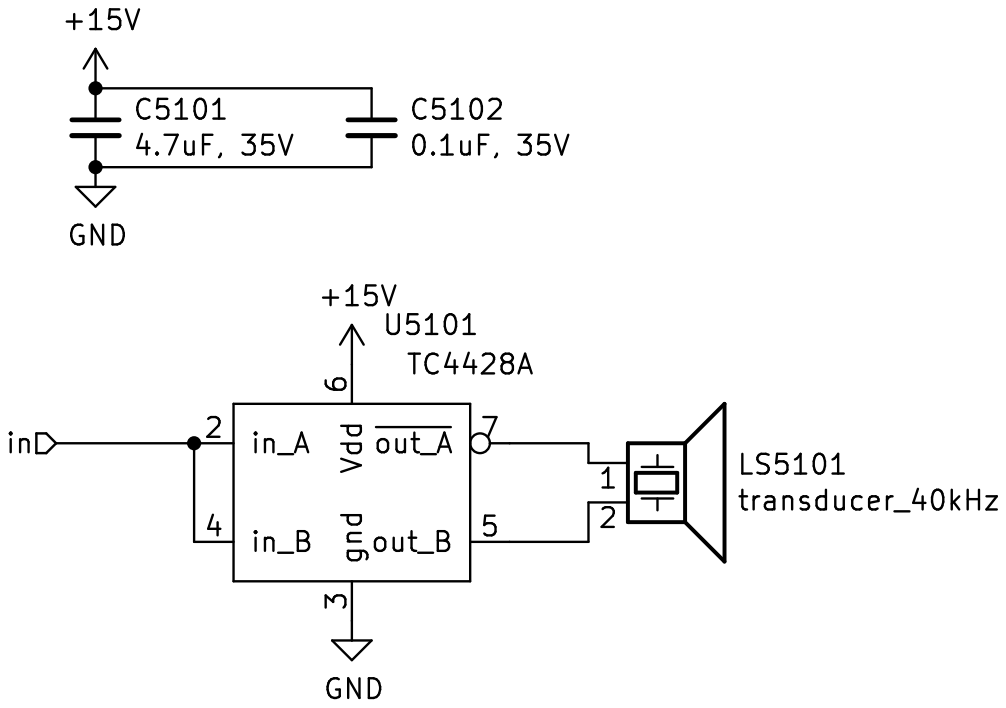
[picture p173: page 50]

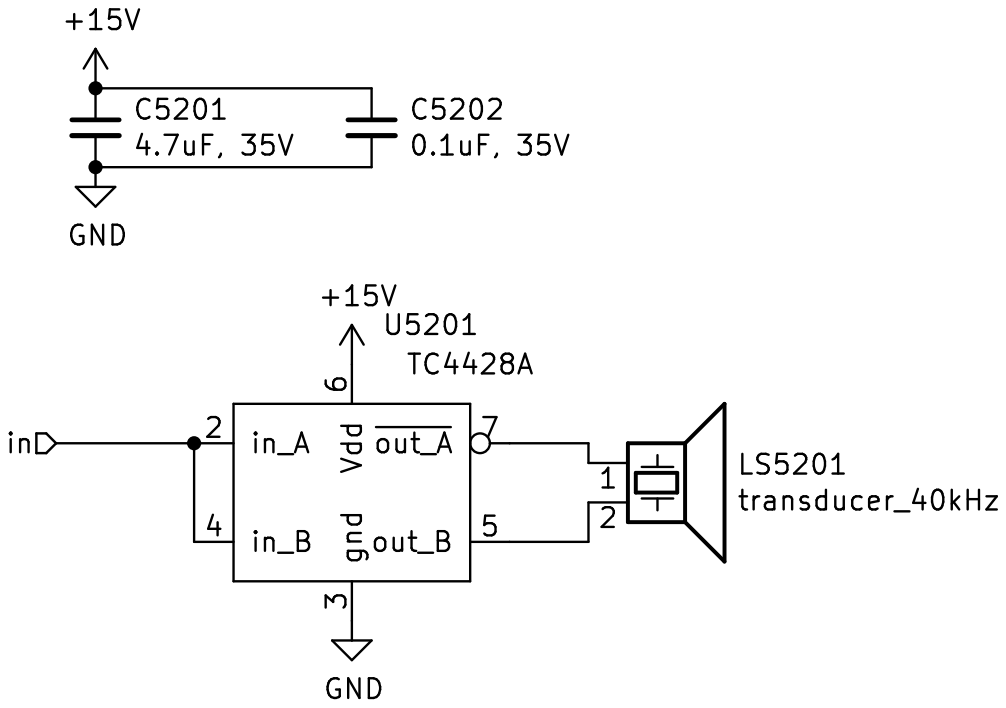
[picture p174: page 51]

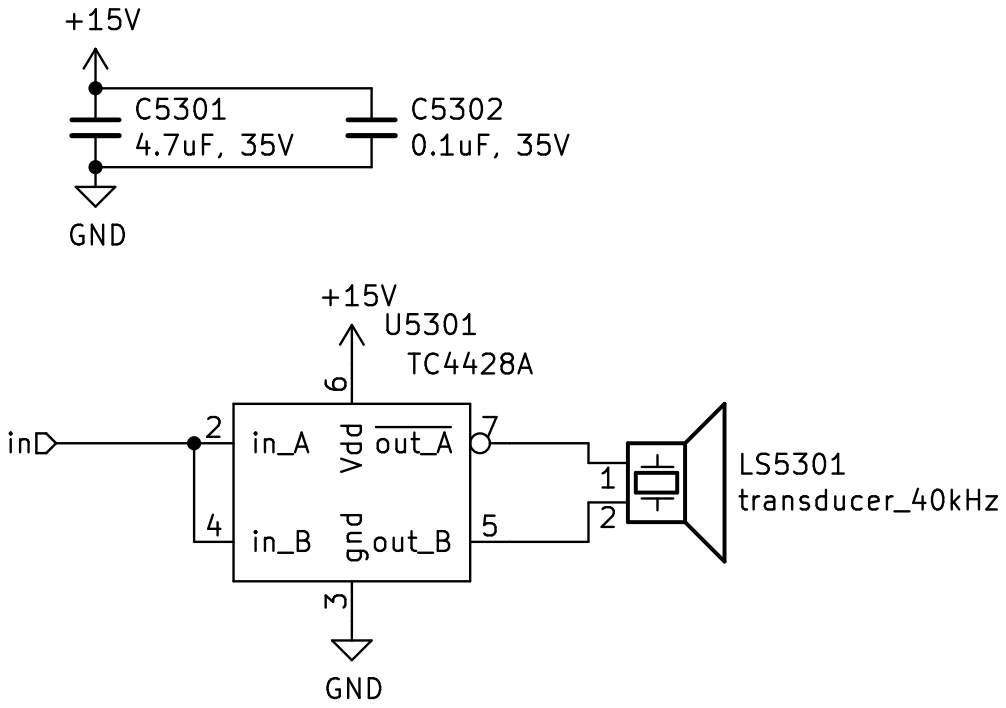
[picture p175: page 52]

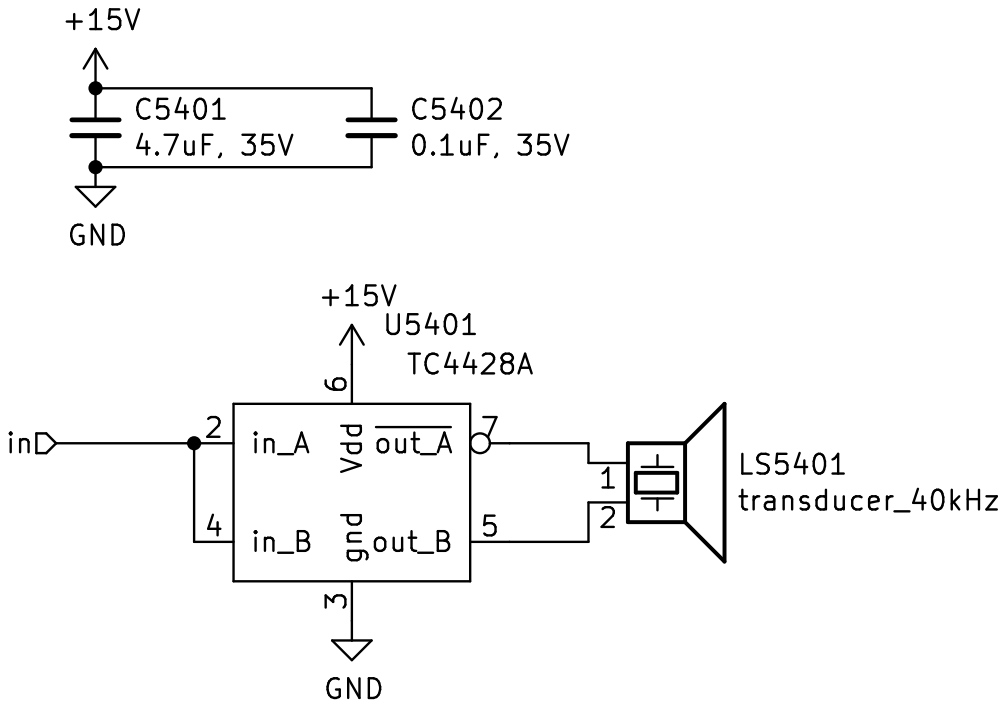
[picture p176: page 53]

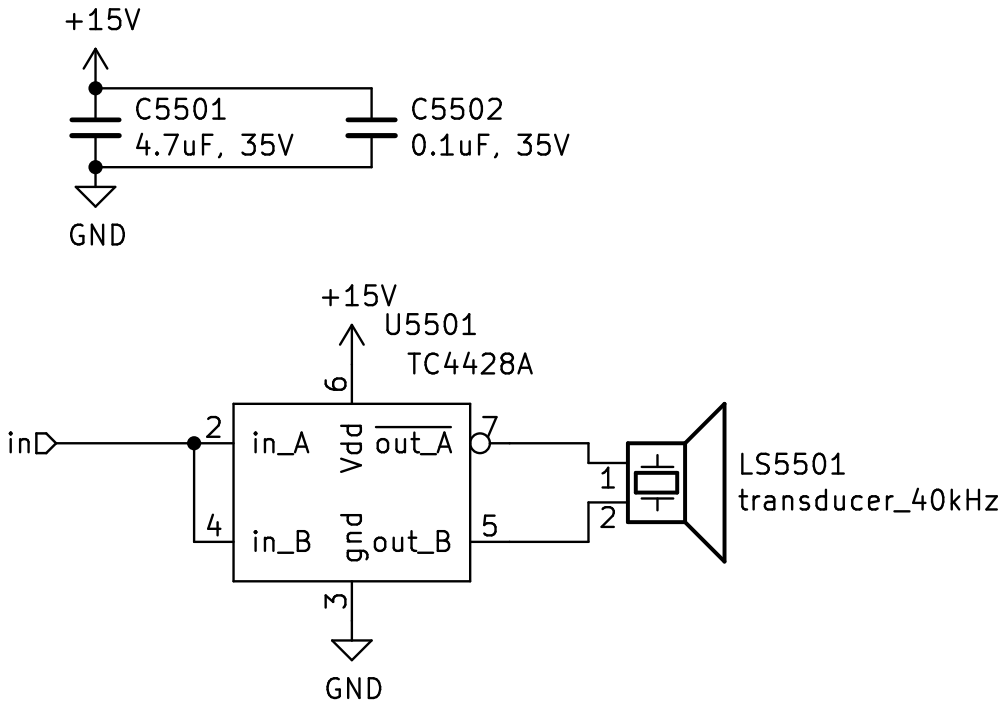
[picture p177: page 54]

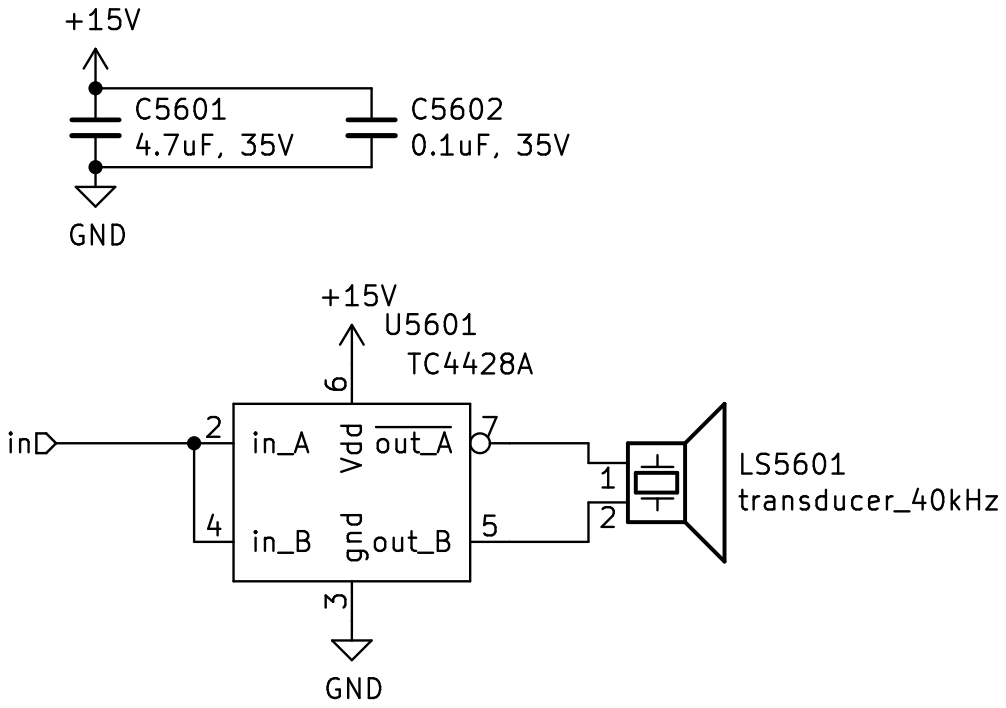
[picture p178: page 55]

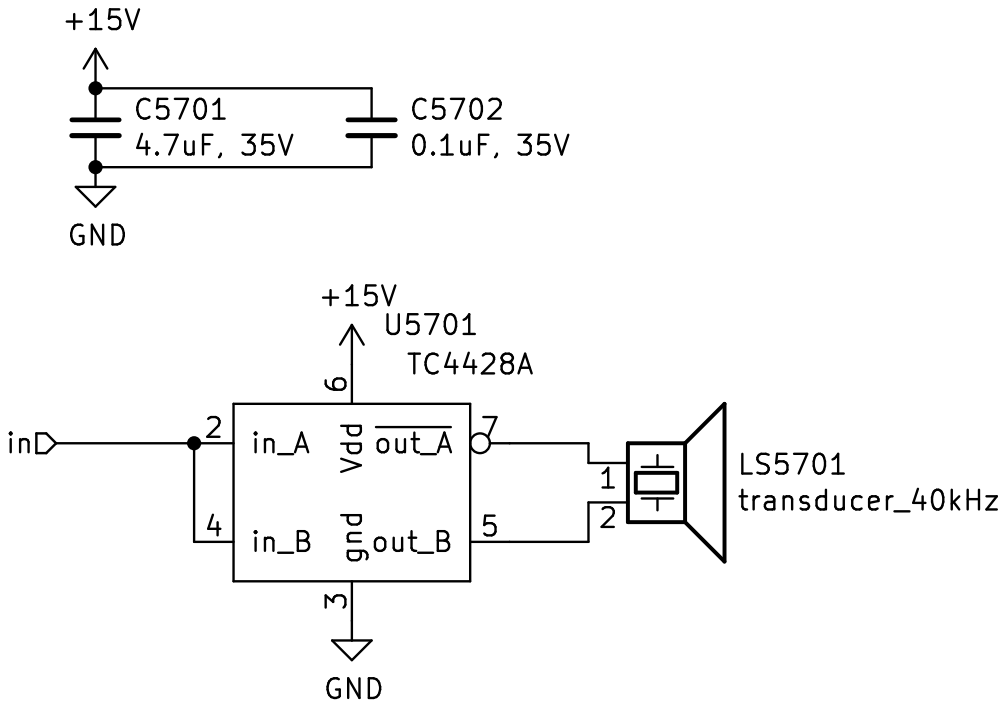
[picture p179: page 56]

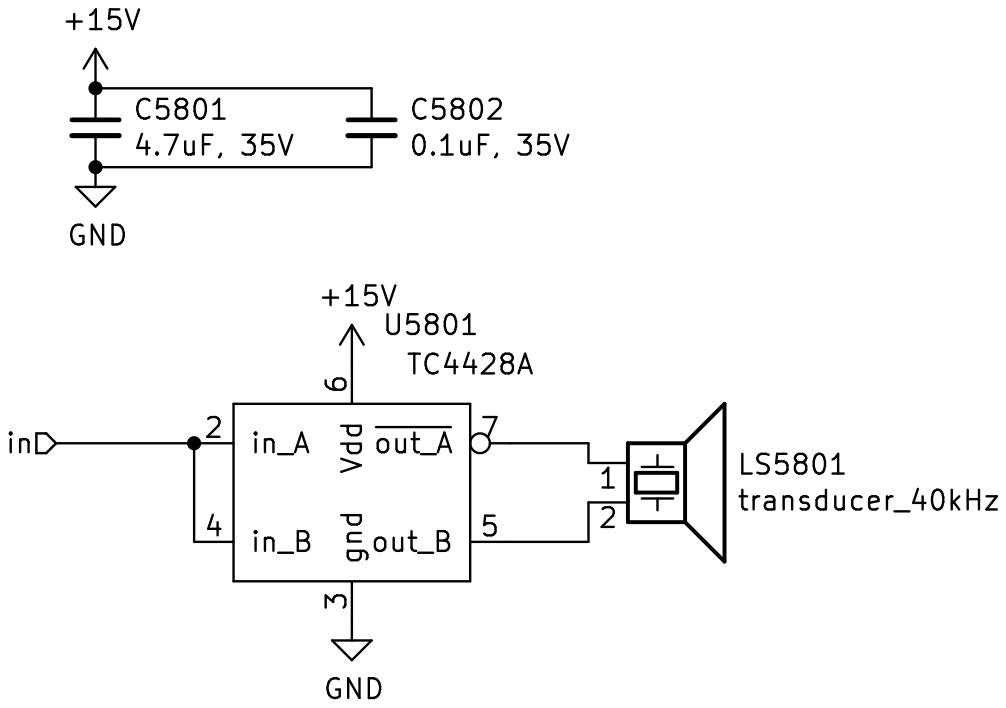
[picture p180: page 57]

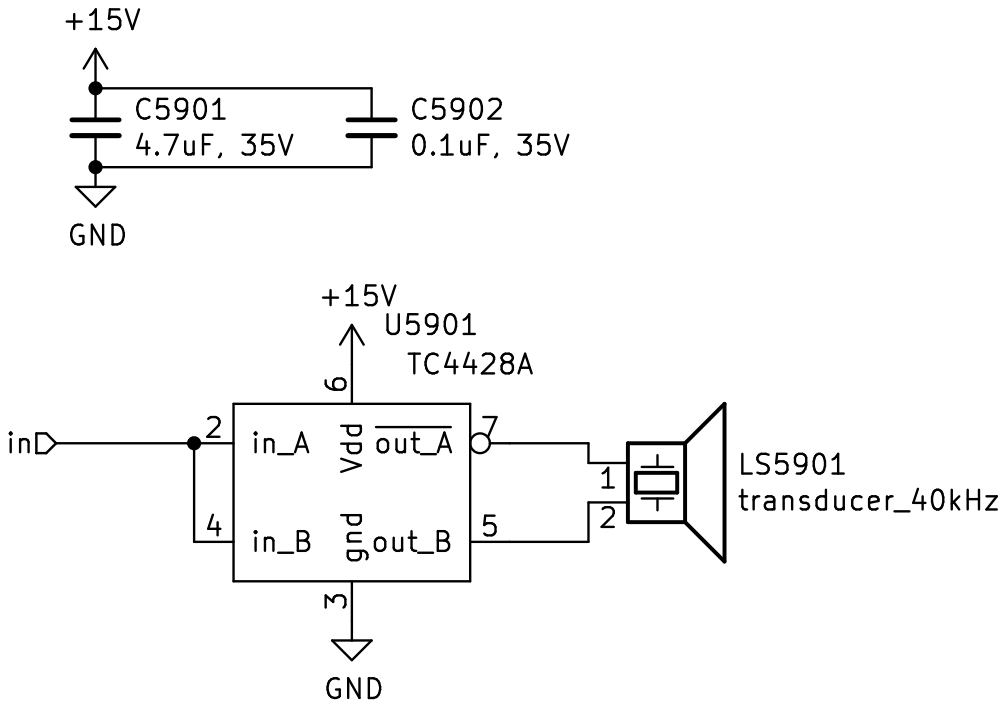
[picture p181: page 58]

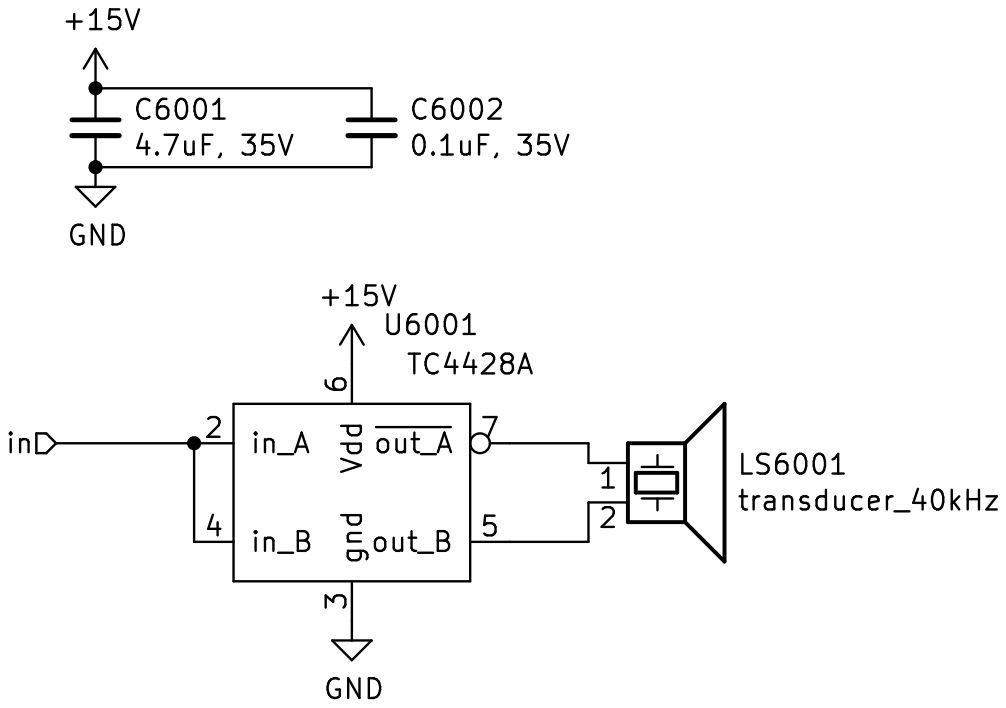
[picture p182: page 59]

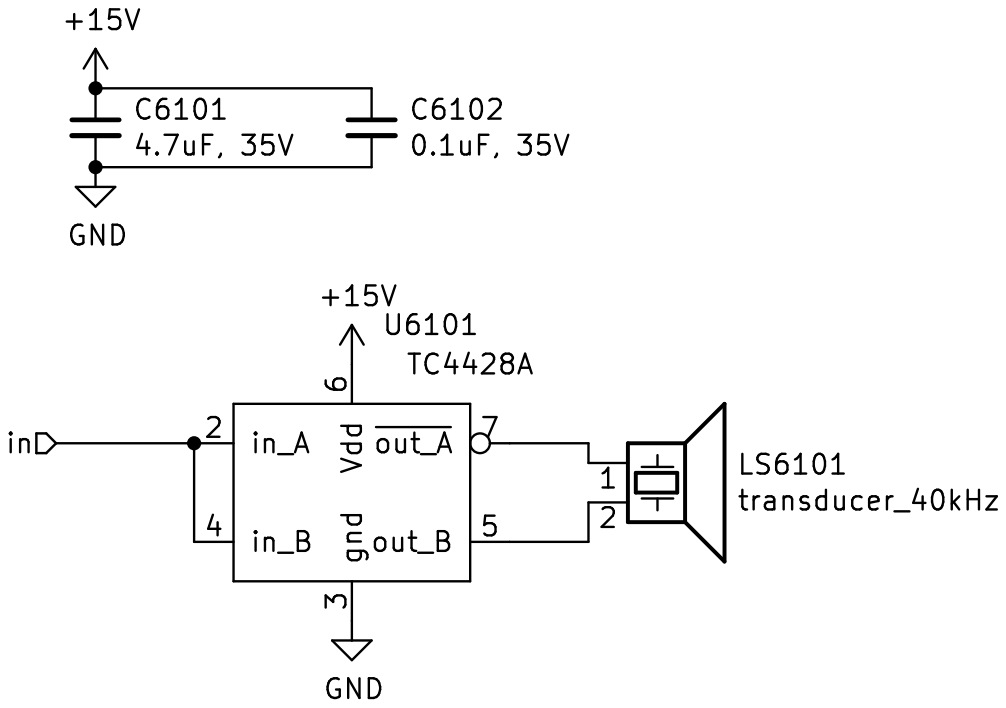
[picture p183: page 60]

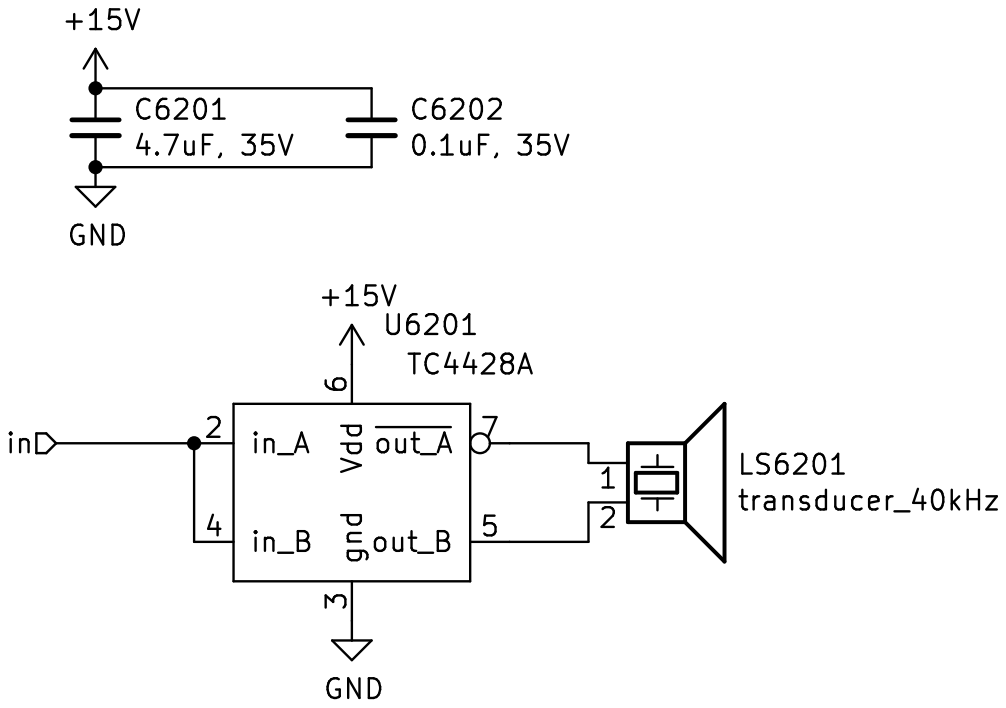
[picture p184: page 61]

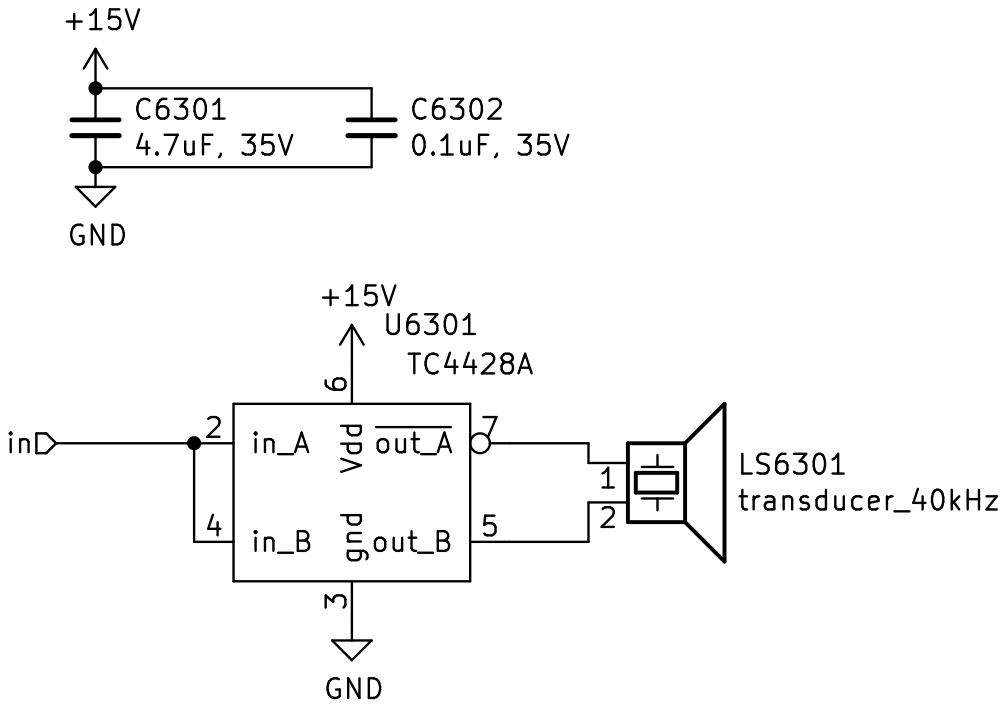
[picture p185: page 62]

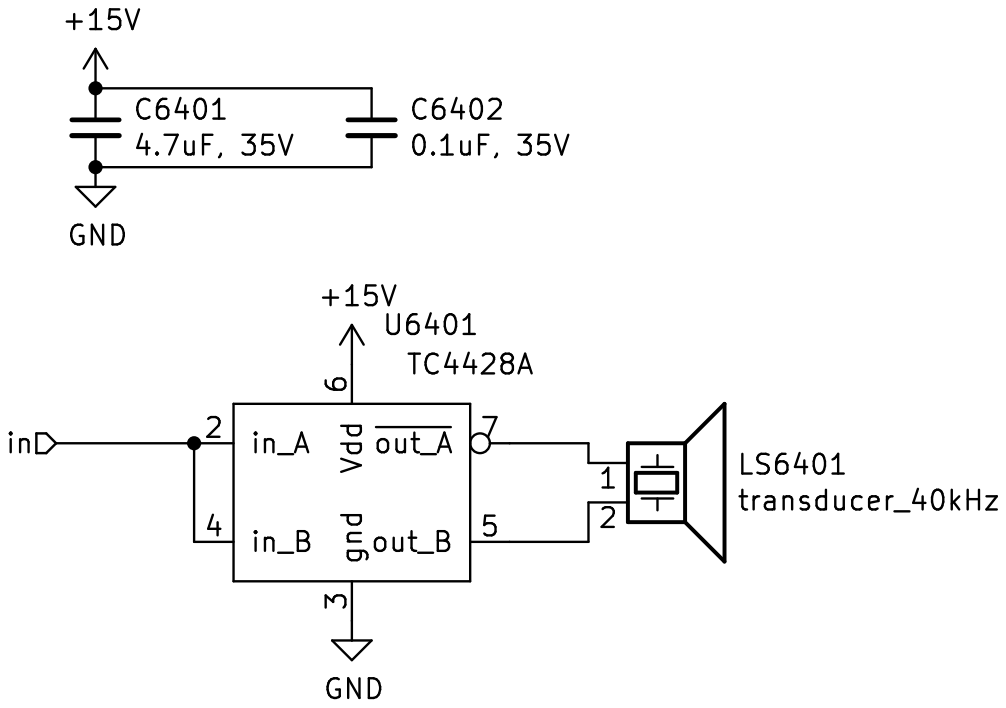
[picture p186: page 63]

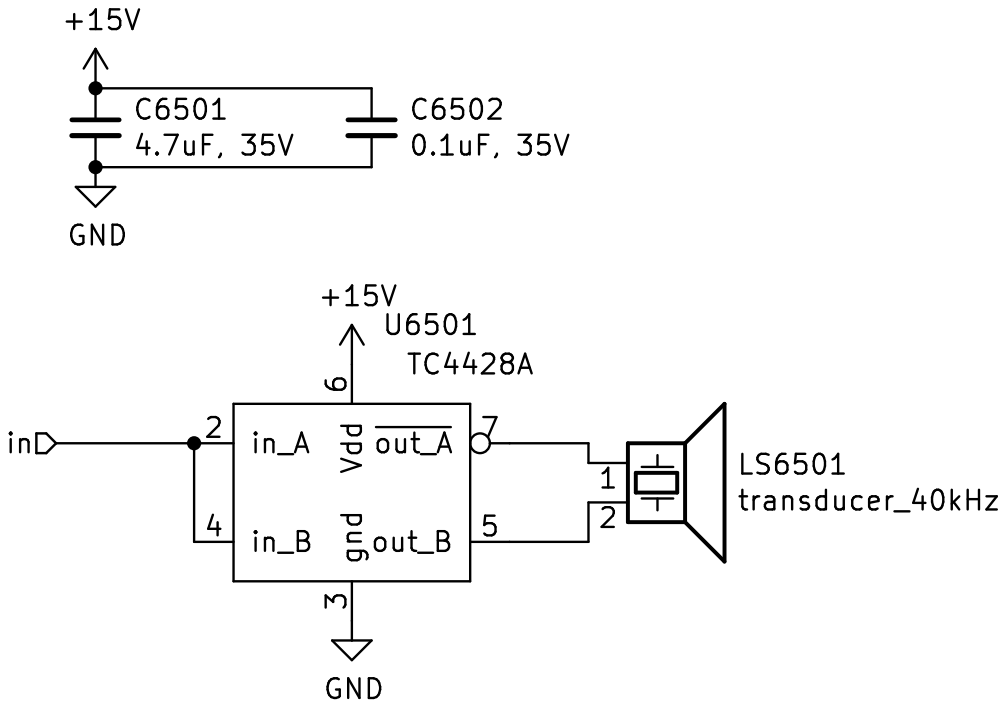
[picture p187: page 64]

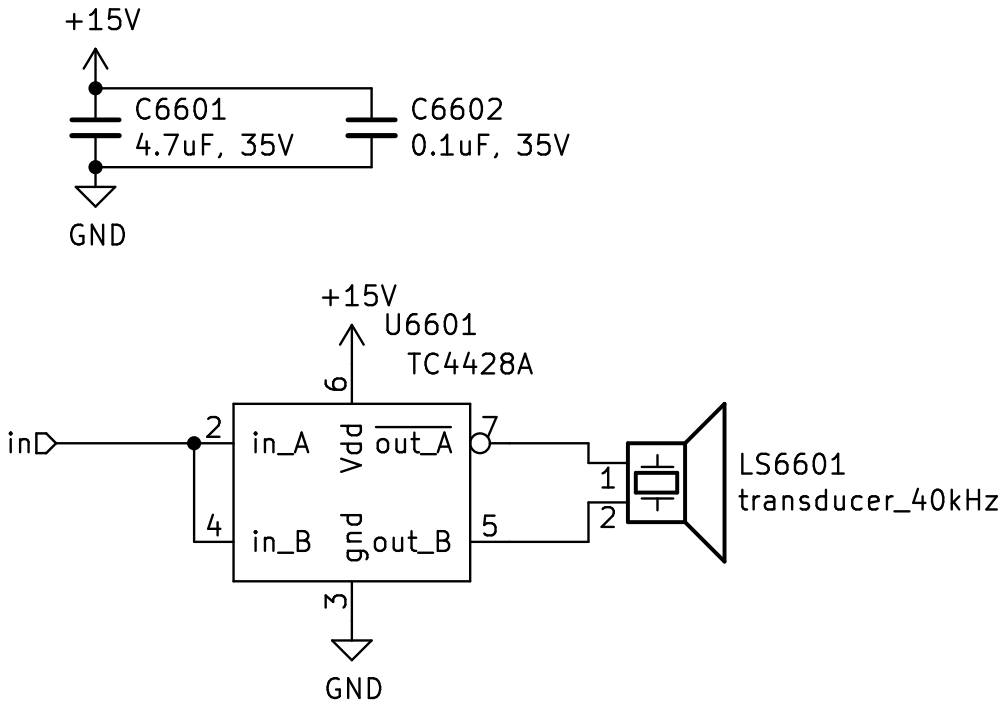
[picture p188: page 65]

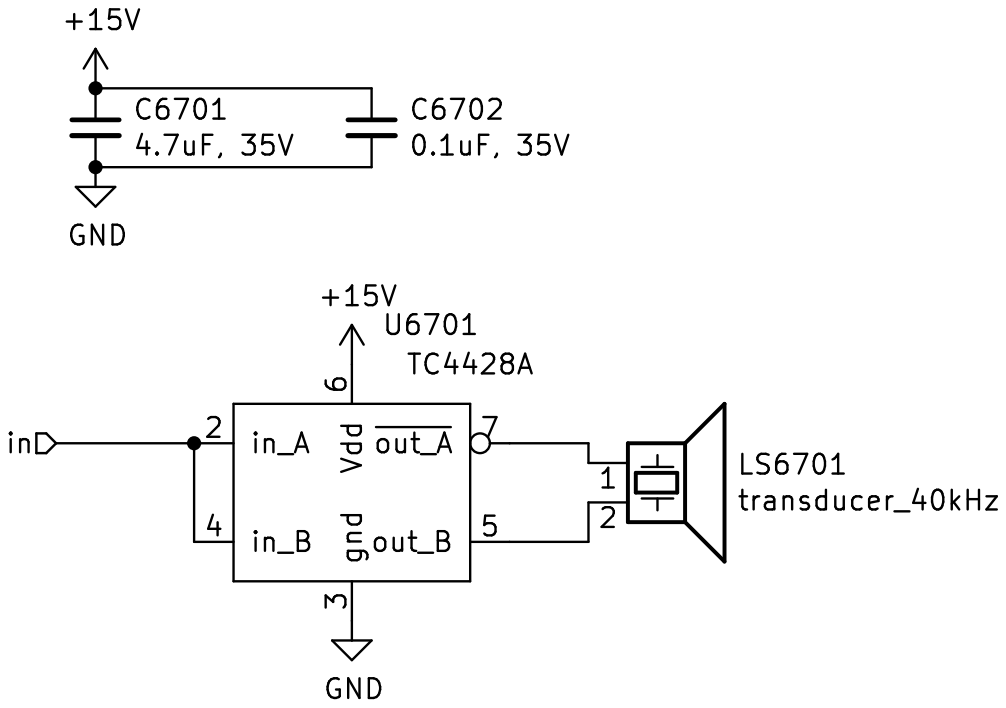
[picture p189: page 66]

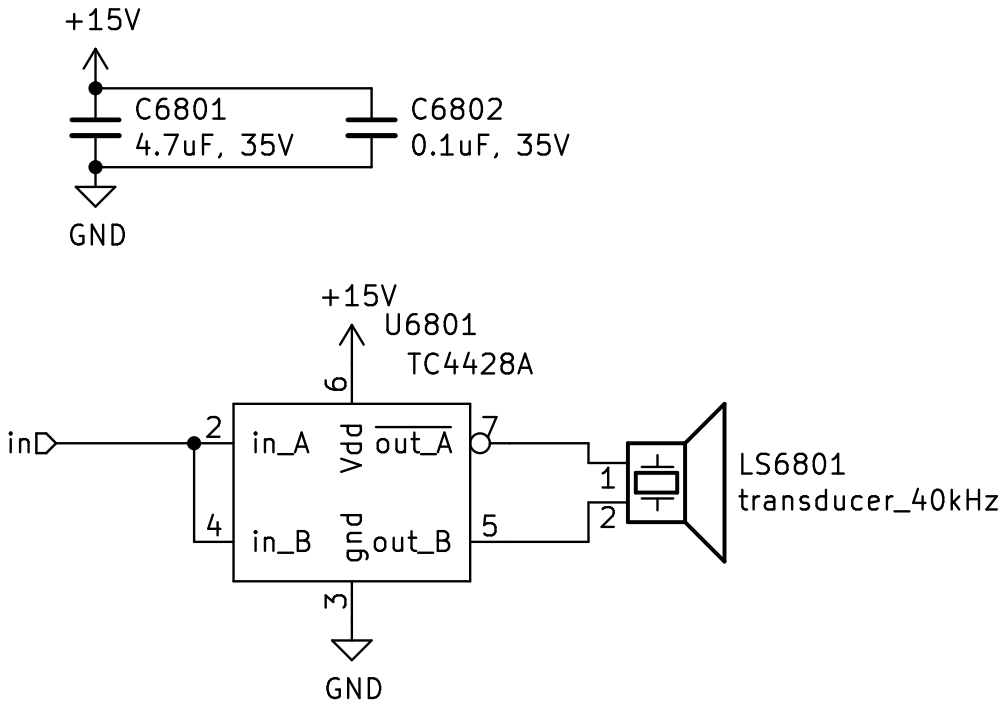
[picture p190: page 67]

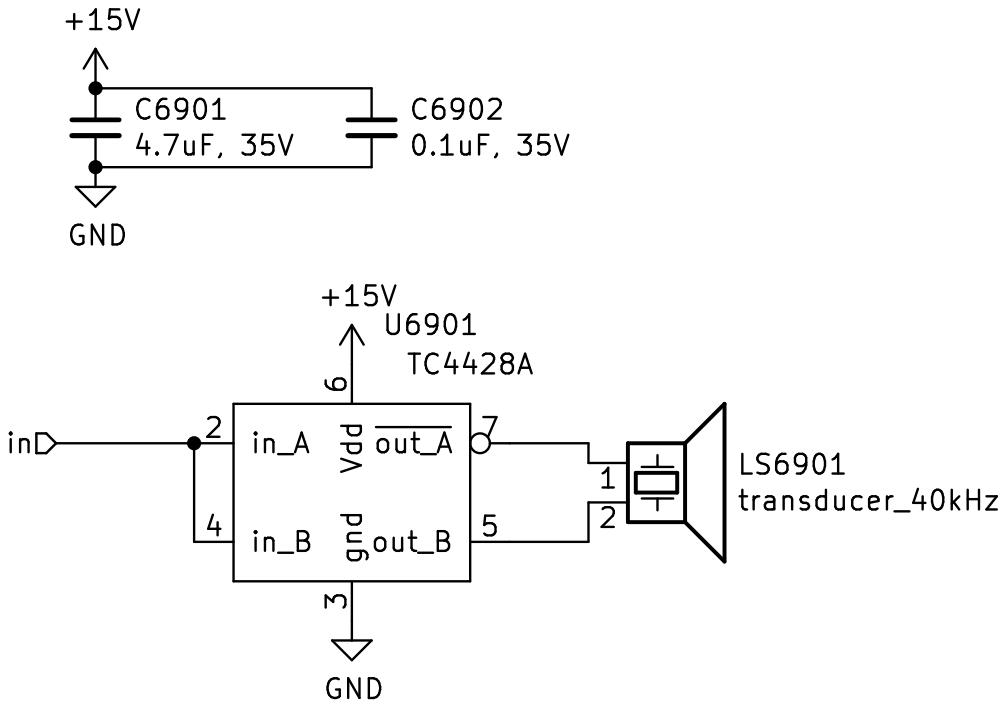
[picture p191: page 68]

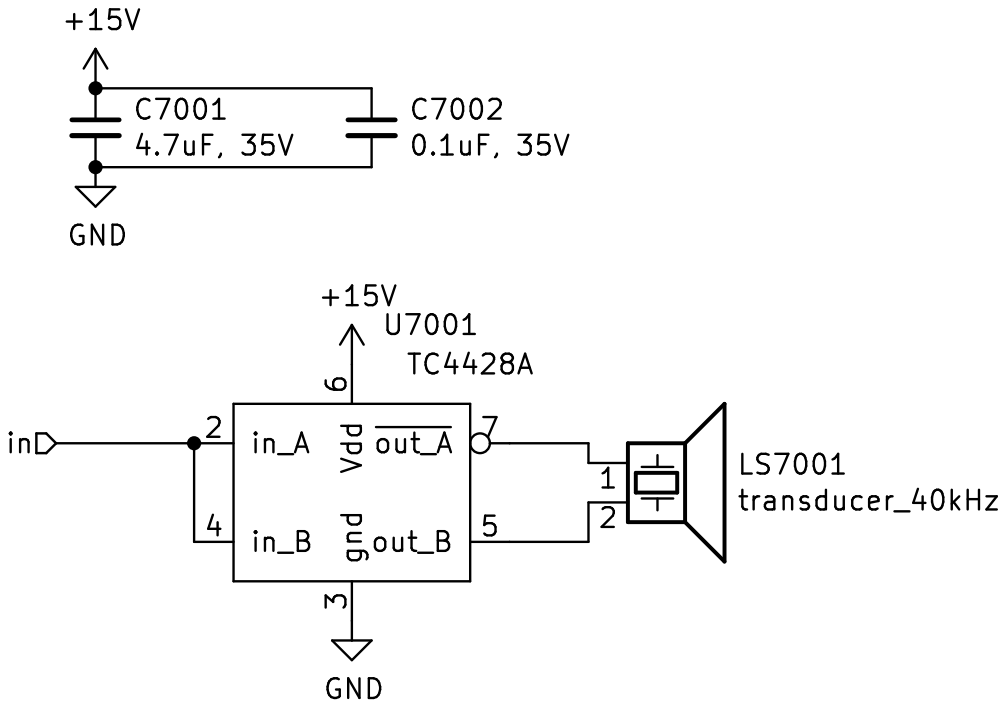
[picture p192: page 69]

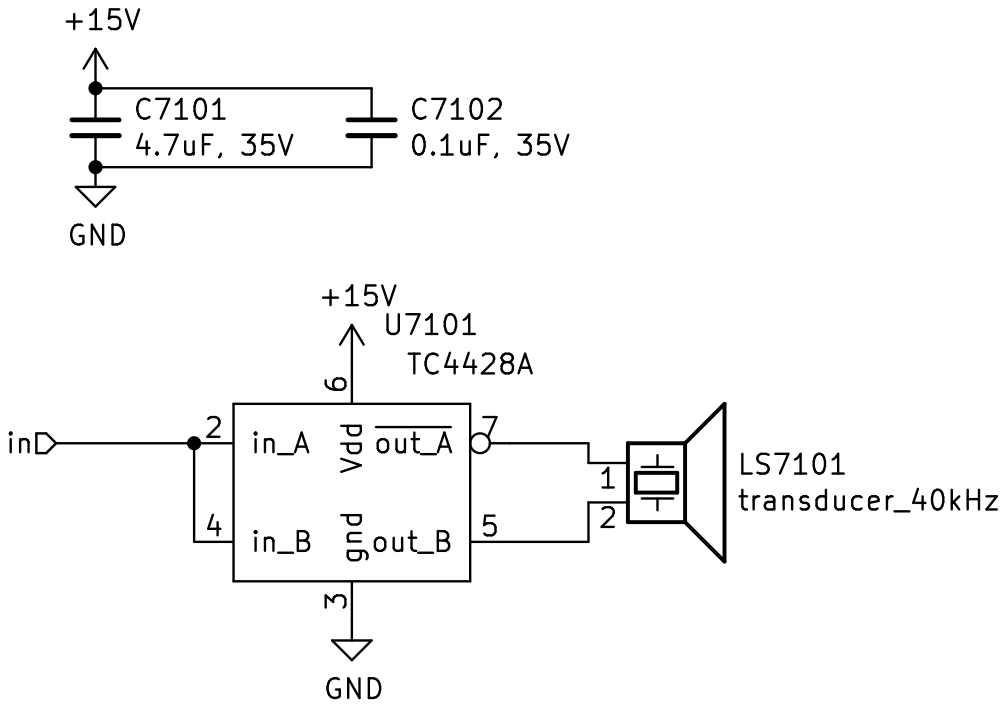
[picture p193: page 70]

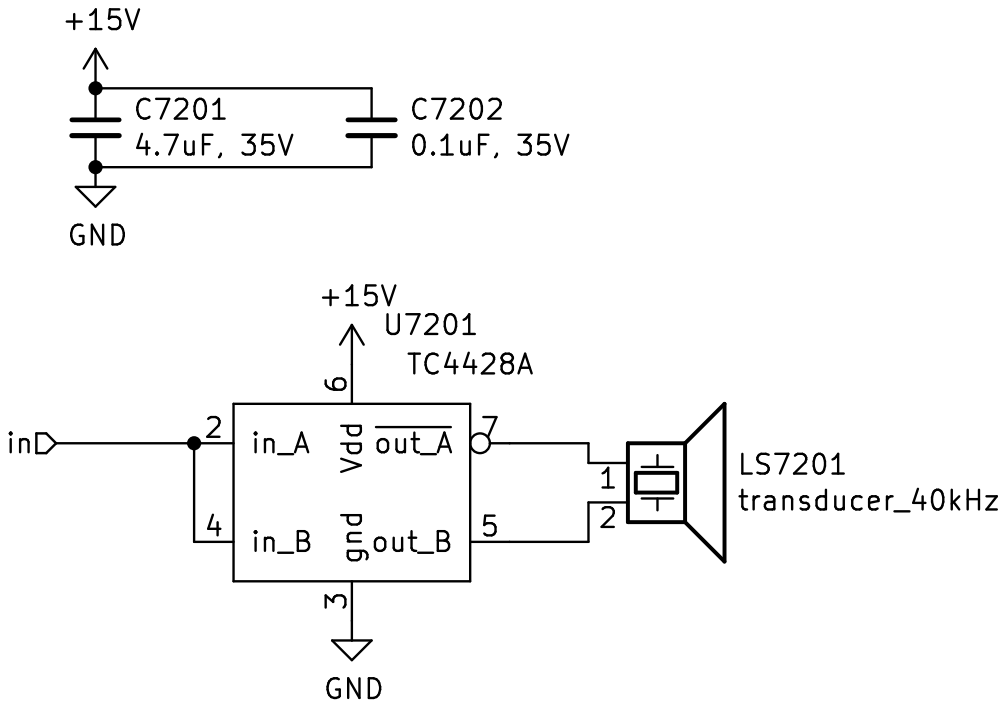
[picture p194: page 71]

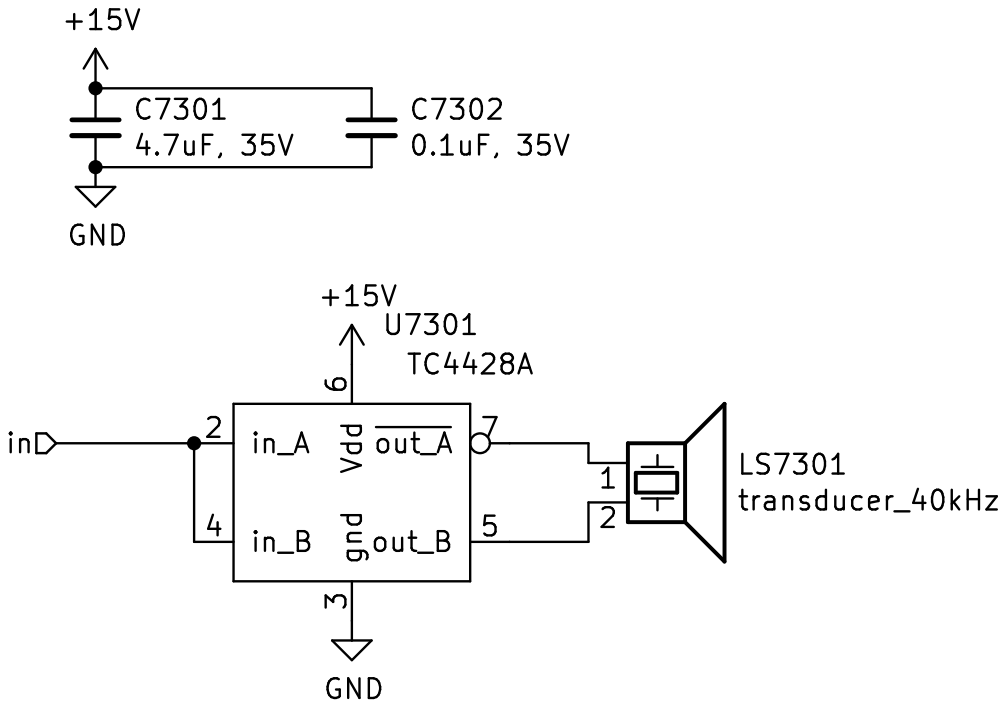
[picture p195: page 72]

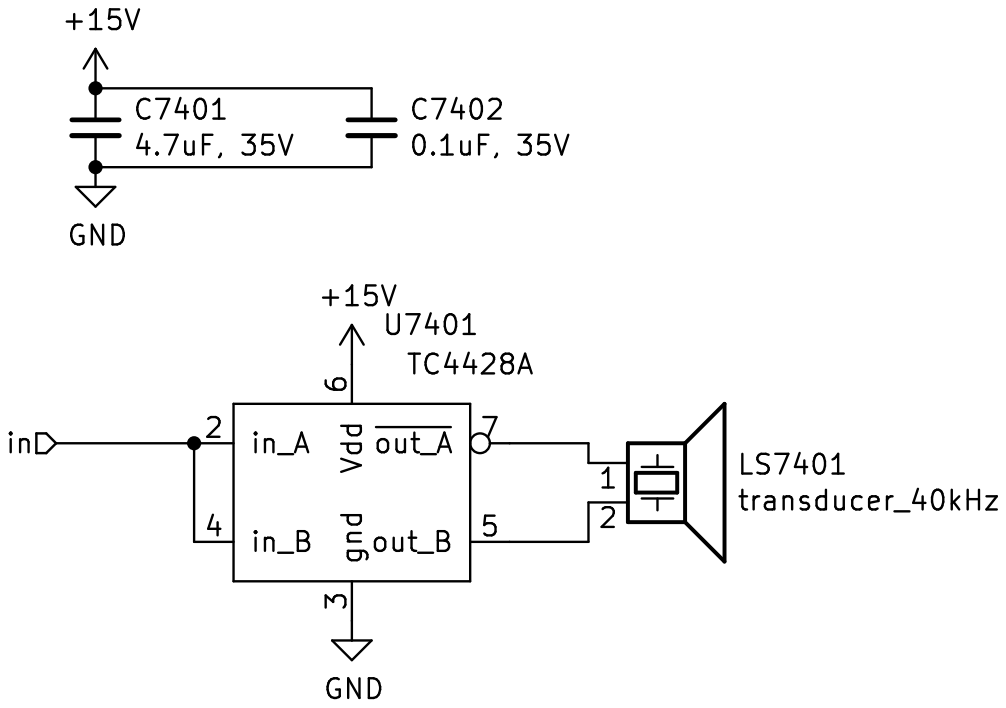
[picture p196: page 73]

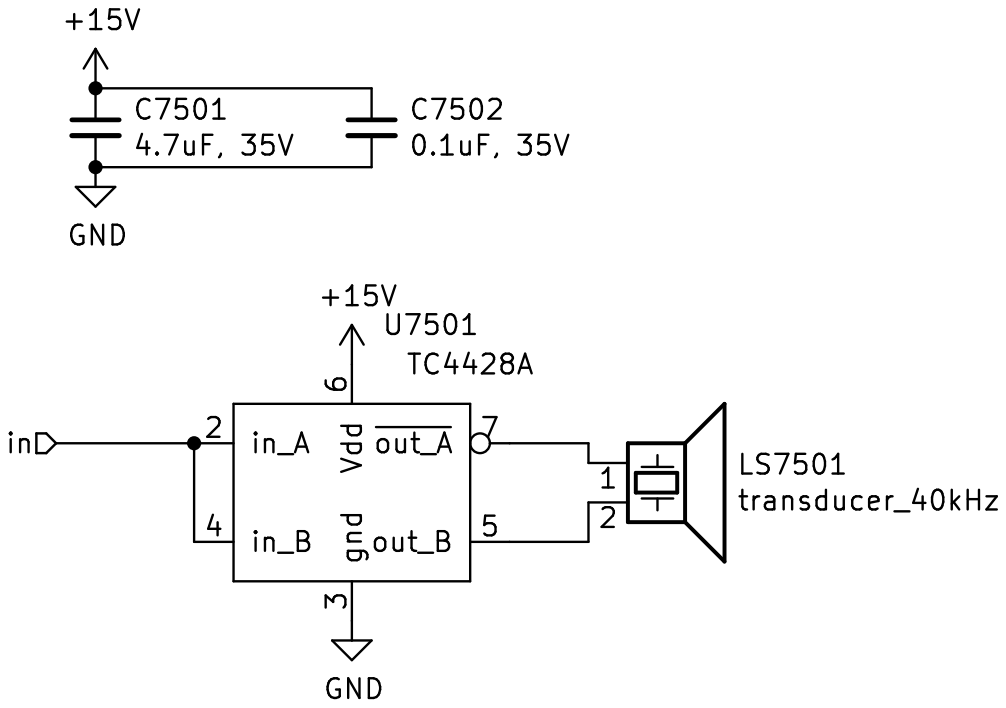
[picture p197: page 74]

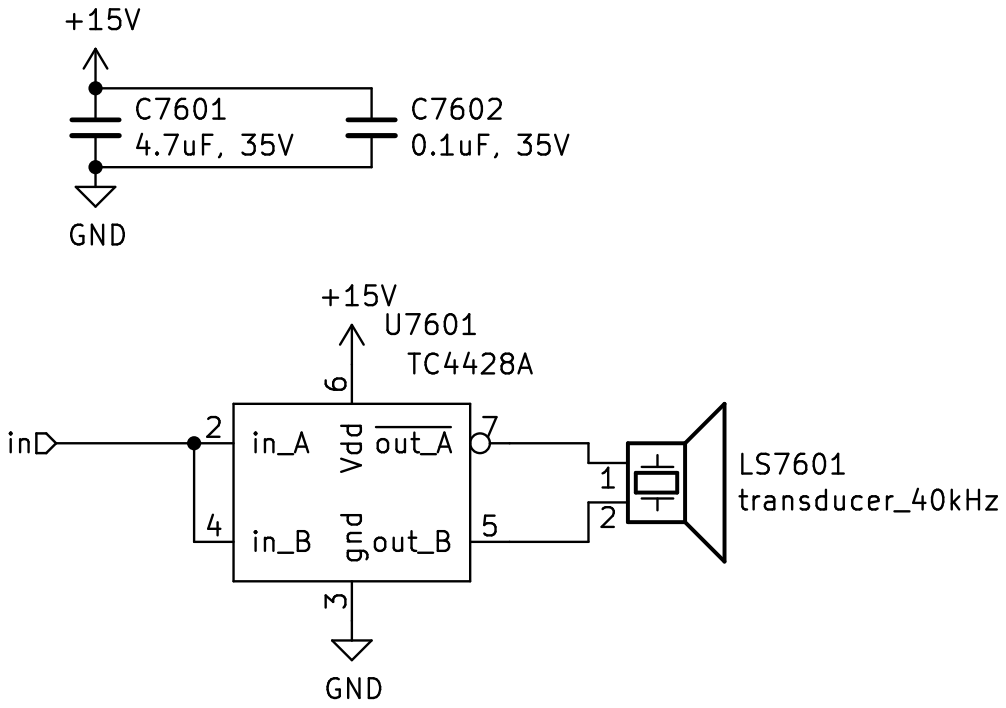
[picture p198: page 75]

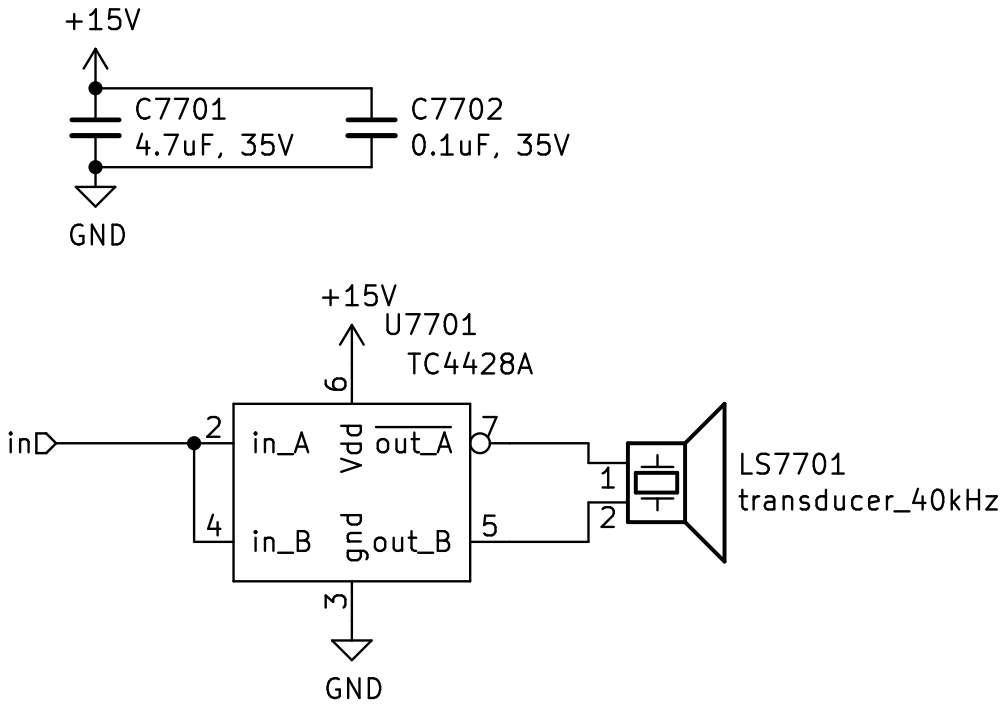
[picture p199: page 76]

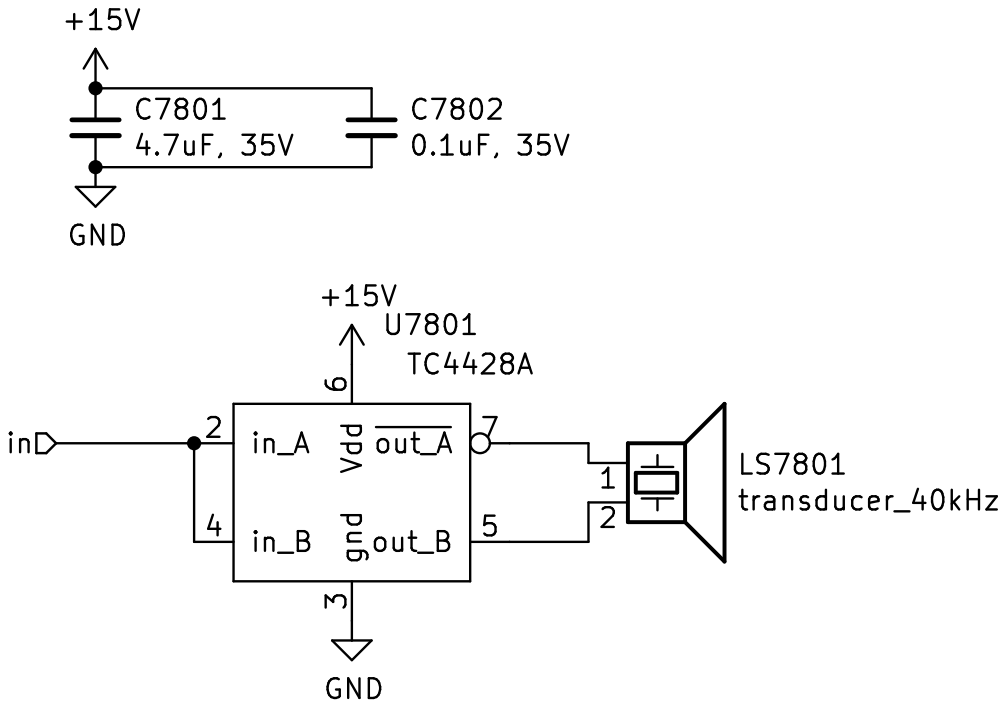
[picture p200: page 77]

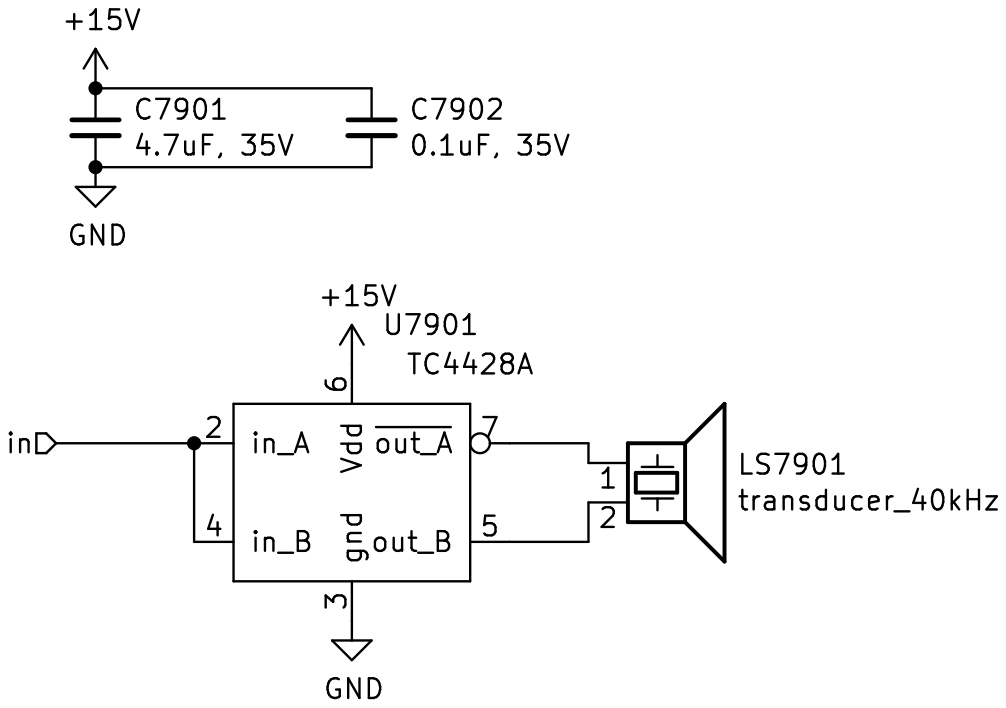
[picture p201: page 78]

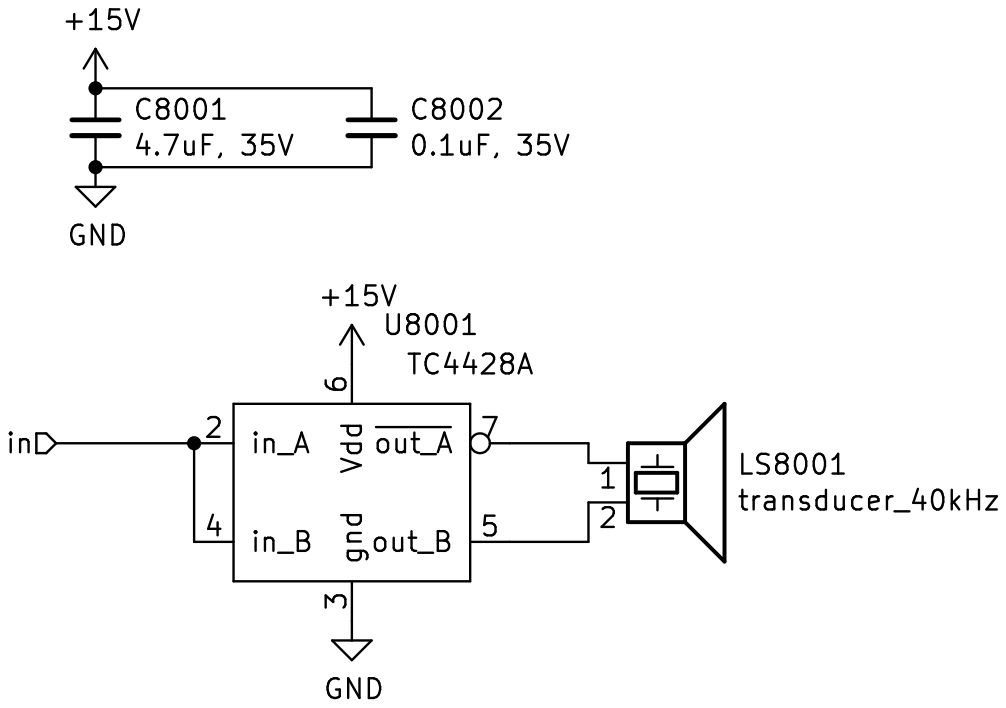
[picture p202: page 79]

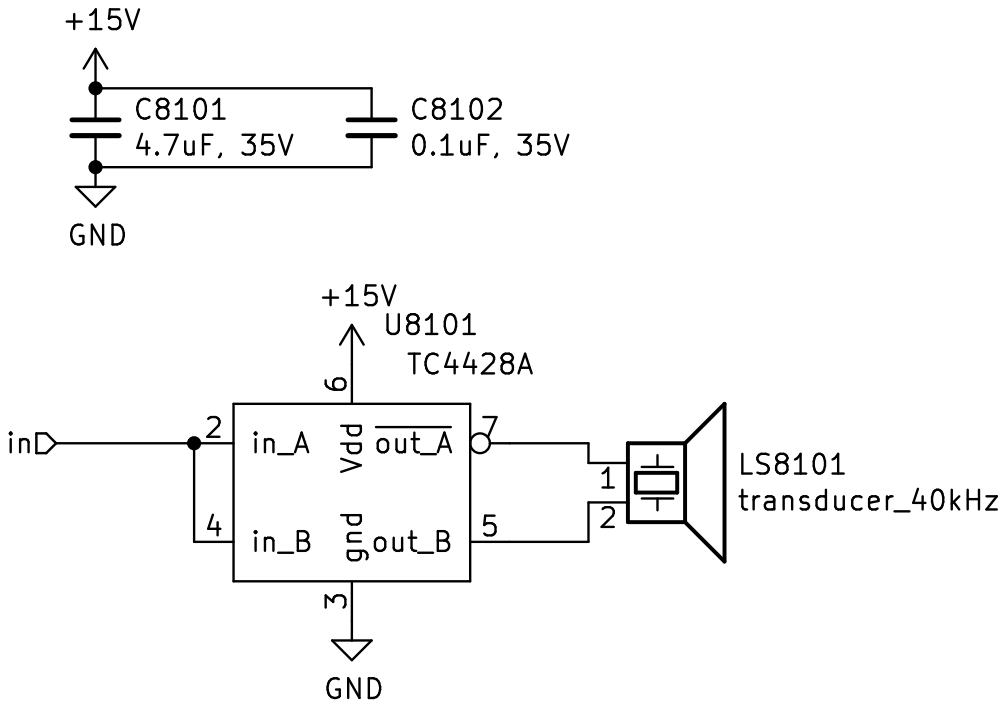
[picture p203: page 80]

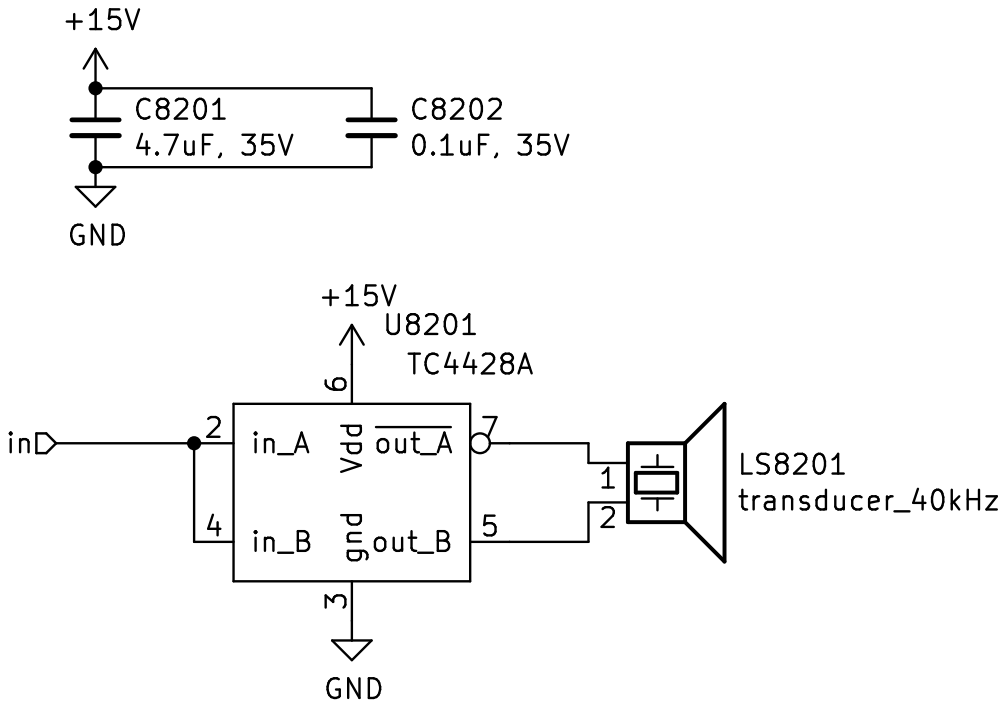
[picture p204: page 81]

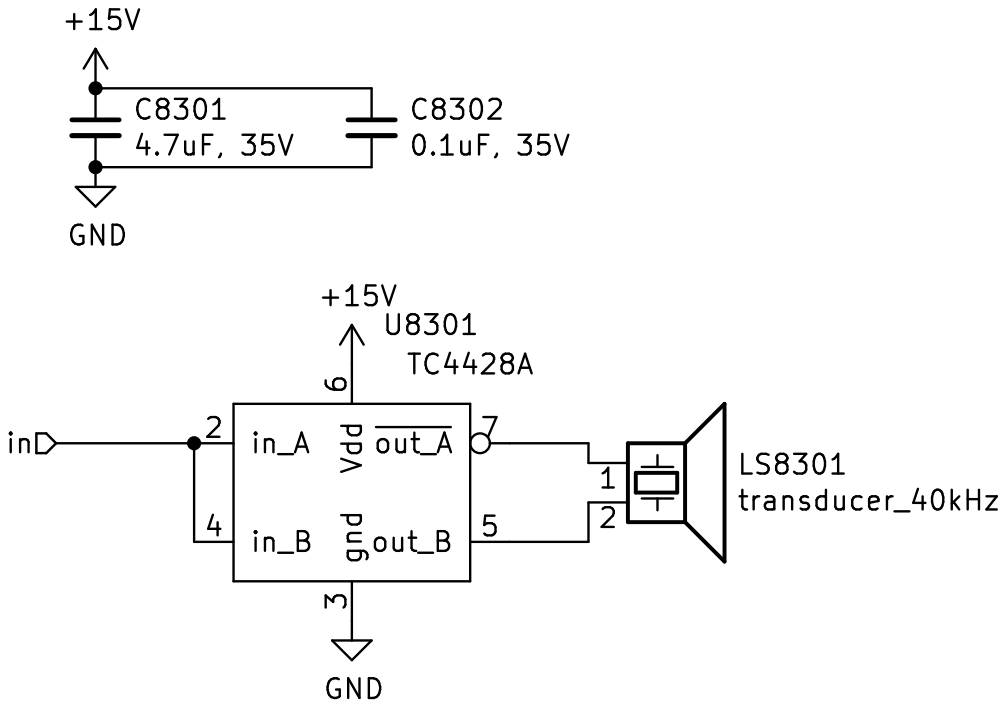
[picture p205: page 82]

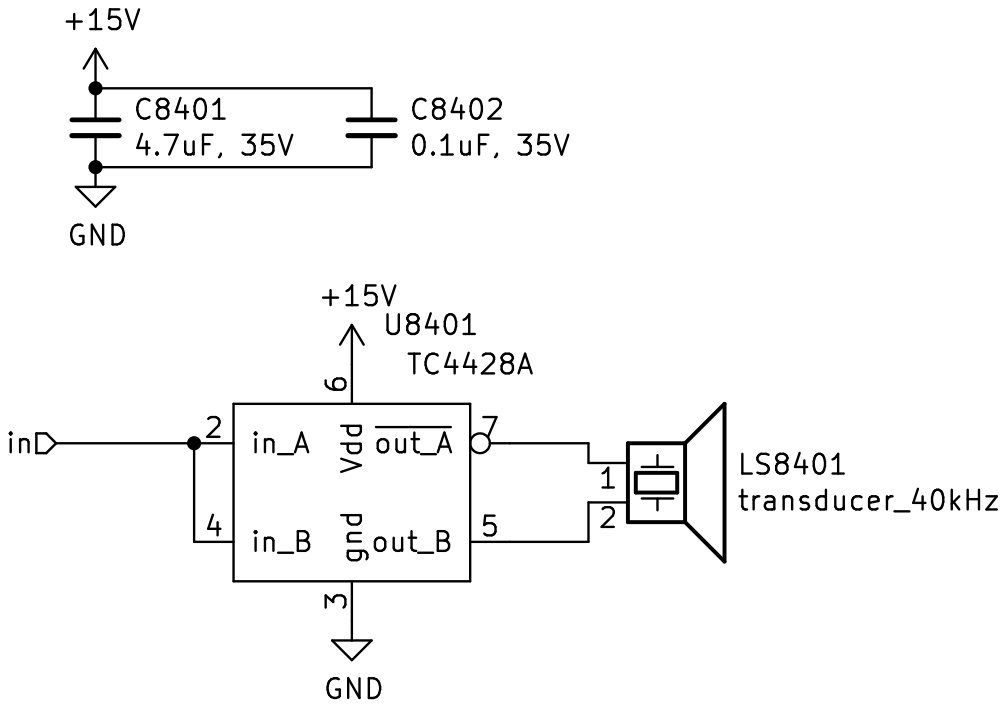
[picture p206: page 83]

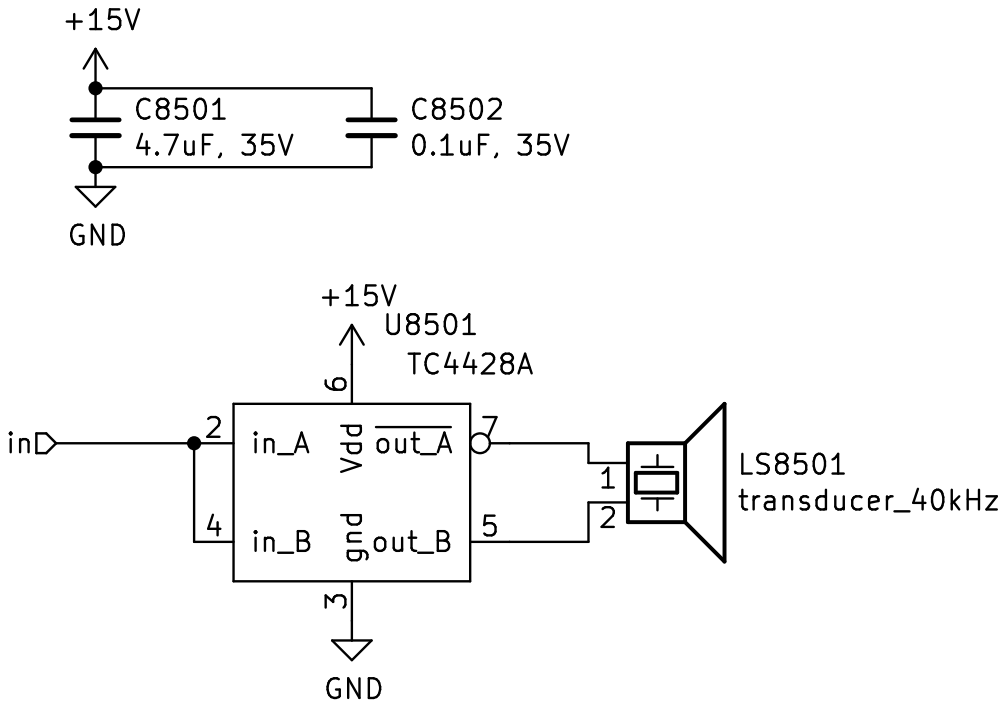
[picture p207: page 84]

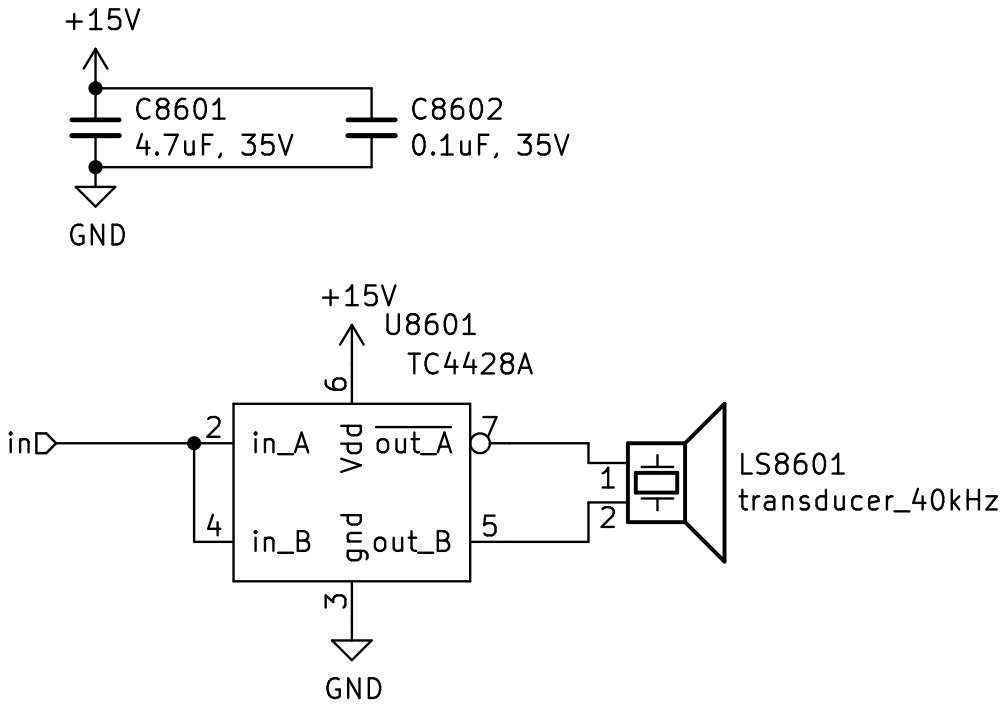
[picture p208: page 85]

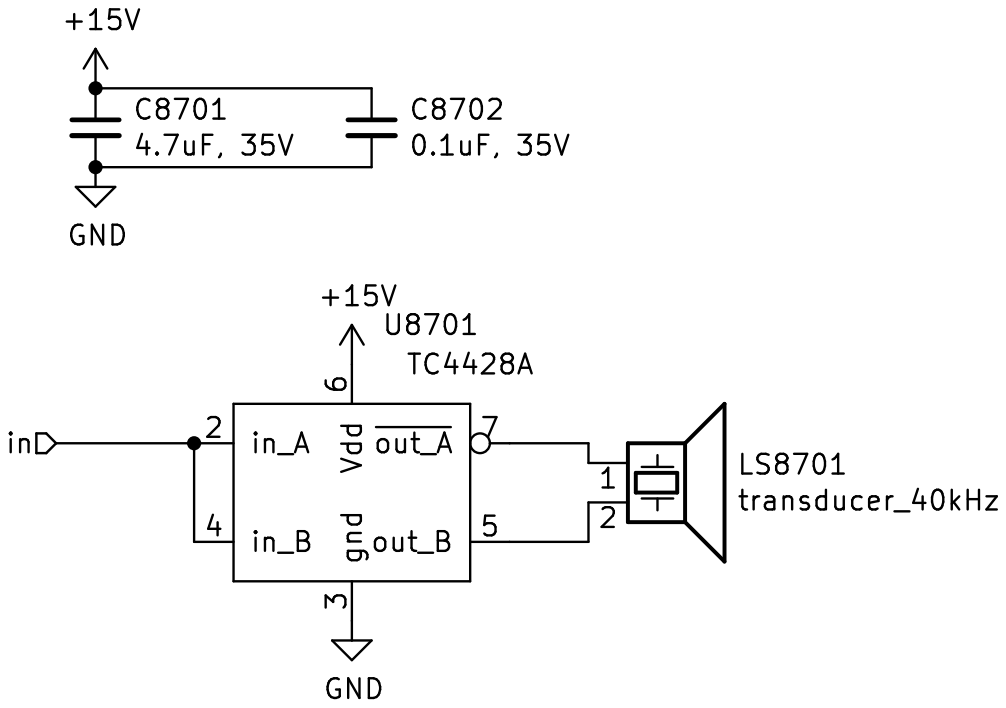
[picture p209: page 86]

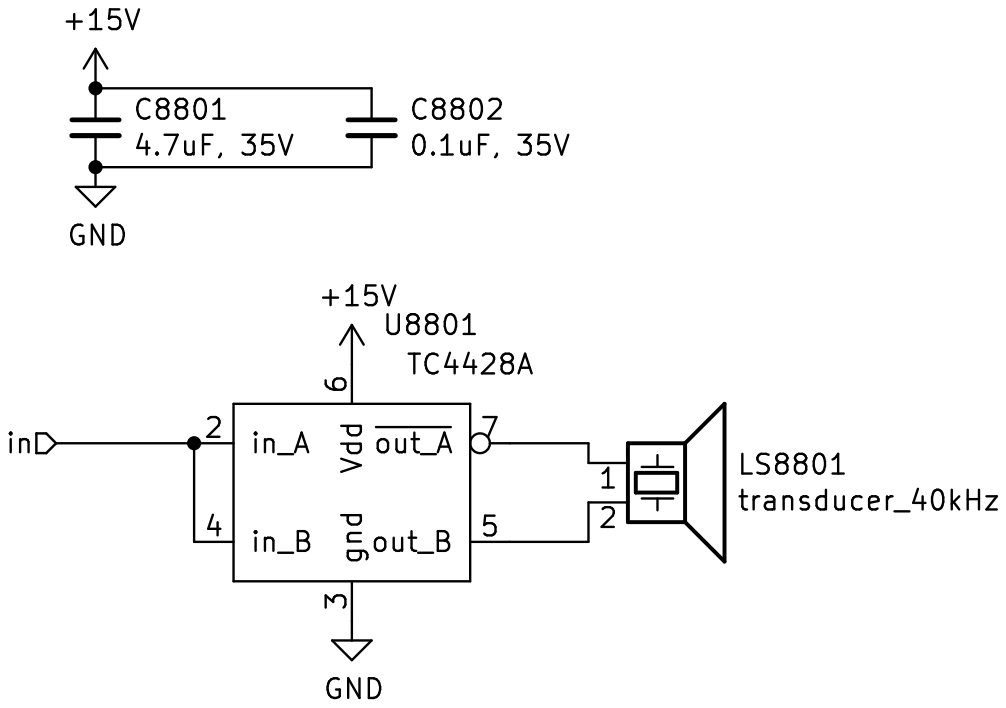
[picture p210: page 87]
