ThoMint/vdatp/board/floater.kicad_pcb

## KiCad design board/floater.kicad_pcb (2021-06-01)

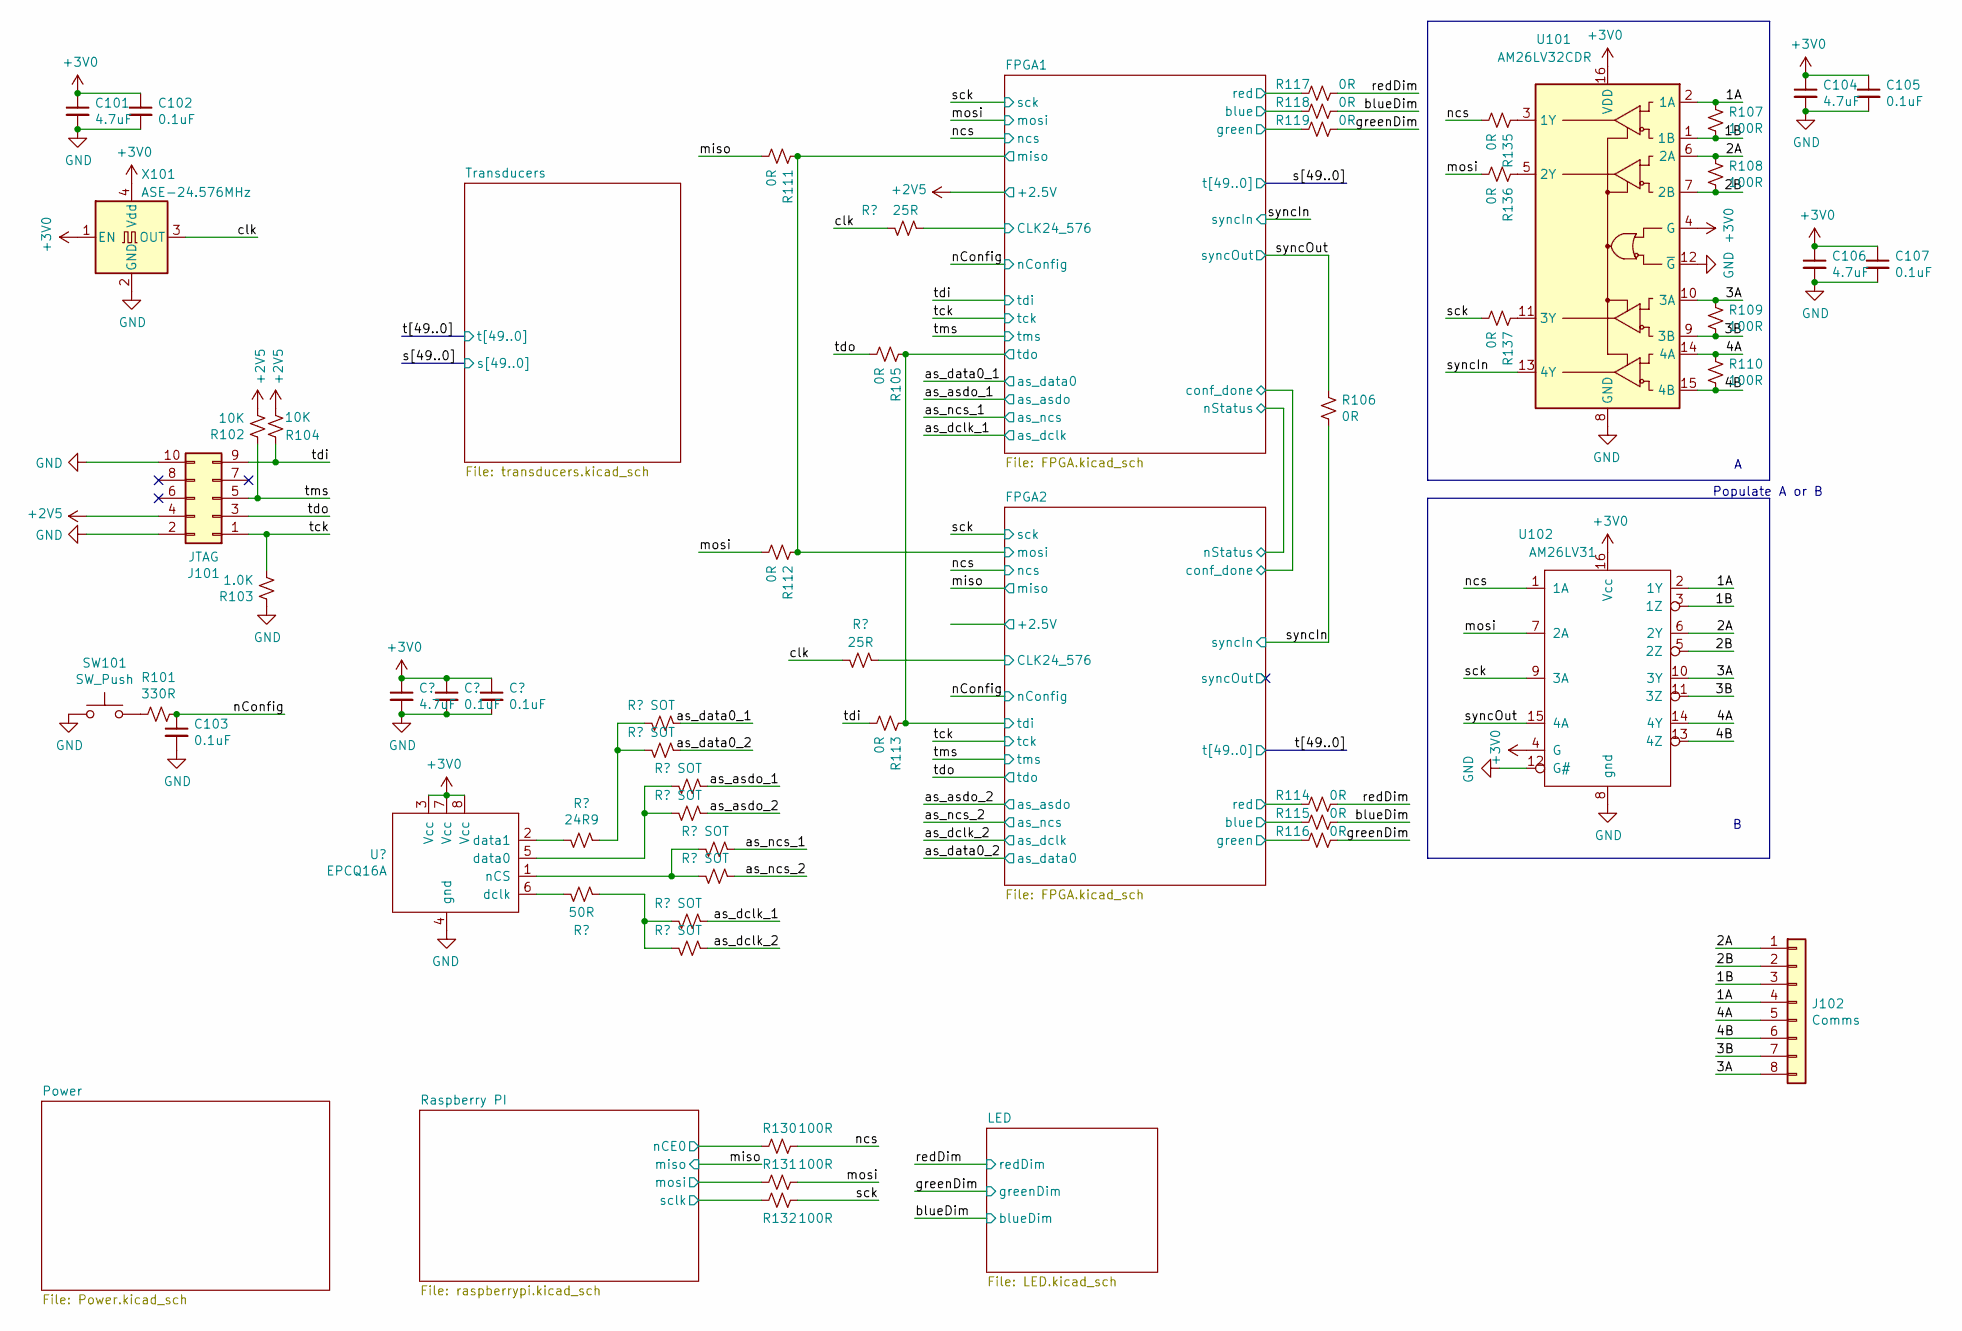
[picture p211: schematic floater.kicad_sch]

Parts:
C101, C104, C106, C108: 4.7uF; C_0603_1608Metric
C102, C103, C105, C107, C109, C110: 0.1uF; C_0402_1005Metric
J101: JTAG; PinHeader_2x05_P2.54mm_Vertical_Shrouded
J102: Comms; Hirose_DF13-08P-1.25DS_1x08_P1.25mm_Horizontal
R101: 330R; R_0402_1005Metric
R102, R104: 10K; R_0402_1005Metric
R103: 1.0K; R_0402_1005Metric
R105, R111, R112, R113, R114, R115, R116, R117, R118, R119, R135, R136, R137: 0R; R_0402_1005Metric
R106: 0R; SolderJumper-2_P1.3mm_Open_TrianglePad1.0x1.5mm
R107, R108, R109, R110, R130, R131, R132: 100R; R_0402_1005Metric
R120: 24R9; R_0402_1005Metric
R121: 50R; R_0402_1005Metric
R122, R123, R124, R125, R126, R127, R128, R129: SOT; R_0402_1005Metric
R133, R134: 25R; R_0402_1005Metric
SW101: SW_Push; SW_SPST_KMR2
U101: AM26LV32CDR; SOIC-16_3.9x9.9mm_P1.27mm
U102: AM26LV31; SOIC-16_3.9x9.9mm_P1.27mm
U103: EPCQ16A; SOIC-8_3.9x4.9mm_P1.27mm
X101: ASE-24.576MHz; ASFL1

Connections:
+3V0: C101.1, C102.1, C104.1, C105.1, C106.1, C107.1, C108.1, C109.1, C110.1, U101.4 (G), U101.16 (VDD), U102.4 (G), U102.16 (Vcc), U103.3 (Vcc), U103.7 (Vcc), U103.8 (Vcc), X101.1 (EN), X101.4 (Vdd); also elsewhere on the board
/1A: J102.4, R107.1, U101.2 (1A), U102.2 (1Y)
/1B: J102.3, R107.2, U101.1 (1B), U102.3 (1Z)
/2A: J102.1, R108.1, U101.6 (2A), U102.6 (2Y)
/2B: J102.2, R108.2, U101.7 (2B), U102.5 (2Z)
/3A: J102.8, R109.1, U101.10 (3A), U102.10 (3Y)
/3B: J102.7, R109.2, U101.9 (3B), U102.11 (3Z)
/4A: J102.5, R110.1, U101.14 (4A), U102.14 (4Y)
/4B: J102.6, R110.2, U101.15 (4B), U102.13 (4Z)
/FPGA1/CLK24_576: R134.2; also elsewhere on the board
/FPGA1/blue: R118.2; also elsewhere on the board
/FPGA1/green: R119.2; also elsewhere on the board
/FPGA1/miso: R111.1, R112.1; also elsewhere on the board
/FPGA1/red: R117.2; also elsewhere on the board
/FPGA2/CLK24_576: R133.2; also elsewhere on the board
/FPGA2/blue: R115.2; also elsewhere on the board
/FPGA2/green: R116.2; also elsewhere on the board
/FPGA2/red: R114.2; also elsewhere on the board
/FPGA2/tdi: R105.1, R113.1; also elsewhere on the board
/Raspberry PI/mosi: R131.2; also elsewhere on the board
/Raspberry PI/nCE0: R130.2; also elsewhere on the board
/Raspberry PI/sclk: R132.2; also elsewhere on the board
/as_asdo_1: R124.2; also elsewhere on the board
/as_asdo_2: R125.2; also elsewhere on the board
/as_data0_1: R122.2; also elsewhere on the board
/as_data0_2: R123.2; also elsewhere on the board
/as_dclk_1: R126.2; also elsewhere on the board
/as_dclk_2: R127.2; also elsewhere on the board
/as_ncs_1: R128.2; also elsewhere on the board
/as_ncs_2: R129.2; also elsewhere on the board
/blueDim: R115.1, R118.1; also elsewhere on the board
/clk: R133.1, R134.1, X101.3 (OUT)
/greenDim: R116.1, R119.1; also elsewhere on the board
/miso: R111.2; also elsewhere on the board
/mosi: R112.2, R131.1, R136.2, U102.7 (2A); also elsewhere on the board
/nConfig: C103.1, R101.2; also elsewhere on the board
/ncs: R130.1, R135.2, U102.1 (1A); also elsewhere on the board
/redDim: R114.1, R117.1; also elsewhere on the board
/sck: R132.1, R137.2, U102.9 (3A); also elsewhere on the board
/syncIn: R106.2, U101.13 (4Y); also elsewhere on the board
/syncOut: R106.1, U102.15 (4A); also elsewhere on the board
/tck: J101.1, R103.2; also elsewhere on the board
/tdi: J101.9, R104.1, R113.2; also elsewhere on the board
/tdo: J101.3, R105.2; also elsewhere on the board
/tms: J101.5, R102.1; also elsewhere on the board
GND: C101.2, C102.2, C103.2, C104.2, C105.2, C106.2, C107.2, C108.2, C109.2, C110.2, J101.2, J101.10, R103.1, SW101.1, U101.8 (GND), U101.12 (~G), U102.8 (gnd), U102.12 (G#), U103.4 (gnd), X101.2 (GND); also elsewhere on the board
unnamed: R101.1, SW101.2
unnamed: R120.1, U103.2 (data1)
unnamed: R120.2, R122.1, R123.1
unnamed: R121.1, U103.6 (dclk)
unnamed: R121.2, R126.1, R127.1
unnamed: R124.1, R125.1, U103.5 (data0)
unnamed: R128.1, R129.1, U103.1 (nCS)
unnamed: R135.1, U101.3 (1Y)
unnamed: R136.1, U101.5 (2Y)
unnamed: R137.1, U101.11 (3Y)

Notes on the sheet:
Populate A or B

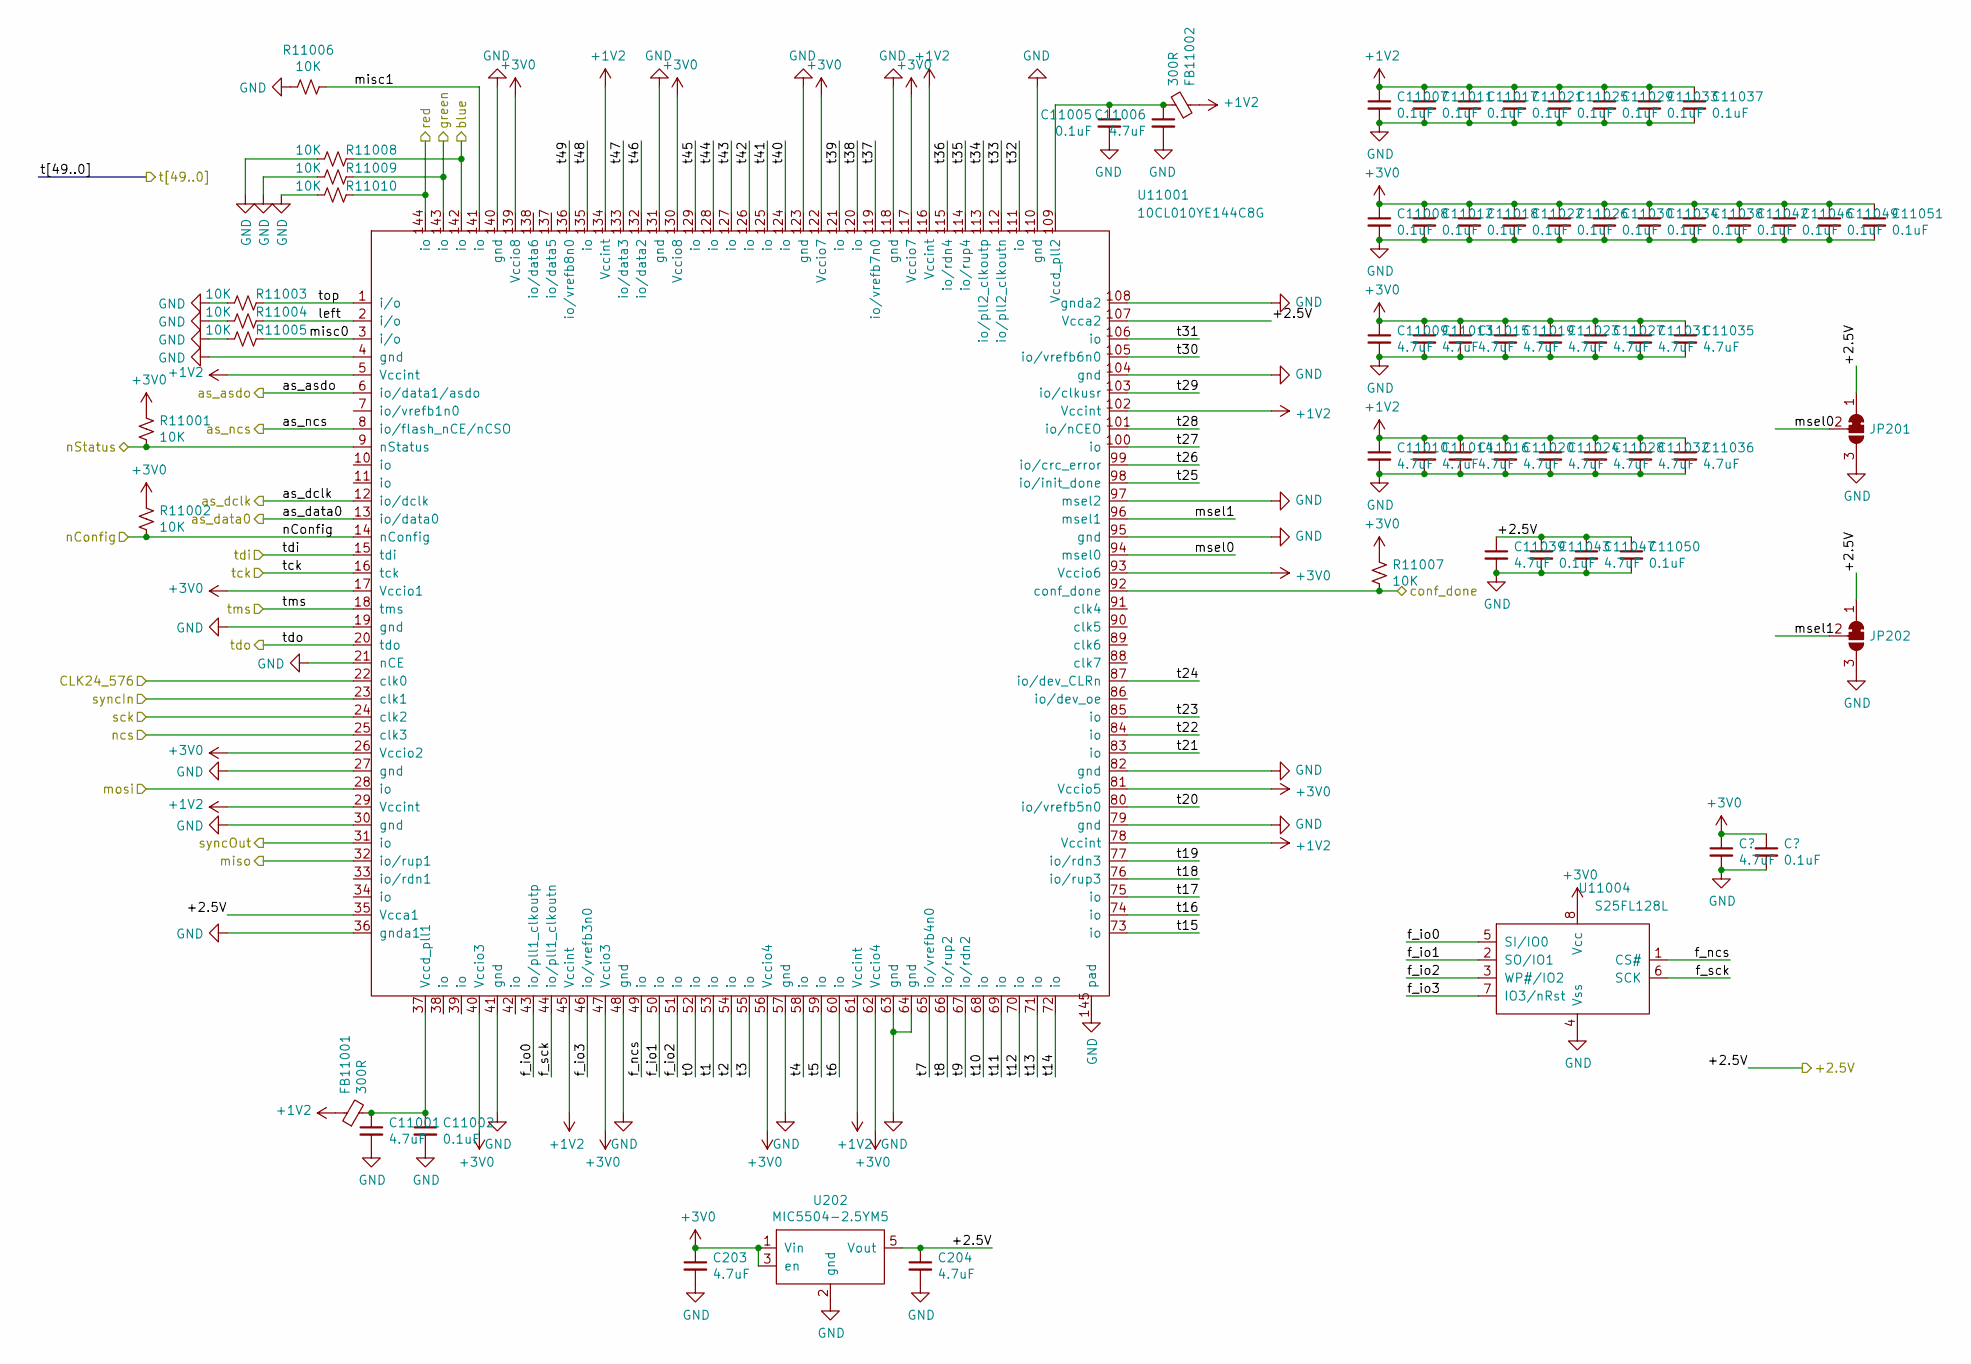
[picture p212: schematic FPGA.kicad_sch]

Parts:
C203, C204, C241, C11001, C11006, C11009, C11010, C11013, C11014, C11015, C11016, C11019, C11020, C11023, C11024, C11027, C11028, C11031, C11032, C11035, C11036, C11039, C11047: 4.7uF; C_0603_1608Metric
C245, C11002, C11005, C11007, C11008, C11011, C11012, C11017, C11018, C11021, C11022, C11025, C11026, C11029, C11030, C11033, C11034, C11037, C11038, C11042, C11043, C11046, C11049, C11050, C11051: 0.1uF; C_0402_1005Metric
FB11001, FB11002: 300R; R_0402_1005Metric
JP201, JP202: SolderJumper_3_Bridged12; SolderJumper-3_bridged12
R11001, R11002, R11003, R11004, R11005, R11006, R11007, R11008, R11009, R11010: 10K; R_0402_1005Metric
U202: MIC5504-2.5YM5; SOT-23-5
U11001: 10CL010YE144C8G; EQFP-144-1EP_20x20mm_P0.5mm_EP6.7x6.7mm
U11004: S25FL128L; SOIC-8_5.275x5.275mm_P1.27mm

Connections:
+1V2: C11007.1, C11010.1, C11011.1, C11014.1, C11016.1, C11017.1, C11020.1, C11021.1, C11024.1, C11025.1, C11028.1, C11029.1, C11032.1, C11033.1, C11036.1, C11037.1, FB11001.1, FB11002.1, U11001.5 (Vccint), U11001.29 (Vccint), U11001.45 (Vccint), U11001.61 (Vccint), U11001.78 (Vccint), U11001.102 (Vccint), U11001.116 (Vccint), U11001.134 (Vccint); also elsewhere on the board
+3V0: C203.1, C241.1, C245.1, C11008.1, C11009.1, C11012.1, C11013.1, C11015.1, C11018.1, C11019.1, C11022.1, C11023.1, C11026.1, C11027.1, C11030.1, C11031.1, C11034.1, C11035.1, C11038.1, C11042.1, C11046.1, C11049.1, C11051.1, R11001.2, R11002.2, R11007.2, U202.1 (Vin), U202.3 (en), U11001.17 (Vccio1), U11001.26 (Vccio2), U11001.40 (Vccio3), U11001.47 (Vccio3), U11001.56 (Vccio4), U11001.62 (Vccio4), U11001.81 (Vccio5), U11001.93 (Vccio6), U11001.117 (Vccio7), U11001.122 (Vccio7), U11001.130 (Vccio8), U11001.139 (Vccio8), U11004.8 (Vcc); also elsewhere on the board
/FPGA1/conf_done: R11007.1, U11001.92 (conf_done); also elsewhere on the board
/FPGA1/miso: U11001.28 (io); also elsewhere on the board
/FPGA1/nStatus: R11001.1, U11001.9 (nStatus); also elsewhere on the board
/FPGA2/CLK24_576: U11001.22 (clk0); also elsewhere on the board
/FPGA2/blue: R11008.2, U11001.142 (io); also elsewhere on the board
/FPGA2/f_io0: U11001.43 (io/pll1_clkoutp), U11004.5 (SI/IO0)
/FPGA2/f_io1: U11001.50 (io), U11004.2 (SO/IO1)
/FPGA2/f_io2: U11001.51 (io), U11004.3 (WP#/IO2)
/FPGA2/f_io3: U11001.46 (io/vrefb3n0), U11004.7 (IO3/nRst)
/FPGA2/f_ncs: U11001.49 (io), U11004.1 (CS#)
/FPGA2/f_sck: U11001.44 (io/pll1_clkoutn), U11004.6 (SCK)
/FPGA2/green: R11009.2, U11001.143 (io); also elsewhere on the board
/FPGA2/left: R11004.2, U11001.2 (i/o)
/FPGA2/misc0: R11005.2, U11001.3 (i/o)
/FPGA2/misc1: R11006.2, U11001.141 (io)
/FPGA2/red: R11010.2, U11001.144 (io); also elsewhere on the board
/FPGA2/syncOut: U11001.31 (io)
/FPGA2/t0: U11001.52 (io); also elsewhere on the board
/FPGA2/t1: U11001.53 (io); also elsewhere on the board
/FPGA2/t2: U11001.54 (io); also elsewhere on the board
/FPGA2/t3: U11001.55 (io); also elsewhere on the board
/FPGA2/t4: U11001.58 (io); also elsewhere on the board
/FPGA2/t5: U11001.59 (io); also elsewhere on the board
/FPGA2/t6: U11001.60 (io); also elsewhere on the board
/FPGA2/t7: U11001.65 (io/vrefb4n0); also elsewhere on the board
/FPGA2/t8: U11001.66 (io/rup2); also elsewhere on the board
/FPGA2/t9: U11001.67 (io/rdn2); also elsewhere on the board
/FPGA2/t10: U11001.68 (io); also elsewhere on the board
/FPGA2/t11: U11001.69 (io); also elsewhere on the board
/FPGA2/t12: U11001.70 (io); also elsewhere on the board
/FPGA2/t13: U11001.71 (io); also elsewhere on the board
/FPGA2/t14: U11001.72 (io); also elsewhere on the board
/FPGA2/t15: U11001.73 (io); also elsewhere on the board
/FPGA2/t16: U11001.74 (io); also elsewhere on the board
/FPGA2/t17: U11001.75 (io); also elsewhere on the board
/FPGA2/t18: U11001.76 (io/rup3); also elsewhere on the board
/FPGA2/t19: U11001.77 (io/rdn3); also elsewhere on the board
/FPGA2/t20: U11001.80 (io/vrefb5n0); also elsewhere on the board
/FPGA2/t21: U11001.83 (io); also elsewhere on the board
/FPGA2/t22: U11001.84 (io); also elsewhere on the board
/FPGA2/t23: U11001.85 (io); also elsewhere on the board
/FPGA2/t24: U11001.87 (io/dev_CLRn); also elsewhere on the board
/FPGA2/t25: U11001.98 (io/init_done); also elsewhere on the board
/FPGA2/t26: U11001.99 (io/crc_error); also elsewhere on the board
/FPGA2/t27: U11001.100 (io); also elsewhere on the board
/FPGA2/t28: U11001.101 (io/nCEO); also elsewhere on the board
/FPGA2/t29: U11001.103 (io/clkusr); also elsewhere on the board
/FPGA2/t30: U11001.105 (io/vrefb6n0); also elsewhere on the board
/FPGA2/t31: U11001.106 (io); also elsewhere on the board
/FPGA2/t32: U11001.111 (io); also elsewhere on the board
/FPGA2/t33: U11001.112 (io/pll2_clkoutn); also elsewhere on the board
/FPGA2/t34: U11001.113 (io/pll2_clkoutp); also elsewhere on the board
/FPGA2/t35: U11001.114 (io/rup4); also elsewhere on the board
/FPGA2/t36: U11001.115 (io/rdn4); also elsewhere on the board
/FPGA2/t37: U11001.119 (io/vrefb7n0); also elsewhere on the board
/FPGA2/t38: U11001.120 (io); also elsewhere on the board
/FPGA2/t39: U11001.121 (io); also elsewhere on the board
/FPGA2/t40: U11001.124 (io); also elsewhere on the board
/FPGA2/t41: U11001.125 (io); also elsewhere on the board
/FPGA2/t42: U11001.126 (io); also elsewhere on the board
/FPGA2/t43: U11001.127 (io); also elsewhere on the board
/FPGA2/t44: U11001.128 (io); also elsewhere on the board
/FPGA2/t45: U11001.129 (io); also elsewhere on the board
/FPGA2/t46: U11001.132 (io/data2); also elsewhere on the board
/FPGA2/t47: U11001.133 (io/data3); also elsewhere on the board
/FPGA2/t48: U11001.135 (io); also elsewhere on the board
/FPGA2/t49: U11001.136 (io/vrefb8n0); also elsewhere on the board
/FPGA2/tdi: U11001.15 (tdi); also elsewhere on the board
/FPGA2/top: R11003.2, U11001.1 (i/o)
/as_asdo_2: U11001.6 (io/data1/asdo); also elsewhere on the board
/as_data0_2: U11001.13 (io/data0); also elsewhere on the board
/as_dclk_2: U11001.12 (io/dclk); also elsewhere on the board
/as_ncs_2: U11001.8 (io/flash_nCE/nCSO); also elsewhere on the board
/miso: U11001.32 (io/rup1); also elsewhere on the board
/nConfig: R11002.1, U11001.14 (nConfig); also elsewhere on the board
/ncs: U11001.25 (clk3); also elsewhere on the board
/sck: U11001.24 (clk2); also elsewhere on the board
/syncIn: U11001.23 (clk1); also elsewhere on the board
/tck: U11001.16 (tck); also elsewhere on the board
/tdo: U11001.20 (tdo); also elsewhere on the board
/tms: U11001.18 (tms); also elsewhere on the board
GND: C203.2, C204.2, C241.2, C245.2, C11001.2, C11002.2, C11005.2, C11006.2, C11007.2, C11008.2, C11009.2, C11010.2, C11011.2, C11012.2, C11013.2, C11014.2, C11015.2, C11016.2, C11017.2, C11018.2, C11019.2, C11020.2, C11021.2, C11022.2, C11023.2, C11024.2, C11025.2, C11026.2, C11027.2, C11028.2, C11029.2, C11030.2, C11031.2, C11032.2, C11033.2, C11034.2, C11035.2, C11036.2, C11037.2, C11038.2, C11039.2, C11042.2, C11043.2, C11046.2, C11047.2, C11049.2, C11050.2, C11051.2, JP201.3 (B), JP202.3 (B), R11003.1, R11004.1, R11005.1, R11006.1, R11008.1, R11009.1, R11010.1, U202.2 (gnd), U11001.4 (gnd), U11001.19 (gnd), U11001.21 (nCE), U11001.27 (gnd), U11001.30 (gnd), U11001.36 (gnda1), U11001.41 (gnd), U11001.48 (gnd), U11001.57 (gnd), U11001.63 (gnd), U11001.64 (gnd), U11001.79 (gnd), U11001.82 (gnd), U11001.95 (gnd), U11001.97 (msel2), U11001.104 (gnd), U11001.108 (gnda2), U11001.110 (gnd), U11001.118 (gnd), U11001.123 (gnd), U11001.131 (gnd), U11001.140 (gnd), U11001.145 (pad), U11004.4 (Vss); also elsewhere on the board
unnamed: C11001.1, C11002.1, FB11001.2, U11001.37 (Vccd_pll1)
unnamed: C11005.1, C11006.1, FB11002.2, U11001.109 (Vccd_pll2)

Parts of its further copies:
C201, C206, C209, C210, C213, C214, C215, C216, C219, C220, C223, C224, C227, C228, C231, C232, C235, C236, C239, C247, C11003, C11004, C11041: 4.7uF; C_0603_1608Metric
C202, C205, C207, C208, C211, C212, C217, C218, C221, C222, C225, C226, C229, C230, C233, C234, C237, C238, C242, C243, C246, C249, C250, C251, C11045: 0.1uF; C_0402_1005Metric
FB201, FB202: 300R; R_0402_1005Metric
JP11001, JP11002: SolderJumper_3_Bridged12; SolderJumper-3_bridged12
R201, R202, R203, R204, R205, R206, R207, R208, R209, R210: 10K; R_0402_1005Metric
U201: 10CL010YE144C8G; EQFP-144-1EP_20x20mm_P0.5mm_EP6.7x6.7mm
U204: S25FL128L; SOIC-8_5.275x5.275mm_P1.27mm
U11002: MIC5504-2.5YM5; SOT-23-5

Connections of its further copies:
+1V2: C207.1, C210.1, C211.1, C214.1, C216.1, C217.1, C220.1, C221.1, C224.1, C225.1, C228.1, C229.1, C232.1, C233.1, C236.1, C237.1, FB201.1, FB202.1, U201.5 (Vccint), U201.29 (Vccint), U201.45 (Vccint), U201.61 (Vccint), U201.78 (Vccint), U201.102 (Vccint), U201.116 (Vccint), U201.134 (Vccint); also elsewhere on the board
+3V0: C208.1, C209.1, C212.1, C213.1, C215.1, C218.1, C219.1, C222.1, C223.1, C226.1, C227.1, C230.1, C231.1, C234.1, C235.1, C238.1, C242.1, C246.1, C249.1, C251.1, C11003.1, C11041.1, C11045.1, R201.2, R202.2, R207.2, U201.17 (Vccio1), U201.26 (Vccio2), U201.40 (Vccio3), U201.47 (Vccio3), U201.56 (Vccio4), U201.62 (Vccio4), U201.81 (Vccio5), U201.93 (Vccio6), U201.117 (Vccio7), U201.122 (Vccio7), U201.130 (Vccio8), U201.139 (Vccio8), U204.8 (Vcc), U11002.1 (Vin), U11002.3 (en); also elsewhere on the board
/FPGA1/CLK24_576: U201.22 (clk0); also elsewhere on the board
/FPGA1/blue: R208.2, U201.142 (io); also elsewhere on the board
/FPGA1/conf_done: R207.1, U201.92 (conf_done); also elsewhere on the board
/FPGA1/f_io0: U201.43 (io/pll1_clkoutp), U204.5 (SI/IO0)
/FPGA1/f_io1: U201.50 (io), U204.2 (SO/IO1)
/FPGA1/f_io2: U201.51 (io), U204.3 (WP#/IO2)
/FPGA1/f_io3: U201.46 (io/vrefb3n0), U204.7 (IO3/nRst)
/FPGA1/f_ncs: U201.49 (io), U204.1 (CS#)
/FPGA1/f_sck: U201.44 (io/pll1_clkoutn), U204.6 (SCK)
/FPGA1/green: R209.2, U201.143 (io); also elsewhere on the board
/FPGA1/left: R204.2, U201.2 (i/o)
/FPGA1/misc0: R205.2, U201.3 (i/o)
/FPGA1/misc1: R206.2, U201.141 (io)
/FPGA1/miso: U201.32 (io/rup1); also elsewhere on the board
/FPGA1/nStatus: R201.1, U201.9 (nStatus); also elsewhere on the board
/FPGA1/red: R210.2, U201.144 (io); also elsewhere on the board
/FPGA1/top: R203.2, U201.1 (i/o)
/FPGA2/tdi: U201.20 (tdo); also elsewhere on the board
/Transducers/s0: U201.52 (io); also elsewhere on the board
/Transducers/s1: U201.53 (io); also elsewhere on the board
/Transducers/s2: U201.54 (io); also elsewhere on the board
/Transducers/s3: U201.55 (io); also elsewhere on the board
/Transducers/s4: U201.58 (io); also elsewhere on the board
/Transducers/s5: U201.59 (io); also elsewhere on the board
/Transducers/s6: U201.60 (io); also elsewhere on the board
/Transducers/s7: U201.65 (io/vrefb4n0); also elsewhere on the board
/Transducers/s8: U201.66 (io/rup2); also elsewhere on the board
/Transducers/s9: U201.67 (io/rdn2); also elsewhere on the board
/Transducers/s10: U201.68 (io); also elsewhere on the board
/Transducers/s11: U201.69 (io); also elsewhere on the board
/Transducers/s12: U201.70 (io); also elsewhere on the board
/Transducers/s13: U201.71 (io); also elsewhere on the board
/Transducers/s14: U201.72 (io); also elsewhere on the board
/Transducers/s15: U201.73 (io); also elsewhere on the board
/Transducers/s16: U201.74 (io); also elsewhere on the board
/Transducers/s17: U201.75 (io); also elsewhere on the board
/Transducers/s18: U201.76 (io/rup3); also elsewhere on the board
/Transducers/s19: U201.77 (io/rdn3); also elsewhere on the board
/Transducers/s20: U201.80 (io/vrefb5n0); also elsewhere on the board
/Transducers/s21: U201.83 (io); also elsewhere on the board
/Transducers/s22: U201.84 (io); also elsewhere on the board
/Transducers/s23: U201.85 (io); also elsewhere on the board
/Transducers/s24: U201.87 (io/dev_CLRn); also elsewhere on the board
/Transducers/s25: U201.98 (io/init_done); also elsewhere on the board
/Transducers/s26: U201.99 (io/crc_error); also elsewhere on the board
/Transducers/s27: U201.100 (io); also elsewhere on the board
/Transducers/s28: U201.101 (io/nCEO); also elsewhere on the board
/Transducers/s29: U201.103 (io/clkusr); also elsewhere on the board
/Transducers/s30: U201.105 (io/vrefb6n0); also elsewhere on the board
/Transducers/s31: U201.106 (io); also elsewhere on the board
/Transducers/s32: U201.111 (io); also elsewhere on the board
/Transducers/s33: U201.112 (io/pll2_clkoutn); also elsewhere on the board
/Transducers/s34: U201.113 (io/pll2_clkoutp); also elsewhere on the board
/Transducers/s35: U201.114 (io/rup4); also elsewhere on the board
/Transducers/s36: U201.115 (io/rdn4); also elsewhere on the board
/Transducers/s37: U201.119 (io/vrefb7n0); also elsewhere on the board
/Transducers/s38: U201.120 (io); also elsewhere on the board
/Transducers/s39: U201.121 (io); also elsewhere on the board
/Transducers/s40: U201.124 (io); also elsewhere on the board
/Transducers/s41: U201.125 (io); also elsewhere on the board
/Transducers/s42: U201.126 (io); also elsewhere on the board
/Transducers/s43: U201.127 (io); also elsewhere on the board
/Transducers/s44: U201.128 (io); also elsewhere on the board
/Transducers/s45: U201.129 (io); also elsewhere on the board
/Transducers/s46: U201.132 (io/data2); also elsewhere on the board
/Transducers/s47: U201.133 (io/data3); also elsewhere on the board
/Transducers/s48: U201.135 (io); also elsewhere on the board
/Transducers/s49: U201.136 (io/vrefb8n0); also elsewhere on the board
/as_asdo_1: U201.6 (io/data1/asdo); also elsewhere on the board
/as_data0_1: U201.13 (io/data0); also elsewhere on the board
/as_dclk_1: U201.12 (io/dclk); also elsewhere on the board
/as_ncs_1: U201.8 (io/flash_nCE/nCSO); also elsewhere on the board
/mosi: U201.28 (io); also elsewhere on the board
/nConfig: R202.1, U201.14 (nConfig); also elsewhere on the board
/ncs: U201.25 (clk3); also elsewhere on the board
/sck: U201.24 (clk2); also elsewhere on the board
/syncIn: U201.23 (clk1); also elsewhere on the board
/syncOut: U201.31 (io); also elsewhere on the board
/tck: U201.16 (tck); also elsewhere on the board
/tdi: U201.15 (tdi); also elsewhere on the board
/tms: U201.18 (tms); also elsewhere on the board
GND: C201.2, C202.2, C205.2, C206.2, C207.2, C208.2, C209.2, C210.2, C211.2, C212.2, C213.2, C214.2, C215.2, C216.2, C217.2, C218.2, C219.2, C220.2, C221.2, C222.2, C223.2, C224.2, C225.2, C226.2, C227.2, C228.2, C229.2, C230.2, C231.2, C232.2, C233.2, C234.2, C235.2, C236.2, C237.2, C238.2, C239.2, C242.2, C243.2, C246.2, C247.2, C249.2, C250.2, C251.2, C11003.2, C11004.2, C11041.2, C11045.2, JP11001.3 (B), JP11002.3 (B), R203.1, R204.1, R205.1, R206.1, R208.1, R209.1, R210.1, U201.4 (gnd), U201.19 (gnd), U201.21 (nCE), U201.27 (gnd), U201.30 (gnd), U201.36 (gnda1), U201.41 (gnd), U201.48 (gnd), U201.57 (gnd), U201.63 (gnd), U201.64 (gnd), U201.79 (gnd), U201.82 (gnd), U201.95 (gnd), U201.97 (msel2), U201.104 (gnd), U201.108 (gnda2), U201.110 (gnd), U201.118 (gnd), U201.123 (gnd), U201.131 (gnd), U201.140 (gnd), U201.145 (pad), U204.4 (Vss), U11002.2 (gnd); also elsewhere on the board
unnamed: C201.1, C202.1, FB201.2, U201.37 (Vccd_pll1)
unnamed: C205.1, C206.1, FB202.2, U201.109 (Vccd_pll2)

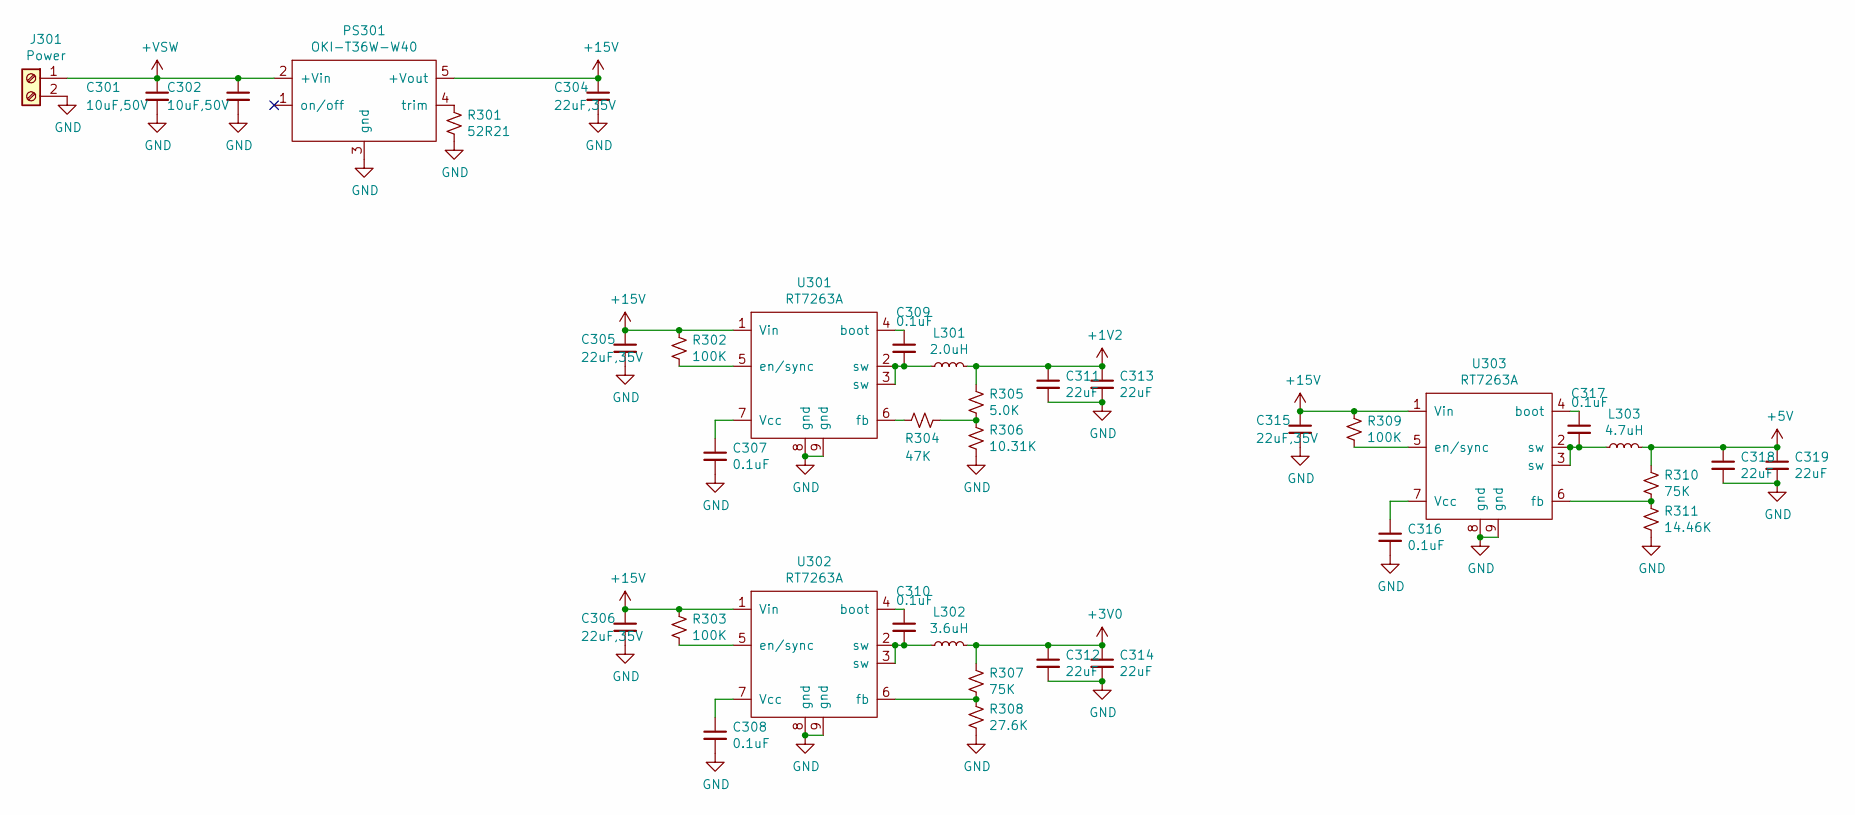
[picture p213: schematic Power.kicad_sch]

Parts:
C301, C302: 10uF,50V; R_1210_3225Metric
C304, C305, C306, C315: 22uF,35V; C_1210_3225Metric
C307, C308, C309, C310, C316, C317: 0.1uF; C_0402_1005Metric
C311, C312, C313, C314, C318, C319: 22uF; C_1210_3225Metric
J301: Power; Molex_70555_RA_1x02_P2.54
L301: 2.0uH; NR8040
L302: 3.6uH; NR8040
L303: 4.7uH; NR8040
PS301: OKI-T36W-W40; OKI-T-36W-W40
R301: 52R21; R_0603_1608Metric
R302, R303, R309: 100K; R_0402_1005Metric
R304: 47K; R_0402_1005Metric
R305: 5.0K; R_0402_1005Metric
R306: 10.31K; R_0402_1005Metric
R307, R310: 75K; R_0402_1005Metric
R308: 27.6K; R_0402_1005Metric
R311: 14.46K; R_0402_1005Metric
U301, U302, U303: RT7263A; SOP-EP-8_3.9x4.9mm_P1.27mm

Connections:
+1V2: C311.1, C313.1, L301.2, R305.1; also elsewhere on the board
+3V0: C312.1, C314.1, L302.2, R307.1; also elsewhere on the board
+5V: C318.1, C319.1, L303.2, R310.1; also elsewhere on the board
+15V: C304.1, C305.1, C306.1, C315.1, PS301.5 (+Vout), R302.1, R303.1, R309.1, U301.1 (Vin), U302.1 (Vin), U303.1 (Vin); also elsewhere on the board
+VSW: C301.1, C302.1, J301.1, PS301.2 (+Vin); also elsewhere on the board
GND: C301.2, C302.2, C304.2, C305.2, C306.2, C307.2, C308.2, C311.2, C312.2, C313.2, C314.2, C315.2, C316.2, C318.2, C319.2, J301.2, PS301.3 (gnd), R301.2, R306.2, R308.2, R311.2, U301.8 (gnd), U301.9 (gnd), U302.8 (gnd), U302.9 (gnd), U303.8 (gnd), U303.9 (gnd); also elsewhere on the board
unnamed: C307.1, U301.7 (Vcc)
unnamed: C308.1, U302.7 (Vcc)
unnamed: C309.1, U301.4 (boot)
unnamed: C309.2, L301.1, U301.2 (sw), U301.3 (sw)
unnamed: C310.1, U302.4 (boot)
unnamed: C310.2, L302.1, U302.2 (sw), U302.3 (sw)
unnamed: C316.1, U303.7 (Vcc)
unnamed: C317.1, U303.4 (boot)
unnamed: C317.2, L303.1, U303.2 (sw), U303.3 (sw)
unnamed: PS301.4 (trim), R301.1
unnamed: R302.2, U301.5 (en/sync)
unnamed: R303.2, U302.5 (en/sync)
unnamed: R304.1, R305.2, R306.1
unnamed: R304.2, U301.6 (fb)
unnamed: R307.2, R308.1, U302.6 (fb)
unnamed: R309.2, U303.5 (en/sync)
unnamed: R310.2, R311.1, U303.6 (fb)

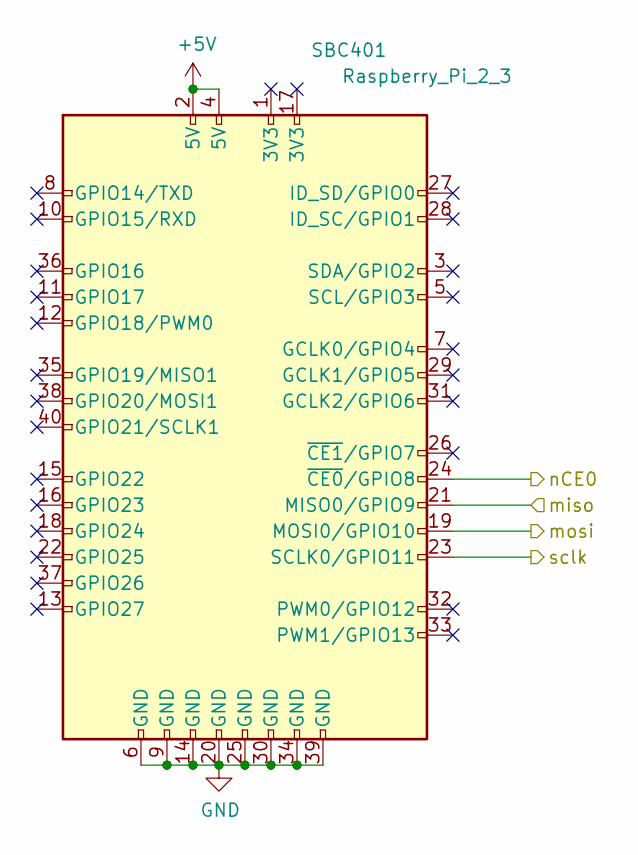
[picture p214: schematic raspberrypi.kicad_sch]

Parts:
SBC401: Raspberry_Pi_2_3; Raspberry_Pi_Zero_Socketed_THT_MountingHoles_SMT

Connections:
+5V: SBC401.2 (5V), SBC401.4 (5V); also elsewhere on the board
/Raspberry PI/mosi: SBC401.19 (MOSI0/GPIO10); also elsewhere on the board
/Raspberry PI/nCE0: SBC401.24 (~CE0/GPIO8); also elsewhere on the board
/Raspberry PI/sclk: SBC401.23 (SCLK0/GPIO11); also elsewhere on the board
/miso: SBC401.21 (MISO0/GPIO9); also elsewhere on the board
GND: SBC401.6 (GND), SBC401.9 (GND), SBC401.14 (GND), SBC401.20 (GND), SBC401.25 (GND), SBC401.30 (GND), SBC401.34 (GND), SBC401.39 (GND); also elsewhere on the board

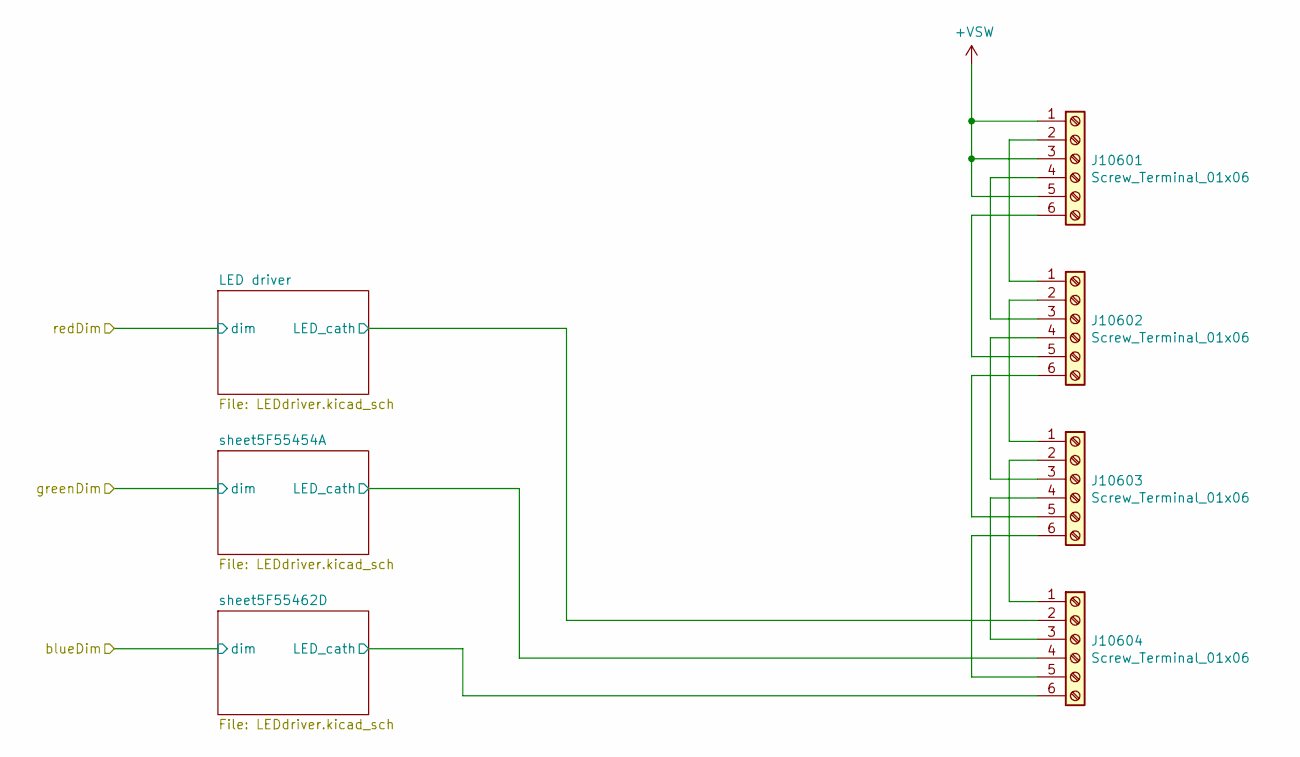
[picture p215: schematic LED.kicad_sch]

Parts:
J10601, J10602, J10603, J10604: Screw_Terminal_01x06; Hirose_DF13-06P-1.25DS_1x06_P1.25mm_Horizontal

Connections:
+VSW: J10601.1, J10601.3, J10601.5; also elsewhere on the board
/LED/LED driver/LED_cath: J10604.2; also elsewhere on the board
/LED/sheet5F55454A/LED_cath: J10604.4; also elsewhere on the board
/LED/sheet5F55462D/LED_cath: J10604.6; also elsewhere on the board
unnamed: J10601.2, J10602.1
unnamed: J10601.4, J10602.3
unnamed: J10601.6, J10602.5
unnamed: J10602.2, J10603.1
unnamed: J10602.4, J10603.3
unnamed: J10602.6, J10603.5
unnamed: J10603.2, J10604.1
unnamed: J10603.4, J10604.3
unnamed: J10603.6, J10604.5
