ThoMint/vdatp/board/floater.kicad_pcb

## KiCad design board/floater.kicad_pcb (continued)

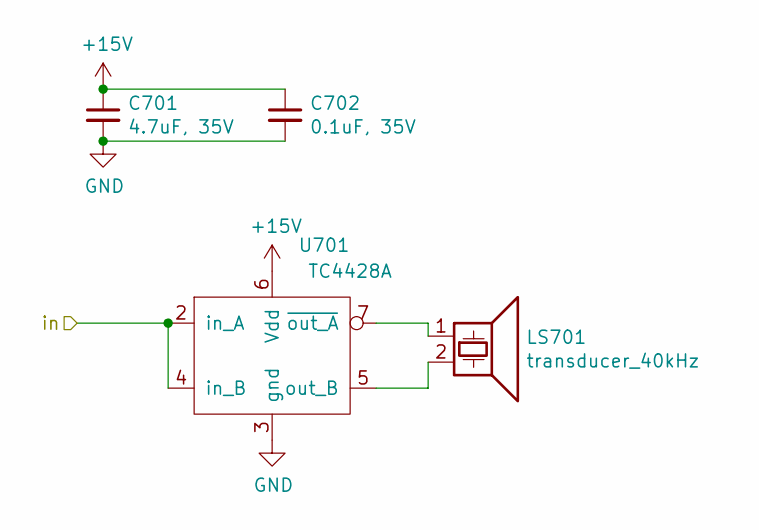
[picture p216: schematic Transducer.kicad_sch]

Parts:
C701: 4.7uF, 35V; C_1206_3216Metric
C702: 0.1uF, 35V; C_0805_2012Metric
LS701: transducer_40kHz; MSO-P1040H07T
U701: TC4428A; SO-8_3.9x4.9mm_P1.27mm

Connections:
+15V: C701.1, C702.1, U701.6 (Vdd); also elsewhere on the board
/FPGA2/t41: U701.2 (in_A), U701.4 (in_B); also elsewhere on the board
GND: C701.2, C702.2, U701.3 (gnd); also elsewhere on the board
unnamed: LS701.1, U701.7 (~out_A)
unnamed: LS701.2, U701.5 (out_B)

Parts of its further copies:
C601, C801, C901, C1001, C1101, C1201, C1301, C1401, C1501, C1601, C1701, C1801, C1901, C2001, C2101, C2201, C2301, C2401, C2501, C2601, C2701, C2801, C2901, C3001, C3101, C3201, C3301, C3401, C3501, C3601, C3701, C3801, C3901, C4001, C4101, C4201, C4301, C4401, C4501, C4601, C4701, C4801, C4901, C5001, C5101, C5201, C5301, C5401, C5501, C5601, C5701, C5801, C5901, C6001, C6101, C6201, C6301, C6401, C6501, C6601, C6701, C6801, C6901, C7001, C7101, C7201, C7301, C7401, C7501, C7601, C7701, C7801, C7901, C8001, C8101, C8201, C8301, C8401, C8501, C8601, C8701, C8801, C8901, C9001, C9101, C9201, C9301, C9401, C9501, C9601, C9701, C9801, C9901, C10001, C10101, C10201, C10301, C10401, C10501: 4.7uF, 35V; C_1206_3216Metric
C602, C802, C902, C1002, C1102, C1202, C1302, C1402, C1502, C1602, C1702, C1802, C1902, C2002, C2102, C2202, C2302, C2402, C2502, C2602, C2702, C2802, C2902, C3002, C3102, C3202, C3302, C3402, C3502, C3602, C3702, C3802, C3902, C4002, C4102, C4202, C4302, C4402, C4502, C4602, C4702, C4802, C4902, C5002, C5102, C5202, C5302, C5402, C5502, C5602, C5702, C5802, C5902, C6002, C6102, C6202, C6302, C6402, C6502, C6602, C6702, C6802, C6902, C7002, C7102, C7202, C7302, C7402, C7502, C7602, C7702, C7802, C7902, C8002, C8102, C8202, C8302, C8402, C8502, C8602, C8702, C8802, C8902, C9002, C9102, C9202, C9302, C9402, C9502, C9602, C9702, C9802, C9902, C10002, C10102, C10202, C10302, C10402, C10502: 0.1uF, 35V; C_0805_2012Metric
LS601, LS801, LS901, LS1001, LS1101, LS1201, LS1301, LS1401, LS1501, LS1601, LS1701, LS1801, LS1901, LS2001, LS2101, LS2201, LS2301, LS2401, LS2501, LS2601, LS2701, LS2801, LS2901, LS3001, LS3101, LS3201, LS3301, LS3401, LS3501, LS3601, LS3701, LS3801, LS3901, LS4001, LS4101, LS4201, LS4301, LS4401, LS4501, LS4601, LS4701, LS4801, LS4901, LS5001, LS5101, LS5201, LS5301, LS5401, LS5501, LS5601, LS5701, LS5801, LS5901, LS6001, LS6101, LS6201, LS6301, LS6401, LS6501, LS6601, LS6701, LS6801, LS6901, LS7001, LS7101, LS7201, LS7301, LS7401, LS7501, LS7601, LS7701, LS7801, LS7901, LS8001, LS8101, LS8201, LS8301, LS8401, LS8501, LS8601, LS8701, LS8801, LS8901, LS9001, LS9101, LS9201, LS9301, LS9401, LS9501, LS9601, LS9701, LS9801, LS9901, LS10001, LS10101, LS10201, LS10301, LS10401, LS10501: transducer_40kHz; MSO-P1040H07T
U601, U801, U901, U1001, U1101, U1201, U1301, U1401, U1501, U1601, U1701, U1801, U1901, U2001, U2101, U2201, U2301, U2401, U2501, U2601, U2701, U2801, U2901, U3001, U3101, U3201, U3301, U3401, U3501, U3601, U3701, U3801, U3901, U4001, U4101, U4201, U4301, U4401, U4501, U4601, U4701, U4801, U4901, U5001, U5101, U5201, U5301, U5401, U5501, U5601, U5701, U5801, U5901, U6001, U6101, U6201, U6301, U6401, U6501, U6601, U6701, U6801, U6901, U7001, U7101, U7201, U7301, U7401, U7501, U7601, U7701, U7801, U7901, U8001, U8101, U8201, U8301, U8401, U8501, U8601, U8701, U8801, U8901, U9001, U9101, U9201, U9301, U9401, U9501, U9601, U9701, U9801, U9901, U10001, U10101, U10201, U10301, U10401, U10501: TC4428A; SO-8_3.9x4.9mm_P1.27mm

Connections of its further copies:
+15V: C601.1, C602.1, C801.1, C802.1, C901.1, C902.1, C1001.1, C1002.1, C1101.1, C1102.1, C1201.1, C1202.1, C1301.1, C1302.1, C1401.1, C1402.1, C1501.1, C1502.1, C1601.1, C1602.1, C1701.1, C1702.1, C1801.1, C1802.1, C1901.1, C1902.1, C2001.1, C2002.1, C2101.1, C2102.1, C2201.1, C2202.1, C2301.1, C2302.1, C2401.1, C2402.1, C2501.1, C2502.1, C2601.1, C2602.1, C2701.1, C2702.1, C2801.1, C2802.1, C2901.1, C2902.1, C3001.1, C3002.1, C3101.1, C3102.1, C3201.1, C3202.1, C3301.1, C3302.1, C3401.1, C3402.1, C3501.1, C3502.1, C3601.1, C3602.1, C3701.1, C3702.1, C3801.1, C3802.1, C3901.1, C3902.1, C4001.1, C4002.1, C4101.1, C4102.1, C4201.1, C4202.1, C4301.1, C4302.1, C4401.1, C4402.1, C4501.1, C4502.1, C4601.1, C4602.1, C4701.1, C4702.1, C4801.1, C4802.1, C4901.1, C4902.1, C5001.1, C5002.1, C5101.1, C5102.1, C5201.1, C5202.1, C5301.1, C5302.1, C5401.1, C5402.1, C5501.1, C5502.1, C5601.1, C5602.1, C5701.1, C5702.1, C5801.1, C5802.1, C5901.1, C5902.1, C6001.1, C6002.1, C6101.1, C6102.1, C6201.1, C6202.1, C6301.1, C6302.1, C6401.1, C6402.1, C6501.1, C6502.1, C6601.1, C6602.1, C6701.1, C6702.1, C6801.1, C6802.1, C6901.1, C6902.1, C7001.1, C7002.1, C7101.1, C7102.1, C7201.1, C7202.1, C7301.1, C7302.1, C7401.1, C7402.1, C7501.1, C7502.1, C7601.1, C7602.1, C7701.1, C7702.1, C7801.1, C7802.1, C7901.1, C7902.1, C8001.1, C8002.1, C8101.1, C8102.1, C8201.1, C8202.1, C8301.1, C8302.1, C8401.1, C8402.1, C8501.1, C8502.1, C8601.1, C8602.1, C8701.1, C8702.1, C8801.1, C8802.1, C8901.1, C8902.1, C9001.1, C9002.1, C9101.1, C9102.1, C9201.1, C9202.1, C9301.1, C9302.1, C9401.1, C9402.1, C9501.1, C9502.1, C9601.1, C9602.1, C9701.1, C9702.1, C9801.1, C9802.1, C9901.1, C9902.1, C10001.1, C10002.1, C10101.1, C10102.1, C10201.1, C10202.1, C10301.1, C10302.1, C10401.1, C10402.1, C10501.1, C10502.1, U601.6 (Vdd), U801.6 (Vdd), U901.6 (Vdd), U1001.6 (Vdd), U1101.6 (Vdd), U1201.6 (Vdd), U1301.6 (Vdd), U1401.6 (Vdd), U1501.6 (Vdd), U1601.6 (Vdd), U1701.6 (Vdd), U1801.6 (Vdd), U1901.6 (Vdd), U2001.6 (Vdd), U2101.6 (Vdd), U2201.6 (Vdd), U2301.6 (Vdd), U2401.6 (Vdd), U2501.6 (Vdd), U2601.6 (Vdd), U2701.6 (Vdd), U2801.6 (Vdd), U2901.6 (Vdd), U3001.6 (Vdd), U3101.6 (Vdd), U3201.6 (Vdd), U3301.6 (Vdd), U3401.6 (Vdd), U3501.6 (Vdd), U3601.6 (Vdd), U3701.6 (Vdd), U3801.6 (Vdd), U3901.6 (Vdd), U4001.6 (Vdd), U4101.6 (Vdd), U4201.6 (Vdd), U4301.6 (Vdd), U4401.6 (Vdd), U4501.6 (Vdd), U4601.6 (Vdd), U4701.6 (Vdd), U4801.6 (Vdd), U4901.6 (Vdd), U5001.6 (Vdd), U5101.6 (Vdd), U5201.6 (Vdd), U5301.6 (Vdd), U5401.6 (Vdd), U5501.6 (Vdd), U5601.6 (Vdd), U5701.6 (Vdd), U5801.6 (Vdd), U5901.6 (Vdd), U6001.6 (Vdd), U6101.6 (Vdd), U6201.6 (Vdd), U6301.6 (Vdd), U6401.6 (Vdd), U6501.6 (Vdd), U6601.6 (Vdd), U6701.6 (Vdd), U6801.6 (Vdd), U6901.6 (Vdd), U7001.6 (Vdd), U7101.6 (Vdd), U7201.6 (Vdd), U7301.6 (Vdd), U7401.6 (Vdd), U7501.6 (Vdd), U7601.6 (Vdd), U7701.6 (Vdd), U7801.6 (Vdd), U7901.6 (Vdd), U8001.6 (Vdd), U8101.6 (Vdd), U8201.6 (Vdd), U8301.6 (Vdd), U8401.6 (Vdd), U8501.6 (Vdd), U8601.6 (Vdd), U8701.6 (Vdd), U8801.6 (Vdd), U8901.6 (Vdd), U9001.6 (Vdd), U9101.6 (Vdd), U9201.6 (Vdd), U9301.6 (Vdd), U9401.6 (Vdd), U9501.6 (Vdd), U9601.6 (Vdd), U9701.6 (Vdd), U9801.6 (Vdd), U9901.6 (Vdd), U10001.6 (Vdd), U10101.6 (Vdd), U10201.6 (Vdd), U10301.6 (Vdd), U10401.6 (Vdd), U10501.6 (Vdd); also elsewhere on the board
/FPGA2/t0: U4601.2 (in_A), U4601.4 (in_B); also elsewhere on the board
/FPGA2/t1: U4701.2 (in_A), U4701.4 (in_B); also elsewhere on the board
/FPGA2/t2: U4801.2 (in_A), U4801.4 (in_B); also elsewhere on the board
/FPGA2/t3: U4901.2 (in_A), U4901.4 (in_B); also elsewhere on the board
/FPGA2/t4: U5001.2 (in_A), U5001.4 (in_B); also elsewhere on the board
/FPGA2/t5: U5101.2 (in_A), U5101.4 (in_B); also elsewhere on the board
/FPGA2/t6: U5201.2 (in_A), U5201.4 (in_B); also elsewhere on the board
/FPGA2/t7: U5301.2 (in_A), U5301.4 (in_B); also elsewhere on the board
/FPGA2/t8: U5401.2 (in_A), U5401.4 (in_B); also elsewhere on the board
/FPGA2/t9: U5501.2 (in_A), U5501.4 (in_B); also elsewhere on the board
/FPGA2/t10: U3601.2 (in_A), U3601.4 (in_B); also elsewhere on the board
/FPGA2/t11: U3701.2 (in_A), U3701.4 (in_B); also elsewhere on the board
/FPGA2/t12: U3801.2 (in_A), U3801.4 (in_B); also elsewhere on the board
/FPGA2/t13: U3901.2 (in_A), U3901.4 (in_B); also elsewhere on the board
/FPGA2/t14: U4001.2 (in_A), U4001.4 (in_B); also elsewhere on the board
/FPGA2/t15: U4101.2 (in_A), U4101.4 (in_B); also elsewhere on the board
/FPGA2/t16: U4201.2 (in_A), U4201.4 (in_B); also elsewhere on the board
/FPGA2/t17: U4301.2 (in_A), U4301.4 (in_B); also elsewhere on the board
/FPGA2/t18: U4401.2 (in_A), U4401.4 (in_B); also elsewhere on the board
/FPGA2/t19: U4501.2 (in_A), U4501.4 (in_B); also elsewhere on the board
/FPGA2/t20: U2601.2 (in_A), U2601.4 (in_B); also elsewhere on the board
/FPGA2/t21: U2701.2 (in_A), U2701.4 (in_B); also elsewhere on the board
/FPGA2/t22: U2801.2 (in_A), U2801.4 (in_B); also elsewhere on the board
/FPGA2/t23: U2901.2 (in_A), U2901.4 (in_B); also elsewhere on the board
/FPGA2/t24: U3001.2 (in_A), U3001.4 (in_B); also elsewhere on the board
/FPGA2/t25: U3101.2 (in_A), U3101.4 (in_B); also elsewhere on the board
/FPGA2/t26: U3201.2 (in_A), U3201.4 (in_B); also elsewhere on the board
/FPGA2/t27: U3301.2 (in_A), U3301.4 (in_B); also elsewhere on the board
/FPGA2/t28: U3401.2 (in_A), U3401.4 (in_B); also elsewhere on the board
/FPGA2/t29: U3501.2 (in_A), U3501.4 (in_B); also elsewhere on the board
/FPGA2/t30: U1601.2 (in_A), U1601.4 (in_B); also elsewhere on the board
/FPGA2/t31: U1701.2 (in_A), U1701.4 (in_B); also elsewhere on the board
/FPGA2/t32: U1801.2 (in_A), U1801.4 (in_B); also elsewhere on the board
/FPGA2/t33: U1901.2 (in_A), U1901.4 (in_B); also elsewhere on the board
/FPGA2/t34: U2001.2 (in_A), U2001.4 (in_B); also elsewhere on the board
/FPGA2/t35: U2101.2 (in_A), U2101.4 (in_B); also elsewhere on the board
/FPGA2/t36: U2201.2 (in_A), U2201.4 (in_B); also elsewhere on the board
/FPGA2/t37: U2301.2 (in_A), U2301.4 (in_B); also elsewhere on the board
/FPGA2/t38: U2401.2 (in_A), U2401.4 (in_B); also elsewhere on the board
/FPGA2/t39: U2501.2 (in_A), U2501.4 (in_B); also elsewhere on the board
/FPGA2/t40: U601.2 (in_A), U601.4 (in_B); also elsewhere on the board
/FPGA2/t42: U801.2 (in_A), U801.4 (in_B); also elsewhere on the board
/FPGA2/t43: U901.2 (in_A), U901.4 (in_B); also elsewhere on the board
/FPGA2/t44: U1001.2 (in_A), U1001.4 (in_B); also elsewhere on the board
/FPGA2/t45: U1101.2 (in_A), U1101.4 (in_B); also elsewhere on the board
/FPGA2/t46: U1201.2 (in_A), U1201.4 (in_B); also elsewhere on the board
/FPGA2/t47: U1301.2 (in_A), U1301.4 (in_B); also elsewhere on the board
/FPGA2/t48: U1401.2 (in_A), U1401.4 (in_B); also elsewhere on the board
/FPGA2/t49: U1501.2 (in_A), U1501.4 (in_B); also elsewhere on the board
/Transducers/s0: U9601.2 (in_A), U9601.4 (in_B); also elsewhere on the board
/Transducers/s1: U9701.2 (in_A), U9701.4 (in_B); also elsewhere on the board
/Transducers/s2: U9801.2 (in_A), U9801.4 (in_B); also elsewhere on the board
/Transducers/s3: U9901.2 (in_A), U9901.4 (in_B); also elsewhere on the board
/Transducers/s4: U10001.2 (in_A), U10001.4 (in_B); also elsewhere on the board
/Transducers/s5: U10101.2 (in_A), U10101.4 (in_B); also elsewhere on the board
/Transducers/s6: U10201.2 (in_A), U10201.4 (in_B); also elsewhere on the board
/Transducers/s7: U10301.2 (in_A), U10301.4 (in_B); also elsewhere on the board
/Transducers/s8: U10401.2 (in_A), U10401.4 (in_B); also elsewhere on the board
/Transducers/s9: U10501.2 (in_A), U10501.4 (in_B); also elsewhere on the board
/Transducers/s10: U8601.2 (in_A), U8601.4 (in_B); also elsewhere on the board
/Transducers/s11: U8701.2 (in_A), U8701.4 (in_B); also elsewhere on the board
/Transducers/s12: U8801.2 (in_A), U8801.4 (in_B); also elsewhere on the board
/Transducers/s13: U8901.2 (in_A), U8901.4 (in_B); also elsewhere on the board
/Transducers/s14: U9001.2 (in_A), U9001.4 (in_B); also elsewhere on the board
/Transducers/s15: U9101.2 (in_A), U9101.4 (in_B); also elsewhere on the board
/Transducers/s16: U9201.2 (in_A), U9201.4 (in_B); also elsewhere on the board
/Transducers/s17: U9301.2 (in_A), U9301.4 (in_B); also elsewhere on the board
/Transducers/s18: U9401.2 (in_A), U9401.4 (in_B); also elsewhere on the board
/Transducers/s19: U9501.2 (in_A), U9501.4 (in_B); also elsewhere on the board
/Transducers/s20: U7601.2 (in_A), U7601.4 (in_B); also elsewhere on the board
/Transducers/s21: U7701.2 (in_A), U7701.4 (in_B); also elsewhere on the board
/Transducers/s22: U7801.2 (in_A), U7801.4 (in_B); also elsewhere on the board
/Transducers/s23: U7901.2 (in_A), U7901.4 (in_B); also elsewhere on the board
/Transducers/s24: U8001.2 (in_A), U8001.4 (in_B); also elsewhere on the board
/Transducers/s25: U8101.2 (in_A), U8101.4 (in_B); also elsewhere on the board
/Transducers/s26: U8201.2 (in_A), U8201.4 (in_B); also elsewhere on the board
/Transducers/s27: U8301.2 (in_A), U8301.4 (in_B); also elsewhere on the board
/Transducers/s28: U8401.2 (in_A), U8401.4 (in_B); also elsewhere on the board
/Transducers/s29: U8501.2 (in_A), U8501.4 (in_B); also elsewhere on the board
/Transducers/s30: U6601.2 (in_A), U6601.4 (in_B); also elsewhere on the board
/Transducers/s31: U6701.2 (in_A), U6701.4 (in_B); also elsewhere on the board
/Transducers/s32: U6801.2 (in_A), U6801.4 (in_B); also elsewhere on the board
/Transducers/s33: U6901.2 (in_A), U6901.4 (in_B); also elsewhere on the board
/Transducers/s34: U7001.2 (in_A), U7001.4 (in_B); also elsewhere on the board
/Transducers/s35: U7101.2 (in_A), U7101.4 (in_B); also elsewhere on the board
/Transducers/s36: U7201.2 (in_A), U7201.4 (in_B); also elsewhere on the board
/Transducers/s37: U7301.2 (in_A), U7301.4 (in_B); also elsewhere on the board
/Transducers/s38: U7401.2 (in_A), U7401.4 (in_B); also elsewhere on the board
/Transducers/s39: U7501.2 (in_A), U7501.4 (in_B); also elsewhere on the board
/Transducers/s40: U5601.2 (in_A), U5601.4 (in_B); also elsewhere on the board
/Transducers/s41: U5701.2 (in_A), U5701.4 (in_B); also elsewhere on the board
/Transducers/s42: U5801.2 (in_A), U5801.4 (in_B); also elsewhere on the board
/Transducers/s43: U5901.2 (in_A), U5901.4 (in_B); also elsewhere on the board
/Transducers/s44: U6001.2 (in_A), U6001.4 (in_B); also elsewhere on the board
/Transducers/s45: U6101.2 (in_A), U6101.4 (in_B); also elsewhere on the board
/Transducers/s46: U6201.2 (in_A), U6201.4 (in_B); also elsewhere on the board
/Transducers/s47: U6301.2 (in_A), U6301.4 (in_B); also elsewhere on the board
/Transducers/s48: U6401.2 (in_A), U6401.4 (in_B); also elsewhere on the board
/Transducers/s49: U6501.2 (in_A), U6501.4 (in_B); also elsewhere on the board
GND: C601.2, C602.2, C801.2, C802.2, C901.2, C902.2, C1001.2, C1002.2, C1101.2, C1102.2, C1201.2, C1202.2, C1301.2, C1302.2, C1401.2, C1402.2, C1501.2, C1502.2, C1601.2, C1602.2, C1701.2, C1702.2, C1801.2, C1802.2, C1901.2, C1902.2, C2001.2, C2002.2, C2101.2, C2102.2, C2201.2, C2202.2, C2301.2, C2302.2, C2401.2, C2402.2, C2501.2, C2502.2, C2601.2, C2602.2, C2701.2, C2702.2, C2801.2, C2802.2, C2901.2, C2902.2, C3001.2, C3002.2, C3101.2, C3102.2, C3201.2, C3202.2, C3301.2, C3302.2, C3401.2, C3402.2, C3501.2, C3502.2, C3601.2, C3602.2, C3701.2, C3702.2, C3801.2, C3802.2, C3901.2, C3902.2, C4001.2, C4002.2, C4101.2, C4102.2, C4201.2, C4202.2, C4301.2, C4302.2, C4401.2, C4402.2, C4501.2, C4502.2, C4601.2, C4602.2, C4701.2, C4702.2, C4801.2, C4802.2, C4901.2, C4902.2, C5001.2, C5002.2, C5101.2, C5102.2, C5201.2, C5202.2, C5301.2, C5302.2, C5401.2, C5402.2, C5501.2, C5502.2, C5601.2, C5602.2, C5701.2, C5702.2, C5801.2, C5802.2, C5901.2, C5902.2, C6001.2, C6002.2, C6101.2, C6102.2, C6201.2, C6202.2, C6301.2, C6302.2, C6401.2, C6402.2, C6501.2, C6502.2, C6601.2, C6602.2, C6701.2, C6702.2, C6801.2, C6802.2, C6901.2, C6902.2, C7001.2, C7002.2, C7101.2, C7102.2, C7201.2, C7202.2, C7301.2, C7302.2, C7401.2, C7402.2, C7501.2, C7502.2, C7601.2, C7602.2, C7701.2, C7702.2, C7801.2, C7802.2, C7901.2, C7902.2, C8001.2, C8002.2, C8101.2, C8102.2, C8201.2, C8202.2, C8301.2, C8302.2, C8401.2, C8402.2, C8501.2, C8502.2, C8601.2, C8602.2, C8701.2, C8702.2, C8801.2, C8802.2, C8901.2, C8902.2, C9001.2, C9002.2, C9101.2, C9102.2, C9201.2, C9202.2, C9301.2, C9302.2, C9401.2, C9402.2, C9501.2, C9502.2, C9601.2, C9602.2, C9701.2, C9702.2, C9801.2, C9802.2, C9901.2, C9902.2, C10001.2, C10002.2, C10101.2, C10102.2, C10201.2, C10202.2, C10301.2, C10302.2, C10401.2, C10402.2, C10501.2, C10502.2, U601.3 (gnd), U801.3 (gnd), U901.3 (gnd), U1001.3 (gnd), U1101.3 (gnd), U1201.3 (gnd), U1301.3 (gnd), U1401.3 (gnd), U1501.3 (gnd), U1601.3 (gnd), U1701.3 (gnd), U1801.3 (gnd), U1901.3 (gnd), U2001.3 (gnd), U2101.3 (gnd), U2201.3 (gnd), U2301.3 (gnd), U2401.3 (gnd), U2501.3 (gnd), U2601.3 (gnd), U2701.3 (gnd), U2801.3 (gnd), U2901.3 (gnd), U3001.3 (gnd), U3101.3 (gnd), U3201.3 (gnd), U3301.3 (gnd), U3401.3 (gnd), U3501.3 (gnd), U3601.3 (gnd), U3701.3 (gnd), U3801.3 (gnd), U3901.3 (gnd), U4001.3 (gnd), U4101.3 (gnd), U4201.3 (gnd), U4301.3 (gnd), U4401.3 (gnd), U4501.3 (gnd), U4601.3 (gnd), U4701.3 (gnd), U4801.3 (gnd), U4901.3 (gnd), U5001.3 (gnd), U5101.3 (gnd), U5201.3 (gnd), U5301.3 (gnd), U5401.3 (gnd), U5501.3 (gnd), U5601.3 (gnd), U5701.3 (gnd), U5801.3 (gnd), U5901.3 (gnd), U6001.3 (gnd), U6101.3 (gnd), U6201.3 (gnd), U6301.3 (gnd), U6401.3 (gnd), U6501.3 (gnd), U6601.3 (gnd), U6701.3 (gnd), U6801.3 (gnd), U6901.3 (gnd), U7001.3 (gnd), U7101.3 (gnd), U7201.3 (gnd), U7301.3 (gnd), U7401.3 (gnd), U7501.3 (gnd), U7601.3 (gnd), U7701.3 (gnd), U7801.3 (gnd), U7901.3 (gnd), U8001.3 (gnd), U8101.3 (gnd), U8201.3 (gnd), U8301.3 (gnd), U8401.3 (gnd), U8501.3 (gnd), U8601.3 (gnd), U8701.3 (gnd), U8801.3 (gnd), U8901.3 (gnd), U9001.3 (gnd), U9101.3 (gnd), U9201.3 (gnd), U9301.3 (gnd), U9401.3 (gnd), U9501.3 (gnd), U9601.3 (gnd), U9701.3 (gnd), U9801.3 (gnd), U9901.3 (gnd), U10001.3 (gnd), U10101.3 (gnd), U10201.3 (gnd), U10301.3 (gnd), U10401.3 (gnd), U10501.3 (gnd); also elsewhere on the board
unnamed: LS601.1, U601.7 (~out_A)
unnamed: LS601.2, U601.5 (out_B)
unnamed: LS801.1, U801.7 (~out_A)
unnamed: LS801.2, U801.5 (out_B)
unnamed: LS901.1, U901.7 (~out_A)
unnamed: LS901.2, U901.5 (out_B)
unnamed: LS1001.1, U1001.7 (~out_A)
unnamed: LS1001.2, U1001.5 (out_B)
unnamed: LS1101.1, U1101.7 (~out_A)
unnamed: LS1101.2, U1101.5 (out_B)
unnamed: LS1201.1, U1201.7 (~out_A)
unnamed: LS1201.2, U1201.5 (out_B)
unnamed: LS1301.1, U1301.7 (~out_A)
unnamed: LS1301.2, U1301.5 (out_B)
unnamed: LS1401.1, U1401.7 (~out_A)
unnamed: LS1401.2, U1401.5 (out_B)
unnamed: LS1501.1, U1501.7 (~out_A)
unnamed: LS1501.2, U1501.5 (out_B)
unnamed: LS1601.1, U1601.7 (~out_A)
unnamed: LS1601.2, U1601.5 (out_B)
unnamed: LS1701.1, U1701.7 (~out_A)
unnamed: LS1701.2, U1701.5 (out_B)
unnamed: LS1801.1, U1801.7 (~out_A)
unnamed: LS1801.2, U1801.5 (out_B)
unnamed: LS1901.1, U1901.7 (~out_A)
unnamed: LS1901.2, U1901.5 (out_B)
unnamed: LS2001.1, U2001.7 (~out_A)
unnamed: LS2001.2, U2001.5 (out_B)
unnamed: LS2101.1, U2101.7 (~out_A)
unnamed: LS2101.2, U2101.5 (out_B)
unnamed: LS2201.1, U2201.7 (~out_A)
unnamed: LS2201.2, U2201.5 (out_B)
unnamed: LS2301.1, U2301.7 (~out_A)
unnamed: LS2301.2, U2301.5 (out_B)
unnamed: LS2401.1, U2401.7 (~out_A)
unnamed: LS2401.2, U2401.5 (out_B)
unnamed: LS2501.1, U2501.7 (~out_A)
unnamed: LS2501.2, U2501.5 (out_B)
unnamed: LS2601.1, U2601.7 (~out_A)
unnamed: LS2601.2, U2601.5 (out_B)
unnamed: LS2701.1, U2701.7 (~out_A)
unnamed: LS2701.2, U2701.5 (out_B)
unnamed: LS2801.1, U2801.7 (~out_A)
unnamed: LS2801.2, U2801.5 (out_B)
unnamed: LS2901.1, U2901.7 (~out_A)
unnamed: LS2901.2, U2901.5 (out_B)
unnamed: LS3001.1, U3001.7 (~out_A)
unnamed: LS3001.2, U3001.5 (out_B)
unnamed: LS3101.1, U3101.7 (~out_A)
unnamed: LS3101.2, U3101.5 (out_B)
unnamed: LS3201.1, U3201.7 (~out_A)
unnamed: LS3201.2, U3201.5 (out_B)
unnamed: LS3301.1, U3301.7 (~out_A)
unnamed: LS3301.2, U3301.5 (out_B)
unnamed: LS3401.1, U3401.7 (~out_A)
unnamed: LS3401.2, U3401.5 (out_B)
unnamed: LS3501.1, U3501.7 (~out_A)
unnamed: LS3501.2, U3501.5 (out_B)
unnamed: LS3601.1, U3601.7 (~out_A)
unnamed: LS3601.2, U3601.5 (out_B)
unnamed: LS3701.1, U3701.7 (~out_A)
unnamed: LS3701.2, U3701.5 (out_B)
unnamed: LS3801.1, U3801.7 (~out_A)
unnamed: LS3801.2, U3801.5 (out_B)
unnamed: LS3901.1, U3901.7 (~out_A)
unnamed: LS3901.2, U3901.5 (out_B)
unnamed: LS4001.1, U4001.7 (~out_A)
unnamed: LS4001.2, U4001.5 (out_B)
unnamed: LS4101.1, U4101.7 (~out_A)
unnamed: LS4101.2, U4101.5 (out_B)
unnamed: LS4201.1, U4201.7 (~out_A)
unnamed: LS4201.2, U4201.5 (out_B)
unnamed: LS4301.1, U4301.7 (~out_A)
unnamed: LS4301.2, U4301.5 (out_B)
unnamed: LS4401.1, U4401.7 (~out_A)
unnamed: LS4401.2, U4401.5 (out_B)
unnamed: LS4501.1, U4501.7 (~out_A)
unnamed: LS4501.2, U4501.5 (out_B)
unnamed: LS4601.1, U4601.7 (~out_A)
unnamed: LS4601.2, U4601.5 (out_B)
unnamed: LS4701.1, U4701.7 (~out_A)
unnamed: LS4701.2, U4701.5 (out_B)
unnamed: LS4801.1, U4801.7 (~out_A)
unnamed: LS4801.2, U4801.5 (out_B)
unnamed: LS4901.1, U4901.7 (~out_A)
unnamed: LS4901.2, U4901.5 (out_B)
unnamed: LS5001.1, U5001.7 (~out_A)
unnamed: LS5001.2, U5001.5 (out_B)
unnamed: LS5101.1, U5101.7 (~out_A)
unnamed: LS5101.2, U5101.5 (out_B)
unnamed: LS5201.1, U5201.7 (~out_A)
unnamed: LS5201.2, U5201.5 (out_B)
unnamed: LS5301.1, U5301.7 (~out_A)
unnamed: LS5301.2, U5301.5 (out_B)
unnamed: LS5401.1, U5401.7 (~out_A)
unnamed: LS5401.2, U5401.5 (out_B)
unnamed: LS5501.1, U5501.7 (~out_A)
unnamed: LS5501.2, U5501.5 (out_B)
unnamed: LS5601.1, U5601.7 (~out_A)
unnamed: LS5601.2, U5601.5 (out_B)
unnamed: LS5701.1, U5701.7 (~out_A)
unnamed: LS5701.2, U5701.5 (out_B)
unnamed: LS5801.1, U5801.7 (~out_A)
unnamed: LS5801.2, U5801.5 (out_B)
unnamed: LS5901.1, U5901.7 (~out_A)
unnamed: LS5901.2, U5901.5 (out_B)
unnamed: LS6001.1, U6001.7 (~out_A)
unnamed: LS6001.2, U6001.5 (out_B)
unnamed: LS6101.1, U6101.7 (~out_A)
unnamed: LS6101.2, U6101.5 (out_B)
unnamed: LS6201.1, U6201.7 (~out_A)
unnamed: LS6201.2, U6201.5 (out_B)
unnamed: LS6301.1, U6301.7 (~out_A)
unnamed: LS6301.2, U6301.5 (out_B)
unnamed: LS6401.1, U6401.7 (~out_A)
unnamed: LS6401.2, U6401.5 (out_B)
unnamed: LS6501.1, U6501.7 (~out_A)
unnamed: LS6501.2, U6501.5 (out_B)
unnamed: LS6601.1, U6601.7 (~out_A)
unnamed: LS6601.2, U6601.5 (out_B)
unnamed: LS6701.1, U6701.7 (~out_A)
unnamed: LS6701.2, U6701.5 (out_B)
unnamed: LS6801.1, U6801.7 (~out_A)
unnamed: LS6801.2, U6801.5 (out_B)
unnamed: LS6901.1, U6901.7 (~out_A)
unnamed: LS6901.2, U6901.5 (out_B)
unnamed: LS7001.1, U7001.7 (~out_A)
unnamed: LS7001.2, U7001.5 (out_B)
unnamed: LS7101.1, U7101.7 (~out_A)
unnamed: LS7101.2, U7101.5 (out_B)
unnamed: LS7201.1, U7201.7 (~out_A)
unnamed: LS7201.2, U7201.5 (out_B)
unnamed: LS7301.1, U7301.7 (~out_A)
unnamed: LS7301.2, U7301.5 (out_B)
unnamed: LS7401.1, U7401.7 (~out_A)
unnamed: LS7401.2, U7401.5 (out_B)
unnamed: LS7501.1, U7501.7 (~out_A)
unnamed: LS7501.2, U7501.5 (out_B)
unnamed: LS7601.1, U7601.7 (~out_A)
unnamed: LS7601.2, U7601.5 (out_B)
unnamed: LS7701.1, U7701.7 (~out_A)
unnamed: LS7701.2, U7701.5 (out_B)
unnamed: LS7801.1, U7801.7 (~out_A)
unnamed: LS7801.2, U7801.5 (out_B)
unnamed: LS7901.1, U7901.7 (~out_A)
unnamed: LS7901.2, U7901.5 (out_B)
unnamed: LS8001.1, U8001.7 (~out_A)
unnamed: LS8001.2, U8001.5 (out_B)
unnamed: LS8101.1, U8101.7 (~out_A)
unnamed: LS8101.2, U8101.5 (out_B)
unnamed: LS8201.1, U8201.7 (~out_A)
unnamed: LS8201.2, U8201.5 (out_B)
unnamed: LS8301.1, U8301.7 (~out_A)
unnamed: LS8301.2, U8301.5 (out_B)
unnamed: LS8401.1, U8401.7 (~out_A)
unnamed: LS8401.2, U8401.5 (out_B)
unnamed: LS8501.1, U8501.7 (~out_A)
unnamed: LS8501.2, U8501.5 (out_B)
unnamed: LS8601.1, U8601.7 (~out_A)
unnamed: LS8601.2, U8601.5 (out_B)
unnamed: LS8701.1, U8701.7 (~out_A)
unnamed: LS8701.2, U8701.5 (out_B)
unnamed: LS8801.1, U8801.7 (~out_A)
unnamed: LS8801.2, U8801.5 (out_B)
unnamed: LS8901.1, U8901.7 (~out_A)
unnamed: LS8901.2, U8901.5 (out_B)
unnamed: LS9001.1, U9001.7 (~out_A)
unnamed: LS9001.2, U9001.5 (out_B)
unnamed: LS9101.1, U9101.7 (~out_A)
unnamed: LS9101.2, U9101.5 (out_B)
unnamed: LS9201.1, U9201.7 (~out_A)
unnamed: LS9201.2, U9201.5 (out_B)
unnamed: LS9301.1, U9301.7 (~out_A)
unnamed: LS9301.2, U9301.5 (out_B)
unnamed: LS9401.1, U9401.7 (~out_A)
unnamed: LS9401.2, U9401.5 (out_B)
unnamed: LS9501.1, U9501.7 (~out_A)
unnamed: LS9501.2, U9501.5 (out_B)
unnamed: LS9601.1, U9601.7 (~out_A)
unnamed: LS9601.2, U9601.5 (out_B)
unnamed: LS9701.1, U9701.7 (~out_A)
unnamed: LS9701.2, U9701.5 (out_B)
unnamed: LS9801.1, U9801.7 (~out_A)
unnamed: LS9801.2, U9801.5 (out_B)
unnamed: LS9901.1, U9901.7 (~out_A)
unnamed: LS9901.2, U9901.5 (out_B)
unnamed: LS10001.1, U10001.7 (~out_A)
unnamed: LS10001.2, U10001.5 (out_B)
unnamed: LS10101.1, U10101.7 (~out_A)
unnamed: LS10101.2, U10101.5 (out_B)
unnamed: LS10201.1, U10201.7 (~out_A)
unnamed: LS10201.2, U10201.5 (out_B)
unnamed: LS10301.1, U10301.7 (~out_A)
unnamed: LS10301.2, U10301.5 (out_B)
unnamed: LS10401.1, U10401.7 (~out_A)
unnamed: LS10401.2, U10401.5 (out_B)
unnamed: LS10501.1, U10501.7 (~out_A)
unnamed: LS10501.2, U10501.5 (out_B)

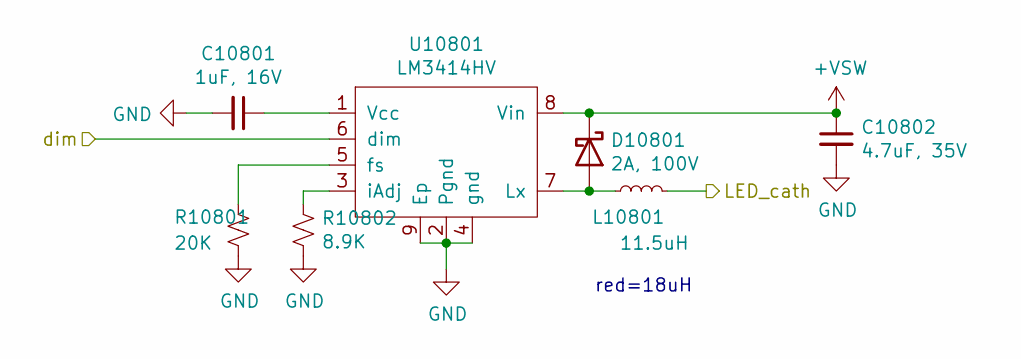
[picture p217: schematic LEDdriver.kicad_sch]

Parts:
C10801: 1uF, 16V; C_0805_2012Metric
C10802: 4.7uF, 35V; C_1206_3216Metric
D10801: 2A, 100V; DO-220A
L10801: 11.5uH; SRR6038
R10801: 20K; R_0402_1005Metric
R10802: 8.9K; R_0402_1005Metric
U10801: LM3414HV; SOIC-8-1EP_3.9x4.9mm_P1.27mm_EP2.35x2.35mm

Connections:
+VSW: C10802.1, D10801.1 (K), U10801.8 (Vin); also elsewhere on the board
/LED/sheet5F55454A/LED_cath: L10801.2; also elsewhere on the board
/greenDim: U10801.6 (dim); also elsewhere on the board
GND: C10801.2, C10802.2, R10801.1, R10802.2, U10801.2 (Pgnd), U10801.4 (gnd), U10801.9 (Ep); also elsewhere on the board
unnamed: C10801.1, U10801.1 (Vcc)
unnamed: D10801.2 (A), L10801.1, U10801.7 (Lx)
unnamed: R10801.2, U10801.5 (fs)
unnamed: R10802.1, U10801.3 (iAdj)

Parts of its further copies:
C10701, C10901: 1uF, 16V; C_0805_2012Metric
C10702, C10902: 4.7uF, 35V; C_1206_3216Metric
D10701, D10901: 2A, 100V; DO-220A
L10701, L10901: 11.5uH; SRR6038
R10701, R10901: 20K; R_0402_1005Metric
R10702, R10902: 8.9K; R_0402_1005Metric
U10701, U10901: LM3414HV; SOIC-8-1EP_3.9x4.9mm_P1.27mm_EP2.35x2.35mm

Connections of its further copies:
+VSW: C10702.1, C10902.1, D10701.1 (K), D10901.1 (K), U10701.8 (Vin), U10901.8 (Vin); also elsewhere on the board
/LED/LED driver/LED_cath: L10701.2; also elsewhere on the board
/LED/sheet5F55462D/LED_cath: L10901.2; also elsewhere on the board
/blueDim: U10901.6 (dim); also elsewhere on the board
/redDim: U10701.6 (dim); also elsewhere on the board
GND: C10701.2, C10702.2, C10901.2, C10902.2, R10701.1, R10702.2, R10901.1, R10902.2, U10701.2 (Pgnd), U10701.4 (gnd), U10701.9 (Ep), U10901.2 (Pgnd), U10901.4 (gnd), U10901.9 (Ep); also elsewhere on the board
unnamed: C10701.1, U10701.1 (Vcc)
unnamed: C10901.1, U10901.1 (Vcc)
unnamed: D10701.2 (A), L10701.1, U10701.7 (Lx)
unnamed: D10901.2 (A), L10901.1, U10901.7 (Lx)
unnamed: R10701.2, U10701.5 (fs)
unnamed: R10702.1, U10701.3 (iAdj)
unnamed: R10901.2, U10901.5 (fs)
unnamed: R10902.1, U10901.3 (iAdj)

Notes on the sheet:
red=18uH

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
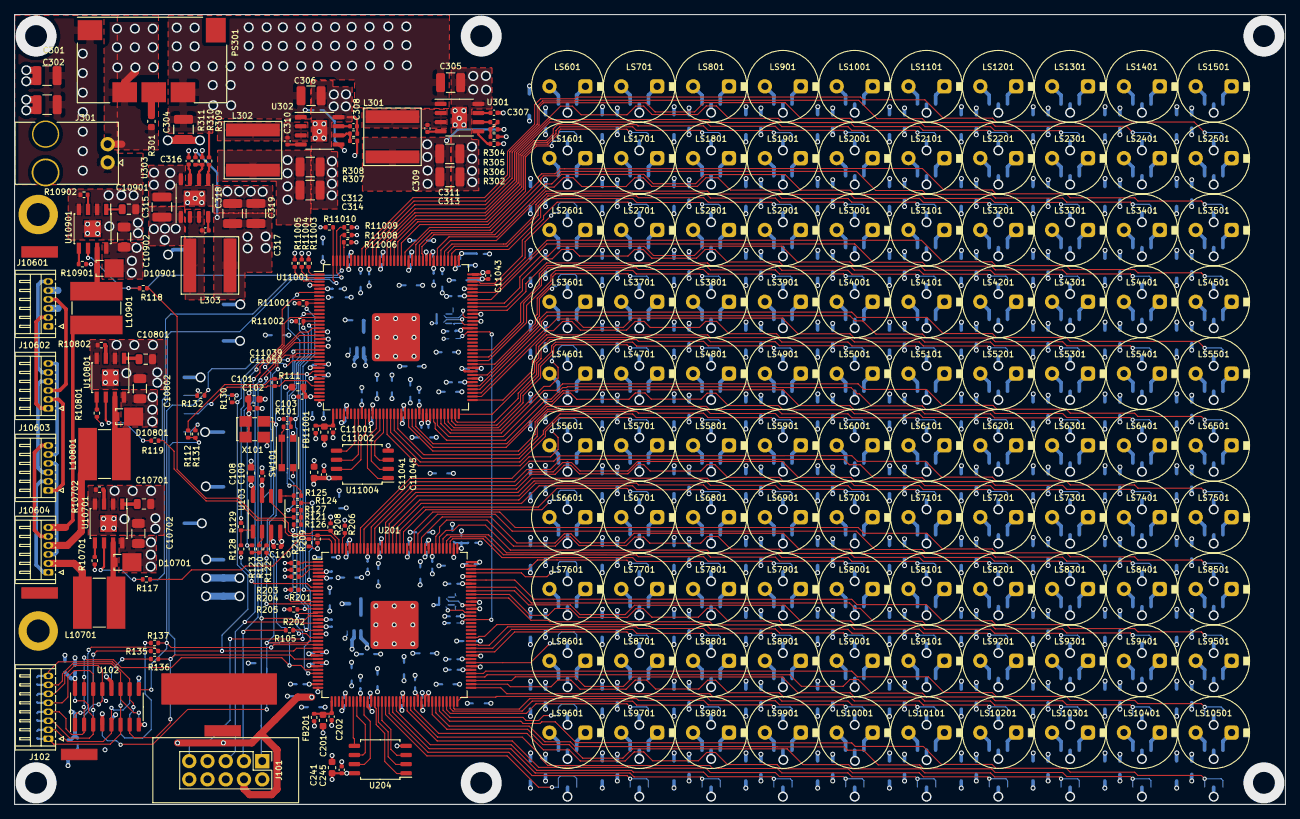
[picture p218: board floater.kicad_pcb from above]

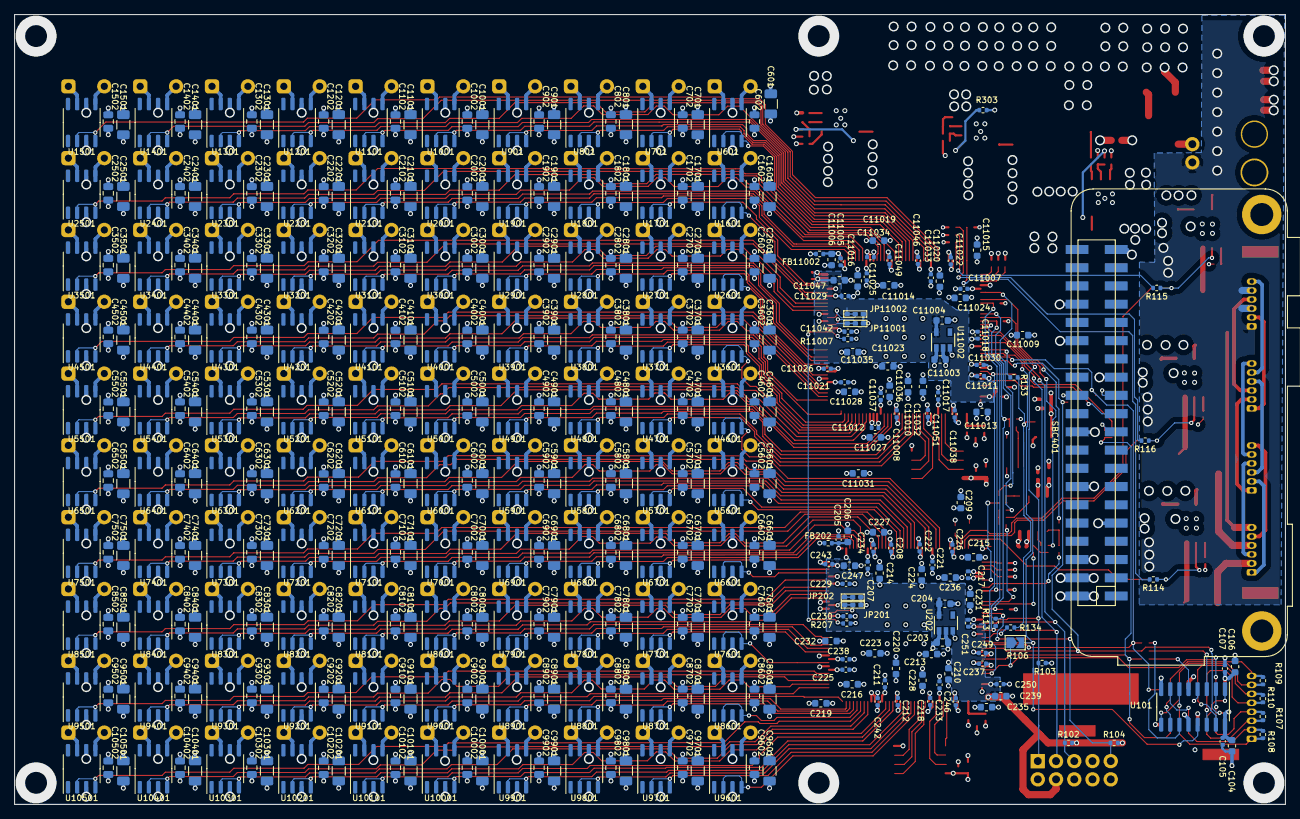
[picture p219: board floater.kicad_pcb from below]

Board: 4 copper layers, 177.0 x 110.0 mm, 647 parts (416 on the bottom side), 433 nets.
