ThoMint/vdatp/(commit log)

2021-03-27 edited schematic according to board errata
    added missing connections, jumpers and PDs
    [100-FPGA.sch, 200-memory.sch, 300-HDMI.sch, FPGA.sch, LED.sch, Transducer.sch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]
2021-03-27 fixed wiring, removed unecessary 2V5 connection
    [FPGA.sch, floater.sch]
2021-04-06 PCB 1V1
    see changelog.txt
    [FPGA.sch, LEDdriver.sch, Transducer.sch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]
2021-04-10 silk screen error fixed
    [floater.kicad_pcb]
2021-04-18 added mounting holes
    [floater.kicad_pcb]
2021-05-17 Create vdatp_bom_MTE.xlsx
    BOM mit Bestell-Links und Berücksichtigung der MTE Lagrestände
    [vdatp_bom_MTE.xlsx]
2021-06-01 generated gerbers
    [floater-B_Cu.gbl, floater-B_Fab.gbr, floater-B_Mask.gbs, floater-B_SilkS.gbo, floater-Edge_Cuts.gm1, floater-F_Cu.gtl, floater-F_Fab.gbr, floater-F_Mask.gts]
2023-10-12 KICAD 7.0
    -converted PCB project to KICAD 7.0
    -generated PCBA assembly documents (pdf)
    [FPGA.kicad_sch, LED.kicad_sch, LEDdriver.kicad_sch, Power.kicad_sch, Transducer.kicad_sch, bom_floater.csv, floater.kicad_sch, raspberrypi.kicad_sch]
2023-10-27 pictures of PCBA
    *added 2 pics from Dan
    *added pcb outline for lasercut
    [floater-Edge_Cuts.dxf, floater-Edge_Cuts_clean.dxf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]
